aquarat/cat-feeder/slicer/plates/README.md

# UNSLICED cat-feeder prototype projects

Open each .3mf as a project in Bambu Studio.
A1 mini / 0.4 mm / 0.20 mm / Generic PETG / Textured PEI.
No G-code: slice and inspect before printing. Settings are editable.
See ../../kb/printing.md for settings, quantities, limitations and validation.
plate-report.json records source hashes, measured mesh dimensions and placement.
Regenerate after STL exports change: python3 slicer/make_plates.py
