aquarat/cat-feeder/electronics/d34/d34-ctrl/pcbtrain/README.txt

Cat feeder D34 controller - d34-ctrl
Bare board only (no assembly). 2 layers, FR-4 1.6 mm, 1 oz (35 um) copper, green mask both sides,
white legend both sides, any lead-free finish (immersion silver acceptable; boards are hand-soldered).
Board outline 81 x 47 mm, 1 mm corner radii, on layer Edge_Cuts (0.1 mm line; use the centreline).
Gerber RS-274X (no X2 attributes), viewed from the top, not mirrored. Excellon drill, metric, absolute
origin: *-PTH.drl plated holes, *-NPTH.drl non-plated holes (one polarising peg hole per fan header).
Minimum track 0.30 mm (power 0.6-2.5 mm), minimum clearance 0.20 mm, vias 0.8/0.4 mm, smallest
finished hole 0.4 mm (vias), no slots, no cut-outs, no V-score.
Files:
  d34-ctrl-B_Cu.gbl
  d34-ctrl-B_Mask.gbs
  d34-ctrl-B_Silkscreen.gbo
  d34-ctrl-Edge_Cuts.gm1
  d34-ctrl-F_Cu.gtl
  d34-ctrl-F_Mask.gts
  d34-ctrl-F_Silkscreen.gto
  d34-ctrl-NPTH.drl
  d34-ctrl-PTH.drl
  d34-ctrl-job.gbrjob
