aquarat/cat-feeder/kb/decisions.md

# Decisions

Updated 2026-10-25. **Confirmed** means user direction, not engineering validation. **Exploring** means a candidate requiring comparison or trials. **Provisional** means a current implementation choice without final approval/qualification. Latest user direction overrides the initial brief.

| ID | Status | Decision and rationale | Implementation / remaining work |
|---|---|---|---|
| D01 | Confirmed | Prefer simplicity, low maintenance and easy cleaning; easier sourcing outweighs maximum thermal efficiency. | Judge component count, disassembly and cleaning effort alongside cooling performance. |
| D02 | Confirmed | Twelve rounded pizza-slice compartments, not individual cups. | Four current sectors each contain three continuous bowls; establish useful fill/headroom and cat access physically. Cup selection and cup-to-plate assumptions in the brief are superseded. |
| D03 | Confirmed | Thin removable food tray; broad lift-off keyed coupling to the stepper explicitly accepted by the user. | Current hub/socket and axial dog drive implement the concept. Review follow-up adds a drive shoulder, blind shaft-tip datum and two finger tabs; motor retention and loaded lift/torque still need physical resolution. This is direct drive, not reduction gearing. |
| D04 | Confirmed | Hinged clip lid reusing the rowing IMU mechanics. | Current geometry imports hinge knuckles, catches and clips. Full feeder lid sweep, support/stop, pin assembly and strength need feeder-specific validation. The brief's simple lift-off lid is superseded. |
| D05 | Confirmed mechanical requirement; electrical exception D22 | No screws or bolts for mechanical construction/daily servicing. | Keys should carry working loads, clips retain them. Thermal retention and motor/enclosure attachment still need actual designs; electrical screw terminals are now explicitly permitted. |
| D06 | Confirmed | No foam. Use a printed low-density air-gap insulation deck, potentially housing Peltiers. | Current 18 mm deck is solid CAD with proposed slicer shells/infill, not explicitly modelled sealed air cells. Foam inserts in the brief are superseded. |
| D07 | Confirmed | Chamfer exposed edges and round food-contact transitions for cleaning. | Current bowls have 5 mm plan corner rounding, 3 mm floor transitions and 0.5 mm mouth treatment. Cut bores, flange holes, vents and purchased edges still need an edge audit. |
| D08 | Exploring, cap interface superseded by D19 | Distributed Peltiers instead of a custom aluminium disc. | Current CAD: twelve sites, radius 105 mm, provisional 40 × 40 × 4 mm TEC envelopes directly contacting the PETG tray. The previous 41.28 mm square cold caps are removed. Module/sink variants, contact retention, wiring and useful cooling remain under investigation. |
| D09 | Provisional | Four removable three-compartment tray sectors on one central hub preserve small-printer compatibility and keep joints outside bowls. | 0.6 mm quadrant gaps; dry inner flanges and one lug per sector. Joint locations avoid normal food containment, but are not sealed against spills. No outer sector tie or captive lift retention yet. |
| D10 | Provisional, revised | Current size: body Ø316 mm with 12 mm walls, tray Ø280 mm, 1.2 mm bowl floor, 16 mm cavity depth; 0.3 mm per-side fit allowance. | Body grew outward from Ø300 mm to preserve the tray and top-loading bore while adding insulation thickness. Stiffness, flatness and fits require physical checks. |
| D11 | Retained starting requirements | One stationary feeding opening, 30° indexing, local control and physical position feedback remain useful requirements from the brief where not superseded. | No implemented feeder sensing/control is established by this mechanical model. A keyed hub alone cannot confirm individual moves or sector order. |
| D12 | Confirmed, implementation superseded | The top enclosure must retain substantial air in honeycomb insulation. | Owner clarified that honeycomb belongs in Bambu `.3mf` print settings, not explicit CAD. Modelled cells have been removed; lid, walls and insulation coupon are solid envelopes for sparse infill and closed skins. |
| D14 | Confirmed | One lid clip is sufficient. | One reused clip at front-right (315°), leaving the feeding approach unobstructed. Its angle is parameterised. |
| D15 | Confirmed, vent layout revised under D20 | Close the underside, using long rectangular vent slits; use many vertical slit vents on the cylindrical wall. | 3 mm base with 34 long 50 × 3.5 mm intake slots; 120 side slits, 3 × 22 mm at Z58–80, with eased corners. This replaces the lower 60-slot exhaust; installed airflow still needs testing. |
| D16 | Confirmed | Slope down around the feeding opening to reduce whisker contact; dome the rest of the lid. Thicken the shell for insulation. | Smooth dome/feeding-basin height field. Nominal 1.6 mm lip plus 1.2 mm tray running gap = 2.8 mm above tray rim; dome rises 12 mm above the 9.2 mm peripheral thickness. Walls are 12 mm. |
| D17 | Confirmed | All internals supported from the lower enclosure, in bounded bays, dropping in through the lid seam. | Floor-rooted cartridge/fan supports, board pockets, wire channels and motor posts; removable bridge installs after fan. Constant 292 mm bore admits the deck from above. See drop-in layout for staged order. |
| D18 | Confirmed sourcing permission; cap use superseded by D19 | Off-the-shelf cold plates are acceptable in principle; custom metal fabrication is the sourcing problem. | Permission does not require them: the later direct-contact prototype removes the small caps from the active BOM. Historical catalogue evidence remains available. |
| D19 | Confirmed; alternative D35 under comparison | Prototype direct ceramic TEC-to-PETG contact without the small metal cold plates. | Owner accepts a practical sliding-contact trial; ceramic fracture from soft PETG has not been demonstrated. Remove caps from CAD and active procurement, retain earlier simulations as historical comparisons. Model footprint/contact sensitivity separately from wear, flatness and real indexing tests. |
| D20 | Confirmed direction; airflow details provisional | One bottom PC-style axial fan blows upward into the hot-side equipment bay, with wall exhausts. | Added a 118/114 mm square inlet skirt at Z28–30, enlarged bottom intake and raised exhausts under the Z81–84 deck ledge. Trial this before individual sink ducts. Fan free-air ratings are not installed airflow; see airflow study. |
| D21 | Investigation completed; proposal provisional | Determine purchasable TEC power/control modules, operating ratings and connection topology using delegated research. | Recommend CP60440 + JT-DPS5005 for one-site bench characterization, initial 1.2 A ceiling and 0–5 V sweep. Conditional 3S4P array uses CV/current limiting; 70 W TEC output corresponds to ~86 W source under stated assumptions. This is not a final measured operating point or a fitted regulator bay. See TEC control study. |
| D22 | Confirmed — latest | Electrical screw terminals are acceptable on the proposed PCB. | This supersedes the earlier inference that regulator/controller terminals must be removed. Mechanical enclosure construction and daily tray servicing remain tool-free. |
| D23 | Confirmed workflow | Iterate a PCB design against the chosen manufacturer's component catalogue, stock and assembly capabilities. | Generate editable design/assembly inputs, record substitutions and verification. Start with a controller/carrier study; distinguish assembler-mounted parts, purchased modules and later integration work. Subsequent D25 authorizes supplier project preparation after independent review; the owner submits the quote request. |
| D24 | Confirmed preference, conditional on packaging | Prefer a crescent-shaped controller board following the wall if it improves fit. | Evaluate a shallow crescent/curved outer edge against the compact rectangular baseline; preserve fan airflow, cartridge/support clearances and top loading. This is not a full circular distribution-ring requirement. The later D25 supplier-project workflow replaces the proposed official API application. |
| D25 | Confirmed — latest | Independent PCB review must precede creation of quotable supplier components/projects. | A separate agent reviews the completed circuit, layout, footprints, catalogue choices and assembly outputs. Resolve blocking findings before preparing the supplier project. Owner will submit the quote request; preparing the order is the authorized endpoint. Keep any supplier credentials out of source control and logs. |
| D26 | Provisional geometry, checked | Seat the actual crescent PCB at Z33, rotation 0°, with two removable floor-supported sink cradles. | Replaces the devkit pocket and 0°/−30° sink posts; four small ledge notches permit top-loading. Preserves full 40 mm sink allowances. Driver stack has 1.3 mm nominal clearance; wire terminals after seating the board. Integrated meshes/loading checks pass, but bought-part heights, warm strength, RF and airflow remain physical questions. See PCB packaging. |
| D27 | Confirmed workflow | Run operating electrical simulations and build PCB tests. | Add reproducible ngspice subcircuit studies, netlist/PCB regression and fault-injection tests, and a physical bring-up record. Distinguish solver/test success from failing modeled operating corners; label generic/behavioral models and unmeasured inputs. Firmware and physical hardware tests remain unrun until those exist. |
| D28 | Confirmed — latest | Integrate the USB-C PD board and stepper motor controller onto the main PCB. | Revision B replaces the SparkFun STUSB4500 breakout and plug-in A4988 carrier with assembler-fitted circuitry. Retain 20 V/5 A USB-C input intent, 1 A/phase motor ceiling and independent review before supplier-project changes. Revision A's checks remain evidence for that revision only. |
| D29 | Confirmed — latest | Integrate the voltage regulators too, making USB-C the controller's single power input. | Use efficient on-board logic and 12 V fan supplies; address the AP2112 thermal limitation. The external DPS5005 remains the TEC regulator, supplied from a negotiated/protected DC output. PD commissioning, fallback, power budget and new layout/thermal qualification belong to revision B. |
| D30 | Confirmed — latest | Add a version identifier, preferably a short Git commit hash. | Revision B silkscreen and build records carry the hardware revision and 12-character latest design-source Git commit hash, with a dirty marker for changed design sources. Before the first commit, use a deterministic source-hash identifier. Record the full source digest separately; generated-file hashes are not fed back into their own silkscreen. |
| D31 | Confirmed — latest | Factor in JLCPCB's best practices and design/assembly rules. | Recheck official fabrication and PCBA guidance for revision B's four-layer board, USB-C receptacle, thermal lands, power paths and crescent handling. Encode applicable numerical rules, distinguish project margins from factory minima, and retain supplier-specific process questions with the assembly handoff. |
| D32 | Confirmed — latest | Power the prototype from a 24 V mains power brick (owner: "reliable and affordable"). | Supersedes USB-C PD as the prototype input; the 100 W PD contract no longer caps the TEC budget. Rev B's PD front end is paused, not deleted. The [plenum heat balance](plenum-thermal.md) estimated ~108 W (135 W stress case). The [CAD-geometry sizing](plenum-sizing.md) (2026-10-26, simulated) gives a ~72–75 W brick budget at steady state for CAD rev 2 with 4 TARK-class modules, and ~100 W of TEC power at 2.5 A pull-down: keep ≥150 W for pull-down headroom, revisit after measured trials. Three CP60440s fit neither series nor parallel on a DPS5005 from 24 V; TEC topology is open. See [2026-10-25 review](review-2026-10-25.md). |
| D33 | Confirmed — latest | All electronics stay inside the case; only the mains brick is external. | The controller needs a dry, drip-shielded bay on the hot side, away from the cold chamber and any drain path. Review found the current PCB seat beneath two cold stacks with no drip protection. |
| D34 | Confirmed — latest | Add a separate hand-soldered prototype controller variant: bare JLCPCB PCB, through-hole parts and plug-in modules, ESP32 devkit in sockets, owner soldering. Overspecify for testing. | Avoids PCBA cost and the review's assembly blockers (rotations, edge distance, reflow, extended-part fees). Leave rev A/B untouched. Planned contents: socketed DevKitC-class module (exact board to be named), StepStick driver socket (TMC2209 preferred), keyed JLC/JST-XH connectors, fuses, firmware-independent bimetal sink cutouts, spare fan/sensor/TEC-zone channels. Still check JLC fabrication rules. **2026-10-26: designed as three 81 × 47 mm vertical cards (ctrl/pwr/tec) for the plenum bays.** **2026-10-27 (source hash `c24e0a5435e3`):** sourced (RS first, D38) and revised through three simulation rounds: VMOT on the 12 V buck; TRACO bucks; discrete NPN relay and MOSFET fan drivers with polyfuses (ULN2003 removed); 74HC123-timed defrost latch; K2 hold-up capacitor; 12 V undervoltage cut-off (TL431 + BC327) so K1 always opens before K2; Schottky-clamped THERMO_OK input; C9 gate cap and an inlet snubber for a reversed brick; 2 mm +12 V copper. ERC/DRC clean against JLCPCB and PCB Train rules, 164 tests pass. Final simulation run on this hash: 187 checks, 0 blocking failures, 18 advisories each with a recorded disposition, re-run independently with identical results ([D34 simulation](d34-simulation.md); simulation, not hardware). F1 is a wiring fuse; the brick's hiccup mode is the short-circuit protection. A firmware contract (waits, watchdog kick, re-arm from boot) is part of the design. Not fabricated, soldered or powered. See [D34 controller](d34-controller.md), [sourcing](d34-sourcing.md). Open: ESD on cabled leads (not fitted, no space), relay release times and drop-out voltages, DPS5005 terminal layout, T24A060 thermostat dimensions (no datasheet). |
| D35 | Exploring | Closed-loop forced cold-air plenum beneath the tray: small fan inside the insulated cold chamber, 2–4 TECs with finned cold-side sinks, tray clear of the TECs. | Proposed after review found lateral conduction limits direct contact (repo model: warmest food 12.3 °C open / 7.8 °C covered at an ideal 0 °C face), plus tray drag and ice-lock risk. Would supersede D19 if adopted; owner may compare both in the one-wedge trial. Requires ~10–15 mm plenum, rim support, defrost and a single drain. [Plenum study](plenum-thermal.md) (simulated): −5 °C air, h≈10 W/m²K gives covered wedges 2.0 °C mean / 2.6 °C warmest with no freezing; the open serving wedge reaches 6.7 °C at steady state (passes 5 °C after ~72 min). Direct contact needs a ≤−10 °C face (68 % of food frozen) to approach the target. Chamber load ~14 W; ~3 CP60440 at ~70 W. Coupon superseded by D36. [Plenum CAD study](plenum-cad.md): 4 sites, 15 mm channel, rim rollers, drains, diagonal electronics bays; 42 clearance checks pass. [CAD-geometry sizing](plenum-sizing.md) (2026-10-26, estimates): the cold side, not the hot sinks, is the bottleneck (one 5015 blower → R_cold ≈2.2 K/W). CP60440 is infeasible at 4 sites; 4 TARK-class modules are feasible with baffled hot sinks (0.59–0.66 K/W each). **CAD rev 2 (2026-10-26)** adds drop-in hot-side baffles, more intake and vent area, 70 × 60 mm cold sinks, a ≥4.5 CFM blower moved upstream, TARK thickness and sloped pockets. 46 checks pass. As modelled: ~44–47 W TEC, covered warmest 2.3–3.1 °C, and the open serving wedge passes 5 °C after 27–52 min (estimates/simulation). **Superseded by the as-sourced run (2026-10-27, [sizing](plenum-sizing.md)):** ADV127 TECs and Alutronic sinks, ADV127 1.80–1.96 A and brick budget 93–108 W with the warmest covered food held at 4 °C, coldest ~+1.7 °C; open serving wedge passes 5 °C after 18–45 min (simulation). See D39. |
| D36 | Confirmed — latest | Skip isolated test coupons (including the one-wedge plenum coupon); test the fully finished prototype. | Owner preference, 2026-10-25. The plenum study's measurement goals (achieved h, deck conductivity, TEC COP, hot-sink resistance) transfer to instrumenting the complete prototype. Existing coupon parts remain available but are no longer the planned route. Plenum CAD proceeds as a full-assembly study. |
| D37 | Confirmed — latest | Plenum meltwater goes to drop-in evaporation basins in the hot exhaust behind each sink, with standpipe overflow through the floor. | Owner, 2026-10-26: preferred over a drip tray as a design feature, and expects little water in practice. Estimate ~10 g/day passive evaporation against ~3–15 g/day nominal frost. Basins lift out with the deck removed via ledge notches. See [plenum CAD](plenum-cad.md) gap 4. Owner also judges rolling drag a non-issue (stepper torque, PETG, rollers): record it as a prototype observation. |
| D38 | Confirmed — latest | Before any ordering, complete the D34/plenum spec and verify it by simulation: physical fit including a modelled cable harness, and electrical behaviour. Buy through-hole components from RS Components UK where possible, and bare PCBs from a UK maker if cheaper than JLCPCB. | Owner, 2026-10-26: "as well tested as possible before committing to a parts list". Replace uncertain parts rather than carry them; build tools as needed. Supersedes JLCPCB as the assumed D34 fab (JLC remains a fallback). **2026-10-27: done for the current revision** (simulation and geometry only): [D34 simulation](d34-simulation.md), [harness](harness.md) and [plenum CAD](plenum-cad.md) checks, [as-sourced thermal sizing](plenum-sizing.md); build list in [BOM](../BOM.md). No UK PCB maker undercuts JLCPCB; PCB Train is the UK option at ~£340 inc VAT. Remaining questions are physical (see D39 and the BOM). |
| D39 | Proposed — awaiting owner | Plenum build interfaces fixed for ordering (2026-10-27): Alutronic PR 614 (hot, cut 70 mm) and PR 411 (cold, cut 46 mm) sinks; 24 V enters through a Kycon KPJX-PM-4S panel socket at 247° held by a printed keeper (no screws), with a snubber soldered across it; deck pass-throughs use inline connectors so the deck lifts out without unsoldering; baffle slots are 23 mm for the harness; cards and leads unplug in place, with an 8 mm grip criterion (9 plugs by finger, 11 with an extraction tool). | The stocked UK sinks (Fischer SK 100 75 SA, TED TDEX6015) fail in simulation and no UK-stocked profile fits the envelope; the Alutronic pair passes with thin margin (ADV127 1.80–1.96 A, brick budget 93–108 W at the 4 °C food target; estimates). The 23 mm slots add ~2–2.5 W of leakage (estimate). Single sources: Alutronic (DE, quote needed), Farnell for the brick and some leads. Hot-sink thermostat T180 has soldered tabs; W01, W02, W28, W29 are hand-crimped. See [harness](harness.md), [plenum CAD](plenum-cad.md), [sizing](plenum-sizing.md). |
| D40 | Confirmed — latest | Open-source the project through a follower public repository, <https://github.com/aquarat/cat-feeder>, receiving sanitised snapshots; everything copyleft with attribution (owner, 2026-11-01). | This repository stays the working source; `scripts/public_export.py` publishes `HEAD` with no private history. The rowing hinge/clip and edge helpers are copied into `cad/lib/`. Manufacturer datasheets follow the SPICE-model pattern (`references.json`, fetch script). No LAN details, agent session links, personal notes or JLCPCB website API documentation; parts lists are fine. Agent notes are rewritten for public use. Commits use the GitHub noreply address. Licences: CERN-OHL-S-2.0 hardware, GPL-3.0-or-later software, CC-BY-SA-4.0 documentation ([LICENSE.md](../LICENSE.md)). |

## Superseded assumptions and open dependencies

**D13 — evidence-driven next step:** do not freeze the square-cap layout or
order twelve thermal stacks from nominal TEC power alone. The reduced-order
model finds warmer remote food regions even with an ideal 0°C cap. Longer
stock-size footprints improve coverage, but none establishes a reliable
all-food target. Latest D19 replaces the stock-cap trial with direct TEC contact;
compare one real wedge under an insulated lid before scaling procurement. See
the thermal model's assumptions and comparisons.

- Do not revive twelve commercial cups, a custom 300 mm aluminium spreader disc, foam insulation or a purely lift-off lid as settled requirements.
- The brief's two-TEC wiring, two large heat sinks and thermal/power estimates belong to its old architecture. Reassess against the distributed candidate; twelve CAD positions do not establish that twelve modules fit its 100 W supply budget.
- The brief's 40 mL fill, cold-food target, ambient qualification condition and 180 mm printer envelope are starting targets, not achieved results. Actual useful capacity and full assembly printability remain to be demonstrated.
- Priorities for resolving D08: real stock component dimensions/availability, independently supported dry thermal cartridges, cleanable moisture separation, then measured contact/drag and thermal results. Consult [mechanical review](mechanical-review.md) and [thermal model](thermal-model.md).
