aquarat/cat-feeder/kb/review-2026-10-25.md

# General review — 2026-10-25

**Status: independent desk review by five read-only reviewers** (rev A circuit,
rev B circuit, JLCPCB DFM/DFA, system integration, mechanical/thermal). Items
marked **[re-checked]** were independently confirmed by the coordinating
session. All other items are reviewer findings or estimates. No physical part was
built or tested.

Related: [decisions D32–D35](decisions.md), [plenum thermal study](plenum-thermal.md),
[JLCPCB rule files](../electronics/dfm/README.md), [rev A](pcb-design.md),
[rev B](../electronics/revb/README.md), [direct-contact model](direct-contact-thermal.md).

## Verdict

**Do not quote either PCB.** Rev A has assembly and fit blockers. Rev B is
incomplete and its power path needs redesign. More fundamentally, the thermal and
mechanical concept findings change what the controller must do. The owner has since chosen
a 24 V brick (D32), all electronics in the case (D33), a hand-soldered
through-hole variant (D34) and is exploring a cold-air plenum (D35).

## Concept findings

| Severity | Finding | Evidence |
| --- | --- | --- |
| Blocker | Direct contact leaves food too warm even at an ideal 0 °C face: warmest food layer 12.3 °C open, 7.8 °C covered **[re-checked]**. Reviewer re-run with 22 °C room, 32 °C bay, lid U≈2.5, 0.1 mm gap: 11–15 °C warmest. Target 2–4 °C. Cause: lateral conduction, ~47 % of each wedge over a cold face. | [direct-contact-thermal.md](direct-contact-thermal.md) table line 77 (simulated) |
| Blocker | 12 × CP60440 on 40 mm sinks may give near-zero net cooling at 20–25 °C ambient: ~0.44 W/K back-conduction each, sinks 2–3.5 K/W in shared air. | Estimate from [tec-control.md](tec-control.md) data |
| Blocker | Tray drag est. 0.16–0.40 N·m against the 17HS08-1004S's 0.16 N·m *holding* torque **[motor spec re-checked]**. Ice at the contact would lock the tray. | Estimate; [BOM](../BOM.md) |
| Major | BOM motor is 21.5 mm body / 20 mm shaft; CAD assumes 28 / 18 mm, leaving ~0.8 mm coupling engagement. | Arithmetic on CAD parameters |
| Major | No set TEC face height or lateral retention; ±0.2–0.4 mm stack variation ≈ 1.4 °C per 0.2 mm. | Estimate + repo model |
| Major | Unmodelled heat leaks ~9–25 W (sink-in-deck edges, aligned deck/tray seams at 4 positions, lid) versus 2.75 W quoted. | Estimate |
| Major | PCB sits under two cold stacks; no drip surface or drain. | CAD inspection |
| Minor | Textured PEI on contact faces; FDM cleanability; shell/lid only fit H2-class beds; `check_mesh.py` records the CAD hash at check time, not export time. | — |

Verified good: re-exported sector, hub, drive, deck_quarter and motor_bridge
STLs are bit-identical to `build/stl`.

## Rev A (prepared JLCPCB project)

| Severity | Finding | Fix |
| --- | --- | --- |
| Blocker | A4988 sockets J14/J15 are 15.24 mm apart; the Pololu carrier rows are 12.7 mm apart (KiCad `Pololu_Breakout-16_15.2x20.3mm`) **[re-checked]**. 15.24 mm is the carrier width. `electronics/tests/test_electrical.py:44` asserts the wrong value. | J14 x=61.54, reroute, test 12.70 |
| Blocker | CPL rotations are native KiCad 0° **[re-checked]**. JLC library needs U1 270° (+~3.7 mm origin), U2/U3/U4 270°, Q1 180°. | Per-LCSC rotation table, JLC placement confirmation |
| Major | C10 footprint P5.00 mm; Panasonic EEUFR1H101B (C713402) is 3.5 mm pitch **[footprint re-checked]**. | Correct footprint |
| Major | J2 unkeyed, 12 V adjacent to 5 V; AP2112 abs max 6.5 V. | Keyed connector, reverse/TVS protection |
| Major | VMOT lacks TVS/reverse/fuse; own simulation shows 43.3 V against A4988 35 V. | TVS, reverse FET/Schottky, fuse |
| Major | Parts within 2.5 mm of edge (U1 0.2 mm); no fiducials/tooling holes. | Rails or JLC confirmation |
| Major | Economic PCBA reflow 255 ± 5 °C against ESP32-WROOM-32E 250 °C peak. | Ask JLC / Standard PCBA |
| Minor | Silkscreen 0.8/0.12 mm (JLC 1.0/0.15); AP2112 ~0.21 A at 50 °C; no LEDs, buttons or isolation links; no ESD on cabled GPIO; J11 3V3 back-feed. | — |

Verified good: ERC/DRC clean; ESP32 pin use, strapping and EN RC; ADC1 for
bus sense; buffers; 17/17 parts in stock; copper-to-edge 0.298 mm.

## Rev B (in development)

| Severity | Finding |
| --- | --- |
| Blocker | Discrete PD power-path gate network: ~80 ms linear turn-off (~2.5 J, far outside SOA) and Cgs-coupled self turn-on (31 A simulated peak from a fixed 20 V source). Generic FET model, ±30 %. Replace with an eFuse/hot-swap controller. |
| Blocker | `compose.py` crashes; `PD_20V` never joined to `SYS_20V`, `HOST_SDA/SCL` never joined to I²C **[re-checked]**; PD footprint library not found or hashed. |
| Blocker | No firmware-independent TEC cutoff; the DPS5005 is fed straight from the bus. |
| Major | OVP/UVP 21/18 V too tight (use 22/16 V); worst-case budget ~79.7 W against 85.8 W needed; no current monitor; bulk capacitance above the 150 µF limit before the DPS; factory NVM powers loads before programming. |
| Major | Missing I/O: lid, leak, LED, button; silent failure on a weak charger. |

Verified good: A4988 VREF/sense/charge pump; buck dividers, inductors and
ratings; STUSB4500 pinout and footprint. D32 makes the PD findings moot for
the prototype.

## JLCPCB rules

The official pages saved in `electronics/revb/dfm/evidence/` (re-fetch with
`electronics/revb/dfm/retrieve_sources.py`) match the live
pages on 2026-10-25, but they were stored as text, not encoded as checks.
KiCad rule files now live in [electronics/dfm](../electronics/dfm/README.md).
Still manual: 2.5 mm part-to-edge, fiducials and tooling holes, 4-layer inner
hole-to-copper 0.3 mm, and CPL rotation against JLC library footprints.

## Recommended sequence

1. Friction pull test: sector on deck quarter, dry, wet, cold and with dried gravy.
2. One wedge on a CPU cooler at +2 °C under a lid section. Compare direct
   contact with the D35 plenum on the same rig.
3. The same rig with the real sink and fan; compare the CP60440 with a lower-leak TARK-class module.
4. Bench rig: devkit, StepStick, sensors, fan, DPS5005 and one TEC. Measure DPS
   inrush and power-on state, input current and Wi-Fi inside the shell.
5. Then design the D34 through-hole board against the measured requirements.
