aquarat/cat-feeder/cad/generated/harness_cutlist.md

<!-- GENERATED by scripts/harness.py from cad/harness.json. Do not edit. -->
| Lead | From | To | Cond. | Wire | Bundle Ø | Bend R | Route | Slack | Cut | Pre-crimped source | Length check | Service |
|---|---|---|---|---|---|---|---|---|---|---|---|---|
| W01 ctrl-pwr link | ctrl J1 JST XHP-11 | pwr J9 JST XHP-11 | 11 | 26 AWG pvc_thin red/red/black/black/orange/white/grey/violet/yellow/blue/green | 4.1 | 3.8 | 261 | 50 | **335** | [hand-crimped] loose JST SXH-001T-P0.6 contacts, hand-crimped (Engineer PA-09) | made to length (no pre-crimped lead) | unplug both ends in place |
| W02 ctrl-tec link | ctrl J2 JST XHP-12 | tec J9 JST XHP-12 | 12 | 26 AWG pvc_thin black x4/white/grey/violet/blue/green/yellow/brown/orange | 4.21 | 3.8 | 240 | 49 | **310** | [hand-crimped] loose JST SXH-001T-P0.6 contacts, hand-crimped (Engineer PA-09): the 300 mm pre-crimped lead is 10 mm short after the PR 614 change | made to length (no pre-crimped lead) | unplug both ends in place |
| W03 12 V pwr to tec | pwr J3 JST VHR-3N | tec J1 JST VHR-3N | 3 | 20 AWG silicone red/black/red | 4.74 | 6.0 | 217 | 53 | **290** | [pre-crimped] JST 01SVHSVH-20L-300 (300 mm, contact both ends) | OK: 290 of 300 mm | unplug both ends in place |
| W04 DPS input | pwr J2 Phoenix MSTB 2,5/2-ST-5,08 | DPS5005 IN+/IN- screw terminals (ferrules) | 2 | 18 AWG silicone red/black | 5.5 | 7.5 | 191 | 60 | **275** | [made to length (soldered/screw)] Phoenix MSTB 2,5/2-ST-5,08 screw plug + 18 AWG silicone (no crimp) | made to length (no pre-crimped lead) | unplug at pwr; unscrew at DPS (electrical terminals, D22) |
| W05 DPS output to relays | DPS5005 OUT+/OUT- screw terminals | tec J2 Mini-Fit 6 (pins 1 and 4 only) | 2 | 18 AWG pvc red/black | 5.06 | 9.2 | 208 | 60 | **290** | [pre-crimped] Molex 215341-1115 (450 mm, 18 AWG, one end crimped); fallback 225 mm + soldered extension | OK: 290 of 450 mm | unplug at tec; unscrew at DPS |
| W06 TEC feed to JT1 | tec J3 Molex 39-01-2040 Mini-Fit 4 | JT1: Mini-Fit 2-way receptacles (39-01-2020); pins 3-4 continue as W07 | 4 | 18 AWG pvc red/black/orange/blue | 6.11 | 9.2 | 62 | 25 | **100** | [pre-crimped] Molex 215341-1113 (225 mm, 18 AWG, one end crimped) | OK: 100 of 225 mm | unplug at tec and JT1 |
| W07 TEC string 2 JT1-JT2 | JT1 (pass-through of tec J3 pins 3-4) | JT2: Mini-Fit 2-way receptacles (continuation of tec J3 pins 3-4) | 2 | 18 AWG pvc orange/blue | 5.06 | 9.2 | 99 | 3 | **105** | [pre-crimped] Molex 215341-1113 (225 mm, 18 AWG, one end crimped) | OK: 195 of 225 mm | unplug at JT2 |
| W08 TEC270 pigtail | TEC270 ADV-127 leads (350 mm) | Mini-Fit 2-way plug (39-01-3023), pin contacts from 226197-3114 | 2 | 20 AWG pvc red/black | 4.18 | 7.6 | 74 | 2 | **90** | [device lead + crimp] device leads 350 mm + pin contact from Molex 226197-3114 (cut in half) | OK: 90 of 340 mm | unplug at JT1; leads lie in the deck groove |
| W09 TEC0 pigtail | TEC0 ADV-127 leads (350 mm) | Mini-Fit 2-way plug (39-01-3023), pin contacts from 226197-3114 | 2 | 20 AWG pvc red/black | 4.18 | 7.6 | 84 | 3 | **100** | [device lead + crimp] device leads 350 mm + pin contact from Molex 226197-3114 (cut in half) | OK: 100 of 340 mm | unplug at JT1 |
| W10 TEC90 pigtail | TEC90 ADV-127 leads (350 mm) | Mini-Fit 2-way plug (39-01-3023), pin contacts from 226197-3114 | 2 | 20 AWG pvc red/black | 4.18 | 7.6 | 84 | 3 | **100** | [device lead + crimp] device leads 350 mm + pin contact from Molex 226197-3114 (cut in half) | OK: 100 of 340 mm | unplug at JT2 |
| W11 TEC180 pigtail | TEC180 ADV-127 leads (350 mm) | Mini-Fit 2-way plug (39-01-3023), pin contacts from 226197-3114 | 2 | 20 AWG pvc red/black | 4.18 | 7.6 | 74 | 2 | **90** | [device lead + crimp] device leads 350 mm + pin contact from Molex 226197-3114 (cut in half) | OK: 90 of 340 mm | unplug at JT2 |
| W12 DPS UART | DPS5005 comm header (type UNVERIFIED) | ctrl J11 JST XHP-4 | 3 | 26 AWG pvc_thin black/yellow/green | 2.25 | 9.0 | 201 | 57 | **280** | [cut] JST 01SXHSXH-26L300, cut near one end (~290 mm usable) | OK: 280 of 290 mm | unplug both ends |
| W13 stepper | 17HS08 motor connector (JST PH-6 class, cable assembly) | pwr J8 JST VHR-4N | 4 | 26 AWG pvc black/green/red/blue | 3.45 | 5.2 | 120 | 47 | **190** | [cut] JST 01SVHSVH-20L-300, cut near one end (~290 mm usable) | OK: 190 of 290 mm | unplug at the motor to lift it out; unplug at pwr |
| W14 hot-side fan | NF-A12x25 lead (+ NA-EC1 extension if short) | tec J5 4-pin fan header (switched DC, no PWM) | 4 | 24 AWG pvc black/yellow/green/blue | 3.72 | 5.6 | 52 | 23 | **100** | [device lead] NF-A12x25 own lead (~200 mm; NA-SEC extension in the box) | OK: 100 of 200 mm | unplug at tec; fan lifts out with its lead |
| W15 blower deck pigtail | RS PRO ODB5115-12HB blower wire leads | JST SM 3-way plug (SMP-03V-BC) | 3 | 26 AWG pvc red/black/yellow | 3.08 | 5.2 | 45 | 1 | **70** | [made to length (soldered/screw)] blower wire leads (length UNVERIFIED) + Adafruit 1663 SM pigtail | made to length (no pre-crimped lead) | stays with the deck quarter; bore sealed with silicone |
| W16 blower harness | Adafruit 1663 JST SM 3-way receptacle lead (163 mm, 22 AWG) | tec J6 fan header (switched DC, no PWM) | 3 | 26 AWG pvc_thin red/black/yellow | 2.25 | 9.0 | 182 | 107 | **310** | [spliced] Noctua NA-EC1 300 mm extension (female into tec J6) + one solder junction to the Adafruit 1663 SM pigtail (163 mm) | OK: 310 of 463 mm | unplug at tec; loop lets the deck quarter lift |
| W17 chamber probe tail | DFRobot SEN0511 SMD probe cable (1 m, cut) | JST SM 3-way plug | 3 | 28 AWG sheathed pvc red/black/yellow | 3.5 | 14.0 | 27 | 1 | **50** | [device lead] probe cable 1000 mm + Adafruit 1663 SM pigtail | OK: 50 of 1000 mm | stays with the deck quarter; bore sealed with silicone |
| W18 chamber probe harness | JST SM 3-way receptacle | Y-splice YA (bus A), soldered + heat-shrink | 3 | 26 AWG pvc_thin black/yellow/red | 2.25 | 9.0 | 60 | 82 | **155** | [pre-crimped] Adafruit 1663 JST SM receptacle lead (163 mm) to the Y-splice | OK: 155 of 163 mm | unplug at pwr; loop lets the deck quarter lift |
| W19 near-serving probe tail | DFRobot SEN0511 SMD probe cable (1 m, cut) | JST SM 3-way plug | 3 | 28 AWG sheathed pvc red/black/yellow | 3.5 | 14.0 | 28 | 1 | **50** | [device lead] probe cable 1000 mm + Adafruit 1663 SM pigtail | OK: 50 of 1000 mm | stays with the deck quarter; bore sealed with silicone |
| W20 near-serving probe harness | JST SM 3-way receptacle | Y-splice YA (bus A), soldered + heat-shrink | 3 | 26 AWG pvc_thin black/yellow/red | 2.25 | 9.0 | 40 | 81 | **135** | [pre-crimped] Adafruit 1663 JST SM receptacle lead (163 mm) to the Y-splice | OK: 135 of 163 mm | unplug at pwr; loop lets the deck quarter lift |
| W21 hot-sink probe | DS18B20 TO-92 on the T90 clip (soldered to the leads, heat-shrunk) | Y-splice YB (bus B), soldered + heat-shrink | 3 | 26 AWG silicone red/black/yellow | 3.32 | 4.2 | 231 | 7 | **250** | [made to length (soldered/screw)] 26 AWG silicone to the TO-92, soldered both ends | made to length (no pre-crimped lead) | unplug at pwr; probe lifts out with the sink |
| W22 room-air probe | DFRobot SEN0511 SMD probe through the floor boss | Y-splice YB (bus B), soldered + heat-shrink | 3 | 28 AWG sheathed pvc red/black/yellow | 3.0 | 12.0 | 58 | 2 | **75** | [device lead] probe cable 1000 mm | OK: 75 of 1000 mm | unplug at pwr; probe lifts out of the boss |
| W23 thermostat loop: tec J4.1 to T270 | tec J4 JST VHR-2N pin 1 (+12 V) | RS PRO T24A060ASF2-15 T270 6.3 mm flag receptacle | 1 | 22 AWG silicone white | 1.7 | 5.1 | 54 | 25 | **100** | [cut] JST 01SVHSVH-20L-300, cut near one end (~290 mm usable) | OK: 100 of 290 mm | pull flag receptacles off; unplug J4 |
| W24 thermostat loop: T270 to T0 | RS PRO T24A060ASF2-15 T270 flag receptacle | RS PRO T24A060ASF2-15 T0 flag receptacle | 1 | 22 AWG silicone white | 1.7 | 5.1 | 217 | 7 | **245** | [made to length (soldered/screw)] 20 AWG silicone, TE 2-520129-2 flags crimped (ratchet crimper) or soldered both ends | made to length (no pre-crimped lead) | pull flag receptacles off |
| W25 thermostat loop: T0 to T90 | RS PRO T24A060ASF2-15 T0 flag receptacle | RS PRO T24A060ASF2-15 T90 flag receptacle | 1 | 22 AWG silicone white | 1.7 | 5.1 | 66 | 2 | **90** | [made to length (soldered/screw)] 20 AWG silicone, TE 2-520129-2 flags crimped (ratchet crimper) or soldered both ends | made to length (no pre-crimped lead) | pull flag receptacles off |
| W26 thermostat loop: T90 to T180 | RS PRO T24A060ASF2-15 T90 flag receptacle | RS PRO T24A060ASF2-15 T180 flag receptacle | 1 | 22 AWG silicone white | 1.7 | 5.1 | 236 | 7 | **265** | [made to length (soldered/screw)] 20 AWG silicone, TE 2-520129-2 flags crimped (ratchet crimper) or soldered both ends | made to length (no pre-crimped lead) | pull flag receptacles off |
| W27 thermostat loop: T180 to tec J4.2 | RS PRO T24A060ASF2-15 T180 flag receptacle | tec J4 JST VHR-2N pin 2 (return to K1) | 1 | 22 AWG silicone white | 1.7 | 5.1 | 209 | 29 | **260** | [cut] JST 01SVHSVH-20L-300, cut near one end (~290 mm usable) | OK: 260 of 290 mm | pull flag receptacle off; unplug J4 |
| W28 lid reed switch | reed switch leads (sealed in the rim slot) | ctrl J4 JST XHP-4 SENSE (LID pins, shared with W30) | 2 | 26 AWG pvc_thin white/black | 2.09 | 3.8 | 283 | 29 | **335** | [hand-crimped] loose JST SXH-001T-P0.6 contacts, hand-crimped (Engineer PA-09) | made to length (no pre-crimped lead) | unplug at ctrl; reed stays in the wall |
| W29 panel LED + button | panel pod (5 mm LED, 6x6 tact switch) | ctrl J6 JST XHP-5 | 5 | 26 AWG pvc_thin black/red/green/yellow/black | 2.82 | 3.8 | 251 | 29 | **300** | [hand-crimped] loose JST SXH-001T-P0.6 contacts, hand-crimped (Engineer PA-09) | made to length (no pre-crimped lead) | unplug at ctrl; pod snaps out of the wall pocket |
| W30 basin-full probe | two stainless pins in the basin 90 clip | ctrl J4 JST XHP-4 SENSE (LEAK pins, shared with W28) | 2 | 26 AWG pvc_thin white/black | 2.09 | 8.4 | 64 | 23 | **110** | [cut] JST 01SXHSXH-26L300, cut near one end (~290 mm usable) | OK: 110 of 290 mm | unhook the clip before lifting the basin; unplug at ctrl |
| W31 home hall sensor | TI DRV5033AJQLPG TO-92 on the bridge post | ctrl J3 JST XHP-3 | 3 | 26 AWG pvc_thin black/yellow/red | 2.25 | 3.8 | 120 | 25 | **165** | [cut] JST 01SXHSXH-26L300, cut near one end (~290 mm usable) | OK: 165 of 290 mm | unplug at ctrl; lifts out with the motor bridge |
| W32 24 V inlet pigtail | Kycon KPJX-PM-4S pins 1+4 (+24 V), 2+3 (0 V), soldered | pwr J1 Molex 39-01-2020 Mini-Fit 2 | 2 | 18 AWG pvc red/black | 5.06 | 9.2 | 75 | 26 | **125** | [pre-crimped] Molex 215341-1113 (225 mm, 18 AWG, one end crimped) | OK: 125 of 225 mm | unplug at pwr; the socket pulls inward out of its collar |
| W33 1-Wire bus A tail | Y-splice YA (chamber + near-serving probes) | pwr J4 JST XHP-3 (1-Wire A) | 3 | 26 AWG pvc_thin black/yellow/red | 2.25 | 9.0 | 97 | 24 | **135** | [cut] JST 01SXHSXH-26L300, cut near one end (~290 mm usable) | OK: 135 of 290 mm | unplug at pwr |
| W34 1-Wire bus B tail | Y-splice YB (hot-sink + room probes) | pwr J6 JST XHP-3 (1-Wire B) | 3 | 26 AWG pvc_thin black/yellow/red | 2.25 | 9.0 | 26 | 22 | **60** | [cut] JST 01SXHSXH-26L300, cut near one end (~290 mm usable) | OK: 60 of 290 mm | unplug at pwr |
