aquarat/cat-feeder/analysis/pcb-fit/ledge.png

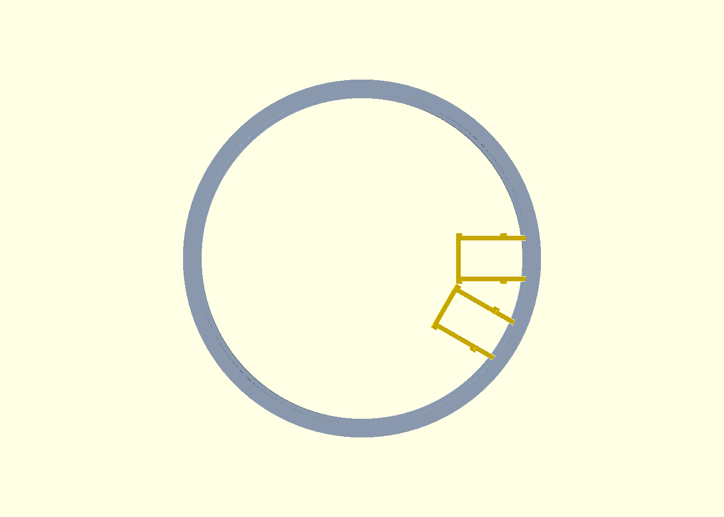
analysis/pcb-fit/ledge.png
