aquarat/cat-feeder/analysis/pcb-fit/oblique.png

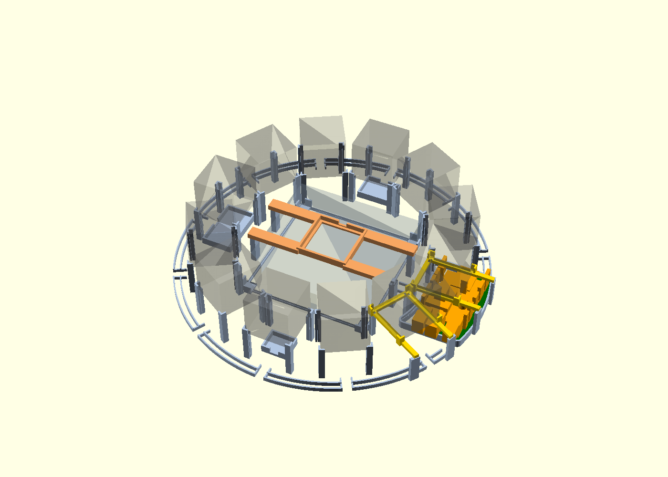
analysis/pcb-fit/oblique.png
