aquarat/cat-feeder/electronics/d34/d34-ctrl/views/render-bottom.png

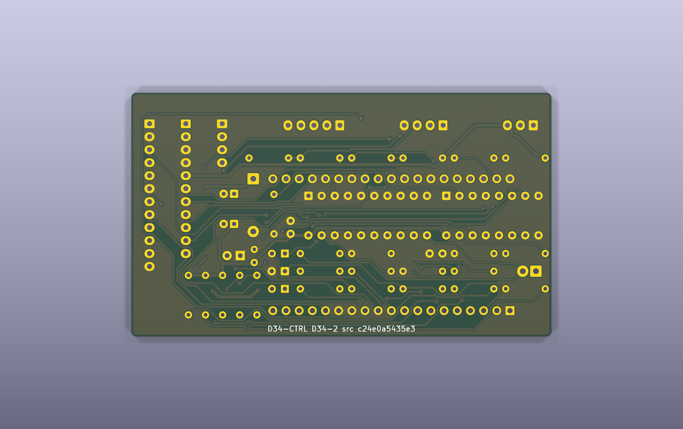
electronics/d34/d34-ctrl/views/render-bottom.png
