aquarat/cat-feeder/electronics/d34/d34-pwr/views/render-bottom.png

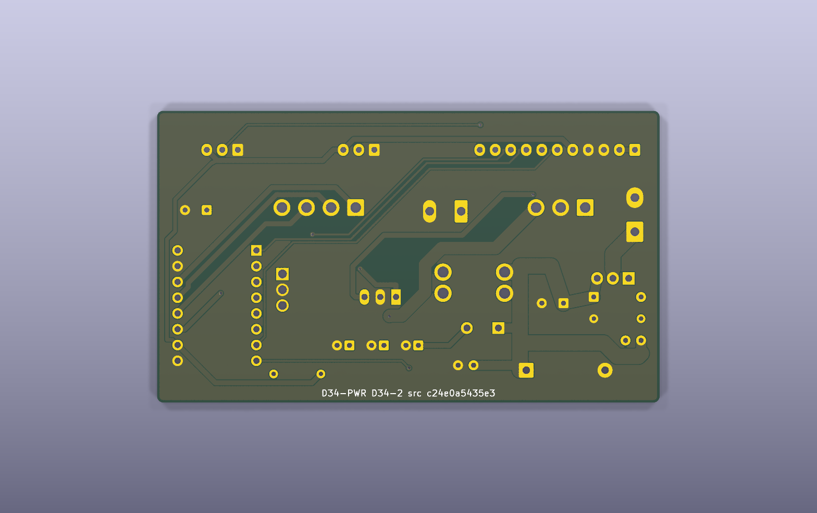
electronics/d34/d34-pwr/views/render-bottom.png
