aquarat/cat-feeder/electronics/d34/d34-tec/views/render-bottom.png

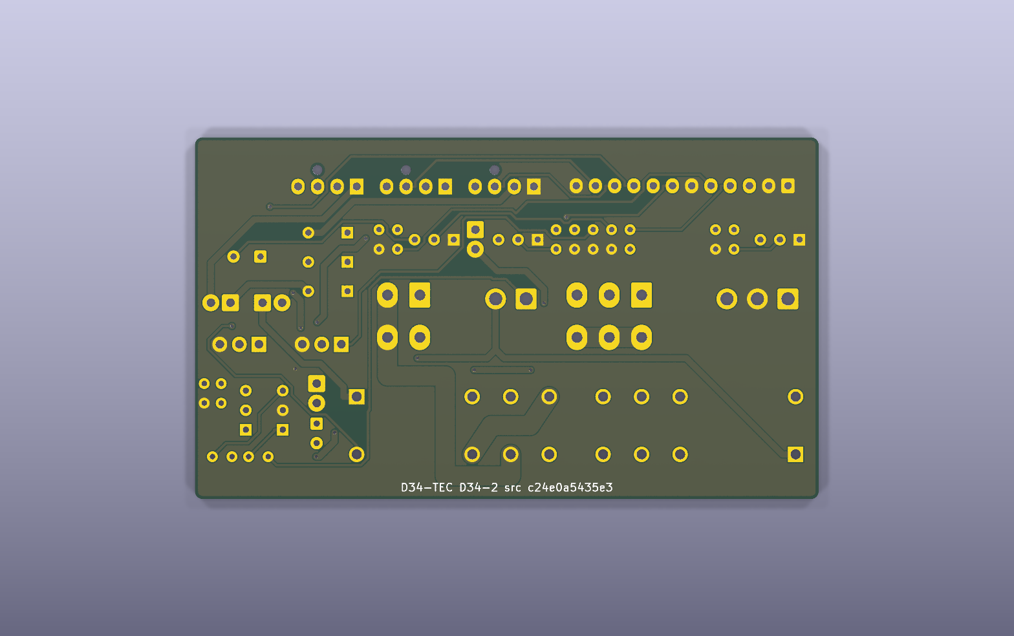
electronics/d34/d34-tec/views/render-bottom.png
