aquarat/cat-feeder/electronics/pcb/views/bottom.png

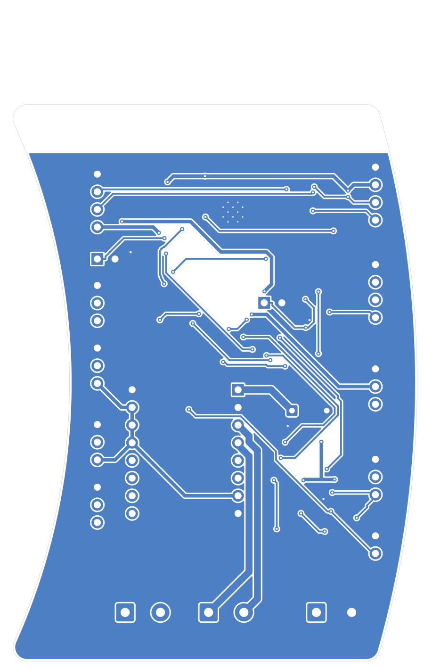
electronics/pcb/views/bottom.png
