aquarat/cat-feeder/electronics/pcb/views/packaging.png

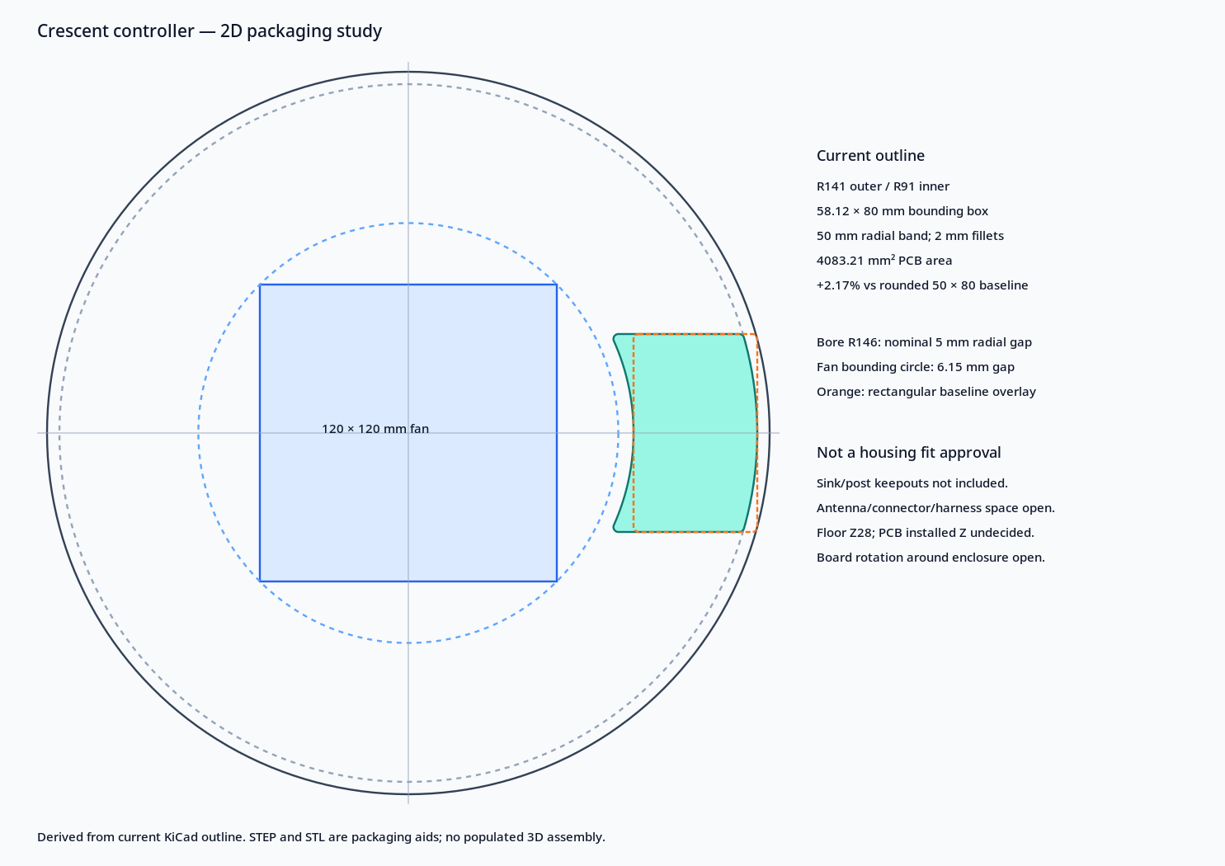
electronics/pcb/views/packaging.png
