aquarat/cat-feeder/electronics/pcb/views/schematic-detail.png

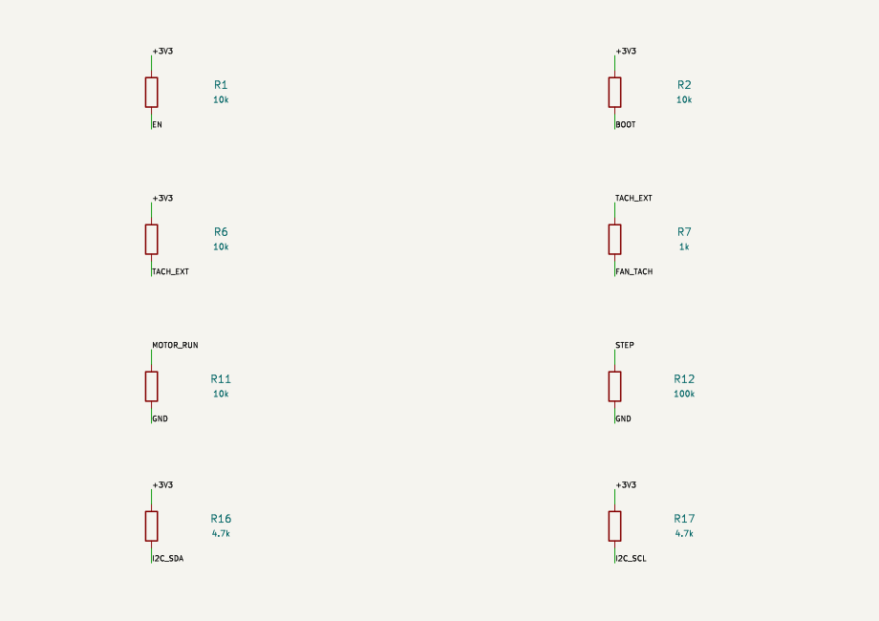
electronics/pcb/views/schematic-detail.png
