aquarat/cat-feeder/electronics/pcb/views/schematic.png

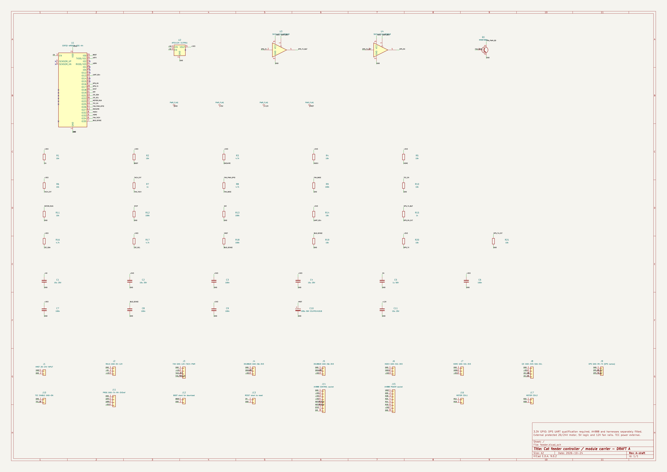
electronics/pcb/views/schematic.png
