aquarat/cat-feeder/electronics/pcb/views/top.png

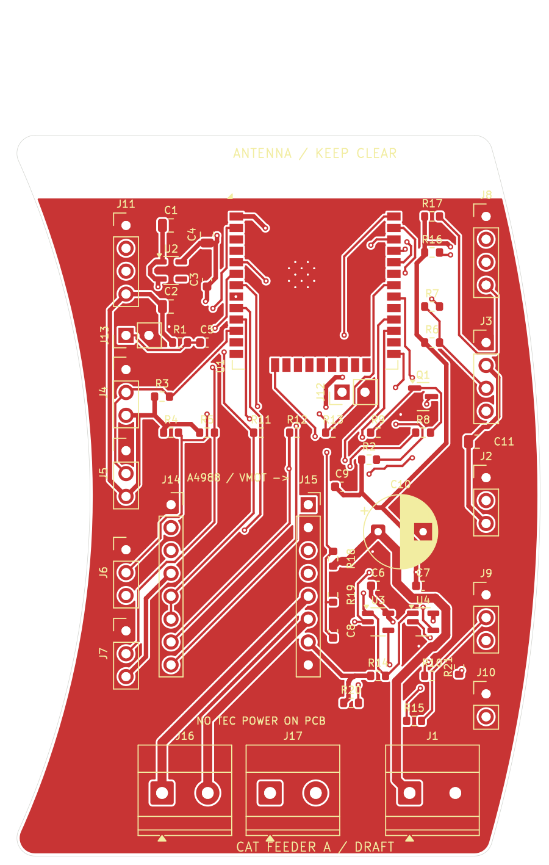
electronics/pcb/views/top.png
