aquarat/cat-feeder/electronics/revb/motor/symbol-view/A4988SETTR-T.png

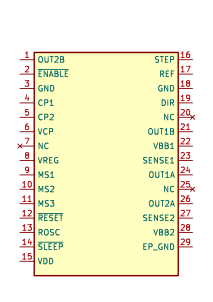
electronics/revb/motor/symbol-view/A4988SETTR-T.png
