aquarat/cat-feeder/electronics/revb/power/fan-placement.png

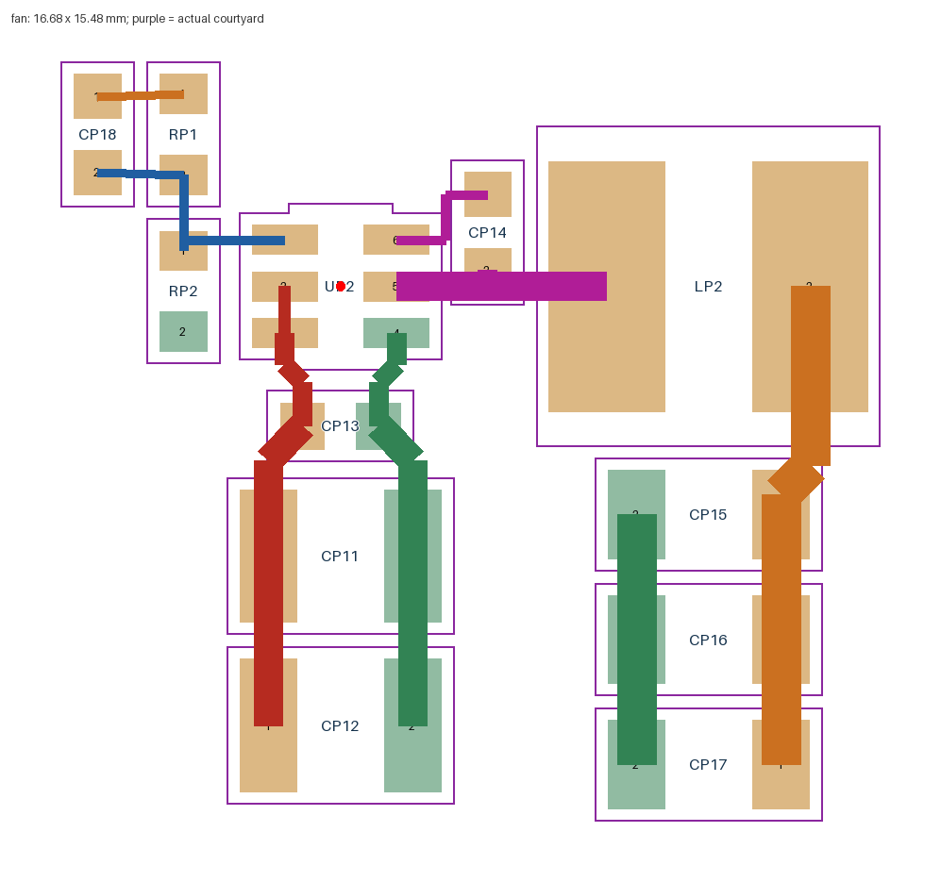
electronics/revb/power/fan-placement.png
