aquarat/cat-feeder/electronics/revb/power/logic-placement.png

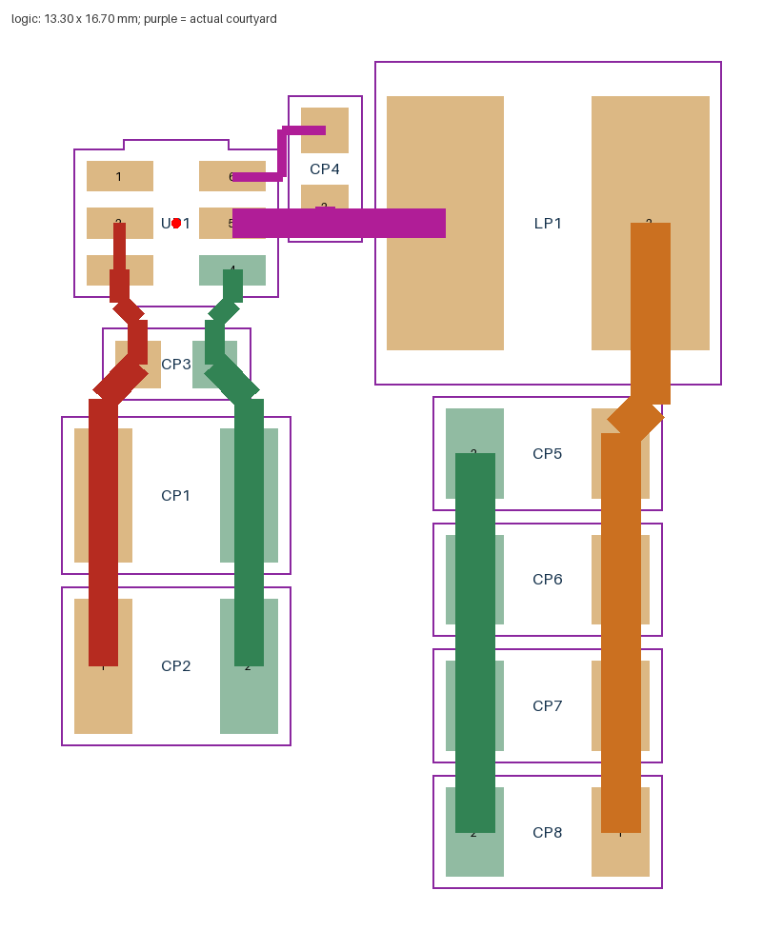
electronics/revb/power/logic-placement.png
