aquarat/cat-feeder/kb/d34-sourcing.md

# D34 controller: sourcing, verification and PCB fab choice

**Status (2026-10-26): every part sourced from public UK listings and checked against a datasheet or a
named retailer/distributor page. Nothing ordered, no basket used, nothing built or powered.**

Related: [D34 controller](d34-controller.md) (design, safety chain, open risks),
[decisions D32–D37](decisions.md), card files [electronics/d34/](../electronics/d34/README.md).

Labels: **[datasheet]** manufacturer document in `electronics/d34/datasheets/` (SHA-256 and source URL in
[`MANIFEST.json`](../electronics/d34/datasheets/MANIFEST.json); fetch the PDFs with `scripts/fetch_references.py`); **[distributor]** RS/Farnell listing data;
**[retailer]** module shop page; **[estimate]**; **[unverified]**.

## How the numbers were obtained

- **uk.rs-online.com, docs.rs-online.com, Farnell search, DigiKey, Mouser and Octopart refuse scripted
  access (HTTP 403 / bot pages).** RS stock numbers, UK GBP price breaks, sales packs and public stock
  figures were taken from the findchips.com (Supplyframe) distributor feed, which carries RS UK and
  Farnell UK rows. The raw rows used are frozen in
  [`sourcing/findchips-2026-10-26.json`](../electronics/d34/sourcing/findchips-2026-10-26.json).
  Specifications for a few RS-only lines came from RS's public export mirror (export.rsdelivers.com).
- Stock figures are a snapshot, not a reservation. **Re-check every line in a logged-in browser before
  ordering.**
- Prices are GBP **ex VAT** per piece at the break reached by the packs bought; delivery is not included.
  Two lines have no visible UK price and use RS's export-site EUR price × 0.87 (marked in the table).
- [`electronics/d34/sourcing.py`](../electronics/d34/sourcing.py) rebuilds the table from `design.py`,
  `catalog.py`, the snapshot and `sourcing/manual.json` →
  [`bom-sourced.csv`](../electronics/d34/sourcing/bom-sourced.csv) / `.json` / `.md`.

## Supplier plan and totals

**RS Components UK carries 58 of 66 card lines.** The others, and why:

| Line | Supplier | Why not RS |
|---|---|---|
| Keystone 3568 mini-blade PCB fuse holder | Farnell 2504685 | Not listed at RS. Littelfuse 01530008Z (RS 360-7317) is a different footprint. |
| 7.5 A MINI fuse Littelfuse 029707.5WXNV | Farnell 9943854 (pack 5) | RS sells it only in 50s (174-0711). |
| Molex Mini-Fit Jr pre-crimped leads 215341-1113 | Farnell 3559249 | Not at RS; they remove the need for a Mini-Fit crimp tool. |
| ESP32-DevKitC-32E | Rapid Electronics 09-1099 (£10.32 ex VAT, free UK delivery offered) | Not at RS, Farnell or CPC. DigiKey UK 1965-ESP32-DEVKITC-32E-ND is £7.47 [retailer]. |
| Vishay MBA0204 470 k (watchdog and latch-delay timing) | Farnell 4177865 (pack 10) | RS has no 470 k 0204 in small packs. |
| Infineon IRLZ44NPBF (fan low sides) | Farnell 8651418 | Not found at RS; logic-level TO-220 needed to survive a PTC-limited short. |
| Molex 215341-1115 450 mm Mini-Fit lead (W05) | Farnell 3559251 (0 stock on 2026-10-26) | Not at RS. |
| BIGTREETECH TMC2209 V1.3 | 3DJake UK (£6.30 inc VAT, 14 in stock; £8.90 delivery under £69.90) | Hobby module, not stocked by distributors. 123-3D £7.10 backordered; onetwo3D £4.99 out of stock [retailer]. |

| Supplier | 1 set (£ ex VAT) | 2 sets + spares (£ ex VAT) |
|---|---:|---:|
| RS | 216.64 | 331.06 |
| Farnell | 12.74 | 28.41 |
| Rapid Electronics | 10.32 | 30.96 |
| 3DJake UK | 5.25 | 15.75 |
| **All card parts** | **244.95** | **406.18** |

"2 sets + spares" = 2 × per-set quantity + 25 % (min 1); modules and relays +1; fuses +2; rounded up to
packs. Many lines are pack-bound (one RS pack covers both sets), so the second set is cheap. Excluded:
the DPS5005, TECs, fans, motor, 24 V brick, sensors and wire (main [BOM](../BOM.md)), and PCBs (below).

Biggest single lines: four RS PRO thermostats (£34), JST VH pre-crimped leads (two packs of 5), JST XH
pre-crimped leads (three packs of 10), the DevKit (£10.32), 2N3904 pack of 50 (£9.10, now 5 used per set).

## Sourced BOM (all three cards and off-board parts, one set)

Generated by `sourcing.py`; refs per line are in the CSV.

<!-- BEGIN bom-sourced.md (generated) -->
| Line | Mfr / MPN | Supplier, stock no | Pack | Per set | 2 sets + spares | £/pc (1 set) | £ 1 set | £ 2 sets | Public stock (date) |
|---|---|---|---:|---:|---:|---:|---:|---:|---|
| 1x19 2.54 mm socket strip, 8.51 mm (2 per ESP32-DevKitC-32E) | Samtec SSW-119-01-T-S | [RS 207-9240](https://uk.rs-online.com/web/p/2079240) | 1 | 2 (2 pk) | 5 (5 pk) | 2.000 | 4.00 | 10.00 | 246 (2026-10-26) |
| Schottky 20 V 1 A, DO-41 | onsemi 1N5817RLG | [RS 625-4972](https://uk.rs-online.com/web/p/6254972) | 5 | 6 (2 pk) | 14 (3 pk) | 0.464 | 4.64 | 6.96 | 3490 (2026-10-26) |
| 22 uF 50 V electrolytic, 5 x 11 mm | Rubycon 50YXF22M5X11 | [RS 224-4331](https://uk.rs-online.com/web/p/2244331) | 5 | 5 (1 pk) | 12 (3 pk) | 0.112 | 0.56 | 1.68 | 1365 (2026-10-26) |
| 3 mm green LED | Broadcom HLMP-1503 | [RS 180-8502](https://uk.rs-online.com/web/p/1808502) | 10 | 1 (1 pk) | 3 (1 pk) | 0.330 | 3.30 | 3.30 | 60 (2026-10-26) |
| 11-pin JST XH shrouded header | JST B11B-XH-A(LF)(SN) | [RS 820-1535](https://uk.rs-online.com/web/p/8201535) | 10 | 2 (1 pk) | 5 (1 pk) | 0.338 | 3.38 | 3.38 | 180 (2026-10-26) |
| 12-pin JST XH shrouded header | JST B12B-XH-A(LF)(SN) | [RS 820-1539](https://uk.rs-online.com/web/p/8201539) | 10 | 2 (1 pk) | 5 (1 pk) | 0.237 | 2.37 | 2.37 | 140 (2026-10-26) |
| 4-pin JST XH shrouded header | JST B4B-XH-A(LF)(SN) | [RS 820-1551](https://uk.rs-online.com/web/p/8201551) | 5 | 2 (1 pk) | 5 (1 pk) | 0.188 | 0.94 | 0.94 | 7080 (2026-10-26) |
| Dual retriggerable monostable, DIP-16 (TEC watchdog) | Toshiba TC74HC123AP(F) | [RS 539-9456](https://uk.rs-online.com/web/p/5399456) | 5 | 1 (1 pk) | 3 (1 pk) | 0.442 | 2.21 | 2.21 | 105 (2026-10-26) |
| Octal transparent latch, DIP-20 (defrost-relay interlock) | Texas Instruments SN74HC573AN | [RS 217-5667](https://uk.rs-online.com/web/p/2175667) | 1 | 1 (1 pk) | 3 (3 pk) | 1.020 | 1.02 | 3.06 | 284 (2026-10-26) |
| Resistor 470 k 1 % 0204 (74HC123 timing) | Vishay MBA02040C4703FRP00 | [Farnell 4177865](https://uk.farnell.com/vishay/mba02040c4703frp00/res-470k-1-0-4w-axial-leaded/dp/4177865) | 10 | 2 (1 pk) | 5 (1 pk) | 0.078 | 0.78 | 0.78 | 1919 (2026-10-26) |
| Resistor, metal film MF0204, 0.4 W, 1 %, axial 10k | Yageo MF0204FTE52-10K | [RS 199-7794](https://uk.rs-online.com/web/p/1997794) | 100 | 11 (1 pk) | 25 (1 pk) | 0.043 | 4.30 | 4.30 | 1600 (2026-10-26) |
| Resistor, metal film MF0204, 0.4 W, 1 %, axial 47k | Yageo MF0204FTE52-47K | [RS 199-7828](https://uk.rs-online.com/web/p/1997828) | 100 | 7 (1 pk) | 16 (1 pk) | 0.017 | 1.70 | 1.70 | 700 (2026-10-26) |
| 100 nF 50 V X7R radial MLCC | Murata RDER71H104K0P1H03B | [RS 190-2933](https://uk.rs-online.com/web/p/1902933) | 10 | 4 (1 pk) | 9 (1 pk) | 0.180 | 1.80 | 1.80 | 3160 (2026-10-26) |
| Resistor, metal film MF0204, 0.4 W, 1 %, axial 1k | Yageo MF0204FTE52-1K | [RS 199-7806](https://uk.rs-online.com/web/p/1997806) | 100 | 14 (1 pk) | 32 (1 pk) | 0.043 | 4.30 | 4.30 | 1400 (2026-10-26) |
| Resistor, metal film MF0204, 0.4 W, 1 %, axial 4.7k | Yageo MF0204FTE52-4K7 | [RS 199-7830](https://uk.rs-online.com/web/p/1997830) | 100 | 4 (1 pk) | 9 (1 pk) | 0.017 | 1.70 | 1.70 | 3900 (2026-10-26) |
| Schottky clamp, DO-35 vertical (IO36 negative clamp) | STMicroelectronics BAT42 | [RS 544-4758](https://uk.rs-online.com/web/p/5444758) | 5 | 1 (1 pk) | 3 (1 pk) | 0.136 | 0.68 | 0.68 | 760 (2026-10-26) |
| Resistor, metal film MF0204, 0.4 W, 1 %, axial 330 | Yageo MF0204FTE52-330R | [RS 199-7821](https://uk.rs-online.com/web/p/1997821) | 100 | 3 (1 pk) | 7 (1 pk) | 0.018 | 1.80 | 1.80 | 2400 (2026-10-26) |
| 1 uF 50 V X7R radial MLCC | Murata RDER71H105K2P1H03B | [RS 190-2943](https://uk.rs-online.com/web/p/1902943) | 10 | 2 (1 pk) | 5 (1 pk) | 0.269 | 2.69 | 2.69 | 1280 (2026-10-26) |
| 3-pin JST XH shrouded header | JST B3B-XH-A(LF)(SN) | [RS 820-1557](https://uk.rs-online.com/web/p/8201557) | 5 | 3 (1 pk) | 7 (2 pk) | 0.166 | 0.83 | 1.66 | 3340 (2026-10-26) |
| 5-pin JST XH shrouded header | JST B5B-XH-A(LF)(SN) | [RS 820-1560](https://uk.rs-online.com/web/p/8201560) | 5 | 1 (1 pk) | 3 (1 pk) | 0.238 | 1.19 | 1.19 | 3260 (2026-10-26) |
| 2-pin Mini-Fit Jr vertical header | Molex 39-28-1023 (5566-02A) | [RS 484-1883](https://uk.rs-online.com/web/p/4841883) | 5 | 1 (1 pk) | 3 (1 pk) | 0.672 | 3.36 | 3.36 | 2520 (2026-10-26) |
| P-MOSFET -55 V, TO-220 (reverse-polarity switch) | Infineon IRF4905PBF | [RS 540-9799](https://uk.rs-online.com/web/p/5409799) | 1 | 1 (1 pk) | 3 (3 pk) | 2.170 | 2.17 | 6.51 | 918 (2026-10-26) |
| Zener 15 V 0.5 W, DO-35 (P-FET gate clamp) | Nexperia BZX79-C15,133 | [RS 136-4852](https://uk.rs-online.com/web/p/1364852) | 100 | 2 (1 pk) | 5 (1 pk) | 0.049 | 4.90 | 4.90 | 1900 (2026-10-26) |
| 100 uF 50 V low-ESR electrolytic, 8 x 11.5 mm | Panasonic EEU-FR1H101 | [RS 708-3894](https://uk.rs-online.com/web/p/7083894) | 10 | 2 (1 pk) | 5 (1 pk) | 0.251 | 2.51 | 2.51 | 1700 (2026-10-26) |
| TVS 600 W unidirectional 25.6 V Vwm, DO-15 | STMicroelectronics P6KE30A | [RS 485-9323](https://uk.rs-online.com/web/p/4859323) | 10 | 1 (1 pk) | 3 (1 pk) | 0.255 | 2.55 | 2.55 | 270 (2026-10-26) |
| PCB clip holder for MINI blade fuse (not stocked by RS) | Keystone 3568 | [Farnell 2504685](https://uk.farnell.com/keystone/3568/fuse-holder-0-8-x-2-8mm-pcb-mount/dp/2504685) | 1 | 1 (1 pk) | 3 (3 pk) | 0.811 | 0.81 | 2.43 | 52829 (2026-10-26) |
| Resettable PTC 1.1 A hold, 72 V (aux 24 V branch) | Littelfuse RXEF110 | [RS 517-6685](https://uk.rs-online.com/web/p/5176685) | 10 | 1 (1 pk) | 3 (1 pk) | 0.421 | 4.21 | 4.21 | 3320 (2026-10-26) |
| 2-pole pluggable header; plug MSTB 2,5/2-ST-5,08 (1757019) | Phoenix Contact MSTBVA 2,5/2-G-5,08 (1755736) | [RS 189-6199](https://uk.rs-online.com/web/p/1896199) | 5 | 1 (1 pk) | 3 (1 pk) | 0.386 | 1.93 | 1.93 | 1395 (2026-10-26) |
| 12 V 2 A SIP-3 buck (fans, relays, StepStick VMOT) | TRACO Power TSR 2-24120N | [RS 608-891](https://uk.rs-online.com/web/p/608891) | 1 | 1 (1 pk) | 3 (3 pk) | 4.450 | 4.45 | 13.35 | 72 (2026-10-26) |
| 5 V 1 A SIP-3 buck (ESP32 DevKit) | TRACO Power TSR 1-2450 | [RS 666-4379](https://uk.rs-online.com/web/p/6664379) | 1 | 1 (1 pk) | 3 (3 pk) | 5.090 | 5.09 | 15.27 | 1478 (2026-10-26) |
| 3-pin JST VH header | JST B3P-VH(LF)(SN) | [RS 820-1150](https://uk.rs-online.com/web/p/8201150) | 5 | 2 (1 pk) | 5 (1 pk) | 0.178 | 0.89 | 0.89 | 10 (2026-10-26) |
| 1x8 2.54 mm socket strip, 8.51 mm (2 per StepStick) | Samtec SSW-108-01-T-S | [RS 180-0422](https://uk.rs-online.com/web/p/1800422) | 10 | 2 (1 pk) | 5 (1 pk) | 0.784 | 7.84 | 7.84 | 350 (2026-10-26) |
| 4-pin JST VH header | JST B4P-VH(LF)(SN) | [RS 820-1157](https://uk.rs-online.com/web/p/8201157) | 5 | 1 (1 pk) | 3 (1 pk) | 0.264 | 1.32 | 1.32 | 545 (2026-10-26) |
| DPDT relay 8 A, 12 V coil | Omron G2RL-2 DC12 | [RS 365-0585](https://uk.rs-online.com/web/p/3650585) | 1 | 2 (2 pk) | 5 (5 pk) | 4.000 | 8.00 | 20.00 | 125 (2026-10-26) |
| 6-pin Mini-Fit Jr vertical header | Molex 39-28-1063 (5566-06A) | [RS 484-1906](https://uk.rs-online.com/web/p/4841906) | 5 | 1 (1 pk) | 3 (1 pk) | 1.798 | 8.99 | 8.99 | 1170 (2026-10-26) |
| 4-pin Mini-Fit Jr vertical header | Molex 39-28-1043 (5566-04A) | [RS 484-1899](https://uk.rs-online.com/web/p/4841899) | 5 | 1 (1 pk) | 3 (1 pk) | 0.784 | 3.92 | 3.92 | 1080 (2026-10-26) |
| 2-pin JST VH header | JST B2P-VH(LF)(SN) | [RS 820-1147](https://uk.rs-online.com/web/p/8201147) | 5 | 1 (1 pk) | 3 (1 pk) | 0.142 | 0.71 | 0.71 | 225 (2026-10-26) |
| NPN 40 V 200 mA, TO-92 | onsemi 2N3904BU | [RS 843-1575](https://uk.rs-online.com/web/p/8431575) | 50 | 3 (1 pk) | 7 (1 pk) | 0.182 | 9.10 | 9.10 | 8950 (2026-10-26) |
| 220 uF 35 V low-ESR electrolytic, 8 x 11.5 mm (K2 hold-up) | Panasonic EEU-FR1V221 | [RS 766-0078](https://uk.rs-online.com/web/p/7660078) | 10 | 1 (1 pk) | 3 (1 pk) | 0.298 | 2.98 | 2.98 | 690 (2026-10-26) |
| Resettable PTC 0.5 A hold (per fan channel) | Littelfuse RXEF050 | [RS 517-6635](https://uk.rs-online.com/web/p/5176635) | 10 | 3 (1 pk) | 7 (1 pk) | 0.358 | 3.58 | 3.58 | 2510 (2026-10-26) |
| Logic-level N-MOSFET, TO-220 (fan low side; survives a PTC-limited short) | Infineon IRLZ44NPBF | [Farnell 8651418](https://uk.farnell.com/infineon/irlz44npbf/mosfet-n-ch-55v-47a-to-220ab/dp/8651418) | 1 | 2 (2 pk) | 5 (5 pk) | 1.370 | 2.74 | 6.85 | 40213 (2026-10-26) |
| 4-pin PC fan header | Molex 47053-1000 | [RS 144-8185](https://uk.rs-online.com/web/p/1448185) | 10 | 3 (1 pk) | 7 (1 pk) | 0.381 | 3.81 | 3.81 | 810 (2026-10-26) |
| Shunt reference 2.495 V, TO-92 (12 V undervoltage cut-off for K1) | onsemi TL431AILPG | [RS 774-3697](https://uk.rs-online.com/web/p/7743697) | 10 | 1 (1 pk) | 3 (1 pk) | 0.243 | 2.43 | 2.43 | 5260 (2026-10-26) |
| PNP 45 V 0.8 A, TO-92 (thermostat-loop supply switch) | onsemi BC32725BU | [RS 765-315](https://uk.rs-online.com/web/p/765315) | 100 | 1 (1 pk) | 3 (1 pk) | 0.037 | 3.70 | 3.70 | 4200 (2026-10-26) |
| ESP32-DevKitC-32E module (plugs into U1 sockets); not stocked by RS/Farnell/CPC | Espressif ESP32-DevKitC-32E | [Rapid Electronics 09-1099](https://www.rapidonline.com/search?query=09-1099) | 1 | 1 (1 pk) | 3 (3 pk) | 10.320 | 10.32 | 30.96 | 37, despatched same day (retailer page) (2026-10-26) |
| JST XH housing 3-way (home sensor + two 1-Wire bus leads) | JST XHP-3 | [RS 820-1614](https://uk.rs-online.com/web/p/8201614) | 5 | 3 (1 pk) | 7 (2 pk) | 0.092 | 0.46 | 0.92 | 20525 (2026-10-26) |
| JST XH crimp contact SXH-001T-P0.6, AWG 28-22, for the three XH leads longer than any stocked pre-crimped lead: W01 ctrl-pwr link 335 mm (22), W28 lid reed 325 mm (2), W29 panel 300 mm (5); hand crimper Engineer PA-09 | JST SXH-001T-P0.6 | [RS 123-5947](https://uk.rs-online.com/web/p/1235947) | 250 | 29 (1 pk) | 66 (1 pk) | 0.026 | 6.50 | 6.50 | 16250 (2026-10-26) |
| JST XH housing 4-way (DPS5005 UART lead; lid reed + basin probe SENSE lead) | JST XHP-4 | [RS 820-1618](https://uk.rs-online.com/web/p/8201618) | 5 | 2 (1 pk) | 5 (1 pk) | 0.092 | 0.46 | 0.46 | 39500 (2026-10-26) |
| JST XH housing 5-way (panel LED/button lead) | JST XHP-5 | [RS 820-1627](https://uk.rs-online.com/web/p/8201627) | 5 | 1 (1 pk) | 3 (1 pk) | 0.116 | 0.58 | 0.58 | 1735 (2026-10-26) |
| JST XH housing 11-way (ctrl-pwr link, both ends) | JST XHP-11 | [RS 820-1523](https://uk.rs-online.com/web/p/8201523) | 10 | 2 (1 pk) | 5 (1 pk) | 0.178 | 1.78 | 1.78 | 390 (2026-10-26) |
| JST XH housing 12-way (ctrl-tec link, both ends) | JST XHP-12 | [RS 820-1532](https://uk.rs-online.com/web/p/8201532) | 10 | 2 (1 pk) | 5 (1 pk) | 0.188 | 1.88 | 1.88 | 710 (2026-10-26) |
| JST XH pre-crimped lead, 300 mm 26 AWG, SXH contact both ends. W02 ctrl-tec link (12, both ends) and the single-ended leads W12, W30, W31, W33, W34 (14: each lead cut near ONE end, ~290 mm usable) | JST 01SXHSXH-26L300 | [RS 820-1541](https://uk.rs-online.com/web/p/8201541) | 10 | 26 (3 pk) | 59 (6 pk) | 0.383 | 11.49 | 19.44 | 1700 (2026-10-26) |
| BIGTREETECH TMC2209 V1.3 StepStick (plugs into U4 sockets) | BIGTREETECH TMC2209 V1.3 | [3DJake UK ](https://www.3djake.uk/bigtreetech/stepper-motor-driver) | 1 | 1 (1 pk) | 3 (3 pk) | 5.250 | 5.25 | 15.75 | In stock, 14 left (retailer page) (2026-10-26) |
| MINI blade fuse 7.5 A 32 V (F1, DPS feed); RS sells it only in 50s | Littelfuse 029707.5WXNV | [Farnell 9943854](https://uk.farnell.com/search?st=9943854) | 5 | 1 (1 pk) | 4 (1 pk) | 0.245 | 1.23 | 1.23 | 17459 (2026-10-26) |
| Mini-Fit Jr receptacle housing 2-way (brick lead) | Molex 39-01-2020 | [RS 484-1748](https://uk.rs-online.com/web/p/4841748) | 5 | 1 (1 pk) | 3 (1 pk) | 0.388 | 1.94 | 1.94 | 73940 (2026-10-26) |
| Phoenix MSTB 2,5/2-ST-5,08 screw plug (DPS5005 input lead; no crimp) | Phoenix Contact 1757019 | [RS 189-6010](https://uk.rs-online.com/web/p/1896010) | 5 | 1 (1 pk) | 3 (1 pk) | 1.254 | 6.27 | 6.27 | 5475 (2026-10-26) |
| JST VH housing 3-way (12 V lead to tec card, both ends) | JST VHR-3N | [RS 820-1175](https://uk.rs-online.com/web/p/8201175) | 5 | 2 (1 pk) | 5 (1 pk) | 0.126 | 0.63 | 0.63 | 23280 (2026-10-26) |
| JST VH housing 4-way (motor lead) | JST VHR-4N | [RS 820-1179](https://uk.rs-online.com/web/p/8201179) | 5 | 1 (1 pk) | 3 (1 pk) | 0.160 | 0.80 | 0.80 | bag 820-1179P: 15379 (findchips) (2026-10-26) |
| Reverse-brick ring snubber, resistor: 2.2 ohm MRS25, in series with a 1 uF 50 V MLCC (Murata RDER71H105K2P1H03B, from the C1u pack) across the Kycon inlet socket (+24 V pins 1/4 to 0 V pins 2/3), heat-shrunk | Vishay MRS25000C2208FCT00 | [RS 683-3487](https://uk.rs-online.com/web/p/6833487) | 25 | 1 (1 pk) | 3 (1 pk) | 0.092 | 2.30 | 2.30 | 100 (2026-10-26) |
| Mini-Fit Jr receptacle housing 4-way (TEC lead) | Molex 39-01-2040 | [RS 484-1754](https://uk.rs-online.com/web/p/4841754) | 5 | 1 (1 pk) | 3 (1 pk) | 0.388 | 1.94 | 1.94 | 43360 (2026-10-26) |
| Mini-Fit Jr receptacle housing 6-way (DPS5005 output lead) | Molex 39-01-2060 | [RS 484-1760](https://uk.rs-online.com/web/p/4841760) | 5 | 1 (1 pk) | 3 (1 pk) | 0.532 | 2.66 | 2.66 | 48460 (2026-10-26) |
| Molex Mini-Fit Jr pre-crimped lead, 225 mm 18 AWG, 39-00-0039-type socket one end, other end bare (W32 brick inlet 2 + W06 TEC feed 4); not stocked by RS | Molex 215341-1113 | [Farnell 3559249](https://uk.farnell.com/search?st=3559249) | 1 | 6 (6 pk) | 14 (14 pk) | 0.837 | 5.02 | 11.72 | 2510 (2026-10-26) |
| Molex Mini-Fit Jr pre-crimped lead, 450 mm 18 AWG, one end bare (W05 DPS output, 290 mm needed: pins 1 and 4). Farnell showed 0 stock on 2026-10-26: if still out, use a 225 mm lead + soldered extension (heat-shrink RS 398-212) | Molex 215341-1115 | [Farnell 3559251](https://uk.farnell.com/molex/215341-1115/cable-assy-crimp-socket-free-end/dp/3559251) | 1 | 2 (2 pk) | 5 (5 pk) | 1.080 | 2.16 | 5.40 | 0 (2026-10-26) |
| JST VH housing 2-way (thermostat loop lead) | JST VHR-2N | [RS 820-1172](https://uk.rs-online.com/web/p/8201172) | 5 | 1 (1 pk) | 3 (1 pk) | 0.116 | 0.58 | 0.58 | 15695 (2026-10-26) |
| JST VH pre-crimped lead, 300 mm 20 AWG, SVH contact both ends (3 for the 12 V link W03; motor W13 (4) and thermostat W23, W27 (2) cut near one end) | JST 01SVHSVH-20L-300 | [RS 820-1135](https://uk.rs-online.com/web/p/8201135) | 5 | 9 (2 pk) | 21 (5 pk) | 1.052 | 10.52 | 26.30 | 300 (2026-10-26) |
| Bimetal thermostat NC, opens 60 C / closes 45 C, 16 A, 250 V AC/DC (one per hot sink, wired in series) | RS PRO T24A060ASF2-15 | [RS 222-8227](https://uk.rs-online.com/web/p/2228227) | 1 | 4 (4 pk) | 9 (9 pk) | 8.500 | 34.00 | 76.50 | not visible to scripts (2026-10-26) |

| Supplier | 1 set (£ ex VAT) | 2 sets + spares (£ ex VAT) |
|---|---:|---:|
| 3DJake UK | 5.25 | 15.75 |
| Farnell | 12.74 | 28.41 |
| RS | 216.64 | 331.06 |
| Rapid Electronics | 10.32 | 30.96 |
| **All** | **244.95** | **406.18** |
<!-- END bom-sourced.md -->

**Low stock:** JST B3P-VH header in packs of 5 showed only 10 pieces (2 packs) at RS; the bag of 125
(820-1150P) had 6050. Farnell 9492011 (min 100) is the fallback.

## Leads: pre-crimped where long enough (revised 2026-10-26 against the final cut list)

Against `build/plenum/harness/cutlist.csv` (cut lengths). UK distributors stock JST XH and VH
pre-crimped leads only in 150 and 300 mm, and Molex Mini-Fit Jr one-ended leads in 150/225/450 mm.
Rule: a lead with a connector at one end only uses a whole 300 mm lead **cut near one end** (≈ 290 mm
usable), not a lead cut in half.

| Lead | Needs | Built from | Splice? |
|---|---:|---|---|
| W02 ctrl–tec XH-12 | 290 | JST 01SXHSXH-26L300 (RS 820-1541), contact both ends | no |
| W12 DPS UART, W30 basin, W31 home, W33/W34 1-Wire tails | 280 / 110 / 165 / 50 / 60 | 01SXHSXH-26L300 cut near one end | no |
| **W01 ctrl–pwr XH-11, W28 lid reed, W29 panel** | **335 / 325 / 300** | No stocked XH pre-crimped lead is long enough → loose SXH-001T-P0.6 (RS 123-5947) crimped with an **Engineer PA-09** (~£38, Amazon UK) on 26 AWG wire | no |
| W03 12 V VH-3 | 290 | JST 01SVHSVH-20L-300 (RS 820-1135), both ends | no |
| W13 motor, W23/W27 thermostat ends | 190 / 105 / 265 | 01SVHSVH-20L-300 cut near one end | no |
| W05 DPS output (pins 1, 4) | 290 | Molex 215341-1115, 450 mm (Farnell 3559251; **0 stock on 2026-10-26**) | no; fallback: 215341-1113 225 mm + 65 mm soldered extension, 2.4 mm heat-shrink (RS 398-212) |
| W06 TEC feed, W32 inlet | 100 / 115 | Molex 215341-1113 225 mm (Farnell 3559249) | no |
| W16 blower harness | 310 | Noctua NA-EC1 300 mm 4-pin extension (cut; its female housing goes into tec J6) joined to the Adafruit 1663 SM pigtail | **one junction** (two pre-made leads; no single pre-made lead has SM at one end and a fan housing at the other): solder, 1.6 mm heat-shrink RS 234-5908 |
| W18/W20 probe harnesses | 235 / 205 | Adafruit 1663 SM pigtail (163 mm) | none if the bus-A Y-splice moves ≥ 72 mm toward the probes and W33 (XH, up to ~290 mm) lengthens to suit: **harness owner please re-route** |
| W04 DPS input | 275 | MSTB screw plug + 18 AWG silicone | screw terminal, no crimp |
| W24–W26 thermostat links | 95–275 | 20 AWG silicone + TE flags (ratchet crimper RS 533-774) | no |

Tools for the whole harness: Engineer PA-09 (XH, three leads) and the RS PRO HT-303 ratchet crimper for the
insulated thermostat flags. The flags can be soldered instead.

- **DPS5005 UART lead.** The DPS comms socket is a 4-pin 1.25 mm JST-GH-type (one 2017 unit reported 1.0 mm
  JST-SH) with GND, TX, RX, 3.3 V, 3.3 V logic [community: OpenDPS/kanflo, Yoctopuce; Riden manual for the
  comms versions]. Cut the cable supplied with the DPS comms kit (or a 4-pin JST-GH pigtail, about £2 UK),
  **meter GND and the idle-high DPS TX before terminating**, then crimp/fit XH contacts from a cut
  01SXHSXH lead into the XHP-4: 1 GND, 2 DPS-TX, 3 DPS-RX, 4 empty. DPS 3.3 V stays unconnected. Because the
  order is set by metering, either connector variant works and nothing on the card changes.

## Harness and off-card devices (coordinator request, 2026-10-26)

Researched for the harness cut list (`build/plenum/harness/cutlist.csv`); data in
[`sourcing/offcard.json`](../electronics/d34/sourcing/offcard.json), datasheets `oc_*.pdf`. These lines
are per build, mostly RS, and **not** in the card totals above. Prices marked "est." in the JSON are RS
export-site EUR × 0.87; a few have no visible price.

<!-- BEGIN bom-offcard.md (generated) -->
| Item | Mfr / MPN | Supplier, stock no | Pack | Per build | £/pc ex VAT | £ per build | Verified | Crimp tool? |
|---|---|---|---:|---:|---:|---:|---|---|
| 3-way inline pair, cold-zone leads (5015 blower, 2 SMD DS18B20 probe tails), W15-W20 | Adafruit (JST SM-compatible) 1663 | [The Pi Hut 105730](https://thepihut.com/products/3-pin-jst-sm-plug-receptacle-cable-set) | 1 | 3 | 1.25 | 3.75 | Pi Hut/Adafruit page: one JST SM 3-pin plug lead + one receptacle lead, each 163 mm, 22 AWG, latching. Not a JST-branded part number. | no |
| TEC junction JT1/JT2: 2-way wire-to-wire, receptacle half (Mini-Fit Jr 5557-02R, female contacts) | Molex 39-01-2020 | [RS 484-1748](https://uk.rs-online.com/web/p/wire-housings-plugs/4841748) | 5 | 4 | 0.24 | 1.20 | Molex 5557 drawing (datasheets/molex_5557_housing.pdf): 39-01-2020 = 5557-02R, mates with 5559 plug. 39-01-2025 (5557-02R-210, RS 679-5763) is the 94V-0 equivalent. | no |
| TEC junction: 2-way wire-to-wire, plug half (Mini-Fit Jr 5559, male contacts) | Molex 39-01-3023 | [RS 679-5802](https://uk.rs-online.com/web/p/wire-housings-plugs/6795802) | 5 | 4 | 0.51 | 2.56 | Farnell/RS listings describe 39-01-3023 and 39-01-3029 as Mini-Fit Jr 2-circuit PLUG housings (5559 series). Molex drawing not retrievable (molex.com blocked scripts). | no |
| Pre-crimped Mini-Fit socket-socket lead, cut in half -> 2 female contacts for the receptacle | Molex 226197-1114 | [RS 311-273](https://uk.rs-online.com/web/p/crimped-wire/0311273) | 1 | 4 | 0.59 | 2.36 | Farnell desc: CABLE ASSY, CRIMP SKT-CRIMP SKT, 300 MM; RS regional listing: 18 AWG | no |
| Pre-crimped Mini-Fit pin-pin lead, cut in half -> 2 male contacts for the plug | Molex 226197-3114 | [RS 311-291](https://uk.rs-online.com/web/p/crimped-wire/0311291) | 1 | 4 | 0.66 | 2.64 | Farnell desc: CABLE ASSY, CRIMP PIN-CRIMP PIN 300 MM; RS PH listing calls the 150 mm version male-to-male, 18 AWG | no |
| Insulated 6.3 mm flag receptacle for bimetal thermostat tabs (2 per thermostat) | TE Connectivity 2-520129-2 | [Farnell 488380](https://uk.farnell.com/amp-te-connectivity/2-520129-2/crimp-terminal-female-6-3x0-8mm/dp/488380) | 10 | 8 | 0.34 | 3.45 | RS spec (export 245-5339): Ultra-Fast .250 fully insulated FLAG receptacle, tab 6.35 x 0.81 mm, 22-18 AWG (0.3-0.9 mm²), red, 16.14 mm long. | yes |
| Ratchet crimper for pre-insulated (red/blue/yellow) terminals - the only crimp tool needed | RS PRO HT-303 | [RS 533-774](https://uk.rs-online.com/web/p/crimp-tools/0533774) | 1 | 1 | 35.51 | 35.51 | RS export spec: ratchet, insulated spade/terminals, 0.5-6 mm² (22-10 AWG), 228 mm | no |
| DS18B20 TO-92 hot-sink probe (W21) | Analog Devices (Maxim) DS18B20+ | [Farnell 2515553](https://uk.farnell.com/search?st=2515553) | 1 | 1 | 7.55 | 7.55 | Farnell desc: TEMPERATURE SENSOR, 0.5 DEG C, TO-92-3. Datasheet download from analog.com timed out (not saved). | no |
| Waterproof SMD DS18B20 probe (2 chamber/near-serving + 1 room air) | DFRobot SEN0511 | [The Pi Hut SEN0511](https://thepihut.com/products/waterproof-smd-ds18b20-digital-temperature-sensor) | 1 | 3 | 5.58 | 16.74 | Pi Hut page: 3-5.5 V, 3 wires red VCC/black GND/blue DATA, silicone lead. Lead ~1000 mm from a Core Electronics staff measurement (community, not DFRobot). | no |
| Home sensor hall switch, TO-92 (W31) | Texas Instruments DRV5033AJQLPG | [RS 900-9807](https://uk.rs-online.com/web/p/hall-effect-sensors/9009807) | 10 | 1 | 0.35 | 3.47 | oc_ti_drv5033.pdf p1/p3/p5: omnipolar (either pole), AJ BOP ±6.9 mT / BRP ±3.5 mT typ, 2.5-38 V (runs at 3.3 V), open-drain 30 mA sink (needs pull-up), TO-92 LPG pinout 1 VCC, 2 GND, 3 OUT. | no |
| Ø6 x 3 mm NdFeB disc magnets (2 home drive pocket + 1 lid reed actuator) | RS PRO (RS PRO, no MPN) | [RS 219-2237](https://uk.rs-online.com/web/p/neodymium-magnets/2192237) | 10 | 3 |  |  | oc_rspro_neodymium_disc.pdf: 219-2237 = disc Ø6 mm x 3 mm, NiCuNi, magnetised through thickness, tube of 10, max 80 °C, N35 (range). | no |
| Lid reed switch, normally open, glass, leaded (W28) | RS PRO KSK-1A66/3-1015 | [RS 265-2226](https://uk.rs-online.com/web/p/reed-switches/2652226) | 5 | 1 | 1.24 | 6.20 | RS export spec: 1 Form A (NO), glass, through-hole leads, 14 mm long, 2.2 mm dia, 10-15 AT, 0.5 A / 200 V / 10 W, -55..130 °C. | no |
| Panel pod 5 mm LED (W29) | RS PRO 503GD2E-1A | [RS 254-5715](https://uk.rs-online.com/web/p/leds/2545715) | 5 | 1 | 0.06 | 0.28 | RS export spec: 5 mm through-hole, yellow-green 571 nm, Vf 2.4 V, 13-30 mcd, 60°, 100 mA max | no |
| Panel pod 6 x 6 mm tactile switch, THT (W29) | Omron B3F-1000 | [RS 686-6847](https://uk.rs-online.com/web/p/tactile-switches/6866847) | 5 | 1 | 0.90 | 4.52 | RS/Farnell: SPST-NO 50 mA 24 V DC, THT, 6x6x4.3 mm, 0.98 N | no |
| Basin-full probe stainless pins (W30) | Accu HDP-2-16-A1 | [Accu (UK) HDP-2-16-A1](https://accu.co.uk/dowel-pins/72605-HDP-2-16-A1) | 1 | 2 |  |  | Accu listing title (search index): 2 mm x 16 mm dowel pin, DIN 7, A1 stainless (austenitic 303). | no |
| 26 AWG stranded hook-up wire (sensor/UI leads), 3 colours | Alpha Wire 3049 BK005 / 3049 RD005 / 3049 WH005 | [RS 121-4263 / 842-5230 / 121-4271](https://uk.rs-online.com/web/p/hook-up-wire/1214263) | 1 | 1 | 17.98 | 17.98 | Rapid/RS listings: 26 AWG 7/34 tinned Cu, PVC 0.41 mm wall, OD 1.29 mm, UL1007/1569, 300 V, 105 °C | no |
| 20 AWG silicone wire (thermostat loop W23-W27, ~0.9 m) | RS PRO SILICONE RUBBER-BLK-25M (also -RED-, -BLU-) | [RS 248-3619 (black), 248-3624 (red), 248-3620 (blue)](https://uk.rs-online.com/web/p/hook-up-wire/2483619) | 1 | 1 | 27.20 | 27.20 | RS export spec: 20 AWG 16/0.2 mm tinned Cu, silicone 0.8 mm wall, OD 2.6 mm, 750 V, -60..180 °C, 25 m | no |
| Expandable braided PET sleeving ~6 mm | RS PRO BSPETFR series | [RS 408-209 (5 m) / 179-7009 (25 m)](https://uk.rs-online.com/web/p/cable-sleeves/1797009) | 1 | 1 |  |  | Search-index RS listing: PET, flame retardant, halogen free, -50..+150 °C; 179-7009 cable range 4-11 mm (eezee listing). 5 m 408-209 seen only on RS SG/ID sites. | no |
| 5015 radial blower, 12 V (target >=4.5 CFM / ~167 Pa) | RS PRO ODB5115-12HB | [RS 144-4136](https://uk.rs-online.com/web/p/centrifugal-fans/1444136) | 1 | 1 | 19.11 | 19.11 | RS export spec: 51.11 x 51.11 x 15 mm, 12 V, 120 mA, 4.2 CFM, 0.5 inH2O (124 Pa), ball bearing, tach output, wire leads, IP55 | no |
| Hot-side 120 mm fan | Noctua NF-A12x25 PWM | [Overclockers UK FG-06R-NC](https://www.overclockers.co.uk/noctua-nf-a12x25-pwm-fan-120mm/FG-06R-NC.html) | 1 | 1 | 24.99 | 24.99 | Price/stock from page structured data only; specs per BOM.md. | no |
| 40 x 40 mm 127-couple TEC, ~4 A class (TARK CP14-127-10 equivalent) | Adaptive (European Thermodynamics, UK) ADV-127-135200-S | [RS 606-975](https://uk.rs-online.com/web/p/peltier-modules/0606975) | 1 | 4 | 8.25 | 33.00 | oc_adaptive_adv-127-135200-s.pdf p1: Imax 4 A, Vmax 15.4 V, Qcmax 34.2 W, dTmax 65 K (Th 25 °C, N2), 40 x 40 x 4.2 mm, 350 mm leads AWG20 PVC 105 °C, silicone sealed, max mounting pressure 1.5 MPa. TARK CP14-127-10-L1-W4.5 (thermoelectricdevices.co.uk page): 3.9 A, 15.4 V, 33.4 W, 4.7 mm, 114 mm 18 AWG leads, price on enquiry. | no |
| Hot-side sink, 75 tangential x 70 radial x 45, fins radial (simulated R_hot ~0.67 K/W ducted) | Alutronic PR 614 (cut to 70 mm) | [Alutronic (DE, direct; no UK distributor found) PR 614](https://alutronic.de/de/products/standardprofile/pr-614/) | 1 | 4 |  |  | Alutronic spec sheet (thermal/datasheets/alutronic_pr614.pdf): 75 W x 45 H, 5 mm base, EN AW-6060; 22 fins counted on maker profile, ~3.5 mm pitch, ~1.35 mm mean fin [est]. plenum_cad.py PR614_L70: R_hot 0.667 K/W (simulation). | no |
| Cold-side sink, 74.5 radial x 46 along flow x 22, fins along the flow | Alutronic PR 411 (cut to 46 mm) | [Alutronic (DE, direct; no UK distributor found) PR 411](https://alutronic.de/de/products/standardprofile/pr-411/) | 1 | 4 |  |  | Alutronic spec sheet (thermal/datasheets/alutronic_pr411.pdf): 74.5 W x 22 H, 3 mm base, EN AW-6060; 13 serrated fins at ~6.03 mm pitch, ~1.7 mm [est]. plenum_cad.py PR411_L46: R_cold 1.81 K/W (60 mm: 1.63) (simulation). | no |
| NEMA17 pancake stepper | StepperOnline 17HS08-1004S | [StepperOnline UK 17HS08-1004S](https://www.stepperonline.co.uk/nema-17-bipolar-stepper-motor-1-8deg-16ncm-22-66oz-in-1a-extruder-motor-42x42x20mm-4-wires-17hs08-1004s.html) | 1 | 1 |  |  | UK page: 1.0 A, 3.7 ohm, 4.5 mH, 16 Ncm, 21.5 mm body, Ø5 D-shaft 20 mm, 4 leads black/green/red/blue, 400 mm lead length. | no |
| 608-2RS stainless bearings (rim rollers) | RS PRO SS608-2RS | [RS 893-7323](https://uk.rs-online.com/web/p/ball-bearings/8937323) | 1 | 7 | 4.02 | 28.14 | RS export spec: 8 x 22 x 7 mm, stainless races and cage, steel balls (listing), sealed both sides, CN clearance, 2.11 kN dynamic | no |
| 24 V mains brick, >=150 W (D32) | MEAN WELL GST160A24-R7B | [Farnell 2815854](https://uk.farnell.com/search?st=2815854) | 1 | 1 | 38.50 | 38.50 | oc_meanwell_gst160a.pdf p2-4: 24 V 6.67 A 160 W, 175 x 72 x 35 mm, IEC C14 inlet, 1200 mm UL2464 18 AWG x 4C cable, R7B plug = Kycon KPPX-4P equivalent; pins 1,4 = +V, 2,3 = -V; -V tied to AC FG. | no |
| Wall inlet: 4-pin power DIN panel socket mating the R7B plug | Kycon KPJX-PM-4S | [RS 667-7287](https://uk.rs-online.com/web/p/dc-power-connectors/6677287) | 1 | 1 | 6.13 | 6.13 | oc_kycon_kpjx-pm-4s.pdf: 7.5 A max per pin @ 48 V DC (2 pins per pole -> 15 A vs 6.67 A), 30 mOhm, -40..75 °C, PBT UL94V-0, recommended for KPPX plug; flange 25.2 mm with 2 x Ø2.3 holes (19.0 mm pitch read from drawing text), recommended M2.5 screws length 6.6 + panel thickness. | no |
| Hand crimper for JST XH open-barrel contacts (only W01, W28, W29 need it: no stocked XH pre-crimped lead is long enough) | Engineer PA-09 | [Amazon UK ](https://www.amazon.co.uk/s?k=Engineer+PA-09) | 1 | 1 | 31.67 | 31.67 | retailer data; widely used for JST XH SXH contacts (die 1.9) [community] | no |
| Heat-shrink 1.6 mm 2:1 black, 1.22 m (26 AWG splices: W16 blower harness junction, probe Y-splices) | RS PRO G5-1350016BK-1.22M | [RS 234-5908](https://uk.rs-online.com/web/p/2345908) | 1 | 1 | 1.99 | 1.99 | RS listing | no |
| Heat-shrink 2.4 mm 2:1 black, 1.2 m (18-20 AWG splices; W05 fallback extension) | RS PRO B2 2.4MM C BLK | [RS 398-212](https://uk.rs-online.com/web/p/398212) | 1 | 1 | 2.07 | 2.07 | RS listing | no |
| 4-pin PC fan extension 300 mm (cut: its female housing + leads become the tec J6 end of W16; no KK crimp needed) | Noctua NA-EC1 | [Overclockers UK ](https://www.overclockers.co.uk/search?sSearch=NA-EC1) | 1 | 1 |  |  | retailer data not checked | no |

| Supplier (off-card) | £ per build ex VAT |
|---|---:|
| Accu (UK) | 0.00 |
| Alutronic (DE, direct; no UK distributor found) | 0.00 |
| Amazon UK | 31.67 |
| Farnell | 49.50 |
| Overclockers UK | 24.99 |
| RS | 194.36 |
| StepperOnline UK | 0.00 |
| The Pi Hut | 20.49 |
| **All off-card** | **321.01** |
<!-- END bom-offcard.md -->

Decisions and findings that change other documents:

- **JST VH has no wire-to-wire plug** (eVH: wire-to-board only), so the harness's "VHP-2N" TEC junctions
  do not exist. Use **Molex Mini-Fit Jr 2-way wire-to-wire**: 39-01-2020 receptacle + 39-01-3023 plug
  (RS 484-1748 / 679-5802) with pre-crimped leads cut in half (226197-1114 socket, 226197-3114 pin;
  RS 311-273 / 311-291). 9 A per contact, no crimping.
- **Cold-zone 3-way inline:** JST SM pre-wired pairs (Adafruit 1663, The Pi Hut), 22 AWG, latching;
  device tails are soldered and heat-shrunk. RS has SM housings but only loose contacts.
- **Hall switch: TI DRV5033AJQLPG** (RS 900-9807), not DRV5023 (not stocked in the UK). Same TO-92 pinout
  (1 VCC, 2 GND, 3 OUT), 2.5–38 V, open drain, but omnipolar. It works unchanged with ctrl J3
  (3.3 V supply, 10 k pull-up R15, 1 k series R16): **no circuit change.**
- **Lid reed** (RS PRO KSK-1A66, RS 265-2226) switches LID to GND against the existing 10 k pull-up;
  **basin-full probe** (two stainless pins) pulls LEAK to GND through the water against 47 k; ADC reads via
  10 k. DC at ≤ 70 µA on stainless pins: corrosion expected to be slow; firmware should sample briefly
  [estimate]. **No circuit change.** Both share the ctrl J4 SENSE plug.
- **24 V brick: MEAN WELL GST160A24-R7B** (160 W, 6.67 A, meets D32's ≥ 150 W; Farnell 2815854, not at RS)
  with a **Kycon KPJX-PM-4S** 4-pin power-DIN panel socket (RS 667-7287, 7.5 A per pin, pins 1+4 = +24 V,
  2+3 = 0 V). The 5.5/2.5 mm route fails: GST120A24-P1M is 120 W and RS's 5.5/2.5 panel jacks are 5 A.
  **The Kycon socket is drawn for 2 × M2.5 screws: CAD must retain it with printed pegs/clip instead (no
  screws), and the wall hole grows from Ø12.** The inlet pigtail pairs pins 1+4 and 2+3 into one 18 AWG
  Mini-Fit lead per pole to pwr J1.
- **5015 blower:** no UK-stocked 5015 meets ≥ 4.5 CFM / 167 Pa. RS PRO ODB5115-12HB (RS 144-4136) gives
  4.2 CFM / 124 Pa (below target); Delta BFB0512VHD-F00 (Farnell) exceeds it but was out of stock.
- **TECs:** Adaptive (European Thermodynamics, UK) ADV-127-135200-S, RS 606-975 (4 A, 34.2 W,
  40 × 40 × 4.2 mm, 350 mm leads; only 7 shown in stock and the £8.25 price looks low: confirm). TARK
  CP14-127-10 remains quote-only. 4.2 mm vs TARK's 4.7 mm changes the spacer (thermal/CAD owners).
- **Sinks:** only trial stand-ins are stocked (Fischer SK 100 75 SA hot, TDEX6015/TH cold). The CAD
  envelopes need cut-to-length extrusion quotes (Alutronic PR 614 hot, PR 411 cold).
- **Thermostat flags:** TE 2-520129-2 insulated 6.35 mm flag receptacles (Farnell 488380) need a
  generic ratchet crimper for pre-insulated terminals (RS PRO HT-303, RS 533-774); the T24 tab width is
  unverified. The alternative is soldering the loop wires to the tabs.
- **Motor:** 17HS08-1004S ships with 400 mm leads; the motor-end connector is not stated by
  StepperOnline (harness assumed JST PH-6): check on arrival.

## What was verified and how

38 PDFs are in `electronics/d34/datasheets/` with SHA-256 and source URL. Seven came from mirrors because
the maker's site blocked scripts (Phoenix ×2, ST P6KE, Nexperia BZX79, Littelfuse RXEF/297, Broadcom
HLMP, Yageo MF0); each is the maker's own document, re-hosted.

| Part | Checked against footprint / design | Result |
|---|---|---|
| JST XH, VH; Molex Mini-Fit Jr 5566/5557; Molex 47053; Phoenix MSTBVA/MSTB; Samtec SSW | Pitch, row spacing, hole size, outline, height, mated height [datasheet] | Match, except the **fan-header peg hole: 1.25 mm per Molex vs 1.1 mm in KiCad's stock footprint → corrected** (`catalog.FP_DRILL_FIX`, tested). |
| ESP32-DevKitC-32E | Rows 25.40, pitch 2.54, 48.26 × 27.94 PCB + 6.04 antenna, pin order, 5V pin after BAT760, AMS1117 [datasheet] | Match. Header plastic/pin length not published: module PCB assumed 11.0 mm up (8.51 socket + 2.5 header) [estimate]. |
| BTT TMC2209 V1.3 | Pinout from BTT's V1.3 schematic [datasheet] | Pin 4 PDN_UART direct (our 1 k R6 needed), pin 5 NC, pin 6 CLK with 20 k pull-down, EN 20 k pull-up, MS1/MS2 open → address 0. Heatsink height not published [estimate 22 mm total]. |
| DPS5005 comms | Riden manual (comms versions), community pinouts | Connector pitch varies by production; lead designed so either works (above). |
| 74HC123 | TI CD74HC123E is unavailable at RS UK → **Toshiba TC74HC123AP(F), RS 539-9456** | Same pinout, 2–6 V, tw ≈ 1.0·Cx·Rx → 1 µF × 1 MΩ ≈ 1.0 s; Rx ≤ 1 MΩ allowed. |
| SN74HC573AN, ULN2003AN, IRF4905, P6KE30A, BZX79-C15, 1N5817, 1N4148, 2N3904, G2RL-2, HLMP-1503, RXEF110, Panasonic FR, Rubycon YXF, Murata RDE, TRACO TSR 1/TSR 2N, Keystone 3568, Littelfuse 297 | Pinout, package, lead pitch/diameter, height [datasheet] | See changes below; otherwise match. |
| RS PRO T24A060ASF2-15 thermostat | **No datasheet is published** (RS page has only RoHS/conformity) | NC, opens 60 °C / closes 45 °C, 16 A 250 V AC/DC, horizontal tab [distributor]. Size, tab width and tolerance [unverified]: check parts on arrival. Here it only switches 12 V / 35 mA. A Honeywell 2455RP-91000434 alternative (RS 229-5890) costs £29 each. |

### Changes forced by the checks

| Was | Now | Evidence |
|---|---|---|
| Murata RDER71H10xK…**K1**H03B (lead code K1 = **5.0 mm**) on 2.5 mm pads | **…P1H03B** (2.5 mm): 100 nF RS 190-2933, 1 µF RS 190-2943; new 5.5 × 3.2 mm footprint for the 1 µF | Murata RDE p2 |
| Vishay MRS25 on 7.62 mm pads | **Yageo MF0204** (3.4 × 1.9 mm body) on 7.62 mm pads. MRS25's minimum formed pitch is 10.0 mm, which the ctrl grid cannot take. | Vishay MRS25 p3; Yageo MF0 p3/p9 |
| Resistor values 100 k, 30 k, 33 k | **47 k** (R3, R5, R19 on ctrl); THERMO_OK divider **1 k / 330** (2.98 V at 12 V, 9 mA) | Only values RS stocks in small packs (tape of 100) |
| RXEF110 on a 7.5 × 2.5 mm disc footprint, 12 mm tall | Real outline **12.8 × 3.0 × 17.5 mm**, custom footprint; C2 moved | Littelfuse RXEF p4/p6 |
| TO-220 height 19 mm; HLMP-1503 5.5; fuse 14; MLCC 5 | **20.6, 6.4, 16.3, 6.5 mm** in `parts3d.json` | IRF4905 p8, HLMP p1, Keystone p42, RDE p2 |
| Murata OKI-78SR (not at RS) | **TRACO TSR 2-24120N** (12 V **2 A**, RS 608-891) and **TSR 1-2450** (5 V 1 A, RS 666-4379); no traces under the TSR 2N body | TRACO TSR 2N p1–p4, TSR 1 p1/p4 |
| 1N5819 ×1, 1N4007 ×1, 1N4148 ×1 | **1N5817 ×2** (one pack of 5); D2 = BZX79-C15 used forward-biased (leakage negligible at < 3.3 V reverse) | onsemi 1N5817 p2; saves a 250-piece 1N4148 pack |
| 10 A fuse considered | **7.5 A** Littelfuse 029707.5WXNV exists | Littelfuse 297 p1 |
| KSD301 (no UK distributor, no DC rating) | RS PRO T24A060ASF2-15 (opens 60 °C) | RS listing; see the unverified note above |
| 2N3904BU on 2.54 mm pads | Kept (a 1.27 mm footprint cannot meet the 0.25 mm annular ring): **splay the outer leads** as onsemi forms the TA version | onsemi 2N3903-D p7 |

Rubycon YXF is marked obsolete by Rubycon but RS showed 1,365 in stock; Panasonic EEU-FR1H220 is the
drop-in (same 5 × 11 mm can, 2.0 mm pitch) if it runs out. The RS title for the G2RL-2 says "Aratas"
while the listing data is Omron: check the relay marking on arrival.

## UK PCB fab comparison (3 designs × 5 boards, 81 × 47 mm, 2-layer, 1.6 mm, 1 oz)

Prices from each maker's public calculator or public price page, 2026-10-26 (research agent;
raw responses were not kept in the repository).

| Maker | Where made | Job price | Lead time | Min track/space | Min hole | Ring | Silk | Files |
|---|---|---|---|---|---|---|---|---|
| **PCB Train / Newbury Electronics** | UK (Newbury) | £92.70 per design at 15 working days, ex VAT → 3 designs + £5 post = **£339.72 inc VAT**. 10 WD: £450.96. | 2–15 WD + 3 post | 0.15/0.15 | 0.2 | 0.125 | 1.0 mm text, 0.10 line | RS-274X + Excellon, one ZIP, default names. **No HASL online**: immersion silver (IS) or ENIG. |
| Quick-teck | UK company, own factory in China | £117.39–122.61 per design inc VAT and delivery → **£352–368** | 9–16 WD delivered | 0.15/0.15 (instant quote ≥0.2) | 0.25 | n/p | 0.8 mm text | RS-274X + drill ZIP; HASL lead-free default |
| Aisler | Germany/NL broker | €81.91 net for 6 of each, + shipping; UK import VAT due on delivery | n/p | 0.20/0.15 (HASL) | 0.3 | n/p | n/p | — |
| OSH Park | USA | $177 (ENIG), UK VAT/shipping not checked | 9–12 days | 0.152 | 0.254 | 0.127 | 0.127 | — |
| **JLCPCB (baseline)** | China | about **£11–23** total for 3 × 5 incl. UK VAT collected at checkout (≤ £135 rule) and economy shipping [estimate: live calculator not readable] | 1–2 days build + 2–7 days | 0.10/0.10 | 0.15 | 0.18 (0.25 rec.) | 1.0 mm | Gerber + drill ZIP |

Ragworm appears to have closed (ragworm.co.uk does not resolve). Eurocircuits, Multi-CB and Beta Layout
quotes need JavaScript or a login.

**No UK maker is cheaper than JLCPCB; the cheapest UK-made option costs about 15–30× more.**

**Recommendation: PCB Train (Newbury Electronics), standard 15-working-day service, immersion silver,
about £340 inc VAT** if UK manufacture is the priority. It meets every rule the cards use, and its published
minimums are all looser than the JLCPCB recommended rules the cards already pass. Immersion silver
solders well by hand but should be assembled within about 6 months or kept sealed. Possible saving to ask
them about: all three designs as one 81 × 145 mm board (£144.45 at 15 WD, about £179 inc VAT) if they will
accept separate circuits on one panel. **If UK manufacture is not required, JLCPCB remains the obvious
choice** (the JLC zips are still generated).

Upload package per card: `electronics/d34/<card>/<card>-pcbtrain.zip` (RS-274X without X2 attributes,
Excellon PTH + NPTH, `README.txt` with stack-up, finish, outline and file list). PCB Train requires no
particular file names. `electronics/d34/pcbtrain-2layer.kicad_dru` encodes their published minimums;
`export.py` runs it as a second DRC (`validation.json`: `DRC_pcbtrain`).

Sources: [PCB Train capability](https://www.pcbtrain.co.uk/technical-information/pcb-technical-capability/),
[fabrication info](https://www.pcbtrain.co.uk/technical-information/pcb-fabrication-technical-information/),
[surface finishes](https://www.pcbtrain.co.uk/technical-information/pcb-surface-finishes/),
[shipping](https://www.pcbtrain.co.uk/quick-online-quote/shipping-charges/),
the PCB Train online quote calculator;
[Quick-teck capability](https://www.quick-teck.co.uk/aboutus/capability.php),
[FAQ](https://www.quick-teck.co.uk/FAQ/FAQ.php);
[JLCPCB capabilities](https://jlcpcb.com/capabilities/pcb-capabilities),
[JLCPCB customs/VAT](https://jlcpcb.com/help/article/customs,-duties-and-taxes);
[Aisler pricing](https://community.aisler.net/t/our-simple-pricing);
[OSH Park](https://docs.oshpark.com/services/two-layer/).

## Still uncertain

1. **Stock and prices** are a 2026-10-26 snapshot via findchips; RS's own pages were not readable by script.
2. **RS PRO thermostat** physical size, tab width and trip tolerance (no datasheet).
3. **Lead lengths** (300 mm XH/VH, 225 mm Mini-Fit) against the real routing.
4. **Module heights**: DevKit header spacer and BTT heatsink height are not published (estimates in `parts3d.json`).
5. **MSTB plug orientation**: whether it can be inserted rotated 180° and which face the wires leave from.
6. **DPS5005 comms socket pitch** (1.25 vs 1.0 mm) on the unit actually bought.
7. **JLCPCB live price** not read (calculator needs JavaScript).
8. **PCB Train finish**: immersion silver shelf life; HASL only by manual quote.
