aquarat/cat-feeder/electronics/pcb/assembly-bom-all.csv

Comment | Designator | Footprint | LCSC Part #
ESP32-WROOM-32E-N4 | U1 | ESP32-WROOM-32E | C701341
AP2112K-3.3TRG1 | U2 | SOT-23-5 | C51118
SN74LVC1G125DBVR | U3,U4 | SOT-23-5 | C23654
MMBT3904 | Q1 | SOT-23 | C20526
10k | R1,R2,R4,R5,R6,R10,R11,R14,R19,R20,R21 | R_0603_1608Metric | C25804
4.7k | R3,R8,R16,R17 | R_0603_1608Metric | C23162
1k | R7,R15 | R_0603_1608Metric | C21190
100k | R9,R12,R13,R18 | R_0603_1608Metric | C25803
10u 25V | C1,C2,C4,C11 | C_0805_2012Metric | C15850
100n | C3,C6,C7,C8,C9 | C_0603_1608Metric | C14663
1u 50V | C5 | C_0603_1608Metric | C15849
100u 50V EEUFR1H101B | C10 | CP_Radial_D8.0mm_P5.00mm | C713402
VMOT 20-24V INPUT | J1 | TerminalBlock_Phoenix_MKDS-1,5-2-5.08_1x02_P5.08mm_Horizontal | C5183929
RAILS GND-5V-12V | J2 | PinHeader_1x03_P2.54mm_Vertical | C49257
FAN GND-12V-TACH-PWM | J3 | PinHeader_1x04_P2.54mm_Vertical | C5116483
DS18B20 GND-DQ-3V3 | J4,J5 | PinHeader_1x03_P2.54mm_Vertical | C49257
INDEX GND-SIG-3V3 | J6 | PinHeader_1x03_P2.54mm_Vertical | C49257
HOME GND-SIG-3V3 | J7 | PinHeader_1x03_P2.54mm_Vertical | C49257
I2C GND-3V3-SDA-SCL | J8 | PinHeader_1x04_P2.54mm_Vertical | C5116483
DPS GND-RX-TX (DPS names) | J9 | PinHeader_1x03_P2.54mm_Vertical | C49257
TEC ENABLE GND-ON | J10 | PinHeader_1x02_P2.54mm_Vertical | C27985187
PROG GND-TX-RX-3V3ref | J11 | PinHeader_1x04_P2.54mm_Vertical | C5116483
BOOT short for download | J12 | PinHeader_1x02_P2.54mm_Vertical | C27985187
RESET short to reset | J13 | PinHeader_1x02_P2.54mm_Vertical | C27985187
A4988 CONTROL socket | J14 | PinSocket_1x08_P2.54mm_Vertical | C27438
A4988 POWER socket | J15 | PinSocket_1x08_P2.54mm_Vertical | C27438
MOTOR COIL1 | J16 | TerminalBlock_Phoenix_MKDS-1,5-2-5.08_1x02_P5.08mm_Horizontal | C5183929
MOTOR COIL2 | J17 | TerminalBlock_Phoenix_MKDS-1,5-2-5.08_1x02_P5.08mm_Horizontal | C5183929
