aquarat/cat-feeder/electronics/d34/d34-ctrl/d34-ctrl-bom.csv

Board | References | Qty | Value | Description | Manufacturer | MPN | KiCad footprint | Supplier | Stock no | Pack | Datasheet | Checked
d34-ctrl | U1 | 1 |  | 1x19 2.54 mm socket strip, 8.51 mm (2 per ESP32-DevKitC-32E) | Samtec | SSW-119-01-T-S | d34:ESP32-DevKitC-32E_Socket | RS | 207-9240 | 1 | samtec_ssw.pdf; esp32_devkitc_v4_dimensions.pdf | verified: SSW body 8.51 high, 0.64 sq pins 3.68-6.35 deep; DevKitC rows 25.40, 48.26 x 27.94 + 6.04 antenna (Espressif drawing)
d34-ctrl | D1 D2 | 2 |  | Schottky 20 V 1 A, DO-41 | onsemi | 1N5817RLG | Diode_THT:D_DO-41_SOD81_P10.16mm_Horizontal | RS | 625-4972 | 5 | 1n5817-19.pdf | verified: VF max 0.32 V @ 0.1 A, 0.45 V @ 1 A; 20 V; DO-41 (onsemi p2)
d34-ctrl | C1 C2 | 2 |  | 22 uF 50 V electrolytic, 5 x 11 mm | Rubycon | 50YXF22M5X11 | Capacitor_THT:CP_Radial_D5.0mm_P2.00mm | RS | 224-4331 | 5 | rubycon_yxf.pdf | verified: 5 x 11 mm, 150 mA ripple (YXF p2); series marked obsolete by Rubycon but RS stock 1365 (2026-10-26); drop-in: Panasonic EEU-FR1H220 (FR p1, F 2.0 mm)
d34-ctrl | D3 | 1 |  | 3 mm green LED | Broadcom | HLMP-1503 | LED_THT:LED_D3.0mm | RS | 180-8502 | 10 | hlmp-1503.pdf | verified: D 3.17, H 6.35 max, leads 2.54 nominal, cathode = short lead, hole 0.98-1.08 (p1, p11)
d34-ctrl | J1 | 1 |  | 11-pin JST XH shrouded header | JST | B11B-XH-A(LF)(SN) | Connector_JST:JST_XH_B11B-XH-A_1x11_P2.50mm_Vertical | RS | 820-1535 | 10 | jst_xh.pdf | verified: eXH pitch 2.5, length 2.5(n-1)+4.9, h 7.0, hole 0.9-1.0, mated 9.8
d34-ctrl | J2 | 1 |  | 12-pin JST XH shrouded header | JST | B12B-XH-A(LF)(SN) | Connector_JST:JST_XH_B12B-XH-A_1x12_P2.50mm_Vertical | RS | 820-1539 | 10 | jst_xh.pdf | verified: eXH pitch 2.5, length 2.5(n-1)+4.9, h 7.0, hole 0.9-1.0, mated 9.8
d34-ctrl | J11 J4 | 2 |  | 4-pin JST XH shrouded header | JST | B4B-XH-A(LF)(SN) | Connector_JST:JST_XH_B4B-XH-A_1x04_P2.50mm_Vertical | RS | 820-1551 | 5 | jst_xh.pdf | verified: eXH pitch 2.5, length 2.5(n-1)+4.9, h 7.0, hole 0.9-1.0, mated 9.8
d34-ctrl | U2 | 1 |  | Dual retriggerable monostable, DIP-16 (TEC watchdog) | Toshiba | TC74HC123AP(F) | Package_DIP:DIP-16_W7.62mm | RS | 539-9456 | 5 | tc74hc123ap.pdf | verified: standard 74HC123 pinout, 2-6 V, tw ~= 1.0 Cx Rx (1 uF x 1 M ~ 1.0 s), Rx <= 1 M, DIP-16 4.15+-0.3 high (Toshiba JP sheet p1, p5-p10)
d34-ctrl | U3 | 1 |  | Octal transparent latch, DIP-20 (defrost-relay interlock) | Texas Instruments | SN74HC573AN | Package_DIP:DIP-20_W7.62mm | RS | 217-5667 | 1 | sn74hc573a.pdf | verified: pinout p3, N20 rows 7.62, 5.08 max (p3, p31)
d34-ctrl | R1 R26 | 2 |  | Resistor 470 k 1 % 0204 (74HC123 timing) | Vishay | MBA02040C4703FRP00 | Resistor_THT:R_Axial_DIN0204_L3.6mm_D1.6mm_P7.62mm_Horizontal | Farnell | 4177865 | 10 |  | Farnell listing: MBA 0204, 470 k, 1 %, 0.4 W (same 0204 body as MF0204; RS has no 470 k 0204 in small packs)
d34-ctrl | R2 R4 R7 R15 R17 R20 R23 R24 R25 | 9 | 10k | Resistor, metal film MF0204, 0.4 W, 1 %, axial | Yageo | MF0204FTE52-10K | Resistor_THT:R_Axial_DIN0204_L3.6mm_D1.6mm_P7.62mm_Horizontal | RS | 199-7794 | 100 | yageo_mf0.pdf | verified: body 3.4+-0.3 x 1.9+-0.2 mm, lead 0.45 mm, M-forming P 6.0 mm (Yageo MF0 spec p3, p9)
d34-ctrl | R3 R12 R19 | 3 | 47k | Resistor, metal film MF0204, 0.4 W, 1 %, axial | Yageo | MF0204FTE52-47K | Resistor_THT:R_Axial_DIN0204_L3.6mm_D1.6mm_P7.62mm_Horizontal | RS | 199-7828 | 100 | yageo_mf0.pdf | verified: body 3.4+-0.3 x 1.9+-0.2 mm, lead 0.45 mm, M-forming P 6.0 mm (Yageo MF0 spec p3, p9)
d34-ctrl | C6 C7 | 2 | 100n | 100 nF 50 V X7R radial MLCC | Murata | RDER71H104K0P1H03B | Capacitor_THT:C_Rect_L4.0mm_W2.5mm_P2.50mm | RS | 190-2933 | 10 | murata_rde.pdf | verified: size 0 = 4.0 W x 2.5 T x 6.0 H mm, lead 0.5, P1 = 2.5 mm (RDE p2); h incl. coating allowance
d34-ctrl | R5 R6 R8 R10 R11 R14 R16 R18 R21 R22 | 10 | 1k | Resistor, metal film MF0204, 0.4 W, 1 %, axial | Yageo | MF0204FTE52-1K | Resistor_THT:R_Axial_DIN0204_L3.6mm_D1.6mm_P7.62mm_Horizontal | RS | 199-7806 | 100 | yageo_mf0.pdf | verified: body 3.4+-0.3 x 1.9+-0.2 mm, lead 0.45 mm, M-forming P 6.0 mm (Yageo MF0 spec p3, p9)
d34-ctrl | R9 | 1 | 4.7k | Resistor, metal film MF0204, 0.4 W, 1 %, axial | Yageo | MF0204FTE52-4K7 | Resistor_THT:R_Axial_DIN0204_L3.6mm_D1.6mm_P7.62mm_Horizontal | RS | 199-7830 | 100 | yageo_mf0.pdf | verified: body 3.4+-0.3 x 1.9+-0.2 mm, lead 0.45 mm, M-forming P 6.0 mm (Yageo MF0 spec p3, p9)
d34-ctrl | D9 | 1 |  | Schottky clamp, DO-35 vertical (IO36 negative clamp) | STMicroelectronics | BAT42 | Diode_THT:D_DO-35_SOD27_P2.54mm_Vertical_AnodeUp | RS | 544-4758 | 5 | bat42.pdf | BAT42 small-signal Schottky 30 V, DO-35 (Vishay BAT42 sheet saved; ST part from RS): VF ~0.2-0.3 V at uA-mA
d34-ctrl | R13 | 1 | 330 | Resistor, metal film MF0204, 0.4 W, 1 %, axial | Yageo | MF0204FTE52-330R | Resistor_THT:R_Axial_DIN0204_L3.6mm_D1.6mm_P7.62mm_Horizontal | RS | 199-7821 | 100 | yageo_mf0.pdf | verified: body 3.4+-0.3 x 1.9+-0.2 mm, lead 0.45 mm, M-forming P 6.0 mm (Yageo MF0 spec p3, p9)
d34-ctrl | C4 C5 | 2 | 1u | 1 uF 50 V X7R radial MLCC | Murata | RDER71H105K2P1H03B | d34:C_Rect_L5.5mm_W3.2mm_P2.50mm | RS | 190-2943 | 10 | murata_rde.pdf | verified: size 2 = 5.5 W x 3.15 T x 6.0 H mm, lead 0.5, P1 = 2.5 mm (RDE p2); custom footprint to that outline
d34-ctrl | J3 | 1 |  | 3-pin JST XH shrouded header | JST | B3B-XH-A(LF)(SN) | Connector_JST:JST_XH_B3B-XH-A_1x03_P2.50mm_Vertical | RS | 820-1557 | 5 | jst_xh.pdf | verified: eXH pitch 2.5, length 2.5(n-1)+4.9, h 7.0, hole 0.9-1.0, mated 9.8
d34-ctrl | J6 | 1 |  | 5-pin JST XH shrouded header | JST | B5B-XH-A(LF)(SN) | Connector_JST:JST_XH_B5B-XH-A_1x05_P2.50mm_Vertical | RS | 820-1560 | 5 | jst_xh.pdf | verified: eXH pitch 2.5, length 2.5(n-1)+4.9, h 7.0, hole 0.9-1.0, mated 9.8
d34-ctrl | (off-board) | 1 |  | ESP32-DevKitC-32E module (plugs into U1 sockets); not stocked by RS/Farnell/CPC | Espressif | ESP32-DevKitC-32E |  | Rapid Electronics | 09-1099 |  | esp32_devkitc_v4_dimensions.pdf; esp32_devkitc_v4_sch.pdf | verified: Espressif drawing + V4 schematic (5V pin after BAT760, AMS1117-3.3); DigiKey UK 1965-ESP32-DEVKITC-32E-ND GBP 7.47 is the alternative
d34-ctrl | (off-board) | 1 |  | JST XH housing 3-way (home sensor lead) | JST | XHP-3 |  | RS | 820-1614 | 5 | jst_xh.pdf
d34-ctrl | (off-board) | 29 |  | JST XH crimp contact SXH-001T-P0.6, AWG 28-22, for the three XH leads longer than any stocked pre-crimped lead: W01 ctrl-pwr link 335 mm (22), W28 lid reed 325 mm (2), W29 panel 300 mm (5); hand crimper Engineer PA-09 | JST | SXH-001T-P0.6 |  | RS | 123-5947 | 250 | jst_xh.pdf
d34-ctrl | (off-board) | 2 |  | JST XH housing 4-way (DPS5005 UART lead; lid reed + basin probe SENSE lead) | JST | XHP-4 |  | RS | 820-1618 | 5 | jst_xh.pdf
d34-ctrl | (off-board) | 1 |  | JST XH housing 5-way (panel LED/button lead) | JST | XHP-5 |  | RS | 820-1627 | 5 | jst_xh.pdf
d34-ctrl | (off-board) | 2 |  | JST XH housing 11-way (ctrl-pwr link, both ends) | JST | XHP-11 |  | RS | 820-1523 | 10 | jst_xh.pdf
d34-ctrl | (off-board) | 2 |  | JST XH housing 12-way (ctrl-tec link, both ends) | JST | XHP-12 |  | RS | 820-1532 | 10 | jst_xh.pdf
d34-ctrl | (off-board) | 26 |  | JST XH pre-crimped lead, 300 mm 26 AWG, SXH contact both ends. W02 ctrl-tec link (12, both ends) and the single-ended leads W12, W30, W31, W33, W34 (14: each lead cut near ONE end, ~290 mm usable) | JST | 01SXHSXH-26L300 |  | RS | 820-1541 | 10 | jst_xh.pdf | retailer data (RS/Farnell listing); contact = SXH-001T-P0.6 per eXH
