aquarat/cat-feeder/electronics/d34/d34-pwr/d34-pwr-bom.csv

Board | References | Qty | Value | Description | Manufacturer | MPN | KiCad footprint | Supplier | Stock no | Pack | Datasheet | Checked
d34-pwr | J1 | 1 |  | 2-pin Mini-Fit Jr vertical header | Molex | 39-28-1023 (5566-02A) | Connector_Molex:Molex_Mini-Fit_Jr_5566-02A_2x01_P4.20mm_Vertical | RS | 484-1883 | 5 | molex_5566_header.pdf | verified: SD-5566-002 hole 1.40, 4.20 x 5.50, h 12.8, mated 23.5
d34-pwr | Q1 | 1 |  | P-MOSFET -55 V, TO-220 (reverse-polarity switch) | Infineon | IRF4905PBF | Package_TO_SOT_THT:TO-220-3_Vertical | RS | 540-9799 | 1 | irf4905.pdf | verified: 1 G 2 D(tab) 3 S, VGS +-20 V; TO-220 16.51 + lead shoulder -> ~20.6 mm seated (p1, p8)
d34-pwr | DZ1 | 1 |  | Zener 15 V 0.5 W, DO-35 (P-FET gate clamp) | Nexperia | BZX79-C15,133 | Diode_THT:D_DO-35_SOD27_P7.62mm_Horizontal | RS | 136-4852 | 100 | bzx79.pdf | verified: Vz 13.8-15.6 V @ 5 mA; SOD27 4.25 x 1.85 mm (p5, p9)
d34-pwr | C9 C2 | 2 | 100n | 100 nF 50 V X7R radial MLCC | Murata | RDER71H104K0P1H03B | Capacitor_THT:C_Rect_L4.0mm_W2.5mm_P2.50mm | RS | 190-2933 | 10 | murata_rde.pdf | verified: size 0 = 4.0 W x 2.5 T x 6.0 H mm, lead 0.5, P1 = 2.5 mm (RDE p2); h incl. coating allowance
d34-pwr | R1 | 1 | 10k | Resistor, metal film MF0204, 0.4 W, 1 %, axial | Yageo | MF0204FTE52-10K | Resistor_THT:R_Axial_DIN0204_L3.6mm_D1.6mm_P7.62mm_Horizontal | RS | 199-7794 | 100 | yageo_mf0.pdf | verified: body 3.4+-0.3 x 1.9+-0.2 mm, lead 0.45 mm, M-forming P 6.0 mm (Yageo MF0 spec p3, p9)
d34-pwr | C1 C8 | 2 |  | 100 uF 50 V low-ESR electrolytic, 8 x 11.5 mm | Panasonic | EEU-FR1H101 | Capacitor_THT:CP_Radial_D8.0mm_P3.50mm | RS | 708-3894 | 10 | panasonic_fr.pdf | verified: 8 x 11.5 mm (L+1.5 max), F 3.5 mm, lead 0.6 mm, straight leads (FR p1, p6)
d34-pwr | D1 | 1 |  | TVS 600 W unidirectional 25.6 V Vwm, DO-15 | STMicroelectronics | P6KE30A | Diode_THT:D_DO-15_P12.70mm_Horizontal | RS | 485-9323 | 10 | p6ke.pdf | verified: VRM 26 V, VBR 28.5-31.5 V @ 1 mA, Vc 41.5 V @ 14.5 A; DO-15 6.75 x 3.53 mm, lead 0.88 max (ST p3, p6)
d34-pwr | F1 | 1 |  | PCB clip holder for MINI blade fuse (not stocked by RS) | Keystone | 3568 | Fuse:Fuseholder_Blade_Mini_Keystone_3568 | Farnell | 2504685 | 1 | keystone_3568.pdf | verified: 16.0 x 6.73 x 7.37 mm, four 1.60 mm holes on 9.9 x 3.40 (Keystone cat. p42); h = holder + fused blade (8.8 body over the clips, estimate)
d34-pwr | F2 | 1 |  | Resettable PTC 1.1 A hold, 72 V (aux 24 V branch) | Littelfuse | RXEF110 | d34:PTC_Radial_L13.0mm_W3.2mm_P5.08mm | RS | 517-6685 | 10 | littelfuse_rxef.pdf | verified: 1.10 A hold / 2.20 A trip, 72 V; 12.8 wide x 3.0 thick x 17.5 high max, spacing 4.3-5.8 (kinked), lead 0.81 (p2, p4, p6)
d34-pwr | J2 | 1 |  | 2-pole pluggable header; plug MSTB 2,5/2-ST-5,08 (1757019) | Phoenix Contact | MSTBVA 2,5/2-G-5,08 (1755736) | Connector_Phoenix_MSTB:PhoenixContact_MSTBVA_2,5_2-G-5,08_1x02_P5.08mm_Vertical | RS | 189-6199 | 5 | phoenix_mstbva.pdf | verified (Phoenix family sheet via mirror): pitch 5.08, hole 1.4, h 12, mated 22; plug reverse-insertion unverified
d34-pwr | U1 | 1 |  | 12 V 2 A SIP-3 buck (fans, relays, StepStick VMOT) | TRACO Power | TSR 2-24120N | Converter_DCDC:Converter_DCDC_TRACO_TSR2-24xxN_TSR2-24xxxN_THT | RS | 608-891 | 1 | tracopower_tsr2n.pdf | verified: Vin 15-36 V, pins 1 Vin 2 GND 3 Vout at 2.54, 14 x 7.6 x 10.2 + 0.5 standoff, pins 1.44 mm from one face, no traces under the body (p1-p4)
d34-pwr | U2 | 1 |  | 5 V 1 A SIP-3 buck (ESP32 DevKit) | TRACO Power | TSR 1-2450 | Converter_DCDC:Converter_DCDC_TRACO_TSR-1_THT | RS | 666-4379 | 1 | tracopower_tsr1.pdf | verified: Vin 6.5-36 V, +-2 %, 11.7 x 7.5 x 10.1 mm (+0.5 standoff), pins 1 Vin 2 GND 3 Vout; 22 uF/50 V input cap above 32 V (p1, p4)
d34-pwr | C3 C4 C5 | 3 |  | 22 uF 50 V electrolytic, 5 x 11 mm | Rubycon | 50YXF22M5X11 | Capacitor_THT:CP_Radial_D5.0mm_P2.00mm | RS | 224-4331 | 5 | rubycon_yxf.pdf | verified: 5 x 11 mm, 150 mA ripple (YXF p2); series marked obsolete by Rubycon but RS stock 1365 (2026-10-26); drop-in: Panasonic EEU-FR1H220 (FR p1, F 2.0 mm)
d34-pwr | J3 | 1 |  | 3-pin JST VH header | JST | B3P-VH(LF)(SN) | Connector_JST:JST_VH_B3P-VH_1x03_P3.96mm_Vertical | RS | 820-1150 | 5 | jst_vh.pdf | verified: eVH pitch 3.96, hole 1.65-1.75, h 10.9, mated 16.5
d34-pwr | U4 | 1 |  | 1x8 2.54 mm socket strip, 8.51 mm (2 per StepStick) | Samtec | SSW-108-01-T-S | d34:StepStick_Socket_2x8_W12.70mm | RS | 180-0422 | 10 | samtec_ssw.pdf; btt_tmc2209_v13_sch.pdf | verified: SSW 8.51 high; BTT V1.3 board 15.24 x 20.32, pinout from BTT schematic; heatsink height not published (estimate)
d34-pwr | J8 | 1 |  | 4-pin JST VH header | JST | B4P-VH(LF)(SN) | Connector_JST:JST_VH_B4P-VH_1x04_P3.96mm_Vertical | RS | 820-1157 | 5 | jst_vh.pdf | verified: eVH pitch 3.96, hole 1.65-1.75, h 10.9, mated 16.5
d34-pwr | J9 | 1 |  | 11-pin JST XH shrouded header | JST | B11B-XH-A(LF)(SN) | Connector_JST:JST_XH_B11B-XH-A_1x11_P2.50mm_Vertical | RS | 820-1535 | 10 | jst_xh.pdf | verified: eXH pitch 2.5, length 2.5(n-1)+4.9, h 7.0, hole 0.9-1.0, mated 9.8
d34-pwr | J4 J6 | 2 |  | 3-pin JST XH shrouded header | JST | B3B-XH-A(LF)(SN) | Connector_JST:JST_XH_B3B-XH-A_1x03_P2.50mm_Vertical | RS | 820-1557 | 5 | jst_xh.pdf | verified: eXH pitch 2.5, length 2.5(n-1)+4.9, h 7.0, hole 0.9-1.0, mated 9.8
d34-pwr | R3 | 1 | 4.7k | Resistor, metal film MF0204, 0.4 W, 1 %, axial | Yageo | MF0204FTE52-4K7 | Resistor_THT:R_Axial_DIN0204_L3.6mm_D1.6mm_P7.62mm_Horizontal | RS | 199-7830 | 100 | yageo_mf0.pdf | verified: body 3.4+-0.3 x 1.9+-0.2 mm, lead 0.45 mm, M-forming P 6.0 mm (Yageo MF0 spec p3, p9)
d34-pwr | (off-board) | 1 |  | BIGTREETECH TMC2209 V1.3 StepStick (plugs into U4 sockets) | BIGTREETECH | TMC2209 V1.3 |  | 3DJake UK | https://www.3djake.uk/bigtreetech/stepper-motor-driver |  | btt_tmc2209_v13_sch.pdf | PENDING
d34-pwr | (off-board) | 1 |  | MINI blade fuse 7.5 A 32 V (F1, DPS feed); RS sells it only in 50s | Littelfuse | 029707.5WXNV |  | Farnell | 9943854 | 5 | littelfuse_297.pdf | verified: 7.5 A, 32 VDC (Littelfuse 297 p1)
d34-pwr | (off-board) | 1 |  | Mini-Fit Jr receptacle housing 2-way (brick lead) | Molex | 39-01-2020 |  | RS | 484-1748 | 5 | molex_5557_housing.pdf
d34-pwr | (off-board) | 1 |  | Phoenix MSTB 2,5/2-ST-5,08 screw plug (DPS5005 input lead; no crimp) | Phoenix Contact | 1757019 |  | RS | 189-6010 | 5 | phoenix_mstb_st.pdf
d34-pwr | (off-board) | 2 |  | JST VH housing 3-way (12 V lead to tec card, both ends) | JST | VHR-3N |  | RS | 820-1175 | 5 | jst_vh.pdf
d34-pwr | (off-board) | 1 |  | JST VH housing 4-way (motor lead) | JST | VHR-4N |  | RS | 820-1179 | 5 | jst_vh.pdf
d34-pwr | (off-board) | 2 |  | JST XH housing 3-way (1-Wire bus A and bus B leads) | JST | XHP-3 |  | RS | 820-1614 | 5 | jst_xh.pdf
