aquarat/cat-feeder/electronics/d34/d34-tec/d34-tec-bom.csv

Board | References | Qty | Value | Description | Manufacturer | MPN | KiCad footprint | Supplier | Stock no | Pack | Datasheet | Checked
d34-tec | K1 K2 | 2 |  | DPDT relay 8 A, 12 V coil | Omron | G2RL-2 DC12 | Relay_THT:Relay_DPDT_Omron_G2RL-2 | RS | 365-0585 | 1 | omron_g2rl.pdf | verified: 29 x 12.7 x 15.7 max, 1.3 mm holes on the KiCad grid, 33.3 mA / 360 ohm, 8 A 30 VDC (p2, p6); RS title says "Aratas" but listing is Omron, check marking on arrival
d34-tec | D1 D7 D5 D8 | 4 |  | Schottky 20 V 1 A, DO-41, mounted vertical | onsemi | 1N5817RLG | Diode_THT:D_DO-41_SOD81_P2.54mm_Vertical_AnodeUp | RS | 625-4972 | 5 | 1n5817-19.pdf | verified: VF max 0.32 V @ 0.1 A, 0.45 V @ 1 A; 20 V; DO-41 (onsemi p2)
d34-tec | DZ2 | 1 |  | Zener 15 V 0.5 W, DO-35, mounted vertical (K1 fast-release clamp) | Nexperia | BZX79-C15,133 | Diode_THT:D_DO-35_SOD27_P2.54mm_Vertical_AnodeUp | RS | 136-4852 | 100 | bzx79.pdf | verified: Vz 13.8-15.6 V @ 5 mA; SOD27 4.25 x 1.85 mm (p5, p9)
d34-tec | J2 | 1 |  | 6-pin Mini-Fit Jr vertical header | Molex | 39-28-1063 (5566-06A) | Connector_Molex:Molex_Mini-Fit_Jr_5566-06A_2x03_P4.20mm_Vertical | RS | 484-1906 | 5 | molex_5566_header.pdf | verified: SD-5566-002 (as 2-pin)
d34-tec | J3 | 1 |  | 4-pin Mini-Fit Jr vertical header | Molex | 39-28-1043 (5566-04A) | Connector_Molex:Molex_Mini-Fit_Jr_5566-04A_2x02_P4.20mm_Vertical | RS | 484-1899 | 5 | molex_5566_header.pdf | verified: SD-5566-002 (as 2-pin)
d34-tec | J4 | 1 |  | 2-pin JST VH header | JST | B2P-VH(LF)(SN) | Connector_JST:JST_VH_B2P-VH_1x02_P3.96mm_Vertical | RS | 820-1147 | 5 | jst_vh.pdf | verified: eVH pitch 3.96, hole 1.65-1.75, h 10.9, mated 16.5
d34-tec | R1 R4 R6 R11 | 4 |  | Resistor, metal film MF0204, 0.4 W, 1 %, axial, mounted vertical (2.54 mm) | Yageo | MF0204FTE52-1K | Resistor_THT:R_Axial_DIN0204_L3.6mm_D1.6mm_P2.54mm_Vertical | RS | 199-7806 | 100 | yageo_mf0.pdf | verified: body 3.4+-0.3 x 1.9+-0.2 mm, lead 0.45 mm, M-forming P 6.0 mm (Yageo MF0 spec p3, p9)
d34-tec | R2 R13 | 2 |  | Resistor, metal film MF0204, 0.4 W, 1 %, axial, mounted vertical (2.54 mm) | Yageo | MF0204FTE52-330R | Resistor_THT:R_Axial_DIN0204_L3.6mm_D1.6mm_P2.54mm_Vertical | RS | 199-7821 | 100 | yageo_mf0.pdf | verified: body 3.4+-0.3 x 1.9+-0.2 mm, lead 0.45 mm, M-forming P 6.0 mm (Yageo MF0 spec p3, p9)
d34-tec | Q2 Q3 Q1 | 3 |  | NPN 40 V 200 mA, TO-92 | onsemi | 2N3904BU | Package_TO_SOT_THT:TO-92_Inline_Wide | RS | 843-1575 | 50 | 2n3904.pdf | verified: E-B-C facing the flat, straight leads 1.15-1.39 mm, body 5.2 x 4.2 x 5.33 (p1, p7); h incl. ~2.5 mm standoff
d34-tec | R5 R7 R9 R10 | 4 |  | Resistor, metal film MF0204, 0.4 W, 1 %, axial, mounted vertical (2.54 mm) | Yageo | MF0204FTE52-47K | Resistor_THT:R_Axial_DIN0204_L3.6mm_D1.6mm_P2.54mm_Vertical | RS | 199-7828 | 100 | yageo_mf0.pdf | verified: body 3.4+-0.3 x 1.9+-0.2 mm, lead 0.45 mm, M-forming P 6.0 mm (Yageo MF0 spec p3, p9)
d34-tec | R3 R15 | 2 |  | Resistor, metal film MF0204, 0.4 W, 1 %, axial, mounted vertical (2.54 mm) | Yageo | MF0204FTE52-4K7 | Resistor_THT:R_Axial_DIN0204_L3.6mm_D1.6mm_P2.54mm_Vertical | RS | 199-7830 | 100 | yageo_mf0.pdf | verified: body 3.4+-0.3 x 1.9+-0.2 mm, lead 0.45 mm, M-forming P 6.0 mm (Yageo MF0 spec p3, p9)
d34-tec | C1 | 1 |  | 220 uF 35 V low-ESR electrolytic, 8 x 11.5 mm (K2 hold-up) | Panasonic | EEU-FR1V221 | Capacitor_THT:CP_Radial_D8.0mm_P3.50mm | RS | 766-0078 | 10 | panasonic_fr.pdf | Panasonic FR (same 8 x 11.5 mm case/3.5 mm pitch as EEU-FR1H101 per FR p1/p6): 220 uF 35 V
d34-tec | F1 F2 F3 | 3 |  | Resettable PTC 0.5 A hold (per fan channel) | Littelfuse | RXEF050 | d34:PTC_Radial_L8.0mm_W3.2mm_P5.08mm | RS | 517-6635 | 10 | littelfuse_rxef.pdf | verified: 0.50 A hold / 1.00 A trip, 72 V, 7.9 wide x 3.0 thick x 13.7 high max, spacing 4.3-5.8, lead 0.51 (RXEF p2, p4, p6)
d34-tec | Q4 Q5 | 2 |  | Logic-level N-MOSFET, TO-220 (fan low side; survives a PTC-limited short) | Infineon | IRLZ44NPBF | Package_TO_SOT_THT:TO-220-3_Vertical | Farnell | 8651418 | 1 | irlz44n.pdf | Infineon datasheet saved: logic-level N-FET 55 V 47 A, VGS(th) 1.0-2.0 V, RDS(on) 35 mOhm at 4 V, TO-220 G-D-S (PDF text not machine-readable: values read from the Infineon table, cross-checked with Farnell listing)
d34-tec | J5 J6 J7 | 3 |  | 4-pin PC fan header | Molex | 47053-1000 | Connector:FanPinHeader_1x04_P2.54mm_Vertical | RS | 144-8185 | 10 | molex_47053.pdf | verified: SD-47053-001 pitch 2.54, holes 1.02, peg hole 1.25 (footprint corrected), pins 10.0 high
d34-tec | U1 | 1 |  | Shunt reference 2.495 V, TO-92 (12 V undervoltage cut-off for K1) | onsemi | TL431AILPG | Package_TO_SOT_THT:TO-92_Inline_Wide | RS | 774-3697 | 10 | tl431.pdf | verified: TO-92 pin 1 Reference, 2 Anode, 3 Cathode (onsemi TL431/D, case 29); Vref 2.495 V +-1 % (A grade)
d34-tec | Q6 | 1 |  | PNP 45 V 0.8 A, TO-92 (thermostat-loop supply switch) | onsemi | BC32725BU | Package_TO_SOT_THT:TO-92_Inline_Wide | RS | 765-315 | 100 | bc327.pdf | onsemi BC327: PNP -45 V -800 mA; TO-92 pin 1 C, 2 B, 3 E (case 29 style 17, as KiCad BC327); bulk leads splayed to 2.54 mm
d34-tec | R14 | 1 |  | Resistor, metal film MF0204, 0.4 W, 1 %, axial, mounted vertical (2.54 mm) | Yageo | MF0204FTE52-10K | Resistor_THT:R_Axial_DIN0204_L3.6mm_D1.6mm_P2.54mm_Vertical | RS | 199-7794 | 100 | yageo_mf0.pdf | verified: body 3.4+-0.3 x 1.9+-0.2 mm, lead 0.45 mm, M-forming P 6.0 mm (Yageo MF0 spec p3, p9)
d34-tec | J9 | 1 |  | 12-pin JST XH shrouded header | JST | B12B-XH-A(LF)(SN) | Connector_JST:JST_XH_B12B-XH-A_1x12_P2.50mm_Vertical | RS | 820-1539 | 10 | jst_xh.pdf | verified: eXH pitch 2.5, length 2.5(n-1)+4.9, h 7.0, hole 0.9-1.0, mated 9.8
d34-tec | J1 | 1 |  | 3-pin JST VH header | JST | B3P-VH(LF)(SN) | Connector_JST:JST_VH_B3P-VH_1x03_P3.96mm_Vertical | RS | 820-1150 | 5 | jst_vh.pdf | verified: eVH pitch 3.96, hole 1.65-1.75, h 10.9, mated 16.5
d34-tec | (off-board) | 1 |  | Reverse-brick ring snubber, resistor: 2.2 ohm MRS25, in series with a 1 uF 50 V MLCC (Murata RDER71H105K2P1H03B, from the C1u pack) across the Kycon inlet socket (+24 V pins 1/4 to 0 V pins 2/3), heat-shrunk | Vishay | MRS25000C2208FCT00 |  | RS | 683-3487 | 25 | mrs25.pdf | Vishay MRS25 2R2 0.6 W (off-board: no bend-pitch limit)
d34-tec | (off-board) | 1 |  | Mini-Fit Jr receptacle housing 4-way (TEC lead) | Molex | 39-01-2040 |  | RS | 484-1754 | 5 | molex_5557_housing.pdf
d34-tec | (off-board) | 1 |  | Mini-Fit Jr receptacle housing 6-way (DPS5005 output lead) | Molex | 39-01-2060 |  | RS | 484-1760 | 5 | molex_5557_housing.pdf
d34-tec | (off-board) | 6 |  | Molex Mini-Fit Jr pre-crimped lead, 225 mm 18 AWG, 39-00-0039-type socket one end, other end bare (W32 brick inlet 2 + W06 TEC feed 4); not stocked by RS | Molex | 215341-1113 |  | Farnell | 3559249 | 1 | molex_39000039.pdf | retailer data (Farnell listing)
d34-tec | (off-board) | 2 |  | Molex Mini-Fit Jr pre-crimped lead, 450 mm 18 AWG, one end bare (W05 DPS output, 290 mm needed: pins 1 and 4). Farnell showed 0 stock on 2026-10-26: if still out, use a 225 mm lead + soldered extension (heat-shrink RS 398-212) | Molex | 215341-1115 |  | Farnell | 3559251 | 1 | molex_39000039.pdf | retailer data (Farnell listing)
d34-tec | (off-board) | 1 |  | JST VH housing 2-way (thermostat loop lead) | JST | VHR-2N |  | RS | 820-1172 | 5 | jst_vh.pdf
d34-tec | (off-board) | 9 |  | JST VH pre-crimped lead, 300 mm 20 AWG, SVH contact both ends (3 for the 12 V link W03; motor W13 (4) and thermostat W23, W27 (2) cut near one end) | JST | 01SVHSVH-20L-300 |  | RS | 820-1135 | 5 | jst_vh.pdf | retailer data (RS listing)
d34-tec | (off-board) | 4 |  | Bimetal thermostat NC, opens 60 C / closes 45 C, 16 A, 250 V AC/DC (one per hot sink, wired in series) | RS PRO | T24A060ASF2-15 |  | RS | 222-8227 | 1 |  | RS product page only (no datasheet published): NC, opens 60 C / closes 45 C, 16 A 250 V AC/DC, 6.3 mm tabs assumed; switches only 12 V / 35 mA here. Size and tab width UNVERIFIED until parts arrive
