aquarat/cat-feeder/analysis/pcb-fit/cradle.stl

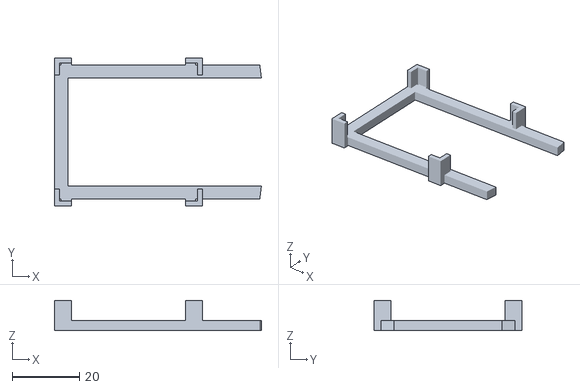
[picture p27: CAD file, 2026-11-01]
analysis/pcb-fit/cradle.stl
61.6 x 44.0 x 9.00
