aquarat/cat-feeder/electronics/d34/d34-ctrl/views/board-only.step

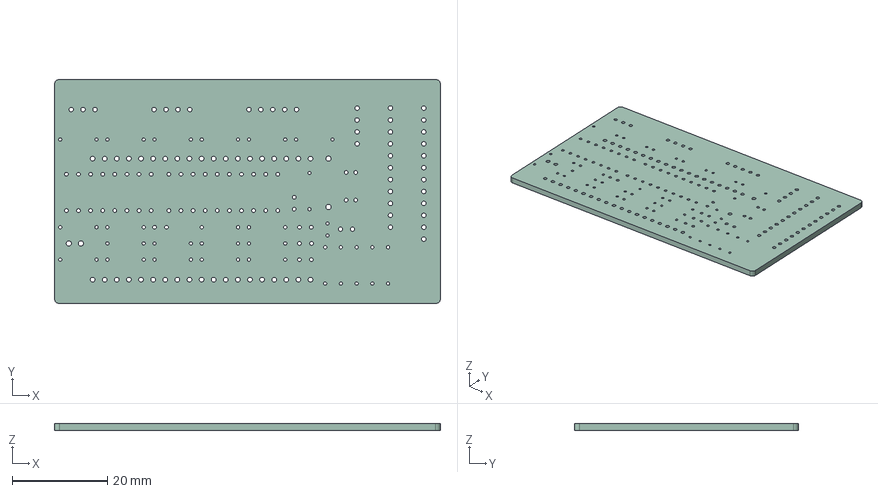
[picture p28: CAD file, 2026-11-01]
electronics/d34/d34-ctrl/views/board-only.step
81.0 x 47.0 x 1.51 mm
