aquarat/cat-feeder/electronics/d34/d34-pwr/views/board-only.step

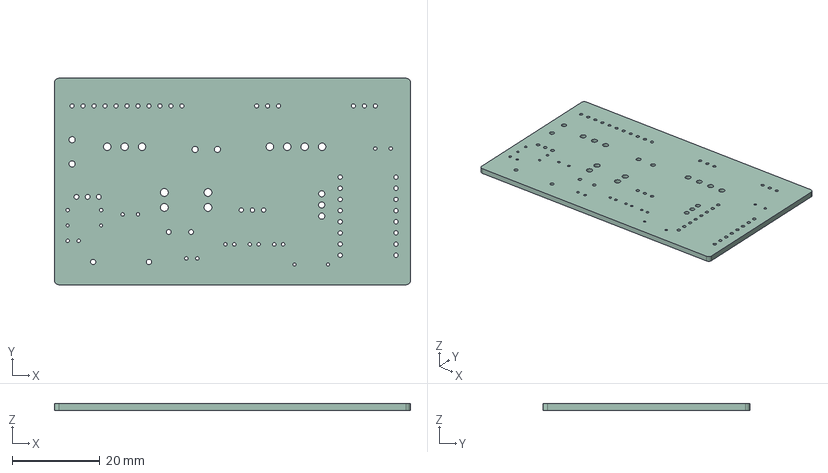
[picture p29: CAD file, 2026-11-01]
electronics/d34/d34-pwr/views/board-only.step
81.0 x 47.0 x 1.51 mm
