aquarat/cat-feeder/electronics/d34/d34-tec/views/board-only.step

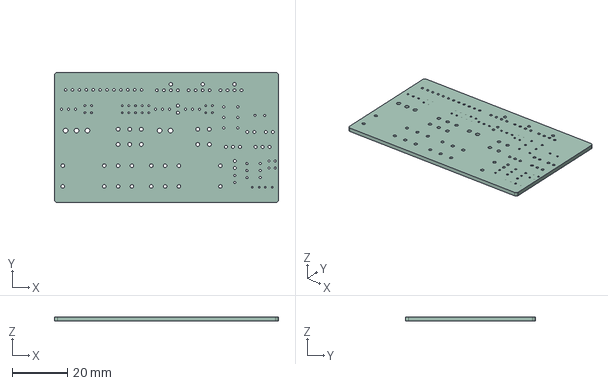
[picture p30: CAD file, 2026-11-01]
electronics/d34/d34-tec/views/board-only.step
81.0 x 47.0 x 1.51 mm
