aquarat/cat-feeder/electronics/pcb/views/board-envelope.stl

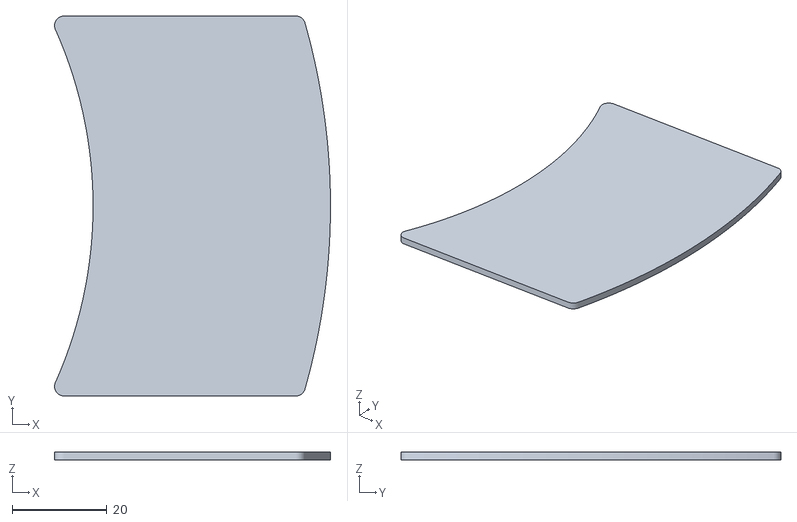
[picture p31: CAD file, 2026-11-01]
electronics/pcb/views/board-envelope.stl
58.1 x 80.0 x 1.60
