aquarat/cat-feeder/slicer/plates/07-lid-access-coupon-unsliced.3mf

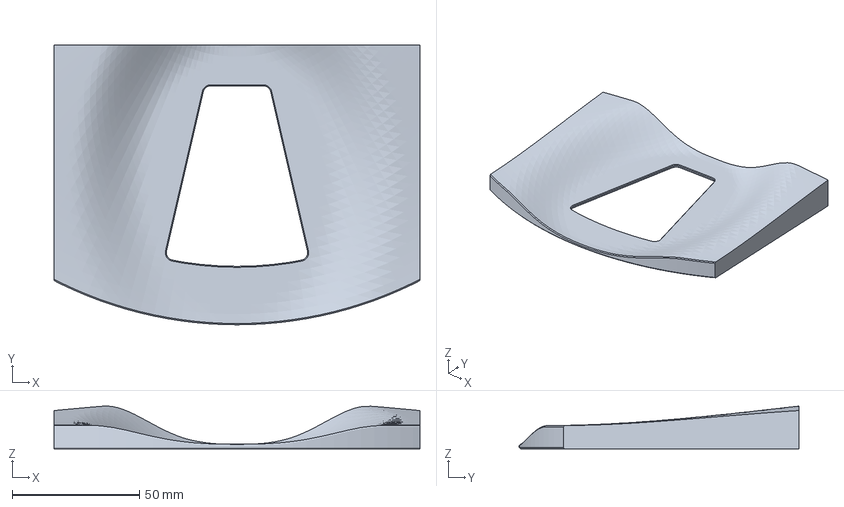
[picture p32: CAD file, 2026-11-01]
slicer/plates/07-lid-access-coupon-unsliced.3mf
144.0 x 110.0 x 16.8 mm
