aquarat/cat-feeder/analysis/pcb-fit/coupon.stl

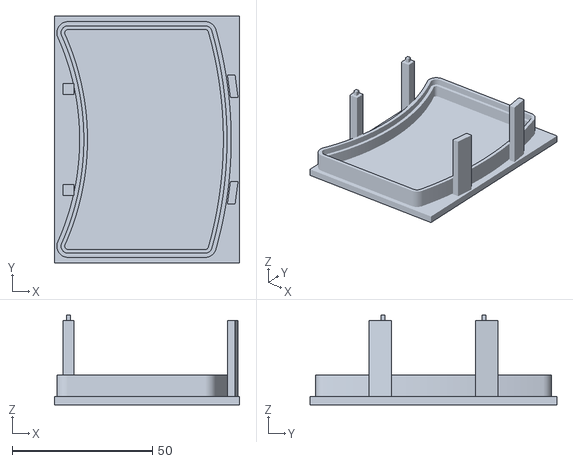
[picture p33: CAD file, 2026-11-01]
analysis/pcb-fit/coupon.stl
66.0 x 88.0 x 32.0
