aquarat/cat-feeder/electronics/pcb/views/board-only.step

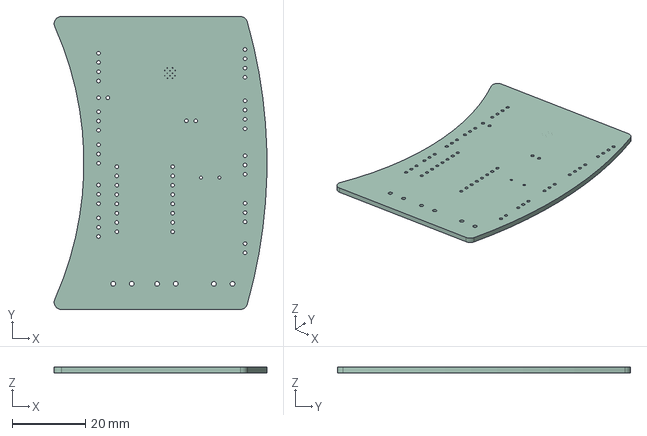
[picture p34: CAD file, 2026-11-01]
electronics/pcb/views/board-only.step
58.1 x 80.0 x 1.51 mm
