aquarat/cat-feeder/slicer/plates/09-fan-inlet-coupon-unsliced.3mf

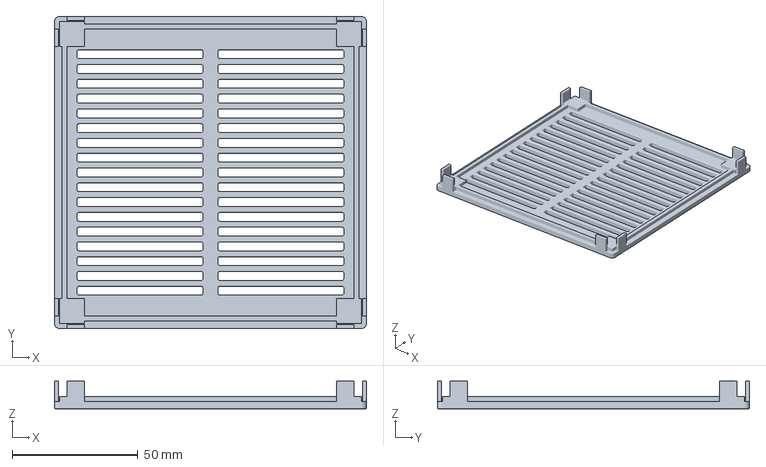
[picture p35: CAD file, 2026-11-01]
slicer/plates/09-fan-inlet-coupon-unsliced.3mf
124.0 x 124.0 x 11.0 mm
