aquarat/cat-feeder/analysis/pcb-fit/adapted-shell.stl

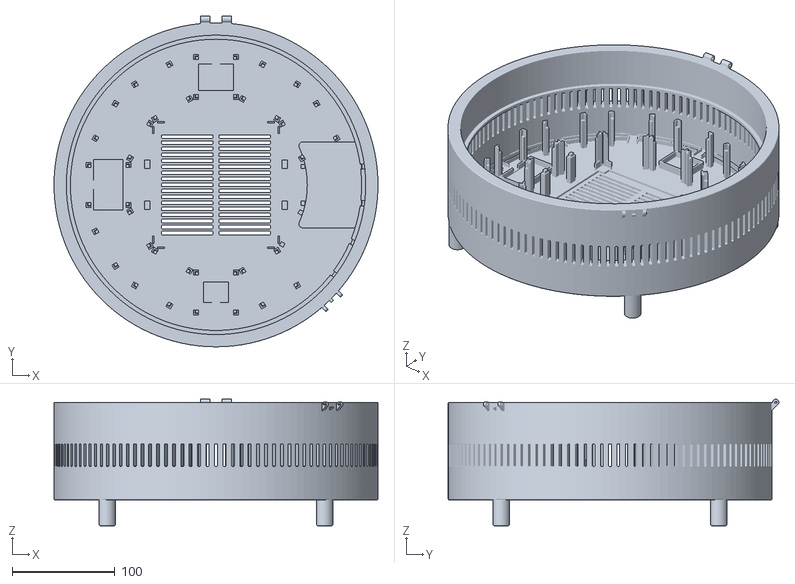
[picture p36: CAD file, 2026-11-01]
analysis/pcb-fit/adapted-shell.stl
316.0 x 322.5 x 123.5
