aquarat/cat-feeder/slicer/plates/02-closure-trials-unsliced.3mf

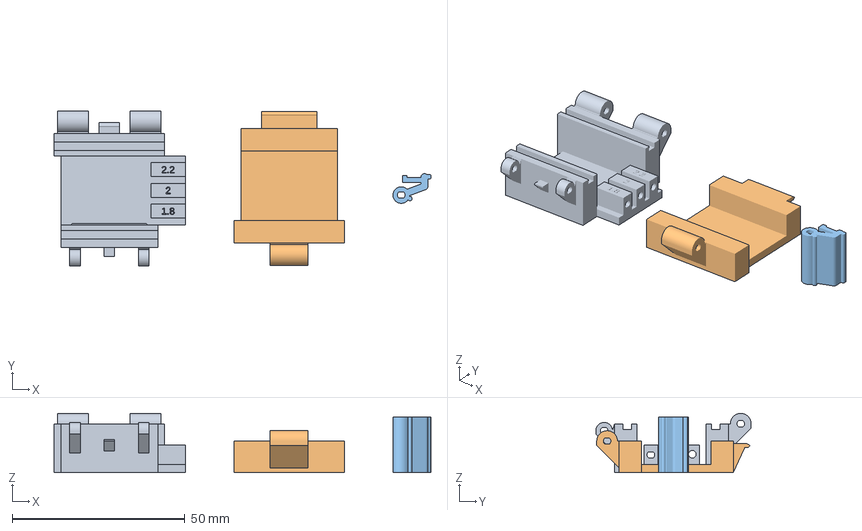
[picture p37: CAD file, 2026-11-01]
slicer/plates/02-closure-trials-unsliced.3mf
109.0 x 44.9 x 17.1 mm
closure_coupon_base
closure_coupon_lid
clip
