aquarat/cat-feeder/slicer/plates/06-deck-quarter-unsliced.3mf

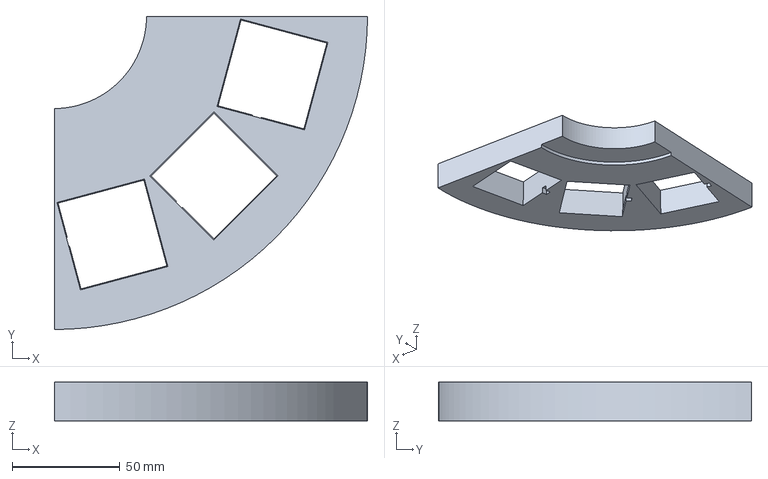
[picture p38: CAD file, 2026-11-01]
slicer/plates/06-deck-quarter-unsliced.3mf
145.2 x 145.2 x 18.0 mm
