aquarat/cat-feeder/slicer/plates/03-drive-unsliced.3mf

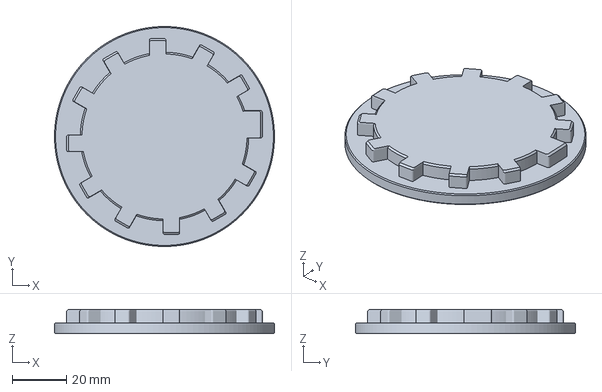
[picture p39: CAD file, 2026-11-01]
slicer/plates/03-drive-unsliced.3mf
81.0 x 81.0 x 9.00 mm
