aquarat/cat-feeder/slicer/plates/01-insulation-coupon-unsliced.3mf

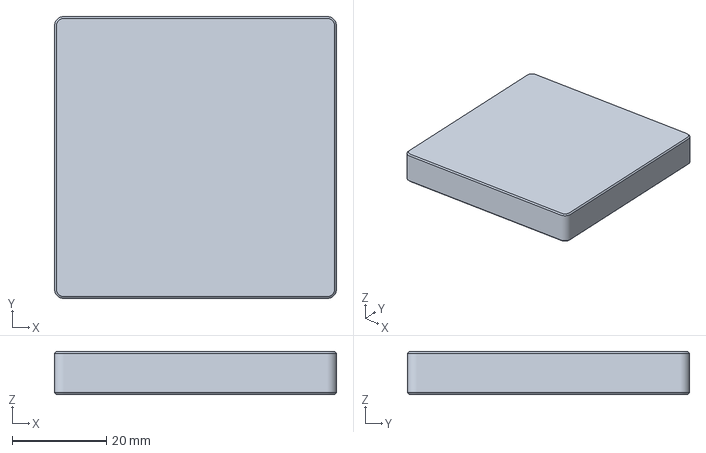
[picture p40: CAD file, 2026-11-01]
slicer/plates/01-insulation-coupon-unsliced.3mf
60.0 x 60.0 x 9.20 mm
