aquarat/cat-feeder/slicer/plates/05-tray-sector-unsliced.3mf

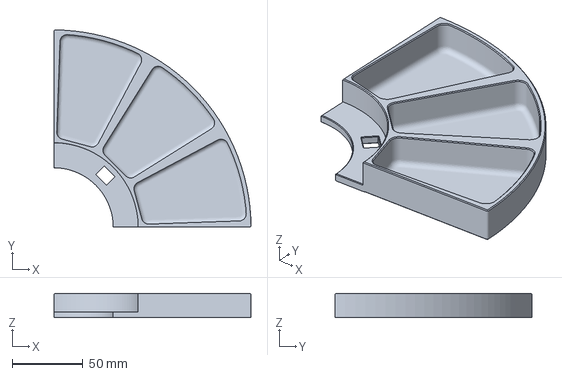
[picture p41: CAD file, 2026-11-01]
slicer/plates/05-tray-sector-unsliced.3mf
139.7 x 139.7 x 17.2 mm
