aquarat/cat-feeder/slicer/plates/04-hub-unsliced.3mf

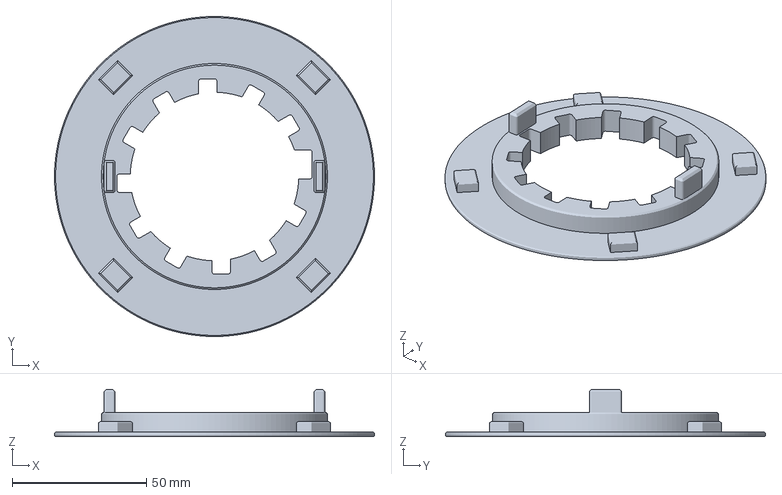
[picture p42: CAD file, 2026-11-01]
slicer/plates/04-hub-unsliced.3mf
119.0 x 119.0 x 17.5 mm
