aquarat/cat-feeder/slicer/plates/08-motor-bridge-unsliced.3mf

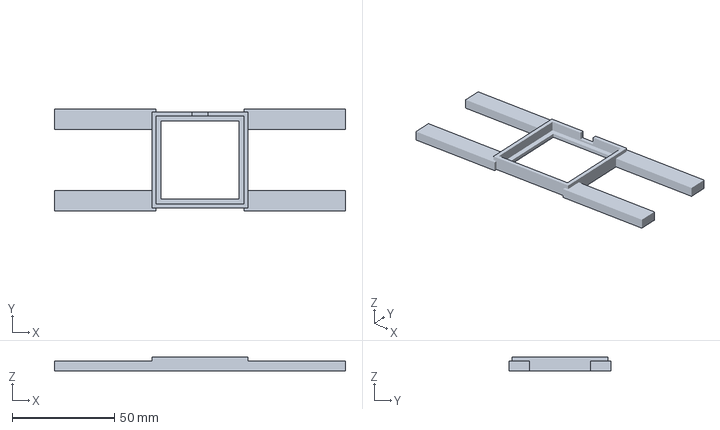
[picture p43: CAD file, 2026-11-01]
slicer/plates/08-motor-bridge-unsliced.3mf
142.0 x 50.0 x 6.80 mm
