aquarat/cat-feeder/cad/generated/d34_cards_data.scad

// GENERATED by scripts/gen_d34_cards.py from electronics/d34 KiCad boards. Do not edit.
// parts3d.json: 15443e0fba8d646bb6061306e301bd260f5613923a9f9f92007c34077bc78a0b
// card: [name, [length, height], thickness, parts, connectors, solder boxes]
// part: [ref, kind, shape, [u0,v0,u1,v1], w0, w1, colour, source]
// connector: [ref, kind, family, [u0,v0,u1,v1], header_h, plug_top, engage, pinch, [u,v] exit, pins, straight, exit w, exit dir [du,dv,dw]]
d34_card_models = [["d34-ctrl",[81,47],1.6,[["R10","R","box",[1.15,36.95,8.87,38.65],0,2.1,"Tan","parts3d:datasheet"],["J4","XH4","box",[18.4,3.9,30.9,9.75],0,7,"WhiteSmoke","parts3d:datasheet"],["D9","BAT42V","box",[50.35,33.35,53.99,35.45],0,6.5,"DimGray","parts3d:estimate"],["R1","R470","box",[1.15,30.15,8.87,31.85],0,2.1,"Tan","parts3d:estimate"],["J3","XH3","box",[1,3.9,11,9.75],0,7,"WhiteSmoke","parts3d:datasheet"],["R19","R","box",[40.75,11.75,48.47,13.45],0,2.1,"Tan","parts3d:datasheet"],["R2","R","box",[11.05,30.15,18.77,31.85],0,2.1,"Tan","parts3d:datasheet"],["R23","R","box",[62.55,35.15,64.25,42.87],0,2.1,"Tan","parts3d:datasheet"],["R15","R","box",[1.15,11.75,8.87,13.45],0,2.1,"Tan","parts3d:datasheet"],["C1","CP22u","cyl",[59.45,16.75,64.95,22.25],0,12.5,"MidnightBlue","parts3d:datasheet"],["R7","R","box",[20.95,33.55,28.67,35.25],0,2.1,"Tan","parts3d:datasheet"],["J2","XH12","box",[74.05,3.5,79.9,36],0,7,"WhiteSmoke","parts3d:datasheet"],["R25","R","box",[69.15,35.15,70.85,42.87],0,2.1,"Tan","parts3d:datasheet"],["U3","HC573","box",[22.68,20.46,48.18,26.91],0,5.1,"Black","parts3d:datasheet"],["C5","C1u","box",[49.8,36.12,55.5,39.48],0,6.5,"Goldenrod","parts3d:datasheet"],["J6","XH5","box",[38.3,3.9,53.3,9.75],0,7,"WhiteSmoke","parts3d:datasheet"],["R22","R","box",[59.25,35.15,60.95,42.87],0,2.1,"Tan","parts3d:datasheet"],["R26","R470V","box",[56.45,29.35,58.15,32.79],0,6.5,"Tan","parts3d:estimate"],["D3","LED_G","cyl",[59.32,29.45,63.22,33.35],0,6.4,"Lime","parts3d:datasheet"],["R9","R","box",[40.75,33.55,48.47,35.25],0,2.1,"Tan","parts3d:datasheet"],["R3","R","box",[52.65,19.55,54.35,27.27],0,2.1,"Tan","parts3d:datasheet"],["C7","C100n","box",[49,23.9,51.6,28],0,6.5,"Goldenrod","parts3d:datasheet"],["R12","R","box",[20.95,36.95,28.67,38.65],0,2.1,"Tan","parts3d:datasheet"],["R20","R","box",[50.65,11.75,58.37,13.45],0,2.1,"Tan","parts3d:datasheet"],["R18","R","box",[30.85,11.75,38.57,13.45],0,2.1,"Tan","parts3d:datasheet"],["R14","R","box",[40.75,36.95,48.47,38.65],0,2.1,"Tan","parts3d:datasheet"],["R8","R","box",[30.85,33.55,38.57,35.25],0,2.1,"Tan","parts3d:datasheet"],["R13","R","box",[30.85,36.95,38.57,38.65],0,2.1,"Tan","parts3d:datasheet"],["D1","D_5817","box",[56.1,16.55,58.9,26.81],0,3,"DimGray","parts3d:datasheet"],["U1-0","DEVKIT","box",[6.73,40.73,54.99,43.27],0,8.5,"Black","parts3d:estimate"],["U1-1","DEVKIT","box",[6.73,15.33,54.99,17.87],0,8.5,"Black","parts3d:estimate"],["U1-2","DEVKIT","box",[0.71,15.33,55.01,43.27],8.5,11,"DarkGreen","parts3d:estimate"],["U1-3","DEVKIT","box",[0.71,15.33,55.01,43.27],11,12.6,"DarkGreen","parts3d:estimate"],["U1-4","DEVKIT","box",[0.71,15.33,55.01,43.27],12.6,16,"DarkGreen","parts3d:estimate"],["R6","R","box",[11.05,33.55,18.77,35.25],0,2.1,"Tan","parts3d:datasheet"],["R5","R","box",[40.75,30.15,48.47,31.85],0,2.1,"Tan","parts3d:datasheet"],["U2","HC123","box",[1.18,20.46,21.6,26.91],0,4.5,"Black","parts3d:datasheet"],["R24","R","box",[65.85,35.15,67.55,42.87],0,2.1,"Tan","parts3d:datasheet"],["R11","R","box",[11.05,36.95,18.77,38.65],0,2.1,"Tan","parts3d:datasheet"],["C2","CP22u","cyl",[59.45,22.55,64.95,28.05],0,12.5,"MidnightBlue","parts3d:datasheet"],["C4","C1u","box",[49.8,29.32,55.5,32.67],0,6.5,"Goldenrod","parts3d:datasheet"],["R17","R","box",[20.95,11.75,28.67,13.45],0,2.1,"Tan","parts3d:datasheet"],["D2","D_5817V","box",[1.6,33,5.59,35.8],0,8,"DimGray","parts3d:estimate"],["R16","R","box",[11.05,11.75,18.77,13.45],0,2.1,"Tan","parts3d:datasheet"],["C6","C100n","box",[20.2,29.7,24.3,32.3],0,6.5,"Goldenrod","parts3d:datasheet"],["R4","R","box",[30.85,30.15,38.57,31.85],0,2.1,"Tan","parts3d:datasheet"],["J1","XH11","box",[67.05,3.5,72.9,33.5],0,7,"WhiteSmoke","parts3d:datasheet"],["R21","R","box",[55.95,35.15,57.65,42.87],0,2.1,"Tan","parts3d:datasheet"],["J11","XH4","box",[60.05,3.5,65.9,16],0,7,"WhiteSmoke","parts3d:datasheet"]],[["J4","XH4","JST XH",[18.4,3.9,30.9,9.75],7,9.8,6,"v",[24.65,6.825],4,3,9.8,[0,0,1]],["J3","XH3","JST XH",[1,3.9,11,9.75],7,9.8,6,"v",[6,6.825],3,3,9.8,[0,0,1]],["J2","XH12","JST XH",[74.05,3.5,79.9,36],7,9.8,6,"u",[76.97,19.75],12,3,9.8,[0,0,1]],["J6","XH5","JST XH",[38.3,3.9,53.3,9.75],7,9.8,6,"v",[45.8,6.825],5,3,9.8,[0,0,1]],["J1","XH11","JST XH",[67.05,3.5,72.9,33.5],7,9.8,6,"u",[69.97,18.5],11,3,9.8,[0,0,1]],["J11","XH4","JST XH",[60.05,3.5,65.9,16],7,9.8,6,"u",[62.98,9.75],4,3,9.8,[0,0,1]]],[[[0.5,37.1,9.52,38.5],-4.1,-1.6],[[19.93,5.325,29.38,7.275],-4.1,-1.6],[[50.6,33.6,54.74,35.2],-4.1,-1.6],[[0.5,30.3,9.52,31.7],-4.1,-1.6],[[2.525,5.325,9.475,7.275],-4.1,-1.6],[[40.1,11.9,49.12,13.3],-4.1,-1.6],[[10.4,30.3,19.42,31.7],-4.1,-1.6],[[62.7,34.5,64.1,43.52],-4.1,-1.6],[[0.5,11.9,9.52,13.3],-4.1,-1.6],[[60.4,18.7,64,20.3],-4.1,-1.6],[[20.3,33.7,29.32,35.1],-4.1,-1.6],[[76.53,5.025,78.47,34.48],-4.1,-1.6],[[69.3,34.5,70.7,43.52],-4.1,-1.6],[[23.2,19.08,47.66,28.3],-4.1,-1.6],[[50.65,37.05,54.65,38.55],-4.1,-1.6],[[39.83,5.325,51.77,7.275],-4.1,-1.6],[[59.4,34.5,60.8,43.52],-4.1,-1.6],[[56.6,29.5,58,33.44],-4.1,-1.6],[[59.1,30.5,63.44,32.3],-4.1,-1.6],[[40.1,33.7,49.12,35.1],-4.1,-1.6],[[52.8,18.9,54.2,27.92],-4.1,-1.6],[[49.5,23.9,51.1,28],-4.1,-1.6],[[20.3,37.1,29.32,38.5],-4.1,-1.6],[[50,11.9,59.02,13.3],-4.1,-1.6],[[30.2,11.9,39.22,13.3],-4.1,-1.6],[[40.1,37.1,49.12,38.5],-4.1,-1.6],[[30.2,33.7,39.22,35.1],-4.1,-1.6],[[30.2,37.1,39.22,38.5],-4.1,-1.6],[[56.4,15.5,58.6,27.86],-4.1,-1.6],[[7.15,15.75,54.57,42.85],-3.2,-1.6],[[10.4,33.7,19.42,35.1],-4.1,-1.6],[[40.1,30.3,49.12,31.7],-4.1,-1.6],[[1.7,19.08,21.08,28.3],-4.1,-1.6],[[66,34.5,67.4,43.52],-4.1,-1.6],[[10.4,37.1,19.42,38.5],-4.1,-1.6],[[60.4,24.5,64,26.1],-4.1,-1.6],[[50.65,30.25,54.65,31.75],-4.1,-1.6],[[20.3,11.9,29.32,13.3],-4.1,-1.6],[[1.9,33.3,6.64,35.5],-4.1,-1.6],[[10.4,11.9,19.42,13.3],-4.1,-1.6],[[20.2,30.2,24.3,31.8],-4.1,-1.6],[[30.2,30.3,39.22,31.7],-4.1,-1.6],[[69.53,5.025,71.47,31.98],-4.1,-1.6],[[56.1,34.5,57.5,43.52],-4.1,-1.6],[[62.52,5.025,64.47,14.47],-4.1,-1.6]]],["d34-pwr",[81,47],1.6,[["C1","CP100u","cyl",[13,26.75,21.5,35.25],0,13,"MidnightBlue","parts3d:datasheet"],["J1","MF2","box",[1.25,10.7,7.1,22.15],0,12.8,"WhiteSmoke","parts3d:datasheet"],["C9","C100n","box",[2.2,35.7,6.3,38.3],0,6.5,"Goldenrod","parts3d:datasheet"],["R3","R","box",[54.55,41.55,62.27,43.25],0,2.1,"Tan","parts3d:datasheet"],["J3","VH3","box",[10,11.85,21.92,20.45],0,10.9,"WhiteSmoke","parts3d:datasheet"],["J9","XH11","box",[1.5,3.9,31.5,9.75],0,7,"WhiteSmoke","parts3d:datasheet"],["C2","C100n","box",[29.2,39.7,33.3,42.3],0,6.5,"Goldenrod","parts3d:datasheet"],["F1","FUSE_MINI","box",[21.91,24.28,38.01,31.12],0,16.3,"Orange","parts3d:estimate"],["F2","PTC","box",[21.99,33.35,35.09,36.65],0,17.5,"Orange","parts3d:datasheet"],["U4-0","STEPSTICK","box",[63.73,21.23,66.27,41.55],0,8.5,"Black","parts3d:estimate"],["U4-1","STEPSTICK","box",[76.43,21.23,78.97,41.55],0,8.5,"Black","parts3d:estimate"],["U4-2","STEPSTICK","box",[63.73,21.23,78.97,41.55],8.5,12.6,"DarkGreen","parts3d:estimate"],["U4-3","STEPSTICK","box",[63.73,21.23,78.97,41.55],12.6,22,"DarkGreen","parts3d:estimate"],["J2","MSTBVA2","box",[28.41,11.35,40.67,20.05],0,12,"WhiteSmoke","parts3d:datasheet"],["J8","VH4","box",[47,11.85,62.88,20.45],0,10.9,"WhiteSmoke","parts3d:datasheet"],["Q1","IRF4905","box",[2.49,23.8,12.59,28.3],0,20.6,"Black","parts3d:datasheet"],["J6","XH3","box",[65.5,3.9,75.5,9.75],0,7,"WhiteSmoke","parts3d:datasheet"],["C4","CP22u","cyl",[42.7,35.05,48.2,40.55],0,12.5,"MidnightBlue","parts3d:datasheet"],["D1","TVS30","box",[8.75,39.95,21.55,43.65],0,3.6,"DimGray","parts3d:datasheet"],["U1","TSR12","box",[54.59,21.79,62.29,35.89],0,10.7,"Black","parts3d:datasheet"],["C3","CP22u","cyl",[37.15,35.05,42.65,40.55],0,12.5,"MidnightBlue","parts3d:datasheet"],["R1","R","box",[2.95,32.65,10.67,34.35],0,2.1,"Tan","parts3d:datasheet"],["U2","TSR5","box",[39.15,24.35,50.95,32.05],0,10.6,"Black","parts3d:datasheet"],["J4","XH3","box",[43.5,3.9,53.5,9.75],0,7,"WhiteSmoke","parts3d:datasheet"],["C8","CP100u","cyl",[70.5,11.75,79,20.25],0,13,"MidnightBlue","parts3d:datasheet"],["C5","CP22u","cyl",[48.25,35.05,53.75,40.55],0,12.5,"MidnightBlue","parts3d:datasheet"],["DZ1","DZ15S","box",[2.95,28.95,10.67,31.05],0,2,"Gray","parts3d:datasheet"]],[["J1","MF2","Molex Mini-Fit Jr",[1.25,10.7,7.1,22.15],12.8,23.5,8.5,"u",[4.175,16.43],2,5,23.5,[0,0,1]],["J3","VH3","JST VH",[10,11.85,21.92,20.45],10.9,16.5,8,"v",[15.96,16.15],3,4,16.5,[0,0,1]],["J9","XH11","JST XH",[1.5,3.9,31.5,9.75],7,9.8,6,"v",[16.5,6.825],11,3,9.8,[0,0,1]],["J2","MSTBVA2","Phoenix MSTB 5.08",[28.41,11.35,40.67,20.05],12,22,9,"v",[34.54,10.85],2,6,16,[0,-1,0]],["J8","VH4","JST VH",[47,11.85,62.88,20.45],10.9,16.5,8,"v",[54.94,16.15],4,4,16.5,[0,0,1]],["J6","XH3","JST XH",[65.5,3.9,75.5,9.75],7,9.8,6,"v",[70.5,6.825],3,3,9.8,[0,0,1]],["J4","XH3","JST XH",[43.5,3.9,53.5,9.75],7,9.8,6,"v",[48.5,6.825],3,3,9.8,[0,0,1]]],[[[14.7,30.2,19.8,31.8],-4.1,-1.6],[[2.35,12.35,5.65,21.15],-4.1,-1.6],[[2.2,36.2,6.3,37.8],-4.1,-1.6],[[53.9,41.7,62.92,43.1],-4.1,-1.6],[[10.65,14.25,21.27,16.95],-4.1,-1.6],[[3.025,5.325,29.98,7.275],-4.1,-1.6],[[29.2,40.2,33.3,41.8],-4.1,-1.6],[[23.61,24.61,36.31,30.79],-4.1,-1.6],[[25.05,34.05,32.03,35.95],-4.1,-1.6],[[64.15,21.65,78.55,41.13],-3.2,-1.6],[[30.2,14.4,38.88,18],-4.1,-1.6],[[47.65,14.25,62.23,16.95],-4.1,-1.6],[[4,26,11.08,28],-4.1,-1.6],[[67.03,5.325,73.97,7.275],-4.1,-1.6],[[43.65,37,47.25,38.6],-4.1,-1.6],[[7.6,40.6,22.7,43],-4.1,-1.6],[[59.8,25.3,61.8,32.38],-4.1,-1.6],[[38.1,37,41.7,38.6],-4.1,-1.6],[[2.3,32.8,11.32,34.2],-4.1,-1.6],[[41.25,28.75,48.83,31.25],-4.1,-1.6],[[45.02,5.325,51.98,7.275],-4.1,-1.6],[[72.2,15.2,77.3,16.8],-4.1,-1.6],[[49.2,37,52.8,38.6],-4.1,-1.6],[[2.2,29.2,11.42,30.8],-4.1,-1.6]]],["d34-tec",[81,47],1.6,[["J1","VH3","box",[2,17.25,13.92,25.85],0,10.9,"WhiteSmoke","parts3d:datasheet"],["R4","RV","box",[10.15,11.15,11.85,14.59],0,6.5,"Tan","parts3d:estimate"],["J7","FAN4","box",[58.7,3.85,68.9,9.75],0,10,"WhiteSmoke","parts3d:datasheet"],["F3","PTC050","box",[59.69,18.35,67.79,21.65],0,13.7,"Orange","parts3d:estimate"],["Q6","BC327","box",[71.87,32.93,76.2,37.99],0,8,"Black","parts3d:estimate"],["J2","MF6","box",[19.9,17.85,34.15,29.3],0,12.8,"WhiteSmoke","parts3d:datasheet"],["J9","XH12","box",[1.5,3.9,34,9.75],0,7,"WhiteSmoke","parts3d:datasheet"],["R10","RV","box",[30.85,11.15,32.55,14.59],0,6.5,"Tan","parts3d:estimate"],["R11","RV","box",[76.75,31.15,78.45,34.59],0,6.5,"Tan","parts3d:estimate"],["C1","CP220u","box",[70.2,11.45,78.3,19.55],0,13,"MidnightBlue","parts3d:estimate"],["Q5","IRLZ44N","box",[70.19,23.7,80.29,28.2],0,20.6,"Black","parts3d:estimate"],["R3","RV","box",[33.25,11.15,34.95,14.59],0,6.5,"Tan","parts3d:estimate"],["D5","D_5817V","box",[69.65,20.1,73.64,22.9],0,8,"DimGray","parts3d:estimate"],["J6","FAN4","box",[47.2,3.85,57.4,9.75],0,10,"WhiteSmoke","parts3d:datasheet"],["R2","RV","box",[56.25,11.15,57.95,14.59],0,6.5,"Tan","parts3d:estimate"],["U1","TL431","box",[67.07,32.93,71.4,37.99],0,8,"Black","parts3d:estimate"],["R13","RV","box",[78.95,31.15,80.65,34.59],0,6.5,"Tan","parts3d:estimate"],["R1","RV","box",[53.85,11.15,55.55,14.59],0,6.5,"Tan","parts3d:estimate"],["Q2","2N3904","box",[2.51,10.77,7.57,15.1],0,8,"Black","parts3d:datasheet"],["J3","MF4","box",[48.7,17.85,58.75,29.3],0,12.8,"WhiteSmoke","parts3d:datasheet"],["D7","D_5817V","box",[43.2,10.6,46,14.59],0,8,"DimGray","parts3d:estimate"],["Q4","IRLZ44N","box",[59.49,23.7,69.59,28.2],0,20.6,"Black","parts3d:estimate"],["R14","RV","box",[70.65,40.65,74.09,42.35],0,6.5,"Tan","parts3d:estimate"],["D1","D_5817V","box",[63.8,30.6,66.6,34.59],0,8,"DimGray","parts3d:estimate"],["R9","RV","box",[28.45,11.15,30.15,14.59],0,6.5,"Tan","parts3d:estimate"],["DZ2","DZ15V","box",[64.15,36.15,66.25,39.79],0,6.5,"Gray","parts3d:estimate"],["D8","D_5817V","box",[75,20.1,78.99,22.9],0,8,"DimGray","parts3d:estimate"],["K1","G2RL2","box",[0.65,31.15,29.55,43.75],0,15.7,"SteelBlue","parts3d:datasheet"],["R15","RV","box",[75.35,40.65,78.79,42.35],0,6.5,"Tan","parts3d:estimate"],["K2","G2RL2","box",[33.45,31.15,62.35,43.75],0,15.7,"SteelBlue","parts3d:datasheet"],["R5","RV","box",[12.55,11.15,14.25,14.59],0,6.5,"Tan","parts3d:estimate"],["J4","VH2","box",[36,17.25,43.96,25.85],0,10.9,"WhiteSmoke","parts3d:datasheet"],["F2","PTC050","box",[59.69,14.55,67.79,17.85],0,13.7,"Orange","parts3d:estimate"],["R6","RV","box",[23.65,11.15,25.35,14.59],0,6.5,"Tan","parts3d:estimate"],["J5","FAN4","box",[35.7,3.85,45.9,9.75],0,10,"WhiteSmoke","parts3d:datasheet"],["Q3","2N3904","box",[47.41,10.77,52.47,15.1],0,8,"Black","parts3d:datasheet"],["F1","PTC050","box",[59.69,10.75,67.79,14.05],0,13.7,"Orange","parts3d:estimate"],["R7","RV","box",[26.05,11.15,27.75,14.59],0,6.5,"Tan","parts3d:estimate"],["Q1","2N3904","box",[36.51,10.77,41.57,15.1],0,8,"Black","parts3d:datasheet"]],[["J1","VH3","JST VH",[2,17.25,13.92,25.85],10.9,16.5,8,"v",[7.96,21.55],3,4,16.5,[0,0,1]],["J7","FAN4","PC fan 4-pin (KK 254)",[58.7,3.85,68.9,9.75],10,15.2,6.5,"v",[63.8,6.8],5,3,15.2,[0,0,1]],["J2","MF6","Molex Mini-Fit Jr",[19.9,17.85,34.15,29.3],12.8,23.5,8.5,"v",[27.02,23.57],6,5,23.5,[0,0,1]],["J9","XH12","JST XH",[1.5,3.9,34,9.75],7,9.8,6,"v",[17.75,6.825],12,3,9.8,[0,0,1]],["J6","FAN4","PC fan 4-pin (KK 254)",[47.2,3.85,57.4,9.75],10,15.2,6.5,"v",[52.3,6.8],5,3,15.2,[0,0,1]],["J3","MF4","Molex Mini-Fit Jr",[48.7,17.85,58.75,29.3],12.8,23.5,8.5,"u",[53.73,23.57],4,5,23.5,[0,0,1]],["J4","VH2","JST VH",[36,17.25,43.96,25.85],10.9,16.5,8,"u",[39.98,21.55],2,4,16.5,[0,0,1]],["J5","FAN4","PC fan 4-pin (KK 254)",[35.7,3.85,45.9,9.75],10,15.2,6.5,"v",[40.8,6.8],5,3,15.2,[0,0,1]]],[[[2.65,19.65,13.27,22.35],-4.1,-1.6],[[10.3,11.3,11.7,15.24],-4.1,-1.6],[[58.98,5.385,68.64,7.415],-4.1,-1.6],[[60.45,19.25,67.03,20.75],-4.1,-1.6],[[73.65,32.17,75.15,38.75],-4.1,-1.6],[[21.35,18.85,33.05,27.65],-4.1,-1.6],[[3.025,5.325,32.48,7.275],-4.1,-1.6],[[31,11.3,32.4,15.24],-4.1,-1.6],[[76.9,31.3,78.3,35.24],-4.1,-1.6],[[71.7,14.7,76.8,16.3],-4.1,-1.6],[[71.7,25.9,78.78,27.9],-4.1,-1.6],[[33.4,11.3,34.8,15.24],-4.1,-1.6],[[68.6,20.4,73.34,22.6],-4.1,-1.6],[[47.48,5.385,57.13,7.415],-4.1,-1.6],[[56.4,11.3,57.8,15.24],-4.1,-1.6],[[68.85,32.17,70.35,38.75],-4.1,-1.6],[[79.1,31.3,80.5,35.24],-4.1,-1.6],[[54,11.3,55.4,15.24],-4.1,-1.6],[[1.75,12.55,8.33,14.05],-4.1,-1.6],[[50.15,18.85,57.65,27.65],-4.1,-1.6],[[43.5,10.9,45.7,15.64],-4.1,-1.6],[[61,25.9,68.08,27.9],-4.1,-1.6],[[70.8,40.8,74.74,42.2],-4.1,-1.6],[[64.1,30.9,66.3,35.64],-4.1,-1.6],[[28.6,11.3,30,15.24],-4.1,-1.6],[[64.4,36.4,66,40.54],-4.1,-1.6],[[75.3,20.4,80.04,22.6],-4.1,-1.6],[[2,32.7,29,42.2],-4.1,-1.6],[[75.5,40.8,79.44,42.2],-4.1,-1.6],[[34,32.7,61,42.2],-4.1,-1.6],[[12.7,11.3,14.1,15.24],-4.1,-1.6],[[36.65,19.65,43.31,22.35],-4.1,-1.6],[[60.45,15.45,67.03,16.95],-4.1,-1.6],[[23.8,11.3,25.2,15.24],-4.1,-1.6],[[35.98,5.385,45.63,7.415],-4.1,-1.6],[[46.65,12.55,53.23,14.05],-4.1,-1.6],[[60.45,11.65,67.03,13.15],-4.1,-1.6],[[26.2,11.3,27.6,15.24],-4.1,-1.6],[[35.75,12.55,42.33,14.05],-4.1,-1.6]]]];
