aquarat/cat-feeder/cad/generated/harness_routes.scad

// GENERATED by scripts/harness.py from cad/harness.json. Do not edit.
// [id, colour, bundle dia, zone, filleted centreline]
harness_routes = [["W01", "Orange", 4.1, "hot", [[105.16, 63.48, 56.5], [104.7, 63.02, 56.5], [103.3, 62.11, 56.62], [101.68, 61.87, 56.96], [74.93, 63.86, 64.04], [73.31, 63.62, 64.38], [71.91, 62.72, 64.5], [51.27, 42.07, 64.5], [-42.07, -51.27, 64.5], [-62.97, -72.17, 64.5], [-63.76, -73.29, 64.55], [-64.09, -74.61, 64.7], [-65.77, -98.38, 67.98], [-66.1, -99.7, 68.12], [-66.89, -100.83, 68.17], [-67.35, -101.29, 68.17]]], ["W02", "Gold", 4.21, "hot", [[110.07, 58.5, 55.25], [109.64, 58.07, 55.25], [107.83, 56.43, 56.13], [106.69, 55.73, 58.36], [102.55, 55.24, 76.78], [101.18, 55.57, 79.04], [98.83, 56.54, 79.84], [84.95, 62.94, 79.08], [83.53, 63.47, 78.71], [82.28, 63.68, 77.81], [74.77, 63.94, 70.12], [73.18, 63.55, 68.94], [71.59, 62.39, 68.5], [52.41, 43.21, 68.5], [51.57, 41.95, 68.5], [51.29, 40.46, 68.5], [52.0, 0.07, 68.5], [52.0, 0.0, 68.5], [52.0, -0.07, 68.5], [51.29, -40.46, 68.5], [51.57, -41.95, 68.5], [52.41, -43.21, 68.5], [72.24, -63.05, 68.5], [73.28, -63.79, 68.5], [74.51, -64.14, 68.48], [97.67, -66.68, 68.19], [98.9, -67.03, 68.18], [99.94, -67.77, 68.17], [100.37, -68.2, 68.17]]], ["W03", "Red", 4.74, "hot", [[-62.01, -96.71, 58.85], [-61.06, -95.76, 58.85], [-59.86, -94.07, 58.91], [-59.31, -92.07, 59.09], [-59.47, -90.02, 59.37], [-62.89, -76.74, 61.48], [-63.05, -74.68, 61.76], [-62.5, -72.69, 61.94], [-61.3, -70.99, 62.0], [-43.39, -53.07, 62.0], [-41.66, -51.87, 62.0], [-39.62, -51.34, 62.0], [1.87, -48.01, 62.0], [2.0, -48.0, 62.0], [2.13, -47.98, 62.0], [48.6, -42.19, 62.0], [51.29, -42.47, 62.0], [53.59, -43.9, 62.0], [70.44, -60.76, 62.0], [72.46, -62.11, 61.84], [74.82, -62.58, 61.4], [77.11, -62.08, 60.74], [94.76, -54.08, 54.71], [97.05, -53.58, 54.05], [99.4, -54.05, 53.61], [101.42, -55.4, 53.45], [102.37, -56.35, 53.45]]], ["W04", "DarkRed", 5.5, "hot", [[-77.39, -85.81, 67.2], [-77.37, -85.83, 71.82], [-77.26, -85.3, 74.61], [-76.97, -83.79, 77.01], [-76.53, -81.51, 78.66], [-76.01, -78.8, 79.32], [-73.62, -66.26, 79.9], [-72.88, -64.16, 79.97], [-71.55, -62.36, 80.0], [-53.57, -44.38, 80.0], [-52.34, -42.75, 80.0], [-51.59, -40.85, 80.0], [-51.38, -38.81, 80.0], [-52.74, -0.26, 80.0], [-52.75, 0.0, 80.0], [-52.74, 0.26, 80.0], [-51.38, 38.81, 80.0], [-51.59, 40.85, 80.0], [-52.34, 42.75, 80.0], [-53.57, 44.38, 80.0], [-58.25, 49.06, 80.0], [-60.15, 50.6, 79.68], [-62.19, 51.63, 78.76], [-64.16, 52.02, 77.33], [-65.84, 51.74, 75.56], [-67.06, 50.82, 73.62], [-68.63, 48.8, 70.37], [-69.84, 47.88, 68.44], [-71.53, 47.6, 66.66], [-73.49, 47.99, 65.24], [-75.54, 49.02, 64.32], [-77.43, 50.56, 64.0], [-78.1, 51.23, 64.0]]], ["W05", "Firebrick", 5.06, "hot", [[-70.83, 58.81, 64.0], [-66.82, 54.8, 64], [-53.1, 41.08, 64.0], [-52.67, 40.67, 64.0], [-52.21, 40.3, 64.0], [52.21, -40.3, 64.0], [52.67, -40.67, 64.0], [53.1, -41.08, 64.0], [62.96, -50.94, 64.0], [64.57, -52.42, 63.76], [66.23, -53.67, 63.03], [67.84, -54.63, 61.88], [77.41, -59.53, 53.55], [79.01, -60.49, 52.4], [80.67, -61.75, 51.67], [82.29, -63.22, 51.43], [83.83, -64.76, 51.43]]], ["W06", "Crimson", 6.11, "hot", [[64.57, -83.28, 51.43], [63.4, -82.11, 51.43], [62.0, -80.56, 51.65], [60.81, -78.95, 52.29], [59.91, -77.35, 53.32], [55.08, -67.31, 61.11], [54.18, -65.71, 62.14], [52.99, -64.1, 62.78], [51.59, -62.55, 63.0], [41.39, -52.35, 63.0], [41.19, -52.15, 63.0], [40.99, -51.94, 63.02], [29.7, -40.31, 64]]], ["W07", "Crimson", 5.06, "hot", [[29.7, -40.31, 64], [-40.31, 29.7, 64]]], ["W08", "IndianRed", 4.18, "hot", [[12.0, -77.41, 85.7], [12.0, -43.6, 85.7], [12.0, -40.69, 85.12], [12.0, -38.23, 83.47], [12.0, -36.58, 81.01], [12.0, -36.0, 78.1], [12.0, -36.0, 75.5], [12.36, -36.09, 73.16], [13.4, -36.34, 71.04], [15.03, -36.74, 69.36], [17.07, -37.23, 68.28], [29.7, -40.31, 64]]], ["W09", "IndianRed", 4.18, "hot", [[77.41, -12.0, 85.7], [43.6, -12.0, 85.7], [40.69, -12.0, 85.12], [38.23, -12.0, 83.47], [36.58, -12.0, 81.01], [36.0, -12.0, 78.1], [36.0, -12.0, 76.19], [35.9, -12.43, 73.64], [35.63, -13.67, 71.39], [35.21, -15.57, 69.69], [34.68, -17.92, 68.75], [29.7, -40.31, 64]]], ["W10", "IndianRed", 4.18, "hot", [[-12.0, 77.41, 85.7], [-12.0, 43.6, 85.7], [-12.0, 40.69, 85.12], [-12.0, 38.23, 83.47], [-12.0, 36.58, 81.01], [-12.0, 36.0, 78.1], [-12.0, 36.0, 76.19], [-12.43, 35.9, 73.64], [-13.67, 35.63, 71.39], [-15.57, 35.21, 69.69], [-17.92, 34.68, 68.75], [-40.31, 29.7, 64]]], ["W11", "IndianRed", 4.18, "hot", [[-77.41, 12.0, 85.7], [-43.6, 12.0, 85.7], [-40.69, 12.0, 85.12], [-38.23, 12.0, 83.47], [-36.58, 12.0, 81.01], [-36.0, 12.0, 78.1], [-36.0, 12.0, 75.5], [-36.09, 12.36, 73.16], [-36.34, 13.4, 71.04], [-36.74, 15.03, 69.36], [-37.23, 17.07, 68.28], [-40.31, 29.7, 64]]], ["W12", "Purple", 2.25, "hot", [[-48.84, 82.78, 66.0], [-47.02, 80.96, 66.0], [-45.4, 78.9, 66.23], [-44.35, 76.58, 66.91], [-43.97, 74.19, 67.97], [-44.29, 71.95, 69.33], [-45.28, 70.05, 70.86], [-46.86, 68.65, 72.44], [-47.58, 68.22, 73.05], [-49.16, 66.81, 74.64], [-50.15, 64.91, 76.17], [-50.47, 62.67, 77.53], [-50.09, 60.29, 78.59], [-49.04, 57.96, 79.27], [-47.41, 55.9, 79.5], [-45.2, 53.69, 79.5], [-43.24, 52.2, 79.5], [-40.95, 51.3, 79.5], [-38.5, 51.06, 79.5], [-0.34, 52.49, 79.5], [0.0, 52.49, 79.5], [0.34, 52.49, 79.5], [38.5, 51.06, 79.5], [40.95, 51.3, 79.5], [43.24, 52.2, 79.5], [45.2, 53.69, 79.5], [60.43, 68.91, 79.5], [62.38, 70.43, 79.35], [64.61, 71.4, 78.9], [66.96, 71.76, 78.2], [69.24, 71.47, 77.29], [90.94, 65.41, 67.46], [93.22, 65.12, 66.55], [95.57, 65.47, 65.85], [97.8, 66.44, 65.4], [99.75, 67.96, 65.25], [100.87, 69.08, 65.25]]], ["W13", "SteelBlue", 3.45, "hot", [[0.0, -30.02, 77.0], [0.0, -31.01, 77.0], [-0.54, -33.33, 77.04], [-2.06, -35.16, 77.16], [-12.26, -42.89, 77.94], [-13.11, -43.41, 78.0], [-14.05, -43.76, 78.05], [-40.72, -50.9, 79.43], [-41.98, -51.42, 79.48], [-43.06, -52.25, 79.5], [-61.38, -70.57, 79.5], [-63.07, -71.82, 79.19], [-64.92, -72.43, 78.33], [-66.61, -72.28, 77.04], [-83.39, -66.49, 61.31], [-85.08, -66.34, 60.02], [-86.93, -66.95, 59.16], [-88.62, -68.2, 58.85], [-90.03, -69.6, 58.85]]], ["W14", "DimGray", 3.72, "hot", [[52.33, -52.33, 57.16], [52.33, -52.33, 57.52], [52.3, -52.88, 59.96], [52.24, -54.44, 61.91], [52.15, -56.69, 62.99], [52.07, -58.7, 63.44], [52.47, -60.99, 63.85], [53.76, -62.95, 64.0], [63.05, -72.24, 64.0], [64.06, -73.07, 64.09], [65.18, -73.68, 64.34], [77.69, -78.82, 67.86], [78.82, -79.42, 68.11], [79.83, -80.25, 68.2], [80.43, -80.85, 68.2]]], ["W15", "Black", 3.08, "cold", [[-44.0, -113.4, 105.0], [-43.99, -115.35, 104.3], [-43.98, -117.25, 102.4], [-43.98, -117.95, 99.8], [-43.98, -117.95, 81.2], [-44.2, -117.28, 78.6], [-44.8, -115.48, 76.7], [-45.61, -113.01, 76.0], [-47.79, -106.4, 76.0]]], ["W16", "DarkSlateGray", 2.25, "hot", [[-54.54, -85.83, 76.0], [-54.72, -85.28, 76.0], [-55.05, -84.12, 76.07], [-55.29, -82.95, 76.27], [-57.24, -71.01, 78.97], [-57.24, -68.18, 79.52], [-56.35, -65.46, 79.88], [-54.65, -63.14, 80.0], [-45.2, -53.69, 80.0], [-43.24, -52.2, 80.0], [-40.95, -51.3, 80.0], [-38.5, -51.06, 80.0], [-0.34, -52.49, 80.0], [-0.0, -52.49, 80.0], [0.34, -52.49, 80.0], [38.5, -51.06, 80.0], [40.95, -51.3, 80.0], [43.24, -52.2, 80.0], [45.2, -53.69, 80.0], [61.58, -70.07, 80.0], [63.2, -71.89, 79.7], [64.48, -73.78, 78.82], [65.34, -75.61, 77.44], [67.94, -82.84, 70.76], [68.8, -84.67, 69.38], [70.08, -86.56, 68.5], [71.7, -88.38, 68.2], [72.81, -89.5, 68.2]]], ["W17", "Cyan", 3.5, "cold", [[37.09, 59.36, 76.95], [36.91, 59.16, 74.26], [36.35, 58.59, 71.64], [35.44, 57.67, 69.22], [34.22, 56.44, 67.1], [32.72, 54.93, 65.36], [31.01, 53.22, 64.07], [29.16, 51.36, 63.27], [27.23, 49.43, 63.0], [26.2, 48.4, 63.0]]], ["W18", "DarkCyan", 2.25, "hot", [[11.01, 33.22, 63.0], [10.6, 32.8, 63.0], [9.88, 31.99, 63.0], [9.26, 31.1, 63.0], [-19.8, -16.97, 63]]], ["W19", "Cyan", 3.5, "cold", [[41.3, -58.98, 76.95], [41.11, -58.79, 74.26], [40.54, -58.22, 71.64], [39.63, -57.31, 69.22], [38.4, -56.08, 67.1], [36.9, -54.58, 65.36], [35.19, -52.86, 64.07], [33.33, -51.01, 63.27], [31.4, -49.08, 63.0], [30.09, -47.77, 63.0]]], ["W20", "DarkCyan", 2.25, "hot", [[14.9, -32.58, 63.0], [14.49, -32.17, 63.0], [13.15, -31.07, 63.0], [11.63, -30.24, 63.0], [-19.8, -16.97, 63]]], ["W21", "Teal", 3.32, "hot", [[39.3, 87.34, 65.0], [39.3, 86.29, 65.0], [39.57, 84.81, 65.02], [40.34, 83.52, 65.06], [53.63, 68.36, 65.85], [54.57, 66.5, 65.92], [54.5, 64.42, 65.98], [53.43, 62.63, 66.0], [42.07, 51.27, 66], [-51.27, -42.07, 66], [-72.32, -63.12, 66.0], [-73.24, -63.87, 66.12], [-74.26, -64.38, 66.45], [-89.8, -70.0, 73]]], ["W22", "Teal", 3.0, "hot", [[-120.26, -42.35, 51.8], [-120.27, -42.35, 60.22], [-120.03, -42.56, 62.96], [-119.34, -43.19, 65.55], [-118.23, -44.19, 67.86], [-116.75, -45.51, 69.77], [-114.98, -47.1, 71.18], [-113.02, -48.85, 72.01], [-110.97, -50.68, 72.21], [-108.95, -52.5, 71.79], [-108.38, -53.01, 71.58], [-106.81, -54.41, 71.19], [-105.23, -55.85, 71.19], [-89.8, -70.0, 73]]], ["W23", "White", 1.7, "hot", [[80.8, -80.07, 53.45], [78.78, -78.05, 53.45], [76.8, -76.58, 53.95], [74.79, -75.99, 55.32], [73.23, -76.41, 57.24], [66.7, -81.39, 68.39], [66.64, -81.44, 68.5], [66.58, -81.48, 68.61], [60.32, -86.07, 80.34], [58.77, -87.21, 82.06], [56.74, -88.7, 82.62], [54.75, -90.16, 81.88], [53.31, -91.21, 80.02], [52.78, -91.6, 77.67]]], ["W24", "White", 1.7, "hot", [[52.78, -91.6, 77.67], [53.12, -91.03, 80.04], [54.07, -89.48, 81.9], [55.37, -87.35, 82.62], [56.68, -85.19, 82.02], [57.67, -83.57, 80.25], [62.75, -75.23, 64.8], [62.97, -73.78, 62.86], [62.27, -71.89, 61.49], [60.82, -70.01, 61.0], [43.82, -53.01, 61.0], [42.61, -51.08, 61.0], [42.36, -48.82, 61.0], [47.99, -0.1, 61.0], [48.0, 0.0, 61.0], [48.01, 0.1, 61.0], [51.12, 40.19, 61.0], [51.57, 41.93, 61.0], [52.6, 43.41, 61.0], [61.12, 51.93, 61.0], [63.28, 53.48, 61.59], [65.42, 53.99, 63.19], [82.87, 53.19, 81.08], [84.89, 53.09, 82.36], [87.27, 52.98, 82.56], [89.48, 52.88, 81.66], [91.04, 52.81, 79.85], [91.6, 52.78, 77.67]]], ["W25", "White", 1.7, "hot", [[91.6, 52.78, 77.67], [91.16, 53.17, 79.91], [89.92, 54.25, 81.74], [88.19, 55.77, 82.59], [86.37, 57.38, 82.26], [71.05, 70.84, 74.2], [70.69, 71.19, 74.02], [70.34, 71.58, 73.88], [55.32, 89.56, 68.5], [54.01, 91.13, 67.52], [53.1, 92.21, 65.74], [52.78, 92.6, 63.67]]], ["W26", "White", 1.7, "hot", [[52.78, 92.6, 63.67], [52.8, 92.05, 65.84], [52.87, 90.5, 67.65], [52.97, 88.31, 68.56], [53.08, 85.94, 68.37], [53.99, 65.55, 61.74], [53.63, 63.44, 61.19], [52.41, 61.6, 61.0], [42.07, 51.27, 61], [-51.27, -42.07, 61], [-61.7, -52.5, 61.0], [-63.42, -53.69, 61.21], [-65.38, -54.14, 61.81], [-87.08, -54.63, 70.15], [-89.5, -54.68, 70.46], [-91.79, -54.73, 69.6], [-93.41, -54.77, 67.77], [-94.0, -54.78, 65.55]]], ["W27", "White", 1.7, "hot", [[-94.0, -54.78, 65.55], [-93.41, -54.77, 67.77], [-91.79, -54.73, 69.6], [-89.5, -54.68, 70.46], [-87.08, -54.63, 70.15], [-65.5, -54.14, 61.85], [-63.43, -54.55, 61.22], [-61.61, -55.77, 61.0], [-57.7, -59.68, 61.0], [-55.41, -61.0, 61.0], [-52.77, -61.0, 61.0], [-50.49, -59.68, 61.0], [-43.41, -52.6, 61.0], [-41.93, -51.57, 61.0], [-40.19, -51.12, 61.0], [-0.1, -48.01, 61.0], [-0.0, -48.0, 61.0], [0.1, -47.99, 61.0], [48.82, -42.36, 61.0], [51.08, -42.61, 61.0], [53.01, -43.82, 61.0], [71.93, -62.73, 61.0], [72.99, -64.05, 60.78], [73.68, -65.47, 60.13], [77.02, -75.31, 54.32], [77.72, -76.73, 53.67], [78.78, -78.04, 53.45], [80.8, -80.07, 53.45]]], ["W28", "Pink", 2.09, "hot", [[40.76, -137.59, 79.16], [41.01, -137.51, 78.1], [41.73, -137.27, 76.9], [44.68, -136.31, 73.59], [46.21, -135.24, 72.29], [47.44, -133.35, 72.02], [47.92, -131.3, 72.89], [48.07, -120.12, 81.03], [48.31, -118.78, 81.75], [48.98, -117.41, 82.0], [63.15, -95.51, 82.0], [63.54, -94.72, 81.98], [63.74, -93.86, 81.91], [66.25, -72.54, 79.69], [66.07, -70.85, 79.55], [65.16, -69.4, 79.5], [45.84, -50.08, 79.5], [44.94, -48.65, 79.5], [44.75, -46.97, 79.5], [49.97, -0.26, 79.5], [49.99, 0.0, 79.5], [49.99, 0.26, 79.5], [48.83, 42.91, 79.5], [49.1, 44.42, 79.5], [49.95, 45.7, 79.5], [68.49, 64.25, 79.5], [69.61, 66.56, 79.28], [69.03, 69.0, 78.73], [58.82, 84.31, 74.03], [58.21, 86.19, 73.37], [58.75, 88.04, 72.56], [60.25, 89.29, 71.85], [71.23, 94.09, 68.42], [71.98, 94.51, 68.24], [72.65, 95.06, 68.17], [73.83, 96.24, 68.17]]], ["W29", "HotPink", 2.82, "hot", [[54.92, -132.58, 78.79], [54.93, -132.58, 76.87], [54.88, -131.91, 74.7], [54.75, -130.13, 73.31], [54.57, -127.87, 73.18], [52.74, -104.48, 79.02], [52.77, -103.59, 79.2], [53.0, -102.71, 79.29], [63.47, -75.13, 80.41], [63.64, -72.98, 80.47], [62.61, -71.09, 80.5], [43.71, -52.19, 80.5], [42.81, -50.77, 80.5], [42.62, -49.11, 80.5], [47.99, 1.94, 80.5], [48.0, 2.0, 80.5], [48.0, 2.06, 80.5], [50.81, 41.01, 80.5], [51.14, 42.32, 80.5], [51.91, 43.43, 80.5], [72.09, 63.6, 80.5], [72.8, 64.33, 80.36], [73.45, 65.01, 79.96], [86.24, 78.7, 68.72], [86.89, 79.39, 68.31], [87.61, 80.11, 68.17], [88.52, 81.03, 68.17]]], ["W30", "Blue", 2.09, "hot", [[46.45, 127.61, 39.34], [46.45, 127.61, 40.01], [46.59, 127.31, 42.32], [46.99, 126.45, 44.45], [47.63, 125.09, 46.24], [49.34, 121.46, 49.83], [49.42, 121.28, 50.0], [49.5, 121.12, 50.18], [54.92, 110.54, 62.1], [55.79, 108.65, 63.63], [56.67, 106.37, 64.47], [59.41, 98.7, 65.93], [60.67, 96.42, 66.42], [62.58, 94.66, 66.92], [64.96, 93.6, 67.39], [67.57, 93.34, 67.77], [70.14, 93.91, 68.03], [72.42, 95.25, 68.14], [73.83, 96.24, 68.17]]], ["W31", "Lime", 2.25, "hot", [[24.96, 31.47, 100.58], [24.96, 31.47, 83.3], [25.75, 32.25, 80.61], [27.65, 34.15, 79.5], [63.83, 70.33, 79.5], [64.82, 71.97, 79.33], [64.92, 73.83, 78.85], [58.37, 104.75, 68.82], [58.47, 106.61, 68.35], [59.46, 108.25, 68.17], [60.58, 109.37, 68.17]]], ["W32", "Maroon", 5.06, "hot", [[-55.08, -129.76, 42.0], [-51.61, -121.8, 42.0], [-50.91, -119.17, 41.97], [-51.0, -116.45, 41.87], [-53.85, -101.11, 41.17], [-53.98, -98.71, 41.12], [-53.5, -96.35, 41.18], [-52.43, -94.2, 41.35], [-51.97, -93.52, 41.42], [-50.28, -91.4, 42.03], [-48.44, -89.76, 43.3], [-46.6, -88.75, 45.12], [-44.94, -88.47, 47.32], [-44.93, -88.47, 47.33], [-43.59, -88.94, 49.93], [-42.91, -90.1, 52.57], [-42.96, -91.83, 54.98], [-43.74, -93.94, 56.9], [-45.16, -96.23, 58.14], [-47.08, -98.45, 58.57], [-48.61, -99.98, 58.57]]], ["W33", "DarkCyan", 2.25, "hot", [[-19.8, -16.97, 63], [-50.87, -41.76, 63.0], [-51.26, -42.08, 63.0], [-51.62, -42.43, 63.0], [-72.36, -63.17, 63.0], [-73.19, -63.97, 63.07], [-74.04, -64.73, 63.29], [-87.83, -76.64, 67.89], [-88.68, -77.4, 68.1], [-89.51, -78.2, 68.17], [-90.63, -79.32, 68.17]]], ["W34", "Teal", 2.25, "hot", [[-89.8, -70.0, 73], [-90.32, -66.91, 72.23], [-91.17, -64.38, 71.51], [-92.77, -62.25, 70.71], [-94.96, -60.75, 69.93], [-97.54, -60.0, 69.22], [-100.25, -60.09, 68.66], [-102.85, -61.0, 68.3], [-105.08, -62.65, 68.17], [-106.19, -63.76, 68.17]]]];
// [name, end a, end b, dia]
// card connectors used by a lead; others are modelled unmated (spare)
harness_used_ports = ["d34-ctrl:J1", "d34-ctrl:J11", "d34-ctrl:J2", "d34-ctrl:J3", "d34-ctrl:J4", "d34-ctrl:J6", "d34-pwr:J1", "d34-pwr:J2", "d34-pwr:J3", "d34-pwr:J4", "d34-pwr:J6", "d34-pwr:J8", "d34-pwr:J9", "d34-tec:J1", "d34-tec:J2", "d34-tec:J3", "d34-tec:J4", "d34-tec:J5", "d34-tec:J6", "d34-tec:J9"];
harness_inline = [["BLOWER_IL", [-48.37, -104.65, 76], [-54.09, -87.19, 76], 7.5], ["CHAMBER_IL", [24.75, 46.95, 63], [12.02, 34.22, 63], 7.5], ["FOOD_IL", [28.64, -46.32, 63], [15.91, -33.59, 63], 7.5], ["JT1", [31.47, -42.07, 64], [27.93, -38.54, 64], 11], ["JT2", [-42.07, 31.47, 64], [-38.54, 27.93, 64], 11]];
