aquarat/cat-feeder/(list of files, cad)

Other CAD files:
slicer/plates/11-pcb-mount-coupon-unsliced.3mf
slicer/plates/10-pcb-cradle-unsliced.3mf
analysis/pcb-fit/shell-fixture.scad
