aquarat/cat-feeder/electronics/d34/sim/results/s06_dps_tec/defrost_make.png

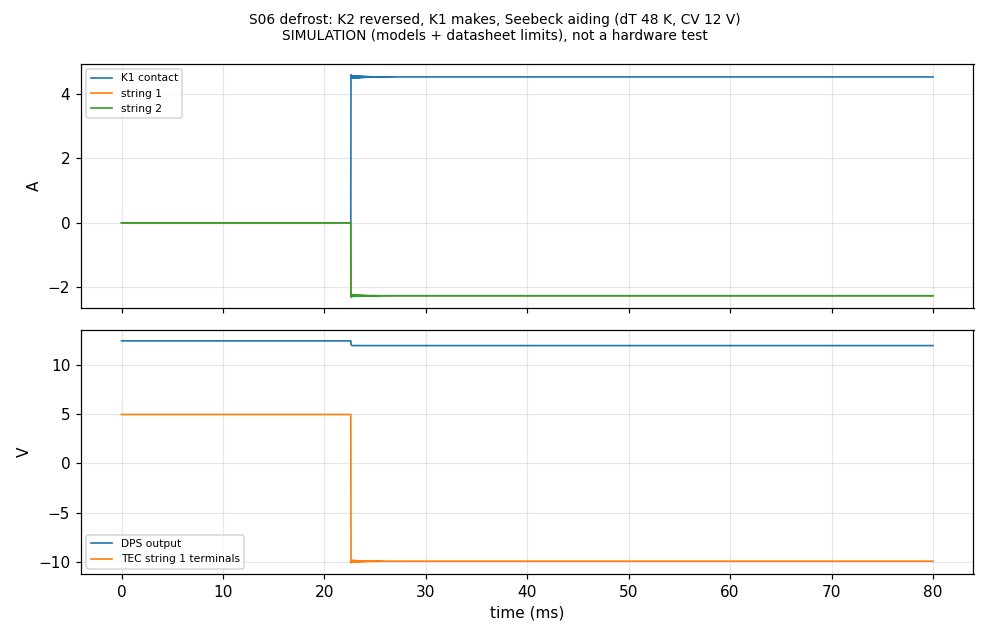
electronics/d34/sim/results/s06_dps_tec/defrost_make.png
