aquarat/cat-feeder/electronics/d34/sim/results/s06_dps_tec/k1_make.png

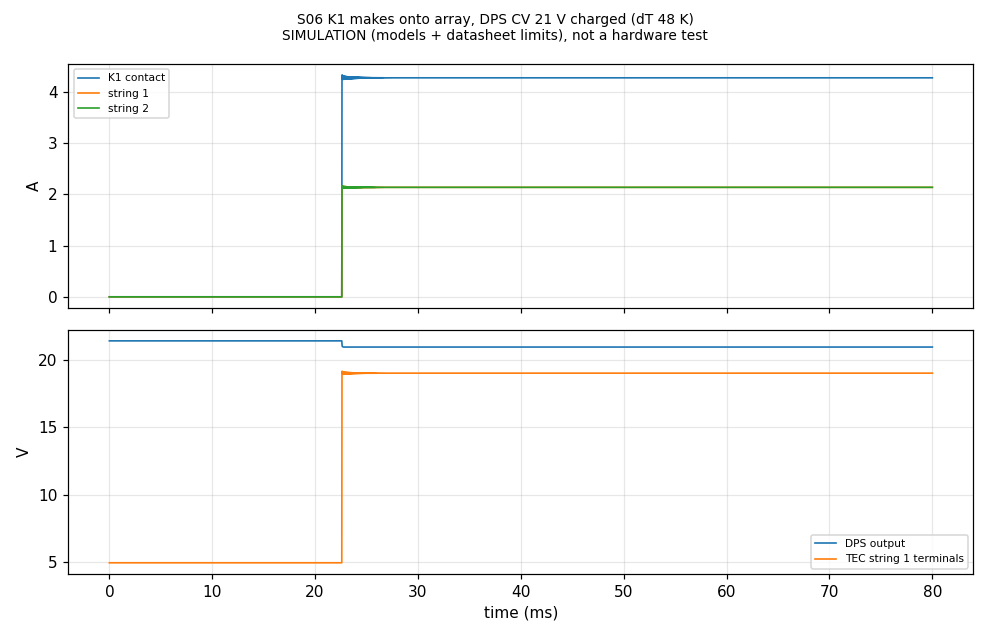
electronics/d34/sim/results/s06_dps_tec/k1_make.png
