aquarat/cat-feeder/electronics/d34/sim/results/s01_hotplug/hotplug_cases.csv

case | c1 | brick | lead | dps_cin | tvs_bv | bounce | vin_raw_pk | v24_pk | aux_pk | vmot_pk | vdps_in_pk | vgs_min | vgs_max | vds_abs_pk | i_tvs_pk | e_tvs_J | i_q1_pk | i_f1_pk | f1_i2t | i_f2_pk | lead_R_mohm | lead_L_nH | solver | fallback
0 | electrolytic ESR min | brick 470uF/50mOhm | lead min, low-loss contacts | DPS Cin 22uF ceramic-like | min | False | 25.1945 | 25.1938 | 25.1831 | 2.60657 | 25.1938 | -14.9374 | 0.553669 | 1.19612 | 0.00910812 | 3.19952e-07 | 115.94 | 23.8269 | 0.00562196 | 19.7775 | 43.8108 | 701.25 | reltol=1e-4
1 | electrolytic ESR min | brick 470uF/50mOhm | lead min, low-loss contacts | DPS Cin 22uF ceramic-like | max | False | 25.1945 | 25.1938 | 25.1831 | 2.60657 | 25.1938 | -14.9374 | 0.553669 | 1.19612 | 0.00910812 | 3.19952e-07 | 115.94 | 23.8269 | 0.00562196 | 19.7775 | 43.8108 | 701.25 | reltol=1e-4
2 | electrolytic ESR min | brick 470uF/50mOhm | lead min, low-loss contacts | DPS Cin 100uF | min | False | 25.1945 | 25.1938 | 25.1829 | 2.58779 | 25.1938 | -14.9374 | 0.553586 | 1.20913 | 0.00912037 | 3.19863e-07 | 119.868 | 49.3626 | 0.0548436 | 14.8137 | 43.8108 | 701.25 | reltol=1e-4
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
