aquarat/cat-feeder/electronics/d34/sim/results/s01_hotplug/i_tvs_pk_waveform.csv

t | vin_raw | v24 | vmot | i_tvs | i_q1
0 | -0.732399 | -0.736417 | -0.0249031 | -0.00271897 | 5.88512e-09
1.17028e-07 | -0.732399 | -0.736417 | -0.0249031 | -0.00271897 | 5.02574e-09
5.37567e-07 | -0.732399 | -0.736417 | -0.0249031 | -0.00271897 | 5.63784e-09
1.23757e-06 | -0.732399 | -0.736417 | -0.0249031 | -0.00271897 | 6.36102e-09
1.93757e-06 | -0.732399 | -0.736417 | -0.0249031 | -0.00271897 | 5.40875e-09
2.63757e-06 | -0.732399 | -0.736417 | -0.0249031 | -0.00271897 | 6.02913e-09
3.33757e-06 | -0.732399 | -0.736417 | -0.0249031 | -0.00271897 | 6.02697e-09
4.03757e-06 | -0.732399 | -0.736417 | -0.0249031 | -0.00271897 | 5.49939e-09
4.73757e-06 | -0.732399 | -0.736417 | -0.0249031 | -0.00271897 | 6.29588e-09
5.43757e-06 | -0.732399 | -0.736417 | -0.0249031 | -0.00271897 | 5.64147e-09
6.13757e-06 | -0.732399 | -0.736417 | -0.0249031 | -0.00271897 | 5.83646e-09
6.83757e-06 | -0.732399 | -0.736417 | -0.0249031 | -0.00271897 | 6.23316e-09
7.53757e-06 | -0.732399 | -0.736417 | -0.0249031 | -0.00271897 | 5.47657e-09
8.23757e-06 | -0.732399 | -0.736417 | -0.0249031 | -0.00271897 | 6.22116e-09
8.93757e-06 | -0.732399 | -0.736417 | -0.0249031 | -0.00271897 | 5.82594e-09
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
