aquarat/cat-feeder/electronics/d34/sim/results/s01_hotplug/tvs_fit_validation.csv

I_A | vishay_model_V | behavioural_fit_V
1 | 27.8303 | 27.7819
2 | 28.4803 | 28.3541
3 | 29.1265 | 28.9183
4 | 29.7712 | 29.4778
5 | 30.4151 | 30.0363
6 | 31.0584 | 30.5942
7 | 31.7014 | 31.1514
8 | 32.3442 | 31.7081
9 | 32.9867 | 32.2643
10 | 33.6291 | 32.8202
11 | 34.2713 | 33.3759
12 | 34.9134 | 33.9313
13 | 35.5555 | 34.4866
14 | 36.1975 | 35.0417
