aquarat/cat-feeder/electronics/d34/sim/results/s01_hotplug/vmot_pk_waveform.csv

t | vin_raw | v24 | vmot | i_tvs | i_q1
0 | -0.732399 | -0.736417 | -0.0249031 | -0.00271897 | 5.88511e-09
1.88534e-07 | -0.732399 | -0.736417 | -0.0249031 | -0.00271897 | 6.11596e-09
8.88534e-07 | -0.732399 | -0.736417 | -0.0249031 | -0.00271897 | 5.80881e-09
1.58853e-06 | -0.732399 | -0.736417 | -0.0249031 | -0.00271897 | 5.78574e-09
2.28853e-06 | -0.732399 | -0.736417 | -0.0249031 | -0.00271897 | 5.991e-09
2.98853e-06 | -0.732399 | -0.736417 | -0.0249031 | -0.00271897 | 5.7784e-09
3.68853e-06 | -0.732399 | -0.736417 | -0.0249031 | -0.00271897 | 5.93622e-09
4.38853e-06 | -0.732399 | -0.736417 | -0.0249031 | -0.00271897 | 5.94532e-09
5.08853e-06 | -0.732399 | -0.736417 | -0.0249031 | -0.00271897 | 5.92286e-09
5.78853e-06 | -0.732399 | -0.736417 | -0.0249031 | -0.00271897 | 6.03075e-09
6.48853e-06 | -0.732399 | -0.736417 | -0.0249031 | -0.00271897 | 5.73932e-09
7.18853e-06 | -0.732399 | -0.736417 | -0.0249031 | -0.00271897 | 5.87389e-09
7.88853e-06 | -0.732399 | -0.736417 | -0.0249031 | -0.00271897 | 5.94194e-09
8.58853e-06 | -0.732399 | -0.736417 | -0.0249031 | -0.00271897 | 5.88931e-09
9.28853e-06 | -0.732399 | -0.736417 | -0.0249031 | -0.00271897 | 5.97996e-09
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
