aquarat/cat-feeder/electronics/d34/sim/results/s02_reverse/reverse_cases.csv

variant | case | lead | brick | vds_min | vgs_min | vgs_max | v24_min | vmot_min | aux_min | v12_min | v5_min | v33_min | t_rev_cond_us | t_v24_below_m1_us | i_leak_ss | i_q1_pk | i_tvs_fwd_pk | fallback
as designed | 0 | lead min, low-loss | brick 470uF/50mOhm | -25.7514 | 0.240107 | 0.511022 | -0.763999 | -0.0249031 | -0.737671 | -0.0249031 | -0.0250108 | 0.0001433 | 0 | 0 | 1.12242e-05 | 0.267583 | 0.00574452
as designed | 1 | lead min, low-loss | brick 2200uF/20mOhm | -25.79 | 0.239871 | 0.511022 | -0.763969 | -0.0249031 | -0.737671 | -0.0249031 | -0.0250108 | 0.000143253 | 0 | 0 | 1.12242e-05 | 0.267822 | 0.00574503
as designed | 2 | lead max | brick 470uF/50mOhm | -27.8293 | 0.228354 | 0.511022 | -0.753775 | -0.0249031 | -0.737489 | -0.0249031 | -0.0250108 | 0.000174661 | 0 | 0 | 1.12243e-05 | 0.15954 | 0.00440041
as designed | 3 | lead max | brick 2200uF/20mOhm | -27.8628 | 0.228156 | 0.511022 | -0.753781 | -0.0249031 | -0.737489 | -0.0249031 | -0.0250108 | 0.000174621 | 0 | 0 | 1.12243e-05 | 0.15971 | 0.00439874
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
