aquarat/cat-feeder/electronics/d34/sim/results/s01_hotplug/i_tvs_pk.png

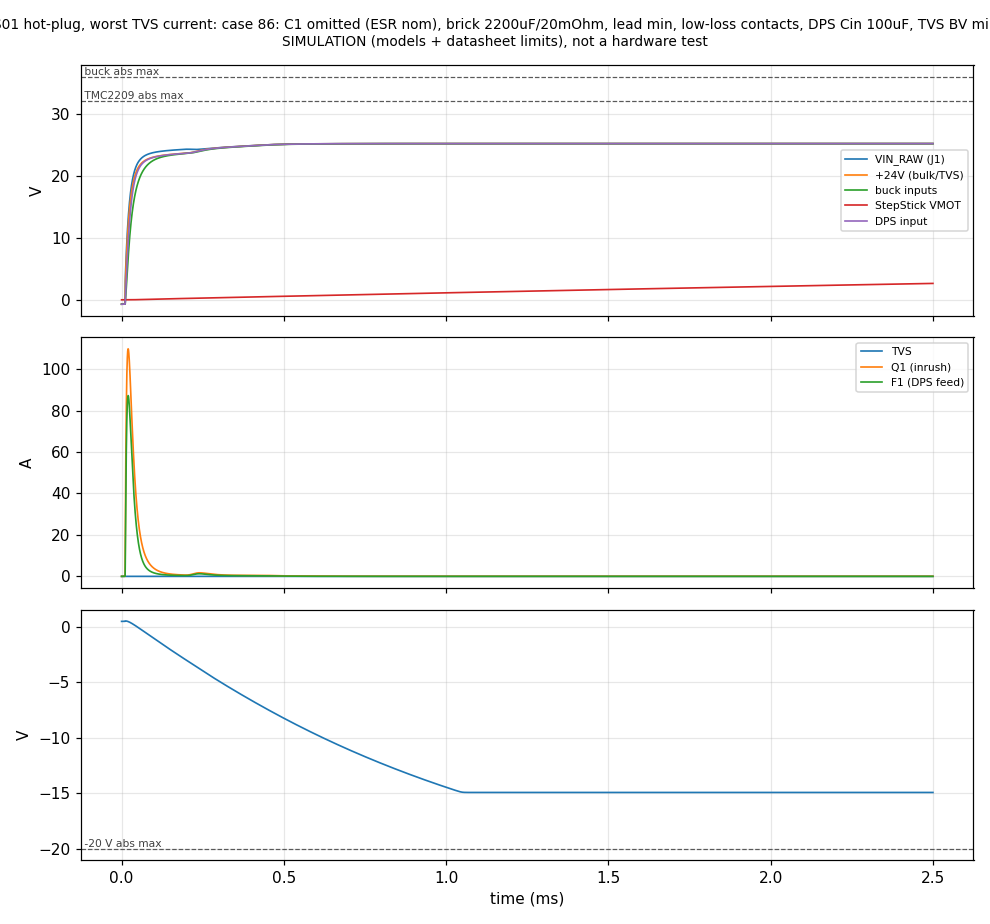
electronics/d34/sim/results/s01_hotplug/i_tvs_pk.png
