aquarat/cat-feeder/electronics/d34/sim/results/s02_reverse/reverse_worst.png

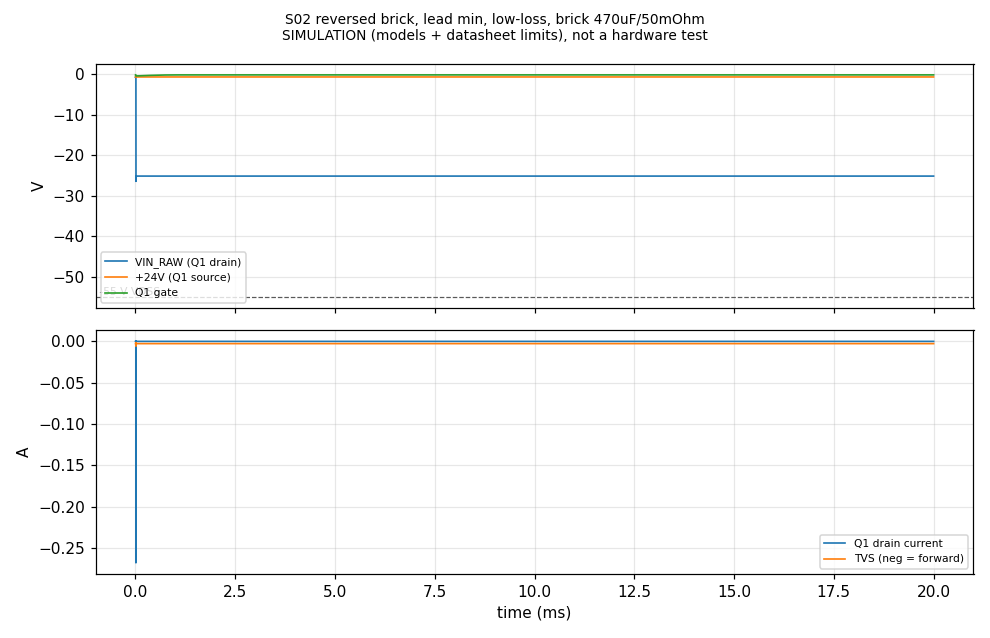
electronics/d34/sim/results/s02_reverse/reverse_worst.png
