aquarat/cat-feeder/electronics/d34/sim/results/s04_sequencing/powerdown_0.png

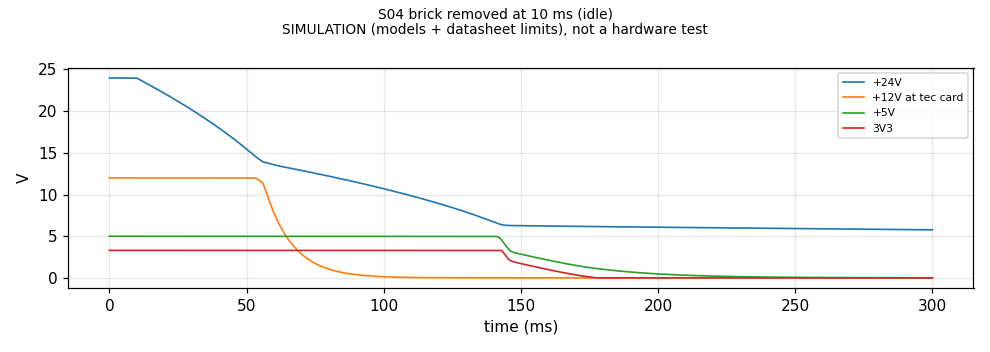
electronics/d34/sim/results/s04_sequencing/powerdown_0.png
