aquarat/cat-feeder/electronics/d34/sim/results/s04_sequencing/powerup.png

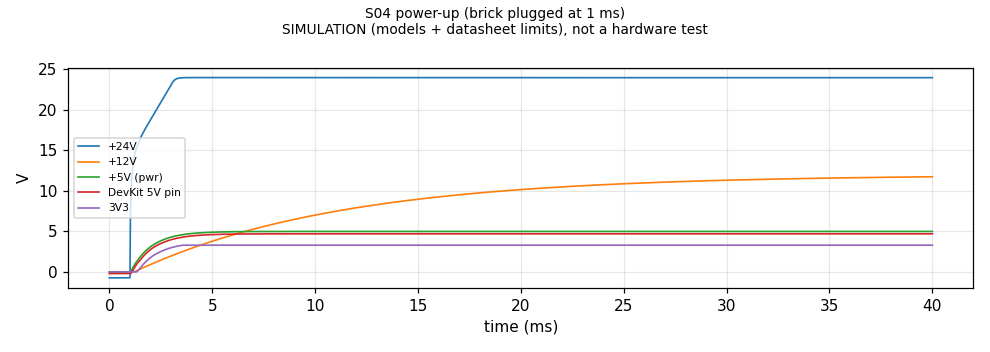
electronics/d34/sim/results/s04_sequencing/powerup.png
