aquarat/cat-feeder/electronics/d34/sim/results/s04_sequencing/wifi_worst.png

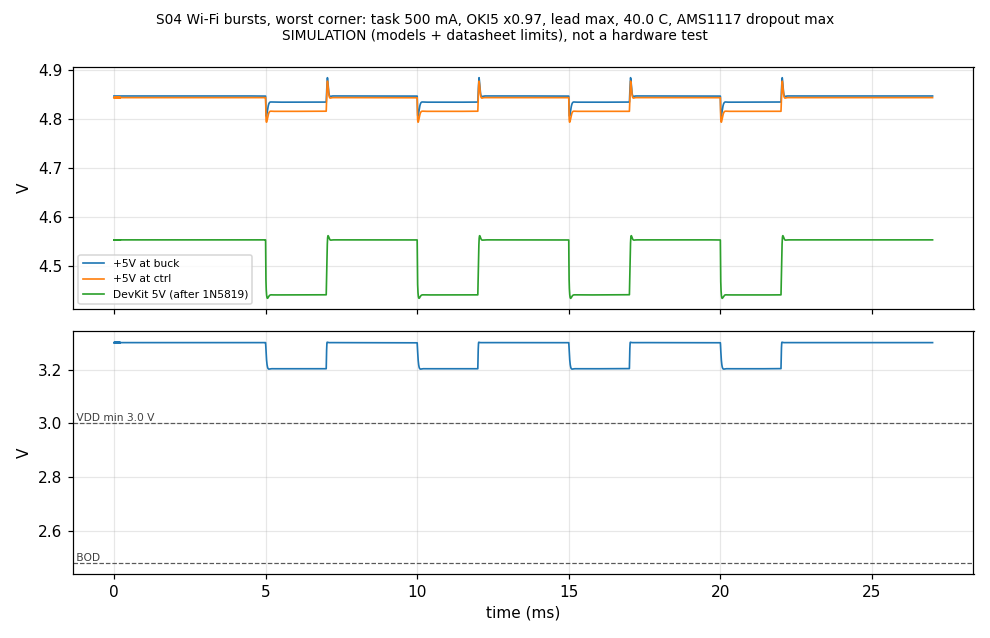
electronics/d34/sim/results/s04_sequencing/wifi_worst.png
