aquarat/cat-feeder/electronics/d34/sim/results/s05_tec_interlock/coils.png

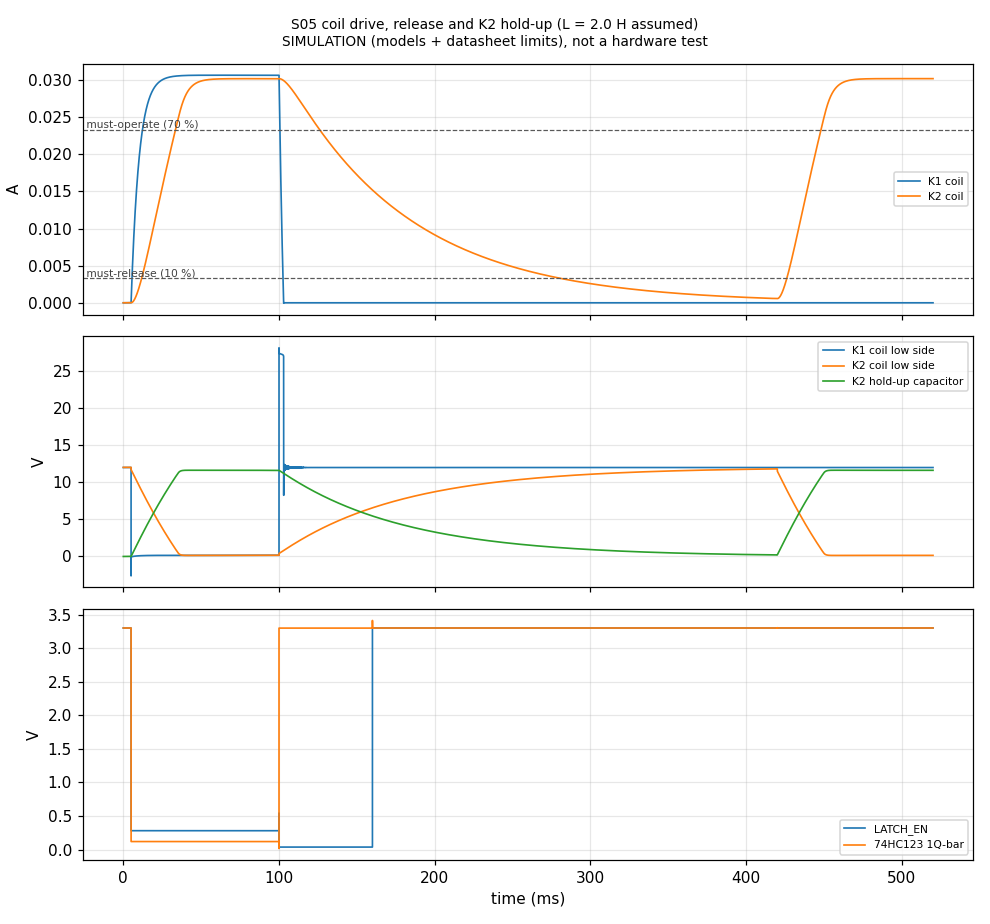
electronics/d34/sim/results/s05_tec_interlock/coils.png
