aquarat/cat-feeder/electronics/d34/sim/results/s07_fans/fan_pwm.png

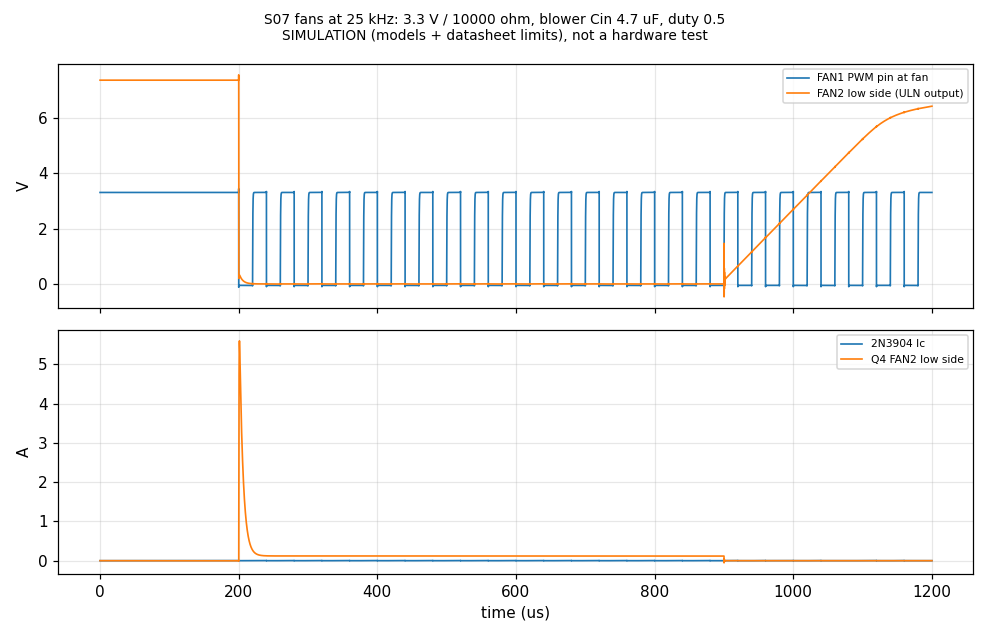
electronics/d34/sim/results/s07_fans/fan_pwm.png
