aquarat/cat-feeder/electronics/d34/sim/results/s08_stepper/vmot_ripple.png

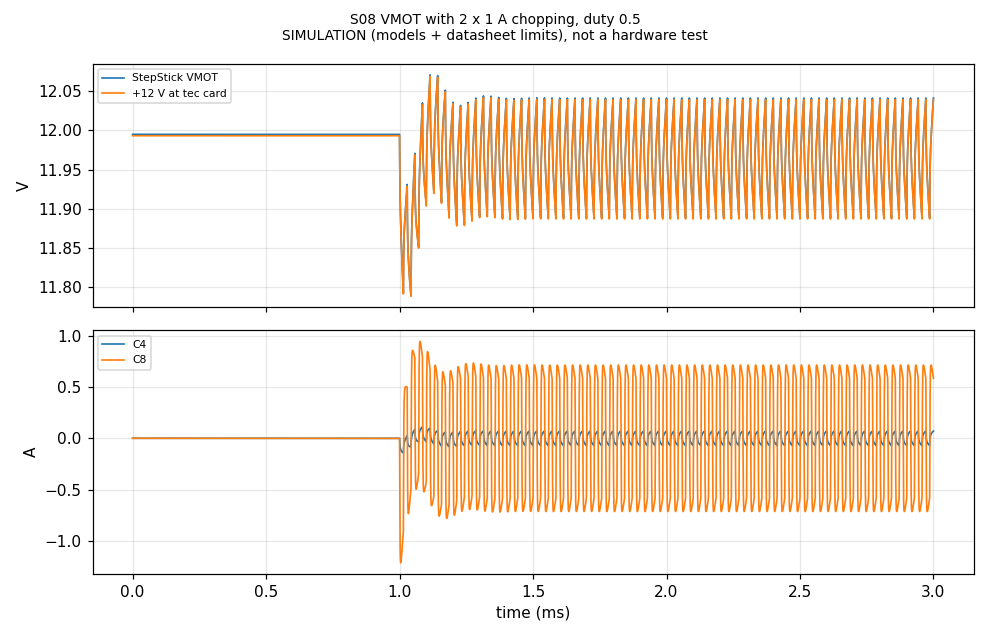
electronics/d34/sim/results/s08_stepper/vmot_ripple.png
