aquarat/cat-feeder/electronics/d34/sim/results/s11_montecarlo/mc_histograms.png

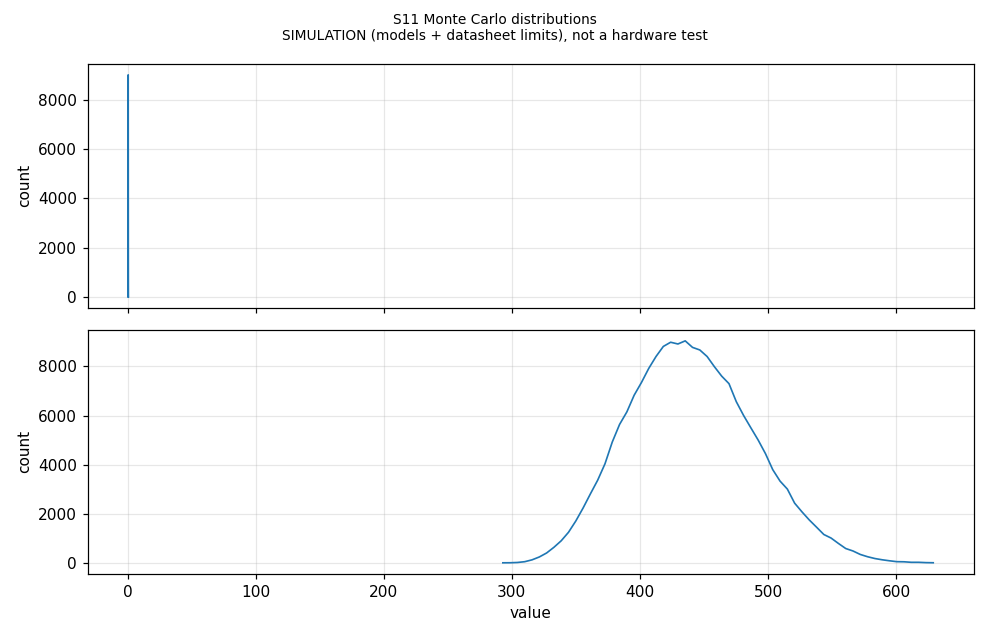
electronics/d34/sim/results/s11_montecarlo/mc_histograms.png
