aquarat/cat-feeder/electronics/pcb/views/schematic.pdf

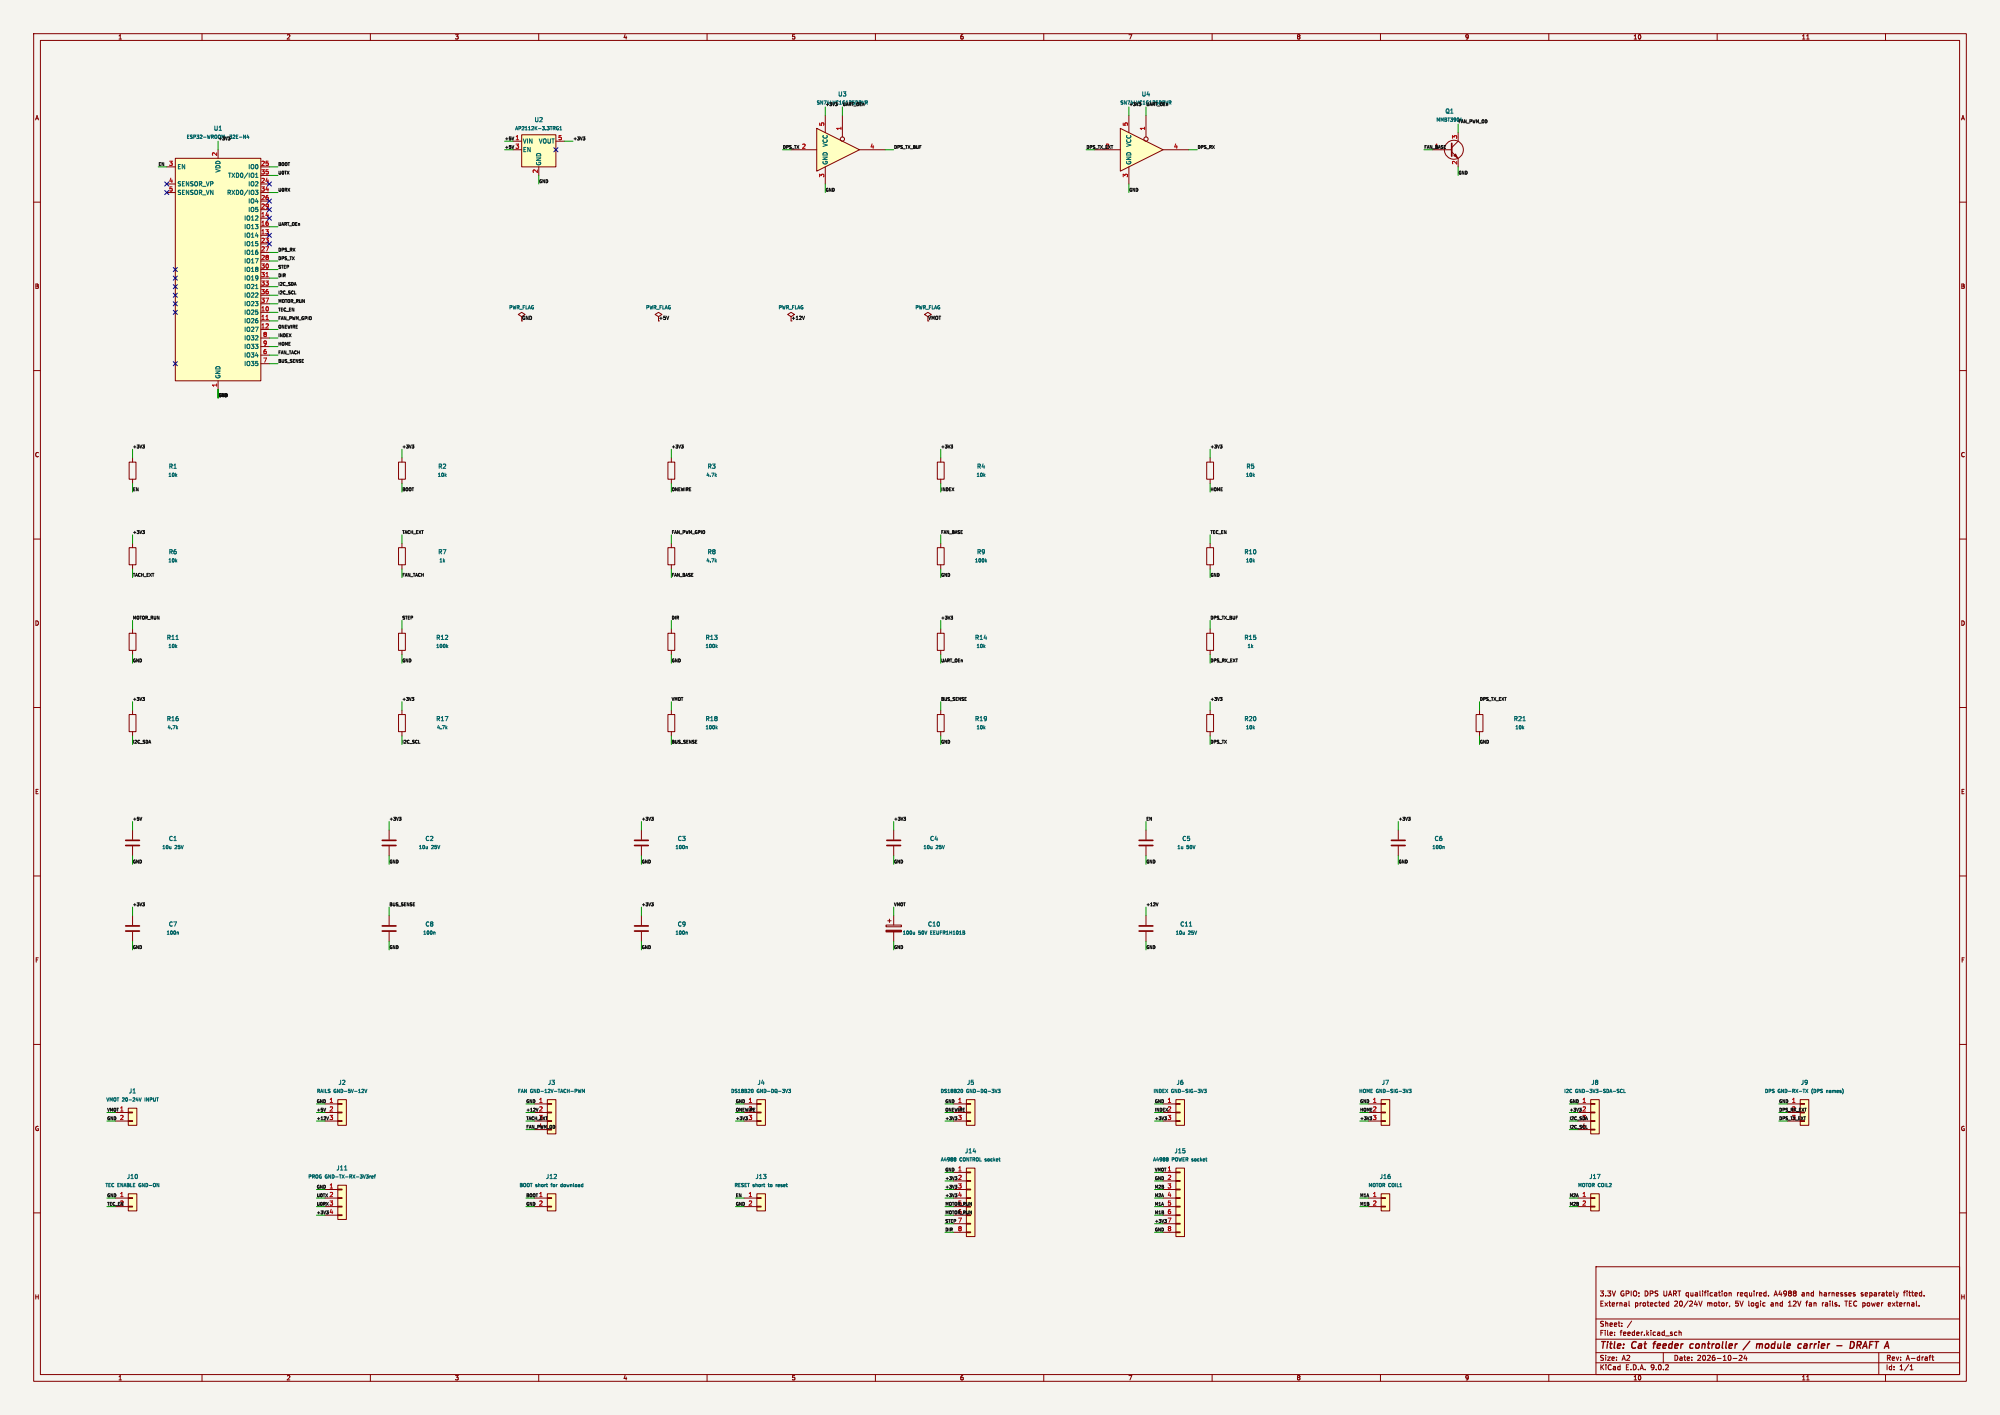
[picture p56: page 1]

FAN GND-12V-TACH-PWM

BOOT short for download 1

J13 RESET short to reset
