aquarat/cat-feeder/electronics/d34/d34-ctrl/views/schematic.pdf

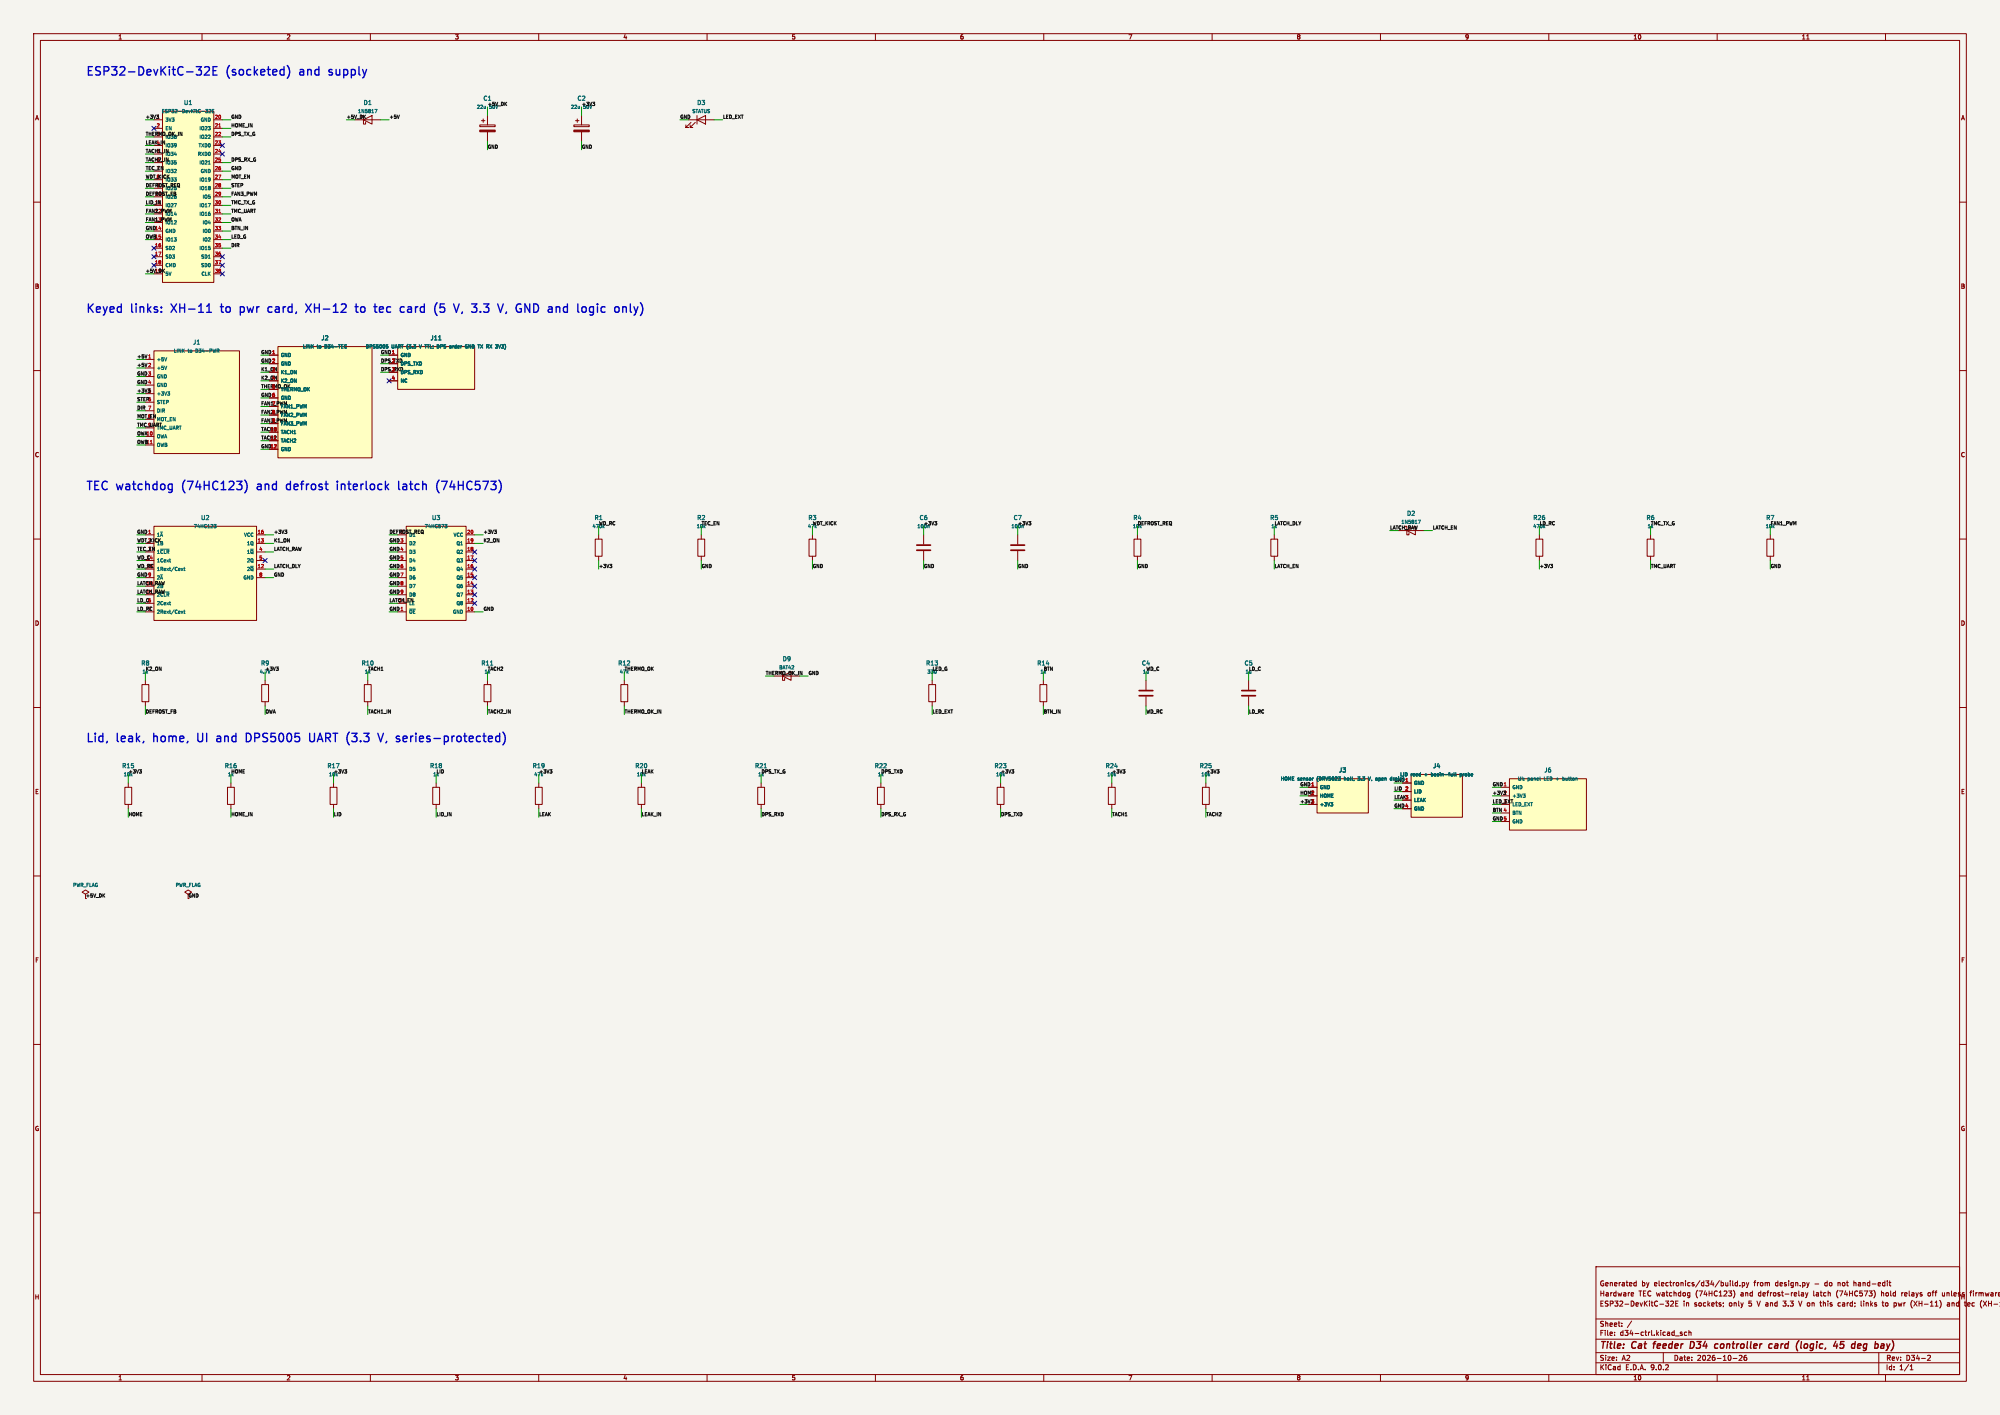
[picture p57: page 1]

J11 DPS5005 UART (3.3 V TTL; DPS order GND TX RX 3V3) GND 1 DPS_TXD 2 DPS_RXD 3 NC 4 J2
DPS_RXD GND

LINK to D34-TEC GND 1 GND 2 K1_ON 3 K2_ON 4 THERMO_OK 5 GND 6 FAN1_PWM 7 FAN2_PWM 8 FAN3_PWM 9 TACH1 10 TACH2 11 GND 12

Lid, leak, home, UI and DPS5005 UART (3.3 V, series-protected)

4 J3 HOME sensor (DRV5023 hall, 3.3 V, open drain) GND
