aquarat/cat-feeder/electronics/d34/d34-pwr/views/schematic.pdf

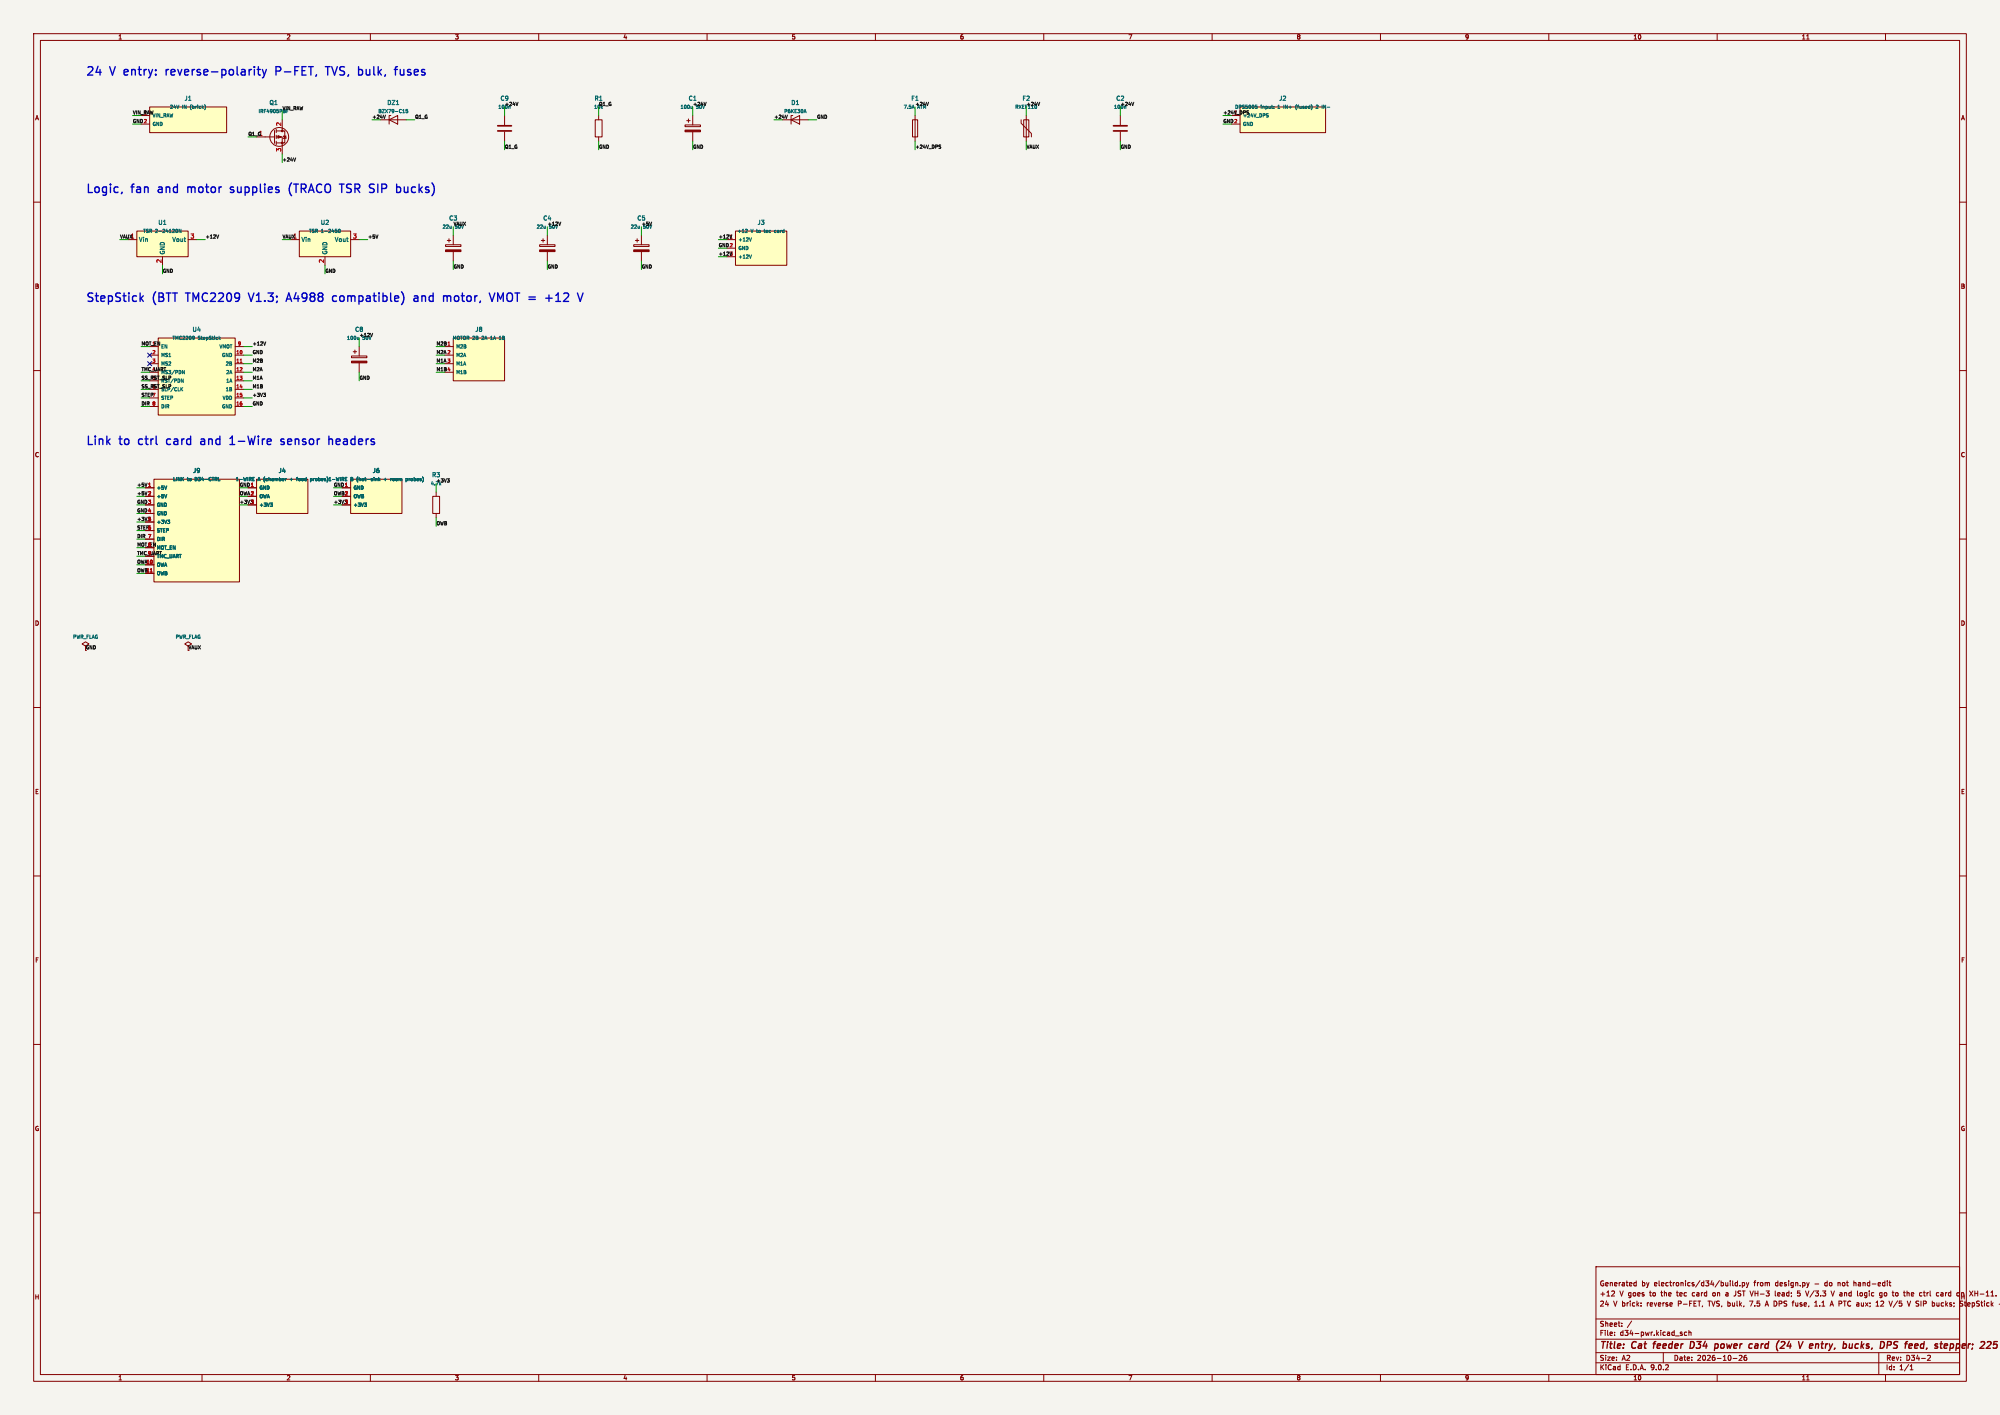
[picture p58: page 1]

TMC_UART MOT_EN
SS_RST_SLP
STEP
LINK to D34-CTRL +5V 1 +5V 2 GND 3 GND 4 +3V3 5 STEP 6 DIR 7 MOT_EN 8 TMC_UART 9 OWA 10 OWB 11
+5V GND GND
