aquarat/cat-feeder/electronics/d34/d34-tec/views/schematic.pdf

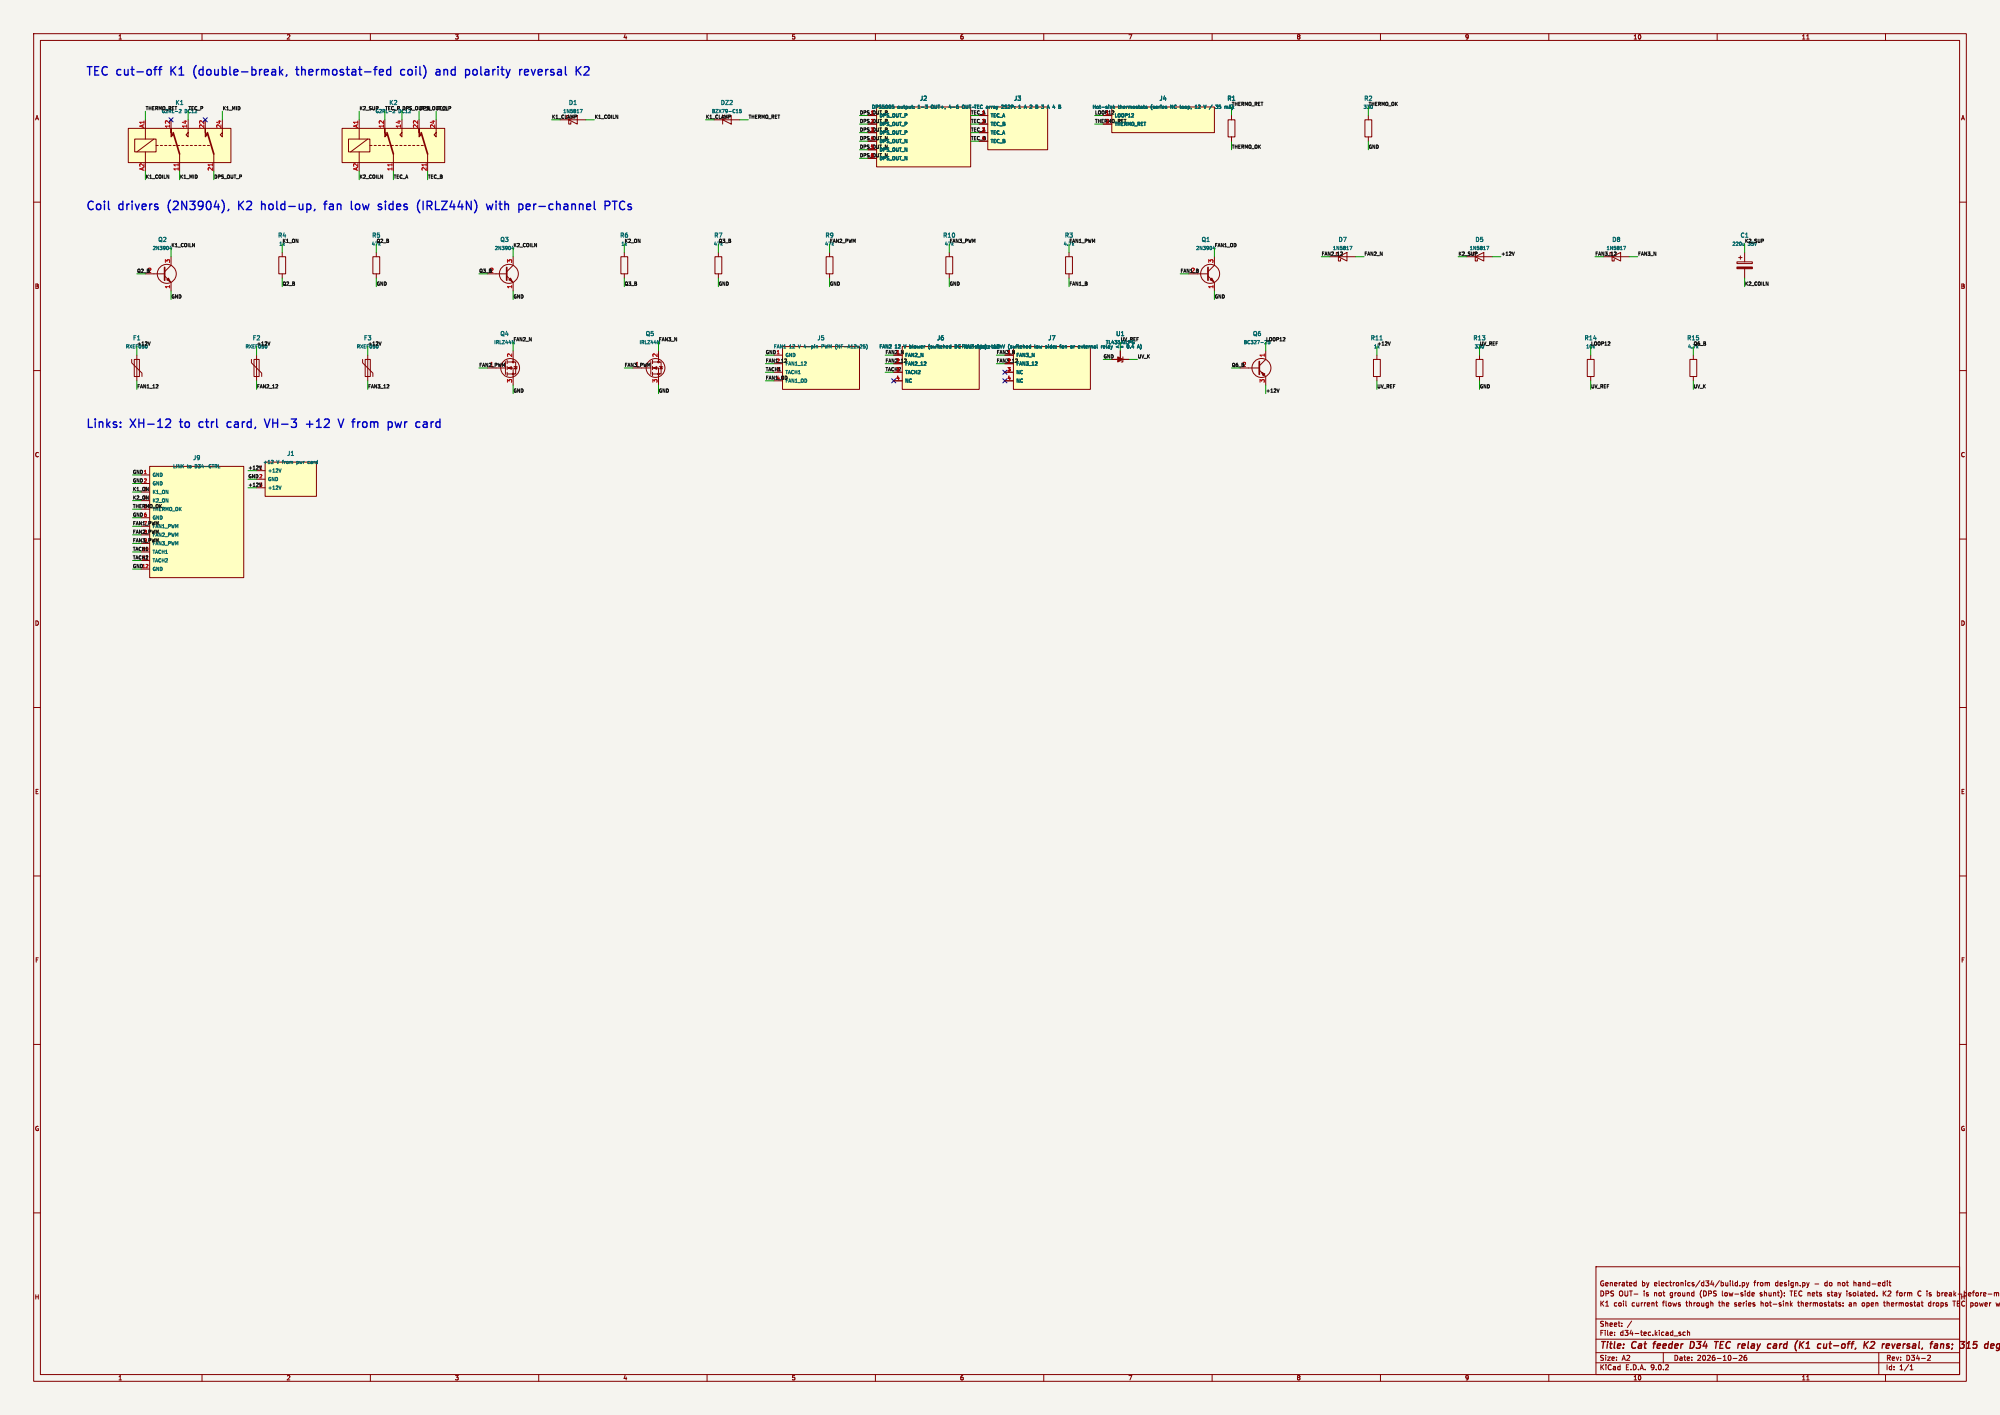
[picture p59: page 1]
