aquarat/cat-feeder/(list of files, drawings)

Other design files:
electronics/d34/d34-ctrl/d34-ctrl.dsn
electronics/d34/d34-pwr/d34-pwr.dsn
electronics/d34/d34-tec/d34-tec.dsn
electronics/pcb/feeder.dsn
