aquarat/cat-feeder/electronics/pcb/feeder.kicad_pcb

## KiCad design electronics/pcb/feeder.kicad_pcb (2026-11-01)

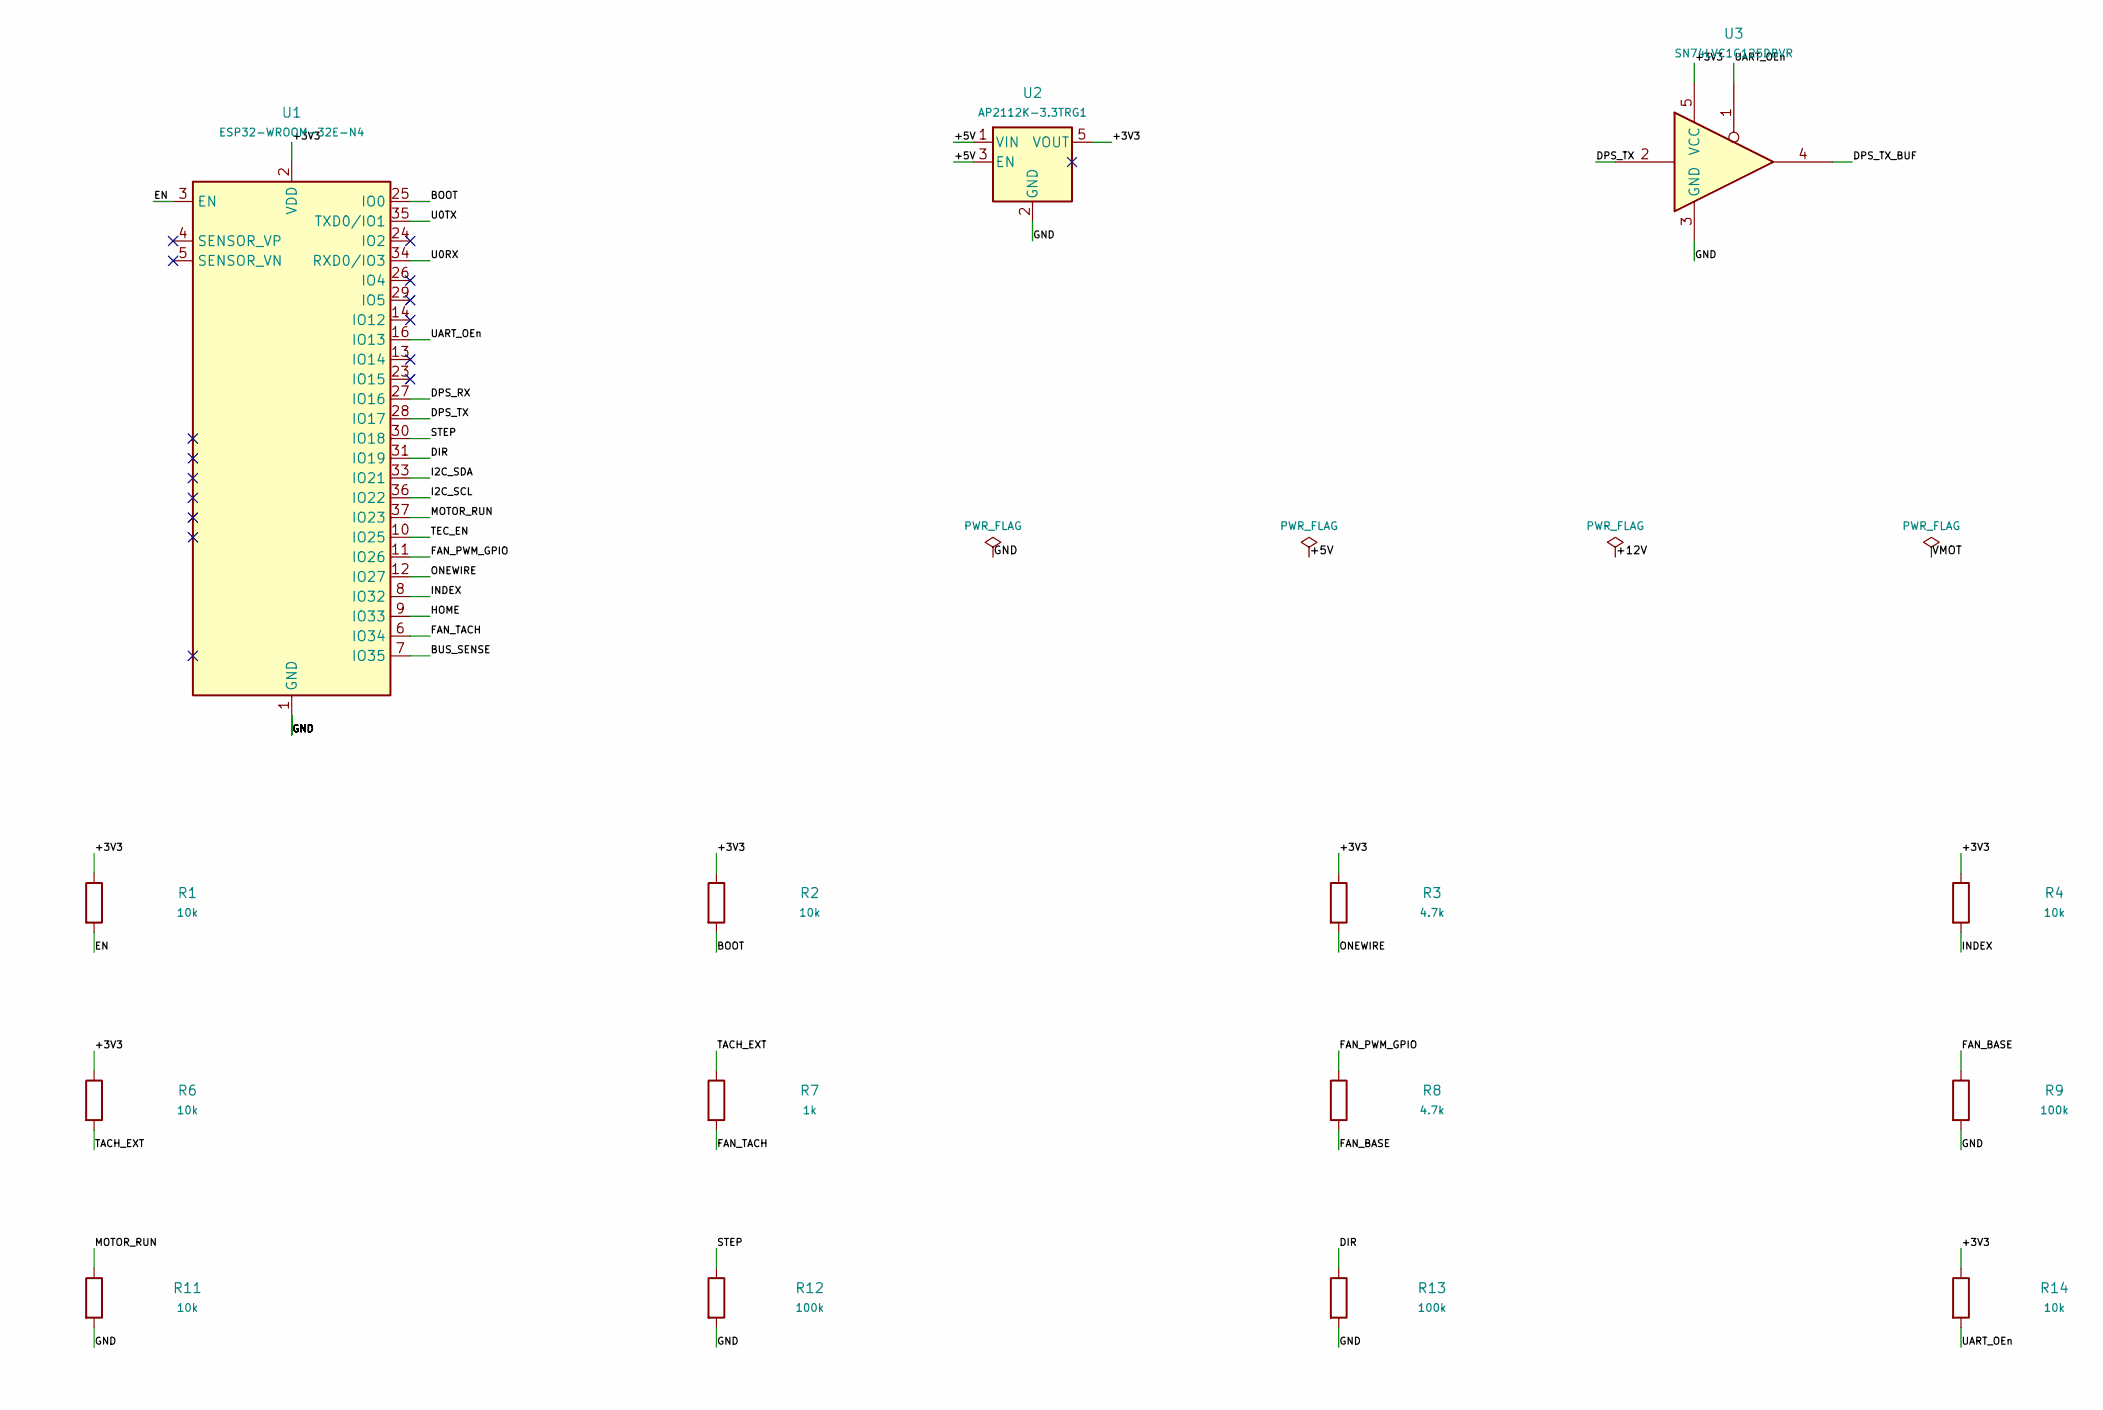
[picture p60: schematic feeder.kicad_sch, Cat feeder controller / module carrier - DRAFT A, part in row 1, column 1]

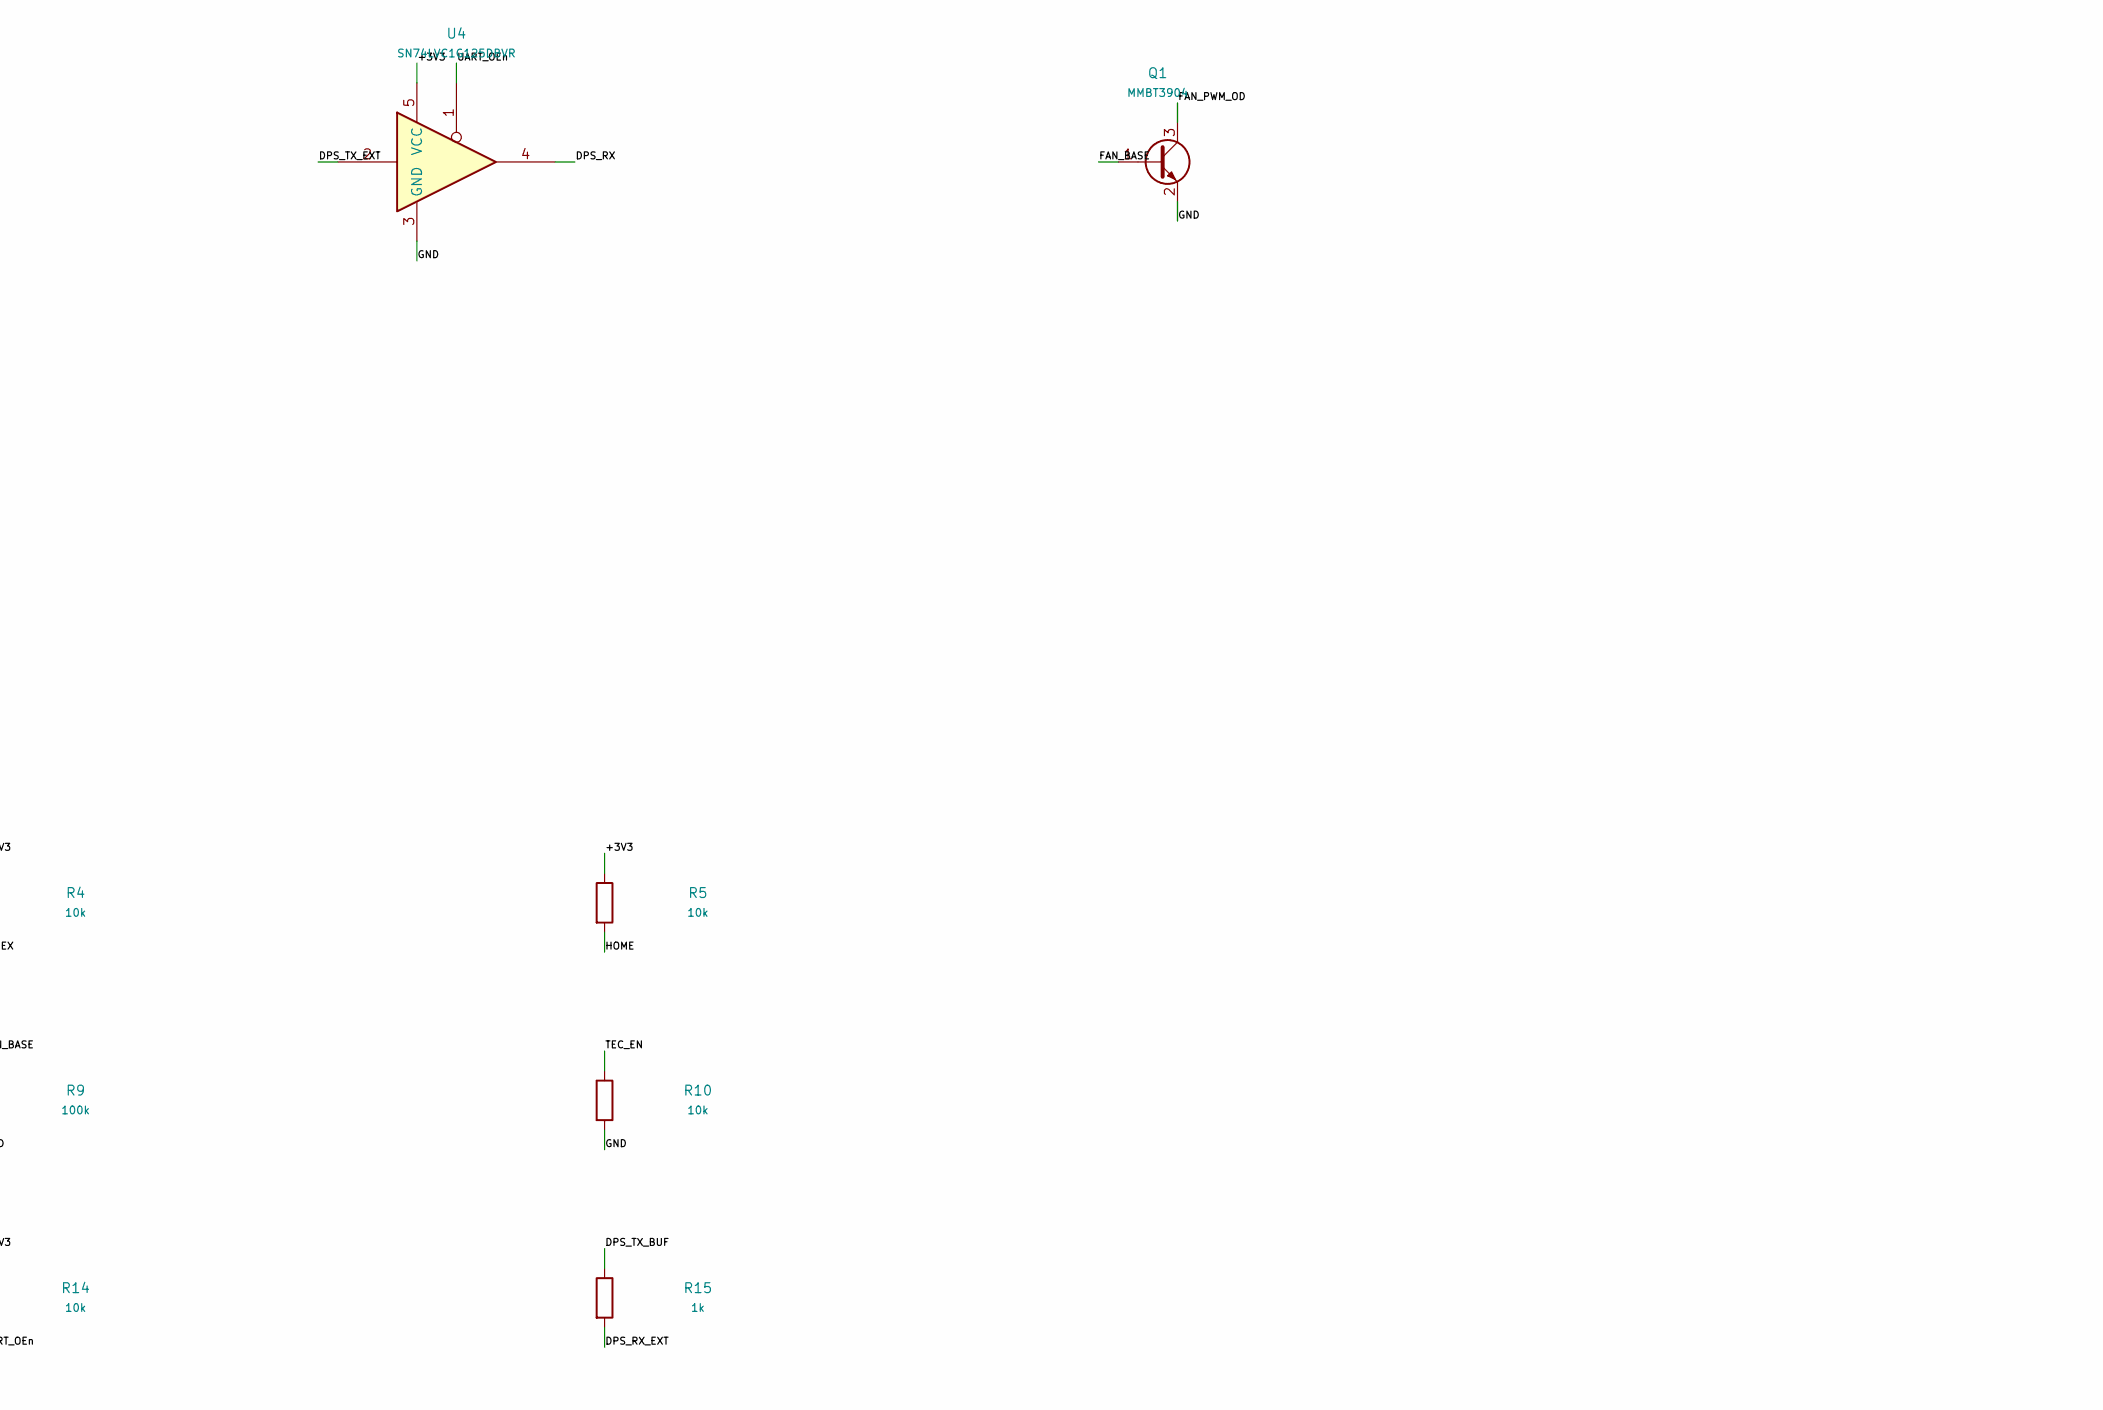
[picture p61: schematic feeder.kicad_sch, Cat feeder controller / module carrier - DRAFT A, part in row 1, column 2]

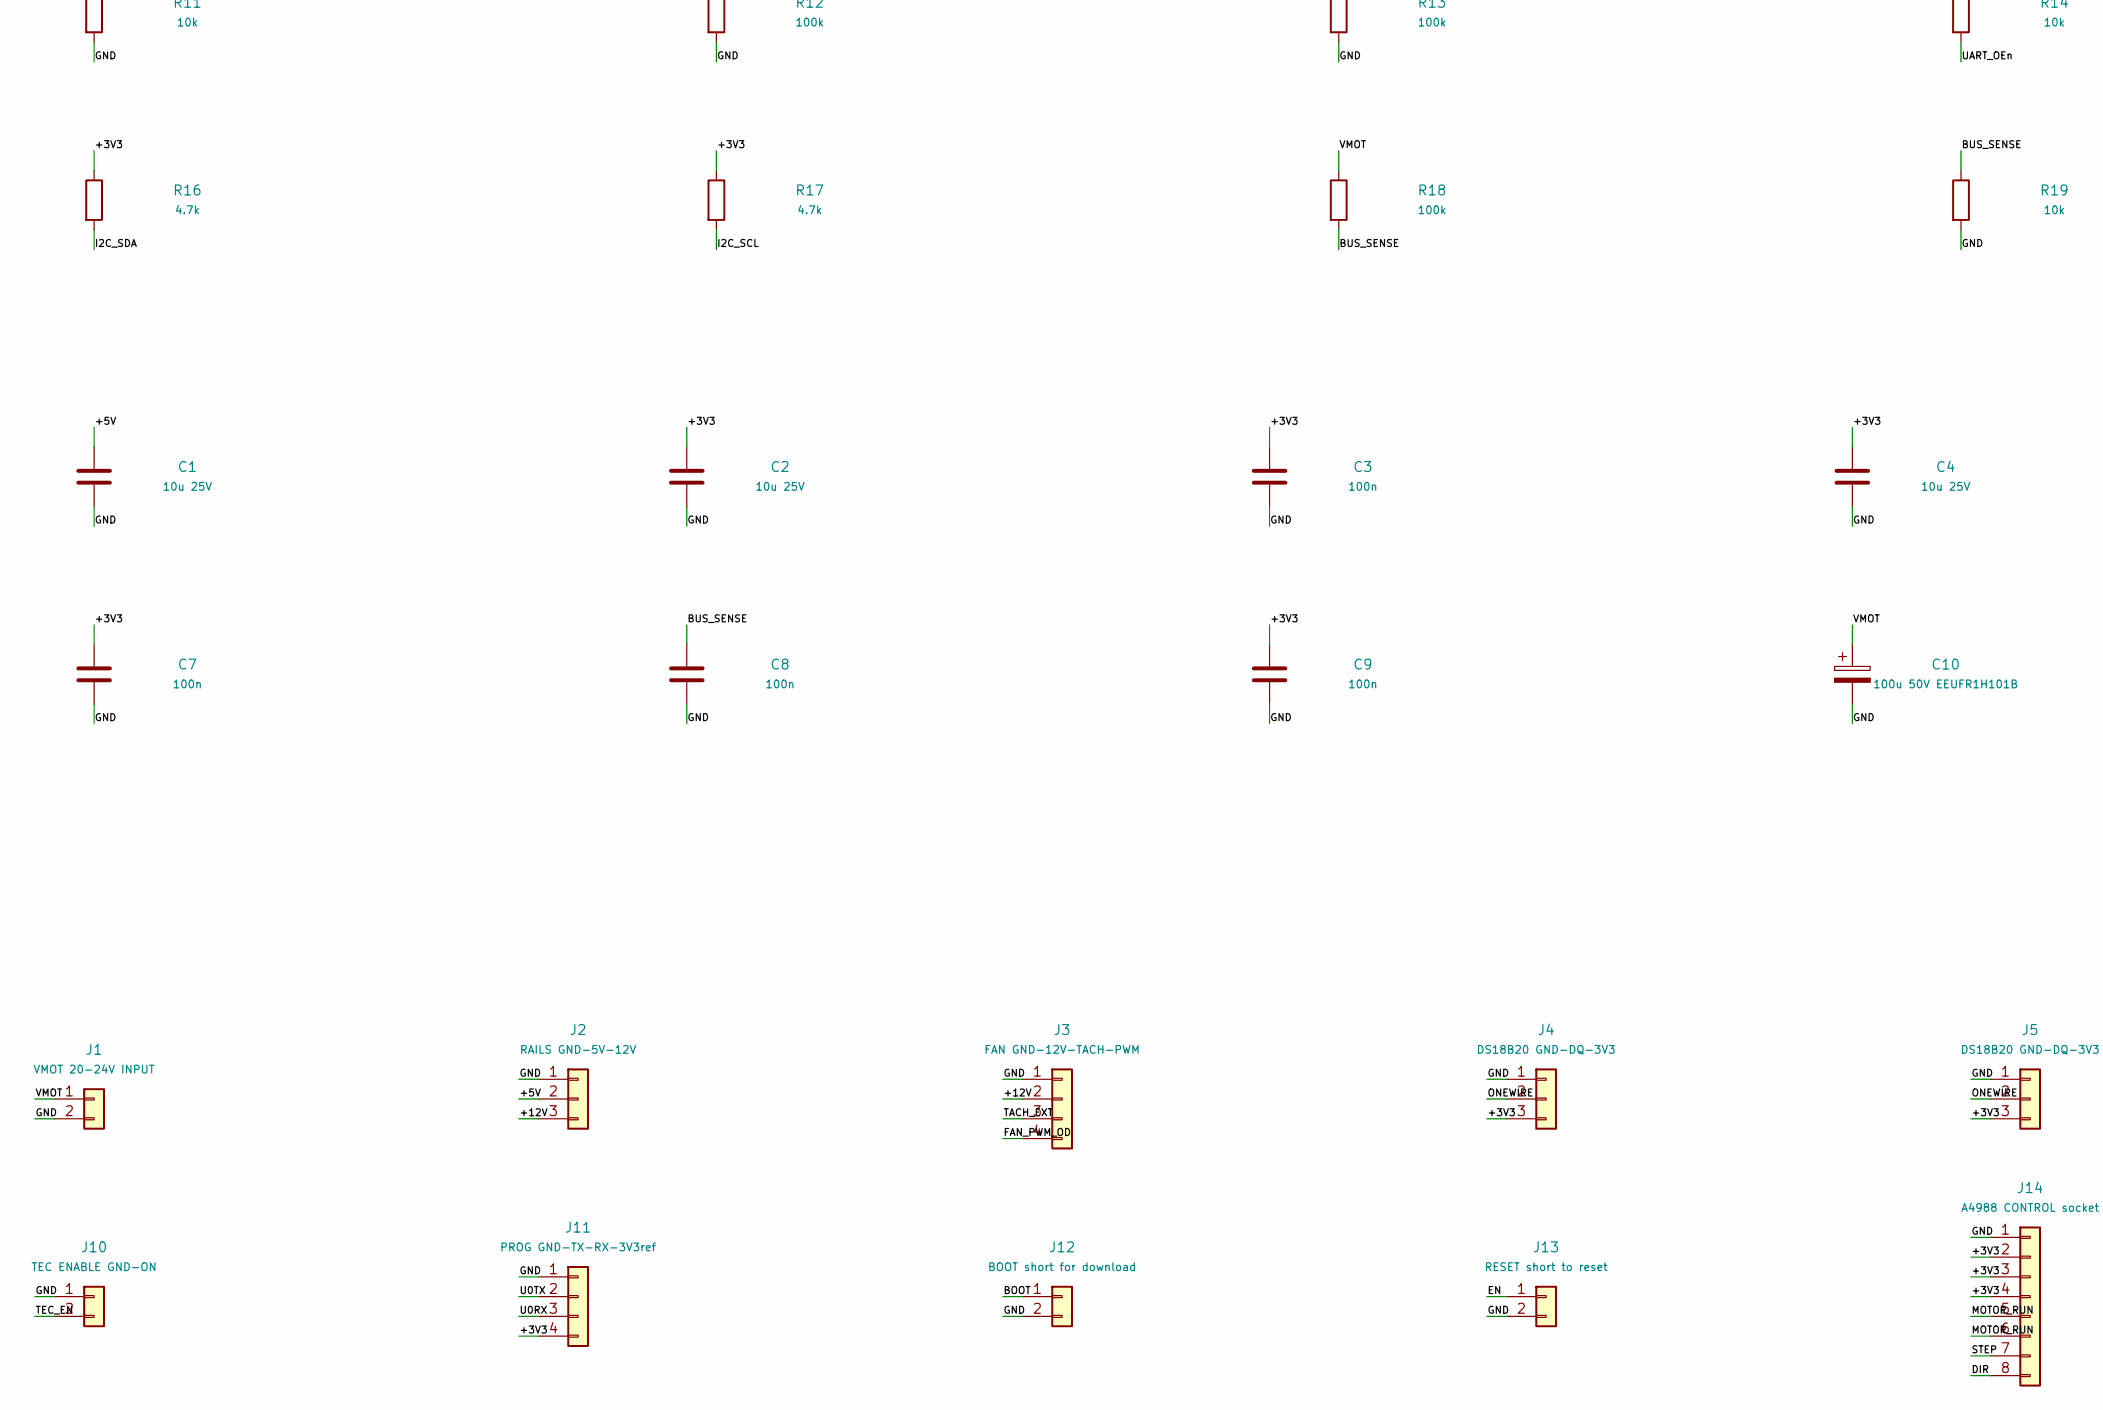
[picture p62: schematic feeder.kicad_sch, Cat feeder controller / module carrier - DRAFT A, part in row 2, column 1]

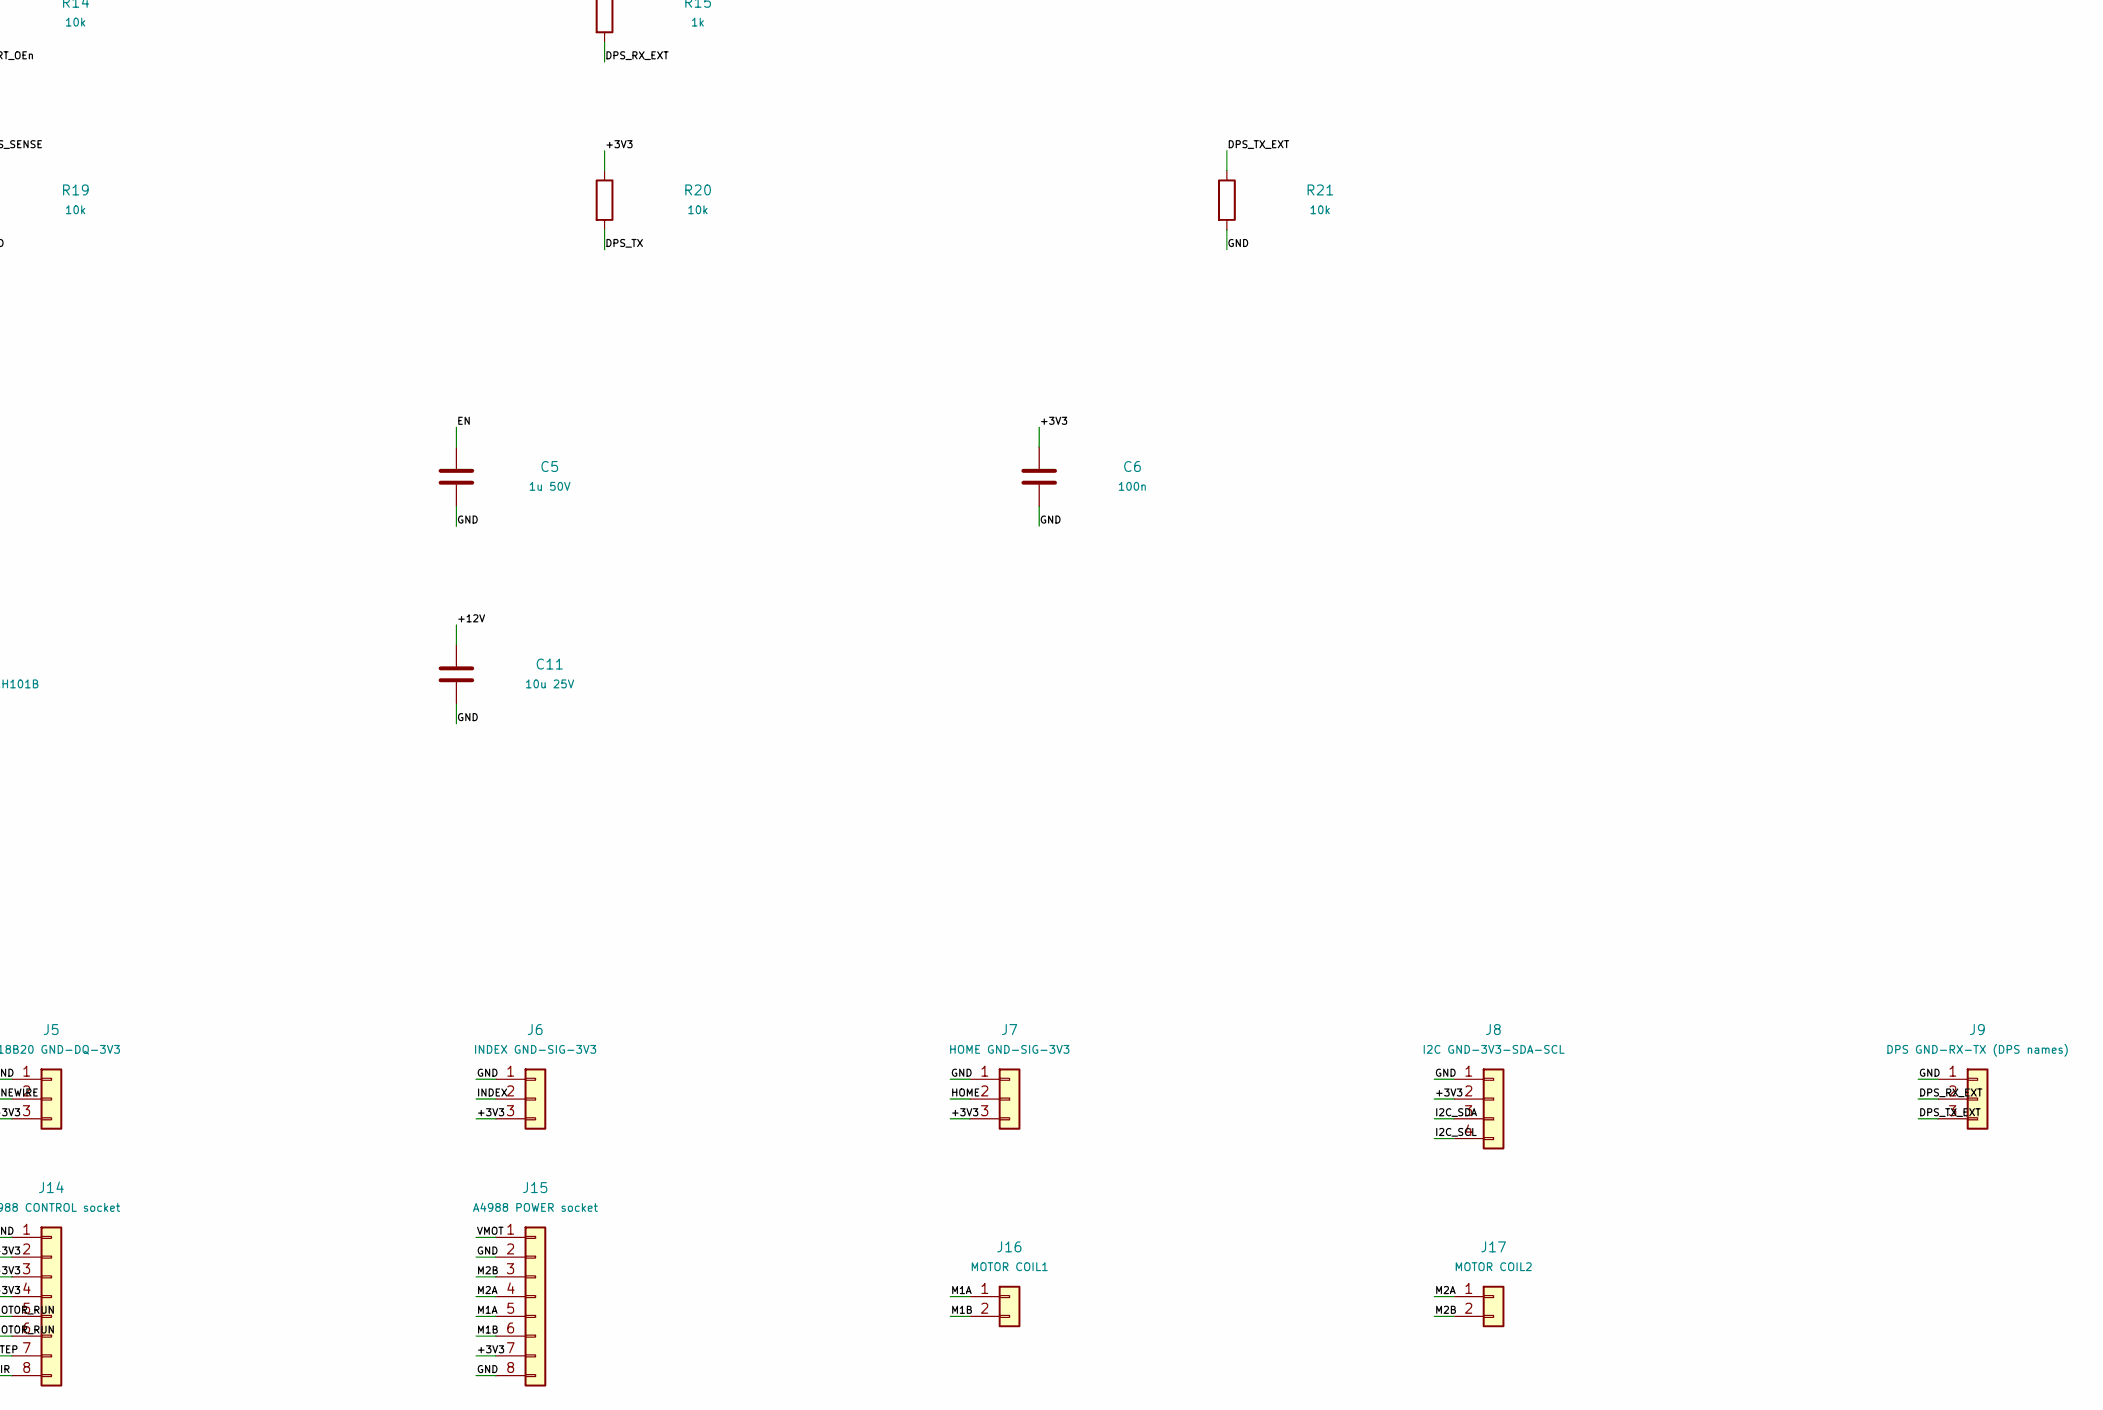
[picture p63: schematic feeder.kicad_sch, Cat feeder controller / module carrier - DRAFT A, part in row 2, column 2]

Parts:
C1, C2, C4, C11: 10u 25V; C_0805_2012Metric; LCSC C15850
C3, C6, C7, C8, C9: 100n; C_0603_1608Metric; LCSC C14663
C5: 1u 50V; C_0603_1608Metric; LCSC C15849
C10: 100u 50V EEUFR1H101B; CP_Radial_D8.0mm_P5.00mm; LCSC C713402
J1: VMOT 20-24V INPUT; TerminalBlock_Phoenix_MKDS-1,5-2-5.08_1x02_P5.08mm_Horizont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; LCSC C5183929
J2: RAILS GND-5V-12V; PinHeader_1x03_P2.54mm_Vertical; LCSC C49257
J3: FAN GND-12V-TACH-PWM; PinHeader_1x04_P2.54mm_Vertical; LCSC C5116483
J4, J5: DS18B20 GND-DQ-3V3; PinHeader_1x03_P2.54mm_Vertical; LCSC C49257
J6: INDEX GND-SIG-3V3; PinHeader_1x03_P2.54mm_Vertical; LCSC C49257
J7: HOME GND-SIG-3V3; PinHeader_1x03_P2.54mm_Vertical; LCSC C49257
J8: I2C GND-3V3-SDA-SCL; PinHeader_1x04_P2.54mm_Vertical; LCSC C5116483
J9: DPS GND-RX-TX (DPS names); PinHeader_1x03_P2.54mm_Vertical; LCSC C49257
J10: TEC ENABLE GND-ON; PinHeader_1x02_P2.54mm_Vertical; LCSC C27985187
J11: PROG GND-TX-RX-3V3ref; PinHeader_1x04_P2.54mm_Vertical; LCSC C5116483
J12: BOOT short for download; PinHeader_1x02_P2.54mm_Vertical; LCSC C27985187
J13: RESET short to reset; PinHeader_1x02_P2.54mm_Vertical; LCSC C27985187
J14: A4988 CONTROL socket; PinSocket_1x08_P2.54mm_Vertical; LCSC C27438
J15: A4988 POWER socket; PinSocket_1x08_P2.54mm_Vertical; LCSC C27438
J16: MOTOR COIL1; TerminalBlock_Phoenix_MKDS-1,5-2-5.08_1x02_P5.08mm_Horizont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; LCSC C5183929
J17: MOTOR COIL2; TerminalBlock_Phoenix_MKDS-1,5-2-5.08_1x02_P5.08mm_Horizont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; LCSC C5183929
Q1: MMBT3904; SOT-23; LCSC C20526
R1, R2, R4, R5, R6, R10, R11, R14, R19, R20, R21: 10k; R_0603_1608Metric; LCSC C25804
R3, R8, R16, R17: 4.7k; R_0603_1608Metric; LCSC C23162
R7, R15: 1k; R_0603_1608Metric; LCSC C21190
R9, R12, R13, R18: 100k; R_0603_1608Metric; LCSC C25803
U1: ESP32-WROOM-32E-N4; ESP32-WROOM-32E; LCSC C701341
U2: AP2112K-3.3TRG1; SOT-23-5; LCSC C51118
U3, U4: SN74LVC1G125DBVR; SOT-23-5; LCSC C23654

Connections:
/+3V3: C2.1, C3.1, C4.1, C6.1, C7.1, C9.1, J4.3, J5.3, J6.3, J7.3, J8.2, J11.4, J14.2, J14.3, J14.4, J15.7, R1.1, R2.1, R3.1, R4.1, R5.1, R6.1, R14.1, R16.1, R17.1, R20.1, U1.2 (VDD), U2.5 (VOUT), U3.5 (VCC), U4.5 (VCC)
/+5V: C1.1, J2.2, U2.1 (VIN), U2.3 (EN)
/+12V: C11.1, J2.3, J3.2
/BOOT: J12.1, R2.2, U1.25 (IO0)
/BUS_SENSE: C8.1, R18.2, R19.1, U1.7 (IO35)
/DIR: J14.8, R13.1, U1.31 (IO19)
/DPS_RX: U1.27 (IO16), U4.4
/DPS_RX_EXT: J9.2, R15.2
/DPS_TX: R20.2, U1.28 (IO17), U3.2
/DPS_TX_BUF: R15.1, U3.4
/DPS_TX_EXT: J9.3, R21.1, U4.2
/EN: C5.1, J13.1, R1.2, U1.3 (EN)
/FAN_BASE: Q1.1 (B), R8.2, R9.1
/FAN_PWM_GPIO: R8.1, U1.11 (IO26)
/FAN_PWM_OD: J3.4, Q1.3 (C)
/FAN_TACH: R7.2, U1.6 (IO34)
/GND: C1.2, C2.2, C3.2, C4.2, C5.2, C6.2, C7.2, C8.2, C9.2, C10.2, C11.2, J1.2, J2.1, J3.1, J4.1, J5.1, J6.1, J7.1, J8.1, J9.1, J10.1, J11.1, J12.2, J13.2, J14.1, J15.2, J15.8, Q1.2 (E), R9.2, R10.2, R11.2, R12.2, R13.2, R19.2, R21.2, U1.1 (GND), U1.15 (GND), U1.38 (GND), U1.39 (GND), U2.2 (GND), U3.3 (GND), U4.3 (GND)
/HOME: J7.2, R5.2, U1.9 (IO33)
/I2C_SCL: J8.4, R17.2, U1.36 (IO22)
/I2C_SDA: J8.3, R16.2, U1.33 (IO21)
/INDEX: J6.2, R4.2, U1.8 (IO32)
/M1A: J15.5, J16.1
/M1B: J15.6, J16.2
/M2A: J15.4, J17.1
/M2B: J15.3, J17.2
/MOTOR_RUN: J14.5, J14.6, R11.1, U1.37 (IO23)
/ONEWIRE: J4.2, J5.2, R3.2, U1.12 (IO27)
/STEP: J14.7, R12.1, U1.30 (IO18)
/TACH_EXT: J3.3, R6.2, R7.1
/TEC_EN: J10.2, R10.1, U1.10 (IO25)
/U0RX: J11.3, U1.34 (RXD0/IO3)
/U0TX: J11.2, U1.35 (TXD0/IO1)
/UART_OEn: R14.2, U1.16 (IO13), U3.1, U4.1
/VMOT: C10.1, J1.1, J15.1, R18.1

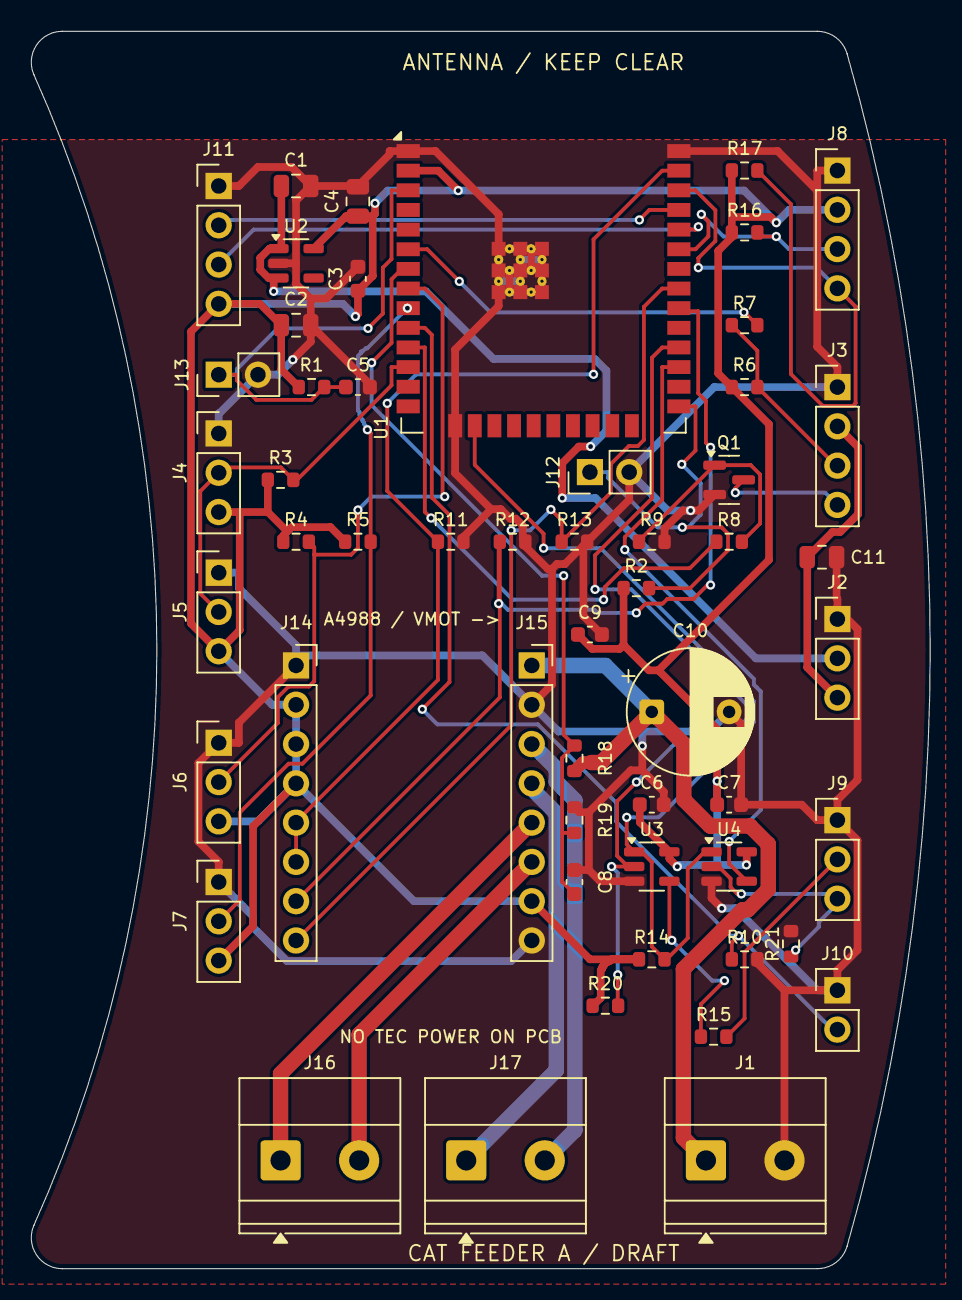
[picture p64: board feeder.kicad_pcb from above]

Board: 2 copper layers, 58.1 x 80.0 mm, 54 parts (0 on the bottom side), 34 nets.
