aquarat/cat-feeder/electronics/d34/d34-tec/d34-tec.kicad_pcb

## KiCad design electronics/d34/d34-tec/d34-tec.kicad_pcb (2026-11-01)

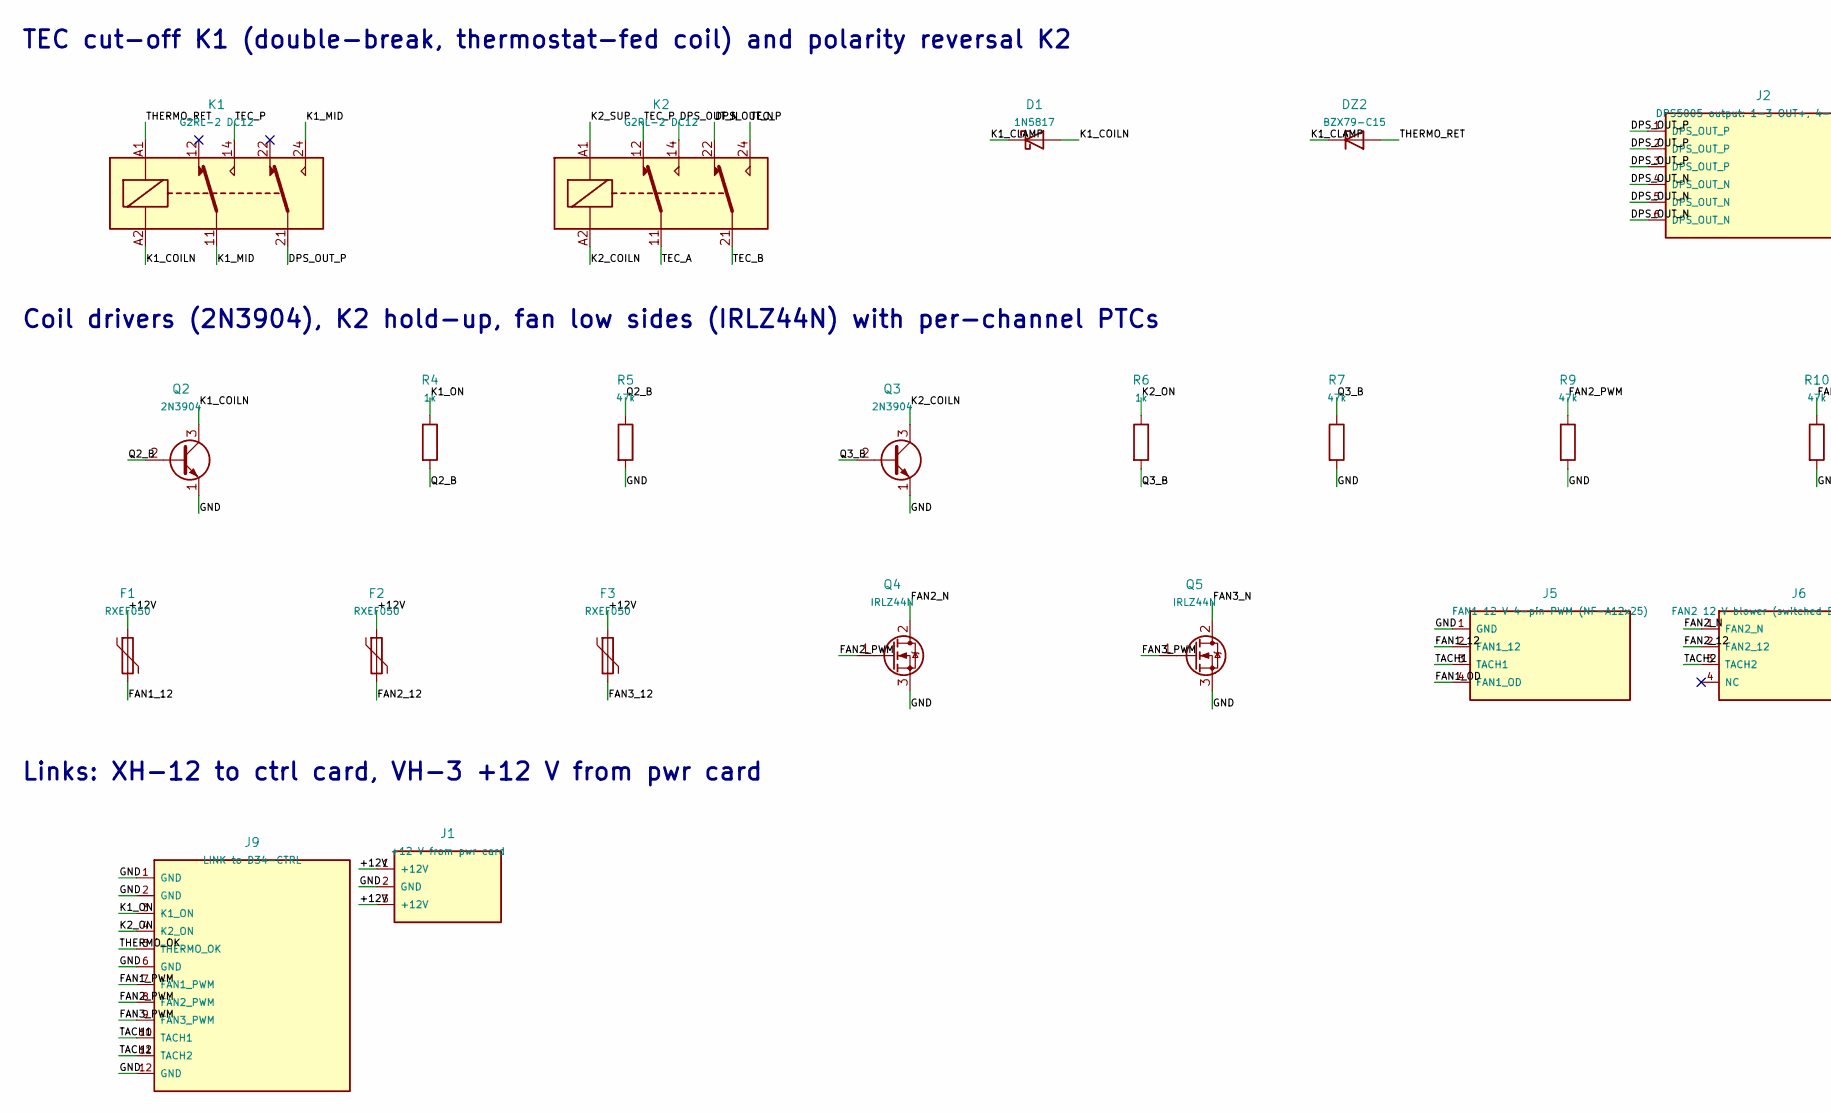
[picture p65: schematic d34-tec.kicad_sch, Cat feeder D34 TEC relay card (K1 cut-off, K2 reversal, fan…, part in row 1, column 1]

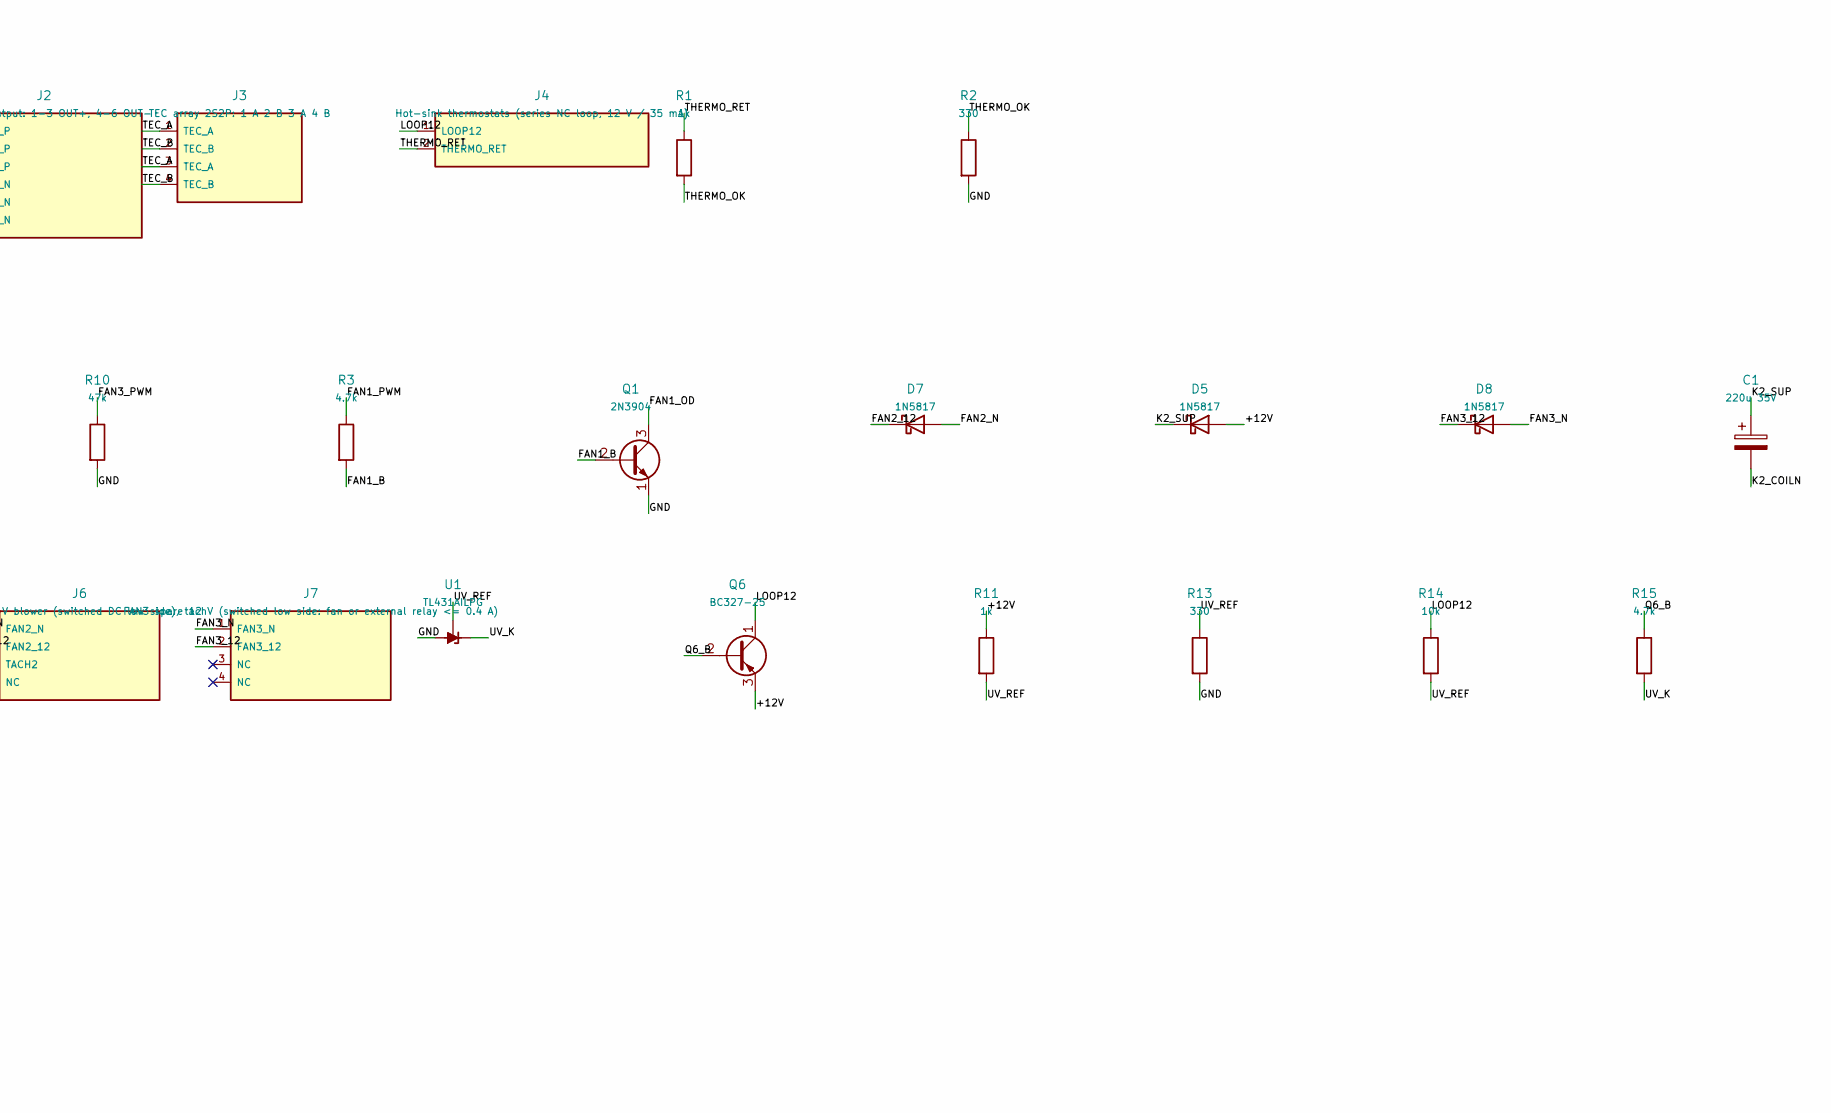
[picture p66: schematic d34-tec.kicad_sch, Cat feeder D34 TEC relay card (K1 cut-off, K2 reversal, fan…, part in row 1, column 2]

Parts:
C1: 220u 35V; CP_Radial_D8.0mm_P3.50mm; MPN EEU-FR1V221
D1, D5, D7, D8: 1N5817; D_DO-41_SOD81_P2.54mm_Vertical_AnodeUp; MPN 1N5817RLG
DZ2: BZX79-C15; D_DO-35_SOD27_P2.54mm_Vertical_AnodeUp; MPN BZX79-C15,133
F1, F2, F3: RXEF050; PTC_Radial_L8.0mm_W3.2mm_P5.08mm; MPN RXEF050
J1: +12 V from pwr card; JST_VH_B3P-VH_1x03_P3.96mm_Vertical; MPN B3P-VH(LF)(SN)
J2: DPS5005 output: 1-3 OUT+, 4-6 OUT-; Molex_Mini-Fit_Jr_5566-06A_2x03_P4.20mm_Vertical; MPN 39-28-1063 (5566-06A)
J3: TEC array 2S2P: 1 A 2 B 3 A 4 B; Molex_Mini-Fit_Jr_5566-04A_2x02_P4.20mm_Vertical; MPN 39-28-1043 (5566-04A)
J4: Hot-sink thermostats (series NC loop, 12 V / 35 m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; JST_VH_B2P-VH_1x02_P3.96mm_Vertical; MPN B2P-VH(LF)(SN)
J5: FAN1 12 V 4-pin PWM (NF-A12x25); FanPinHeader_1x04_P2.54mm_Vertical; MPN 47053-1000
J6: FAN2 12 V blower (switched DC low side), tach; FanPinHeader_1x04_P2.54mm_Vertical; MPN 47053-1000
J7: FAN3 spare 12 V (switched low side: fan or extern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; FanPinHeader_1x04_P2.54mm_Vertical; MPN 47053-1000
J9: LINK to D34-CTRL; JST_XH_B12B-XH-A_1x12_P2.50mm_Vertical; MPN B12B-XH-A(LF)(SN)
K1, K2: G2RL-2 DC12; Relay_DPDT_Omron_G2RL-2; MPN G2RL-2 DC12
Q1, Q2, Q3: 2N3904; TO-92_Inline_Wide; MPN 2N3904BU
Q4, Q5: IRLZ44N; TO-220-3_Vertical; MPN IRLZ44NPBF
Q6: BC327-25; TO-92_Inline_Wide; MPN BC32725BU
R1, R4, R6, R11: 1k; R_Axial_DIN0204_L3.6mm_D1.6mm_P2.54mm_Vertical; MPN MF0204FTE52-1K
R2, R13: 330; R_Axial_DIN0204_L3.6mm_D1.6mm_P2.54mm_Vertical; MPN MF0204FTE52-330R
R3, R15: 4.7k; R_Axial_DIN0204_L3.6mm_D1.6mm_P2.54mm_Vertical; MPN MF0204FTE52-4K7
R5, R7, R9, R10: 47k; R_Axial_DIN0204_L3.6mm_D1.6mm_P2.54mm_Vertical; MPN MF0204FTE52-47K
R14: 10k; R_Axial_DIN0204_L3.6mm_D1.6mm_P2.54mm_Vertical; MPN MF0204FTE52-10K
U1: TL431AILPG; TO-92_Inline_Wide; MPN TL431AILPG

Connections:
/+12V: D5.2 (A), F1.1, F2.1, F3.1, J1.1 (+12V), J1.3 (+12V), Q6.3 (E), R11.1
/DPS_OUT_N: J2.4 (DPS_OUT_N), J2.5 (DPS_OUT_N), J2.6 (DPS_OUT_N), K2.14, K2.22
/DPS_OUT_P: J2.1 (DPS_OUT_P), J2.2 (DPS_OUT_P), J2.3 (DPS_OUT_P), K1.21
/FAN1_12: F1.2, J5.2 (FAN1_12)
/FAN1_B: Q1.2 (B), R3.2
/FAN1_OD: J5.4 (FAN1_OD), Q1.3 (C)
/FAN1_PWM: J9.7 (FAN1_PWM), R3.1
/FAN2_12: D7.1 (K), F2.2, J6.2 (FAN2_12)
/FAN2_N: D7.2 (A), J6.1 (FAN2_N), Q4.2 (D)
/FAN2_PWM: J9.8 (FAN2_PWM), Q4.1 (G), R9.1
/FAN3_12: D8.1 (K), F3.2, J7.2 (FAN3_12)
/FAN3_N: D8.2 (A), J7.1 (FAN3_N), Q5.2 (D)
/FAN3_PWM: J9.9 (FAN3_PWM), Q5.1 (G), R10.1
/GND: J1.2 (GND), J5.1 (GND), J9.1 (GND), J9.2 (GND), J9.6 (GND), J9.12 (GND), Q1.1 (E), Q2.1 (E), Q3.1 (E), Q4.3 (S), Q5.3 (S), R2.2, R5.2, R7.2, R9.2, R10.2, R13.2, U1.2 (A)
/K1_CLAMP: D1.1 (K), DZ2.1 (K)
/K1_COILN: D1.2 (A), K1.A2, Q2.3 (C)
/K1_MID: K1.11, K1.24
/K1_ON: J9.3 (K1_ON), R4.1
/K2_COILN: C1.2, K2.A2, Q3.3 (C)
/K2_ON: J9.4 (K2_ON), R6.1
/K2_SUP: C1.1, D5.1 (K), K2.A1
/LOOP12: J4.1 (LOOP12), Q6.1 (C), R14.1
/Q2_B: Q2.2 (B), R4.2, R5.1
/Q3_B: Q3.2 (B), R6.2, R7.1
/Q6_B: Q6.2 (B), R15.1
/TACH1: J5.3 (TACH1), J9.10 (TACH1)
/TACH2: J6.3 (TACH2), J9.11 (TACH2)
/TEC_A: J3.1 (TEC_A), J3.3 (TEC_A), K2.11
/TEC_B: J3.2 (TEC_B), J3.4 (TEC_B), K2.21
/TEC_P: K1.14, K2.12, K2.24
/THERMO_OK: J9.5 (THERMO_OK), R1.2, R2.1
/THERMO_RET: DZ2.2 (A), J4.2 (THERMO_RET), K1.A1, R1.1
/UV_K: R15.2, U1.3 (K)
/UV_REF: R11.2, R13.1, R14.2, U1.1 (REF)

Notes on the sheet:
TEC cut-off K1 (double-break, thermostat-fed coil) and polarity reversal K2
Coil drivers (2N3904), K2 hold-up, fan low sides (IRLZ44N) with per-channel PTCs
Links: XH-12 to ctrl card, VH-3 +12 V from pwr card

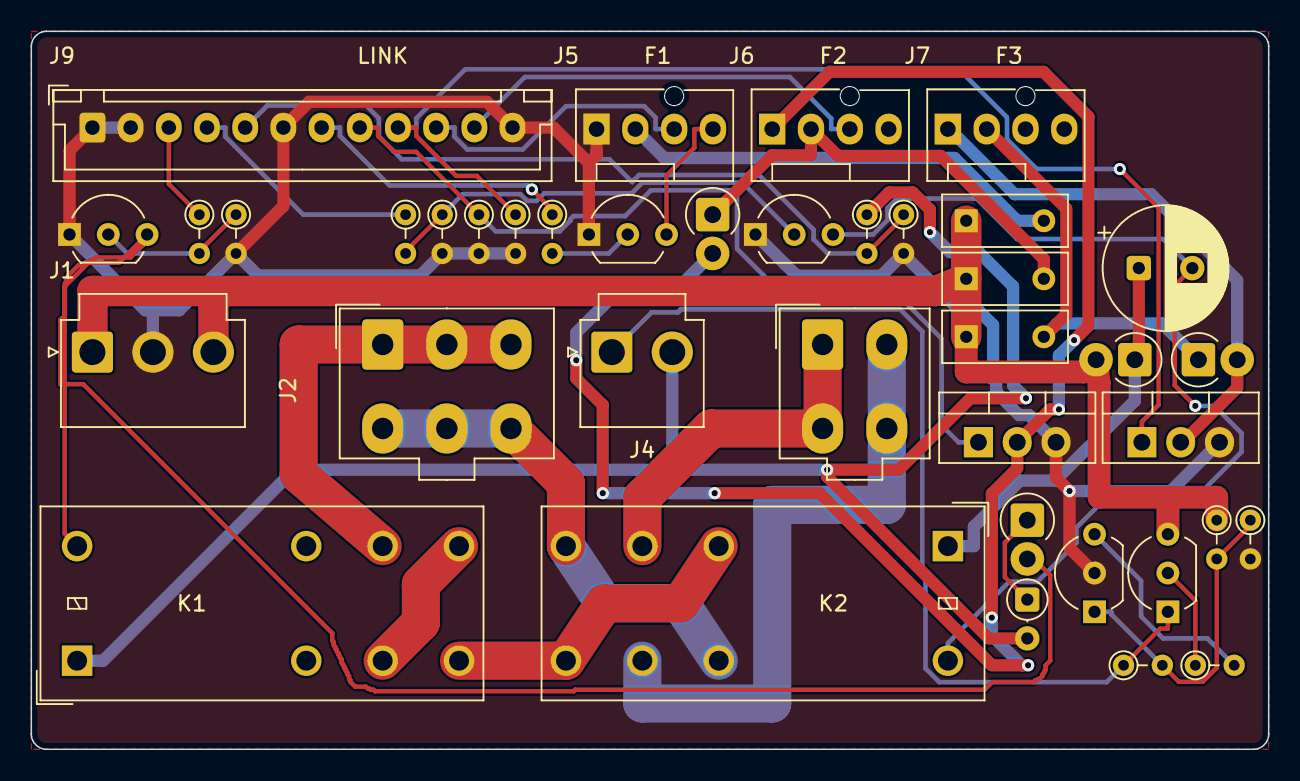
[picture p67: board d34-tec.kicad_pcb from above]

Board: 2 copper layers, 81.0 x 47.0 mm, 39 parts (0 on the bottom side), 34 nets.
