aquarat/cat-feeder/electronics/d34/d34-ctrl/d34-ctrl.kicad_pcb

## KiCad design electronics/d34/d34-ctrl/d34-ctrl.kicad_pcb (2026-11-01)

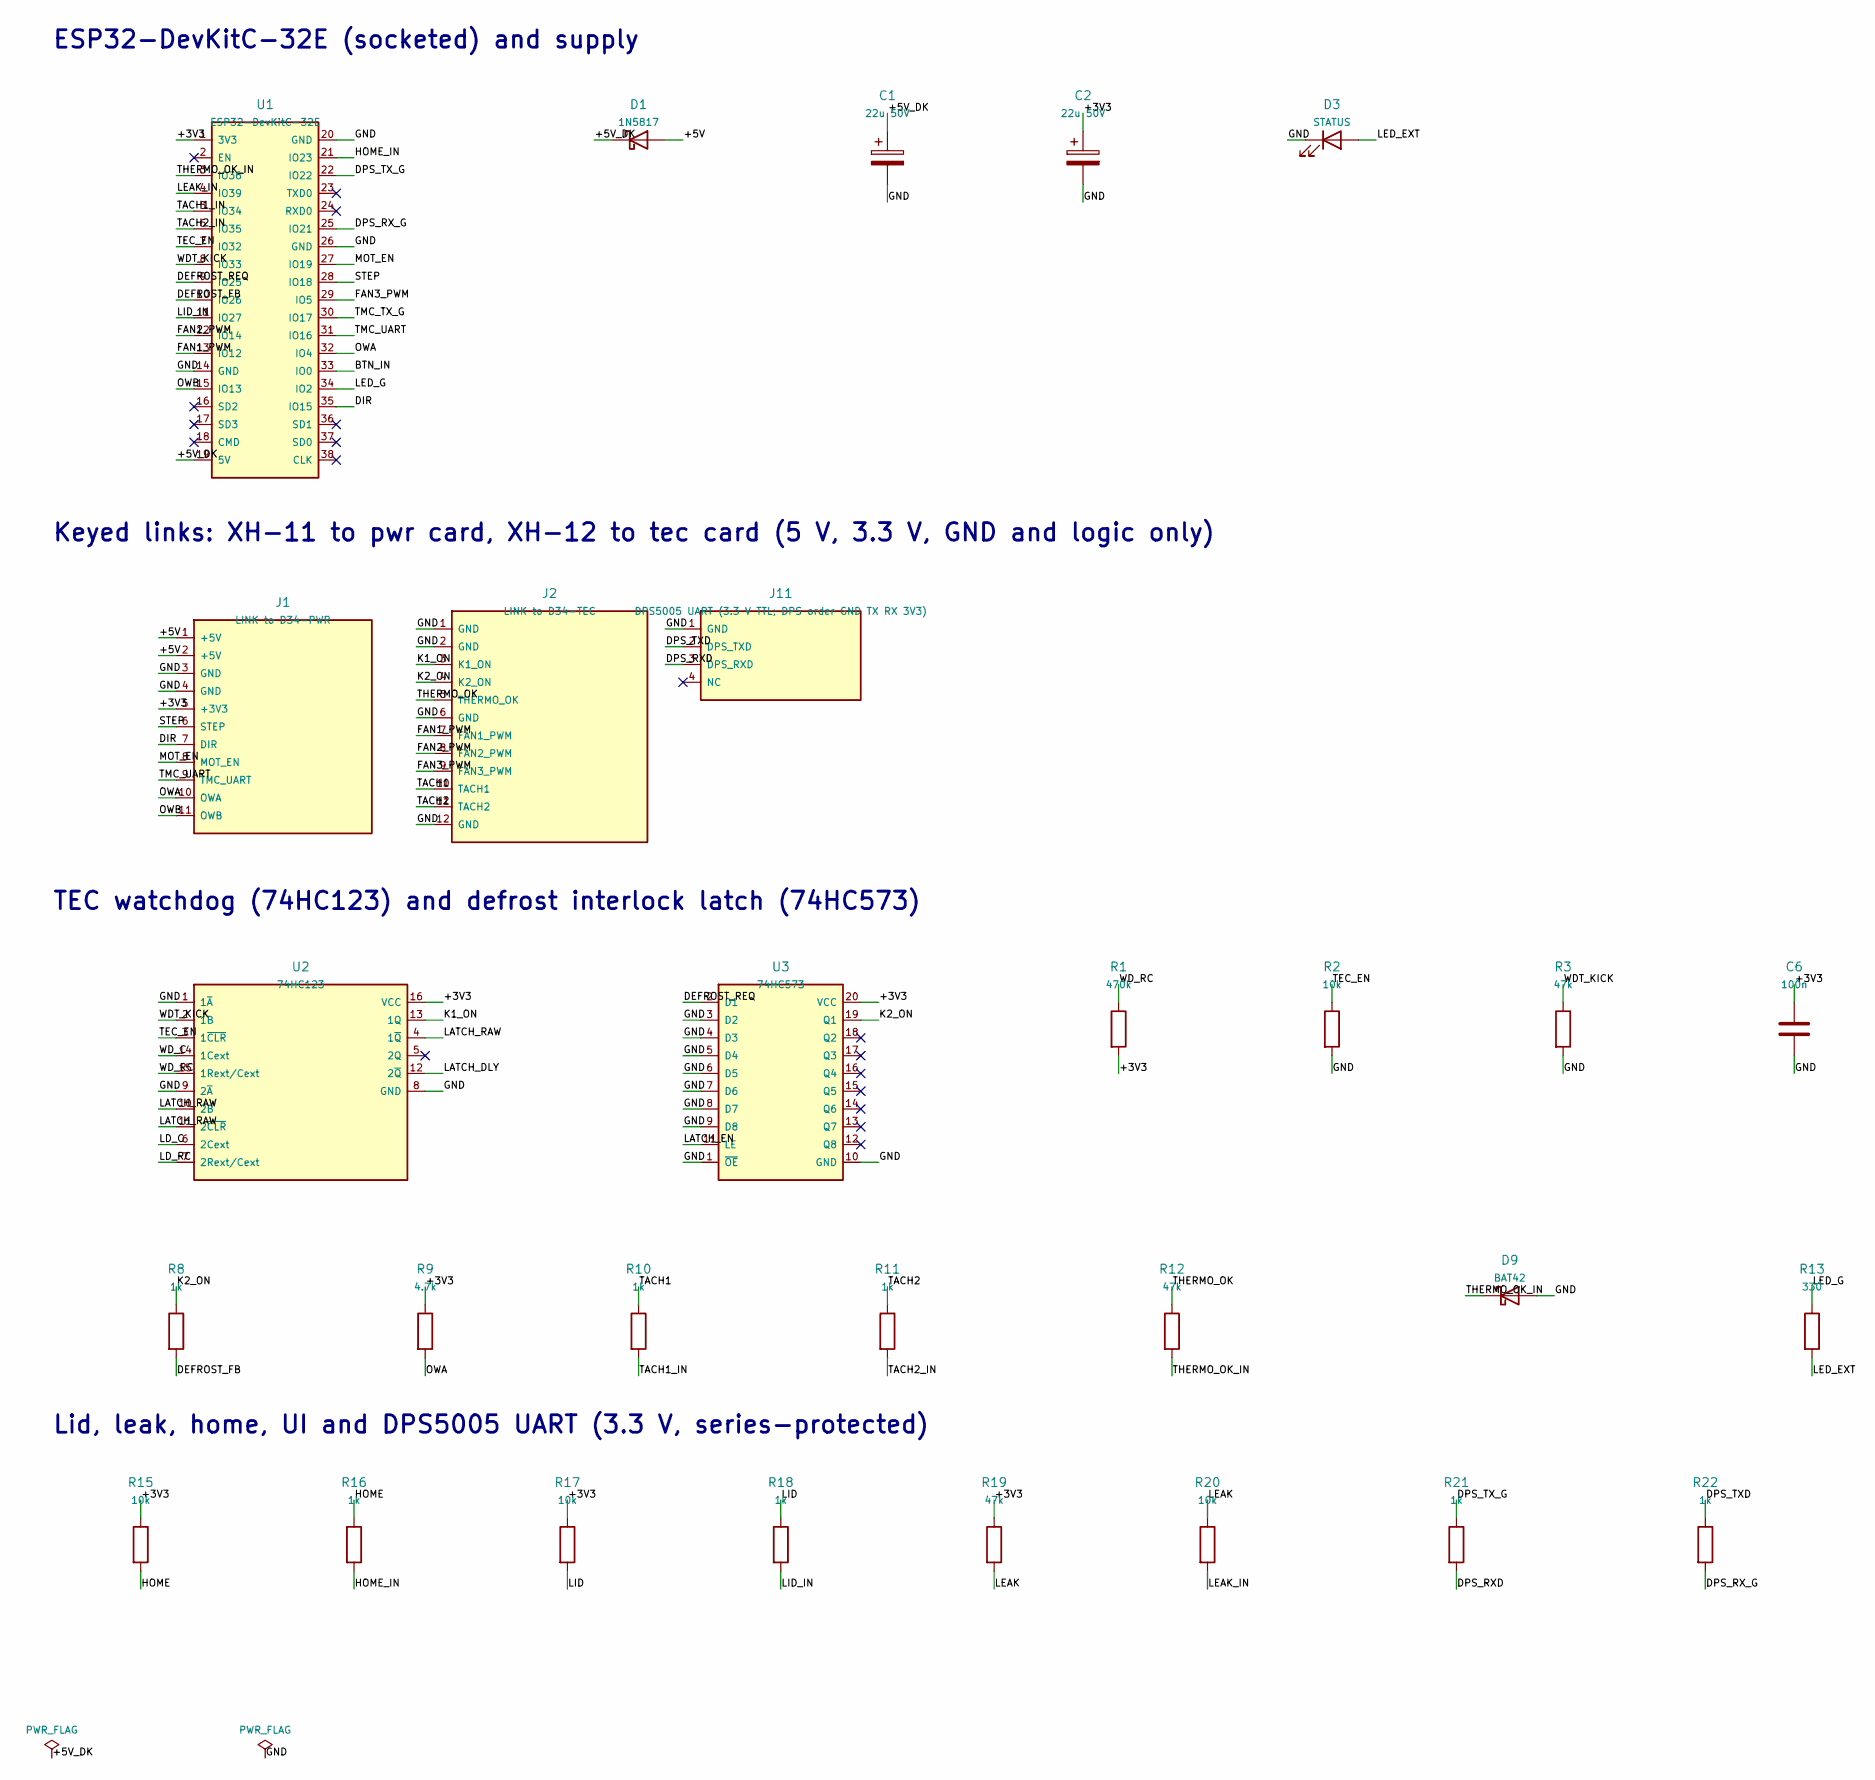
[picture p68: schematic d34-ctrl.kicad_sch, Cat feeder D34 controller card (logic, 45 deg bay), part in row 1, column 1]

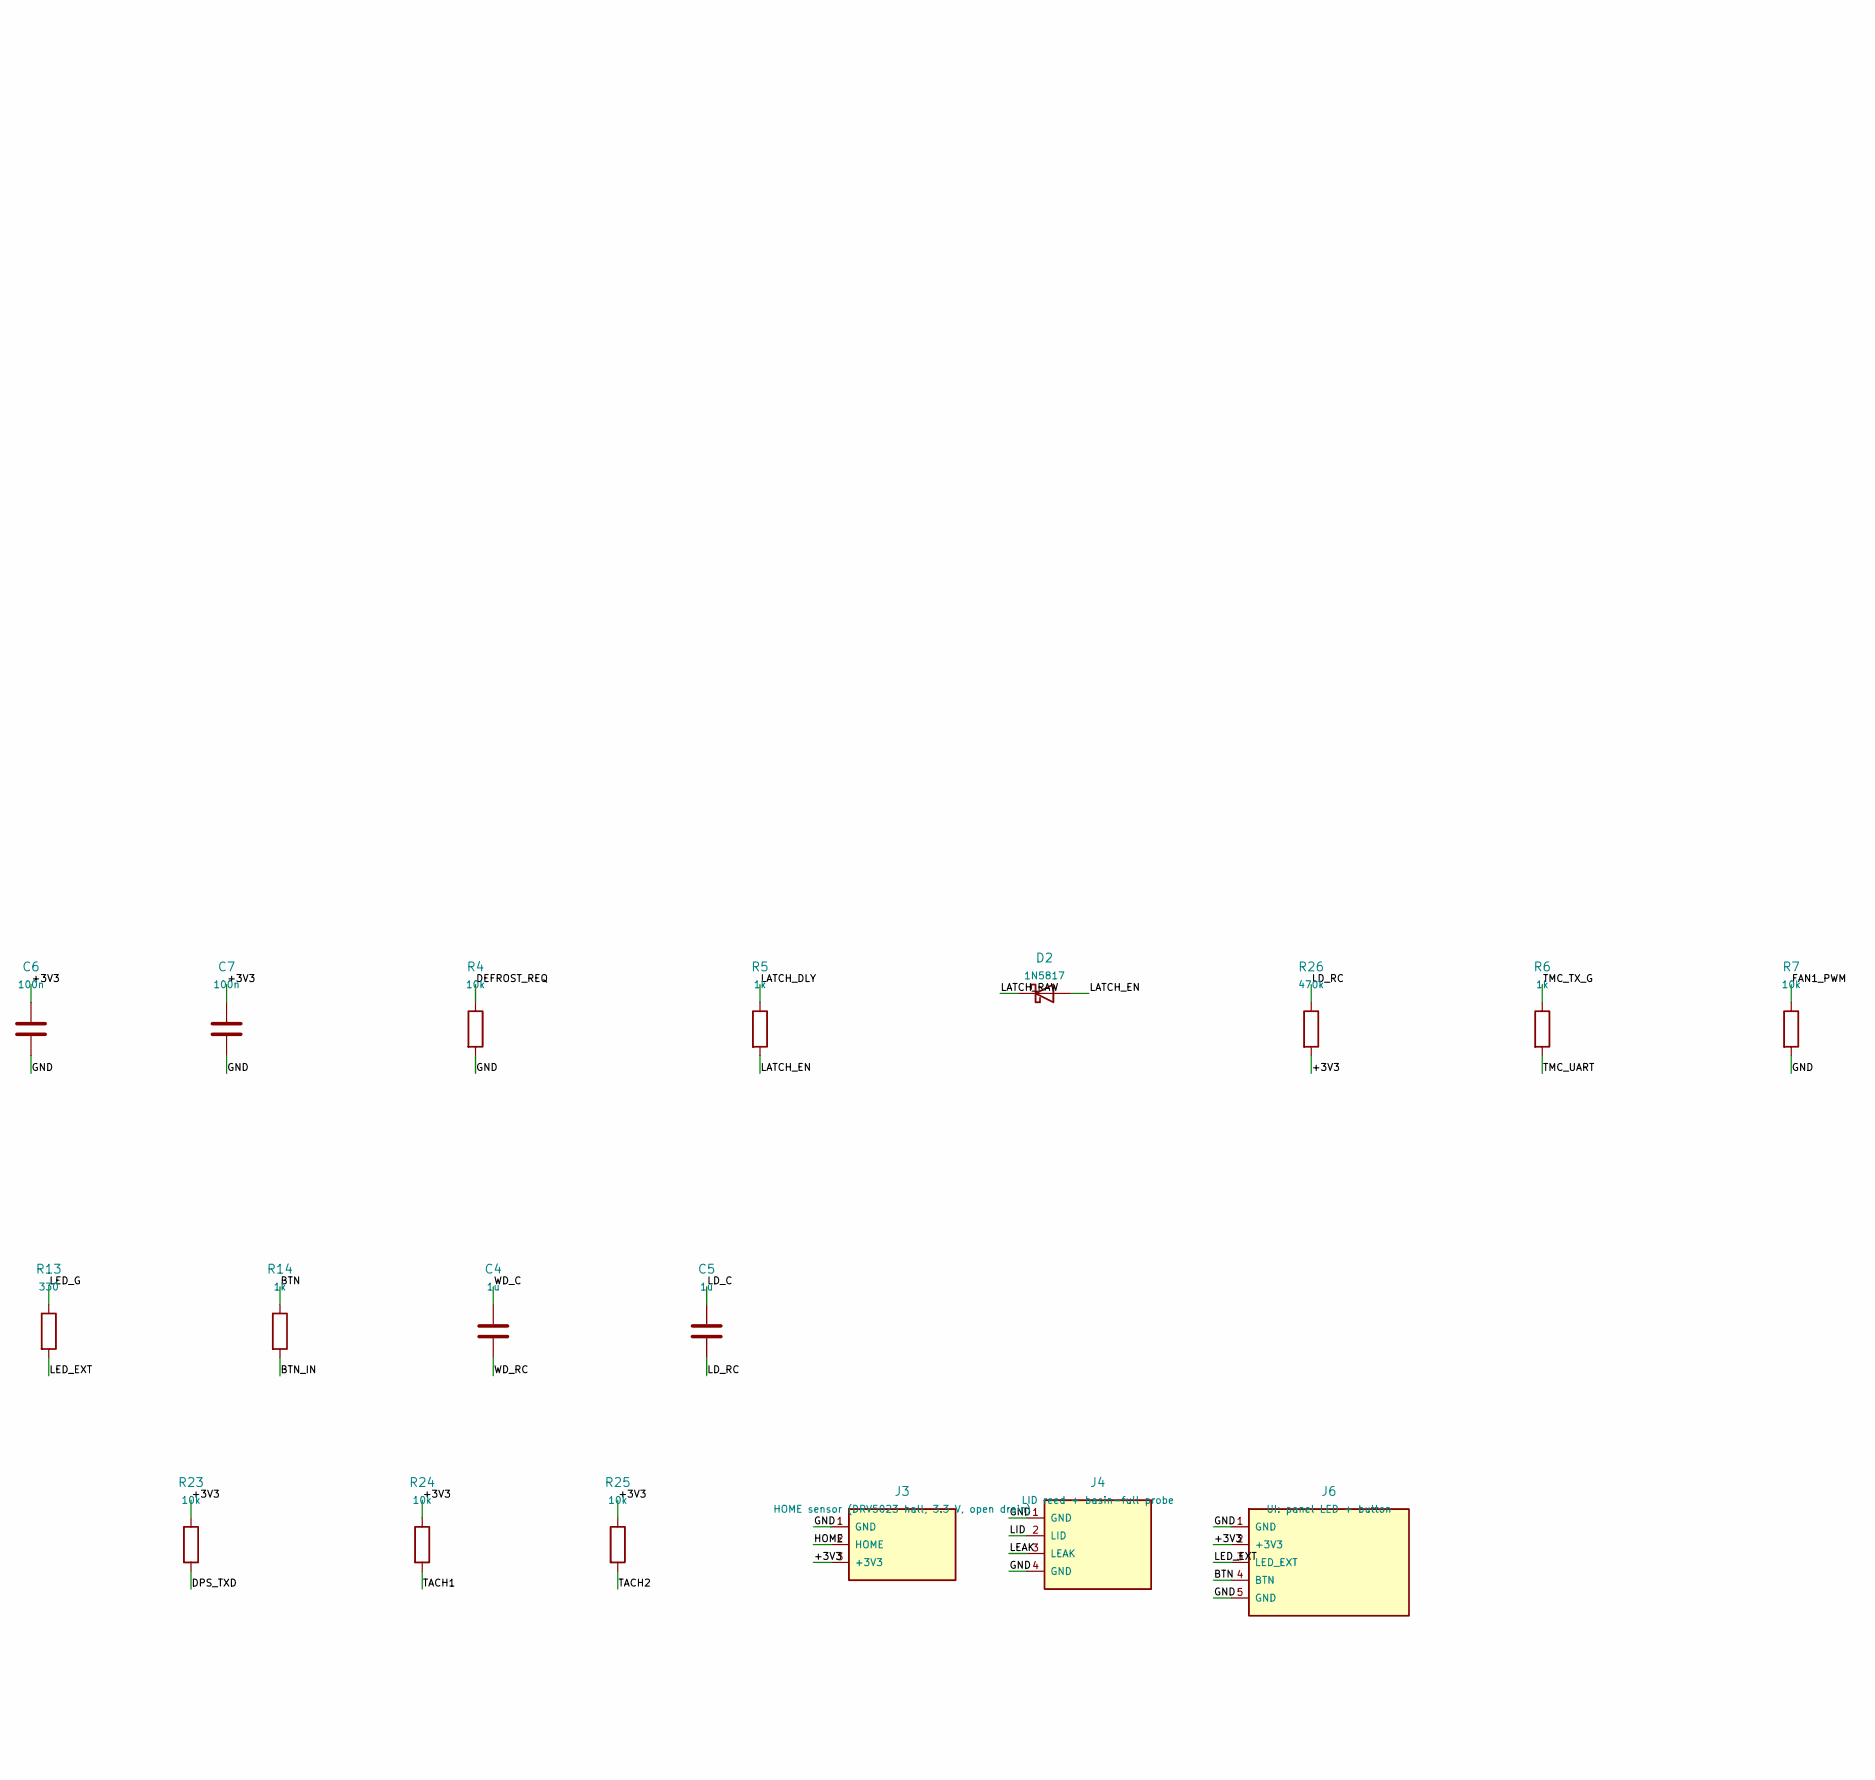
[picture p69: schematic d34-ctrl.kicad_sch, Cat feeder D34 controller card (logic, 45 deg bay), part in row 1, column 2]

Parts:
C1, C2: 22u 50V; CP_Radial_D5.0mm_P2.00mm; MPN 50YXF22M5X11
C4, C5: 1u; C_Rect_L5.5mm_W3.2mm_P2.50mm; MPN RDER71H105K2P1H03B
C6, C7: 100n; C_Rect_L4.0mm_W2.5mm_P2.50mm; MPN RDER71H104K0P1H03B
D1: 1N5817; D_DO-41_SOD81_P10.16mm_Horizontal; MPN 1N5817RLG
D2: 1N5817; D_DO-41_SOD81_P2.54mm_Vertical_AnodeUp; MPN 1N5817RLG
D3: STATUS; LED_D3.0mm; MPN HLMP-1503
D9: BAT42; D_DO-35_SOD27_P2.54mm_Vertical_AnodeUp; MPN BAT42
J1: LINK to D34-PWR; JST_XH_B11B-XH-A_1x11_P2.50mm_Vertical; MPN B11B-XH-A(LF)(SN)
J2: LINK to D34-TEC; JST_XH_B12B-XH-A_1x12_P2.50mm_Vertical; MPN B12B-XH-A(LF)(SN)
J3: HOME sensor (DRV5023 hall, 3.3 V, open drain); JST_XH_B3B-XH-A_1x03_P2.50mm_Vertical; MPN B3B-XH-A(LF)(SN)
J4: LID reed + basin-full probe; JST_XH_B4B-XH-A_1x04_P2.50mm_Vertical; MPN B4B-XH-A(LF)(SN)
J6: UI: panel LED + button; JST_XH_B5B-XH-A_1x05_P2.50mm_Vertical; MPN B5B-XH-A(LF)(SN)
J11: DPS5005 UART (3.3 V TTL; DPS order GND TX RX 3V3); JST_XH_B4B-XH-A_1x04_P2.50mm_Vertical; MPN B4B-XH-A(LF)(SN)
R1: 470k; R_Axial_DIN0204_L3.6mm_D1.6mm_P7.62mm_Horizontal; MPN MBA02040C4703FRP00
R2, R4, R7, R15, R17, R20, R23, R24, R25: 10k; R_Axial_DIN0204_L3.6mm_D1.6mm_P7.62mm_Horizontal; MPN MF0204FTE52-10K
R3, R12, R19: 47k; R_Axial_DIN0204_L3.6mm_D1.6mm_P7.62mm_Horizontal; MPN MF0204FTE52-47K
R5, R6, R8, R10, R11, R14, R16, R18, R21, R22: 1k; R_Axial_DIN0204_L3.6mm_D1.6mm_P7.62mm_Horizontal; MPN MF0204FTE52-1K
R9: 4.7k; R_Axial_DIN0204_L3.6mm_D1.6mm_P7.62mm_Horizontal; MPN MF0204FTE52-4K7
R13: 330; R_Axial_DIN0204_L3.6mm_D1.6mm_P7.62mm_Horizontal; MPN MF0204FTE52-330R
R26: 470k; R_Axial_DIN0204_L3.6mm_D1.6mm_P2.54mm_Vertical; MPN MBA02040C4703FRP00
U1: ESP32-DevKitC-32E; ESP32-DevKitC-32E_Socket; MPN SSW-119-01-T-S
U2: 74HC123; DIP-16_W7.62mm; MPN TC74HC123AP(F)
U3: 74HC573; DIP-20_W7.62mm; MPN SN74HC573AN

Connections:
/+3V3: C2.1, C6.1, C7.1, J1.5 (+3V3), J3.3 (+3V3), J6.2 (+3V3), R1.2, R9.1, R15.1, R17.1, R19.1, R23.1, R24.1, R25.1, R26.2, U1.1 (3V3), U2.16 (VCC), U3.20 (VCC)
/+5V: D1.2 (A), J1.1 (+5V), J1.2 (+5V)
/+5V_DK: C1.1, D1.1 (K), U1.19 (5V)
/BTN: J6.4 (BTN), R14.1
/BTN_IN: R14.2, U1.33 (IO0)
/DEFROST_FB: R8.2, U1.10 (IO26)
/DEFROST_REQ: R4.1, U1.9 (IO25), U3.2 (D1)
/DIR: J1.7 (DIR), U1.35 (IO15)
/DPS_RXD: J11.3 (DPS_RXD), R21.2
/DPS_RX_G: R22.2, U1.25 (IO21)
/DPS_TXD: J11.2 (DPS_TXD), R22.1, R23.2
/DPS_TX_G: R21.1, U1.22 (IO22)
/FAN1_PWM: J2.7 (FAN1_PWM), R7.1, U1.13 (IO12)
/FAN2_PWM: J2.8 (FAN2_PWM), U1.12 (IO14)
/FAN3_PWM: J2.9 (FAN3_PWM), U1.29 (IO5)
/GND: C1.2, C2.2, C6.2, C7.2, D3.1 (K), D9.2 (A), J1.3 (GND), J1.4 (GND), J2.1 (GND), J2.2 (GND), J2.6 (GND), J2.12 (GND), J3.1 (GND), J4.1 (GND), J4.4 (GND), J6.1 (GND), J6.5 (GND), J11.1 (GND), R2.2, R3.2, R4.2, R7.2, U1.14 (GND), U1.20 (GND), U1.26 (GND), U2.1 (1~A), U2.8 (GND), U2.9 (2~A), U3.1 (~OE), U3.3 (D2), U3.4 (D3), U3.5 (D4), U3.6 (D5), U3.7 (D6), U3.8 (D7), U3.9 (D8), U3.10 (GND)
/HOME: J3.2 (HOME), R15.2, R16.1
/HOME_IN: R16.2, U1.21 (IO23)
/K1_ON: J2.3 (K1_ON), U2.13 (1Q)
/K2_ON: J2.4 (K2_ON), R8.1, U3.19 (Q1)
/LATCH_DLY: R5.1, U2.12 (2~Q)
/LATCH_EN: D2.2 (A), R5.2, U3.11 (LE)
/LATCH_RAW: D2.1 (K), U2.4 (1~Q), U2.10 (2B), U2.11 (2~CLR)
/LD_C: C5.1, U2.6 (2Cext)
/LD_RC: C5.2, R26.1, U2.7 (2Rext/Cext)
/LEAK: J4.3 (LEAK), R19.2, R20.1
/LEAK_IN: R20.2, U1.4 (IO39)
/LED_EXT: D3.2 (A), J6.3 (LED_EXT), R13.2
/LED_G: R13.1, U1.34 (IO2)
/LID: J4.2 (LID), R17.2, R18.1
/LID_IN: R18.2, U1.11 (IO27)
/MOT_EN: J1.8 (MOT_EN), U1.27 (IO19)
/OWA: J1.10 (OWA), R9.2, U1.32 (IO4)
/OWB: J1.11 (OWB), U1.15 (IO13)
/STEP: J1.6 (STEP), U1.28 (IO18)
/TACH1: J2.10 (TACH1), R10.1, R24.2
/TACH1_IN: R10.2, U1.5 (IO34)
/TACH2: J2.11 (TACH2), R11.1, R25.2
/TACH2_IN: R11.2, U1.6 (IO35)
/TEC_EN: R2.1, U1.7 (IO32), U2.3 (1~CLR)
/THERMO_OK: J2.5 (THERMO_OK), R12.1
/THERMO_OK_IN: D9.1 (K), R12.2, U1.3 (IO36)
/TMC_TX_G: R6.1, U1.30 (IO17)
/TMC_UART: J1.9 (TMC_UART), R6.2, U1.31 (IO16)
/WDT_KICK: R3.1, U1.8 (IO33), U2.2 (1B)
/WD_C: C4.1, U2.14 (1Cext)
/WD_RC: C4.2, R1.1, U2.15 (1Rext/Cext)

Notes on the sheet:
ESP32-DevKitC-32E (socketed) and supply
Keyed links: XH-11 to pwr card, XH-12 to tec card (5 V, 3.3 V, GND and logic only)
TEC watchdog (74HC123) and defrost interlock latch (74HC573)
Lid, leak, home, UI and DPS5005 UART (3.3 V, series-protected)

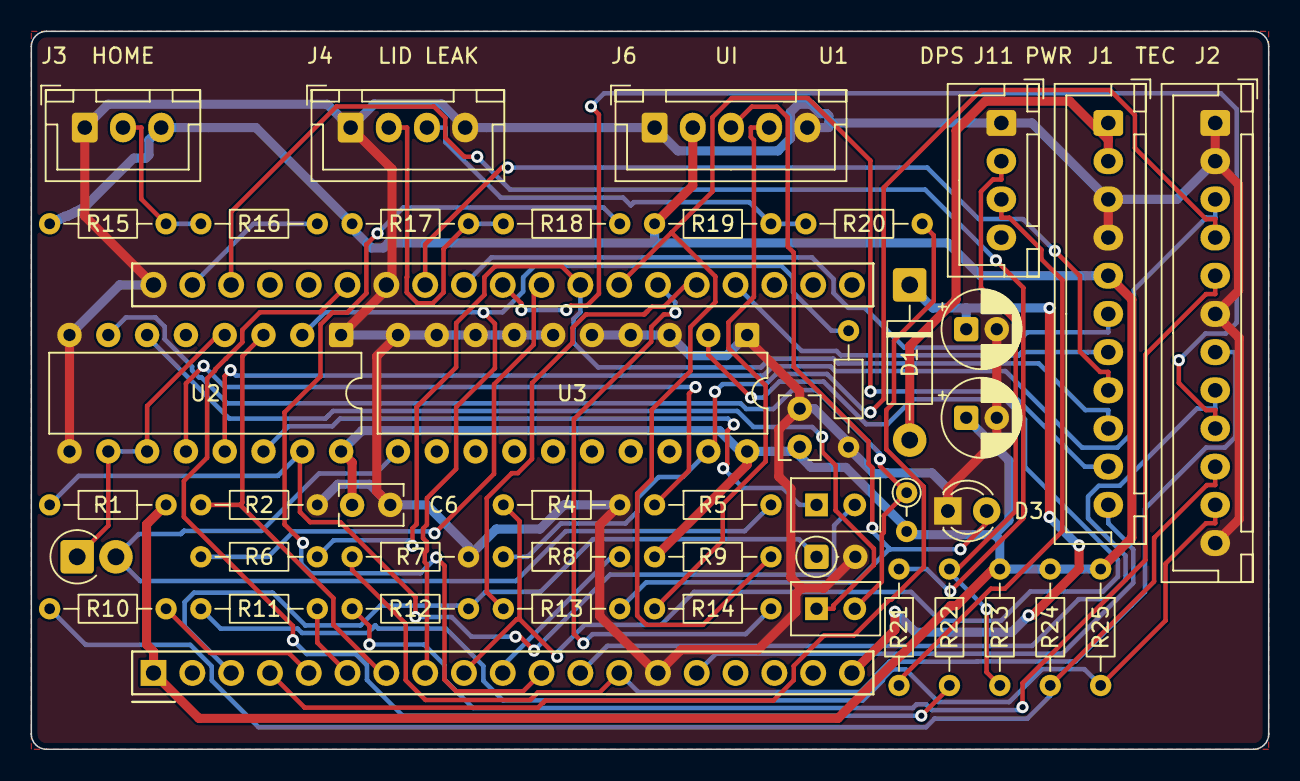
[picture p70: board d34-ctrl.kicad_pcb from above]

Board: 2 copper layers, 81.0 x 47.0 mm, 45 parts (0 on the bottom side), 47 nets.
