aquarat/cat-feeder/electronics/d34/d34-pwr/d34-pwr.kicad_pcb

## KiCad design electronics/d34/d34-pwr/d34-pwr.kicad_pcb (2026-11-01)

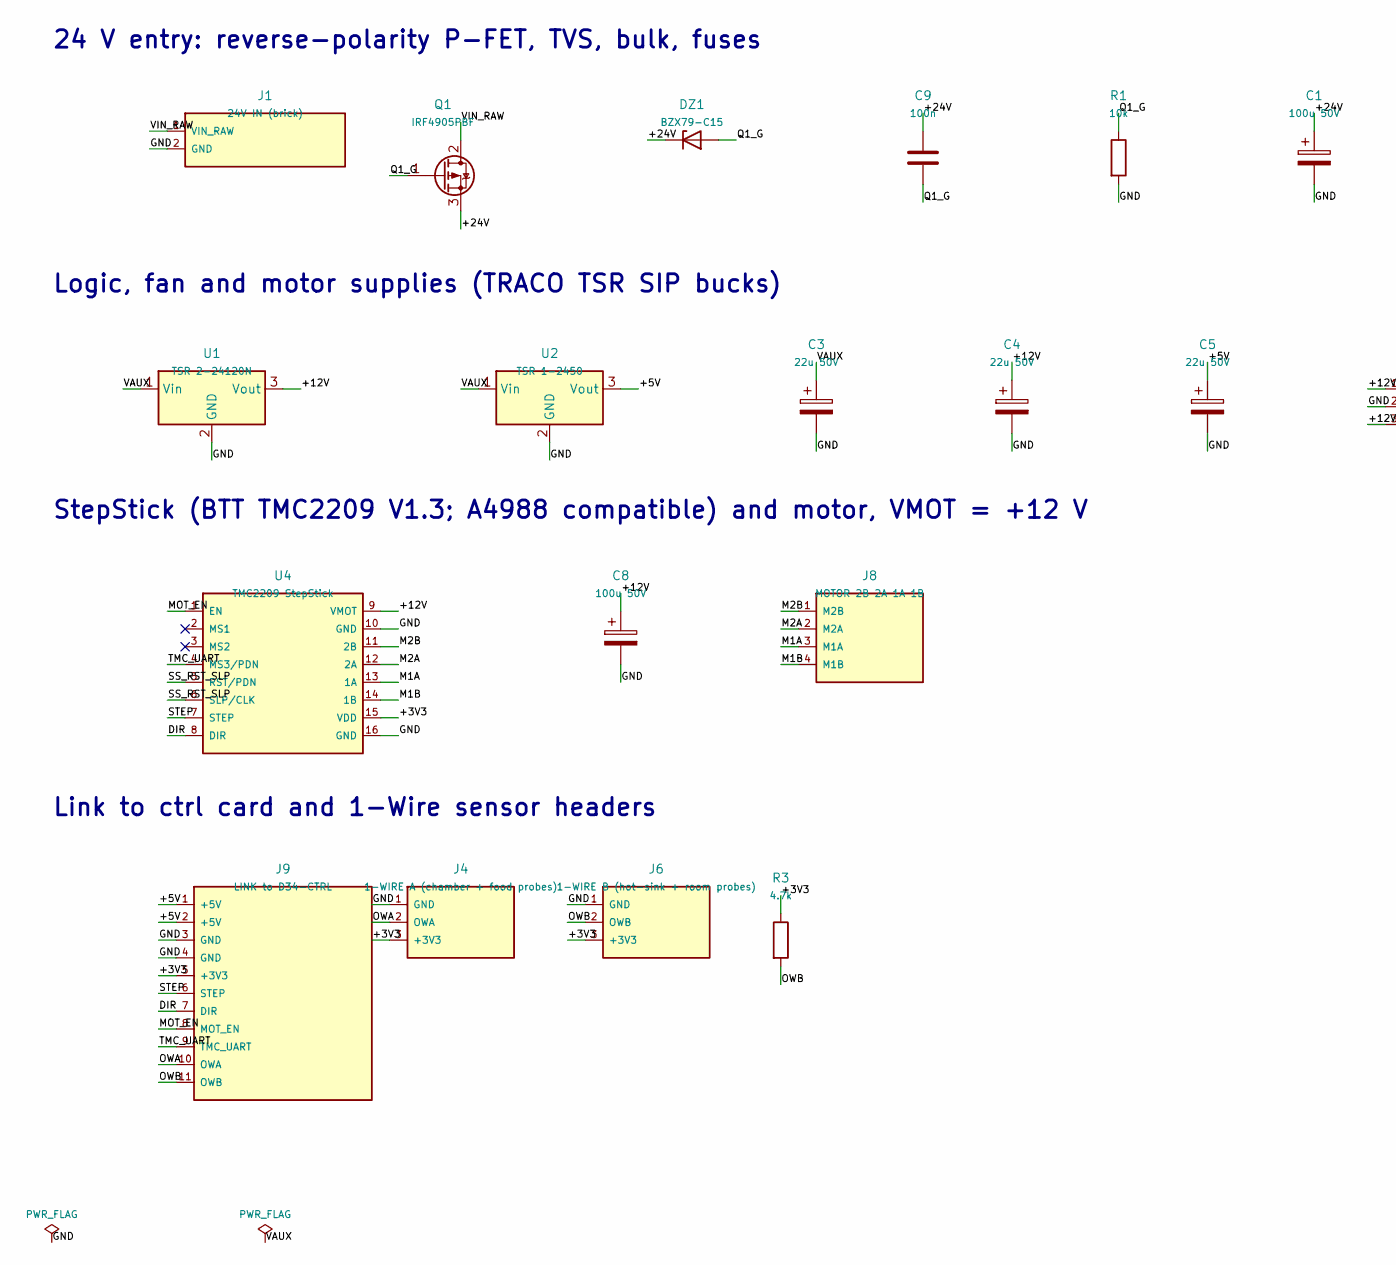
[picture p71: schematic d34-pwr.kicad_sch, Cat feeder D34 power card (24 V entry, bucks, DPS feed, ste…, part in row 1, column 1]

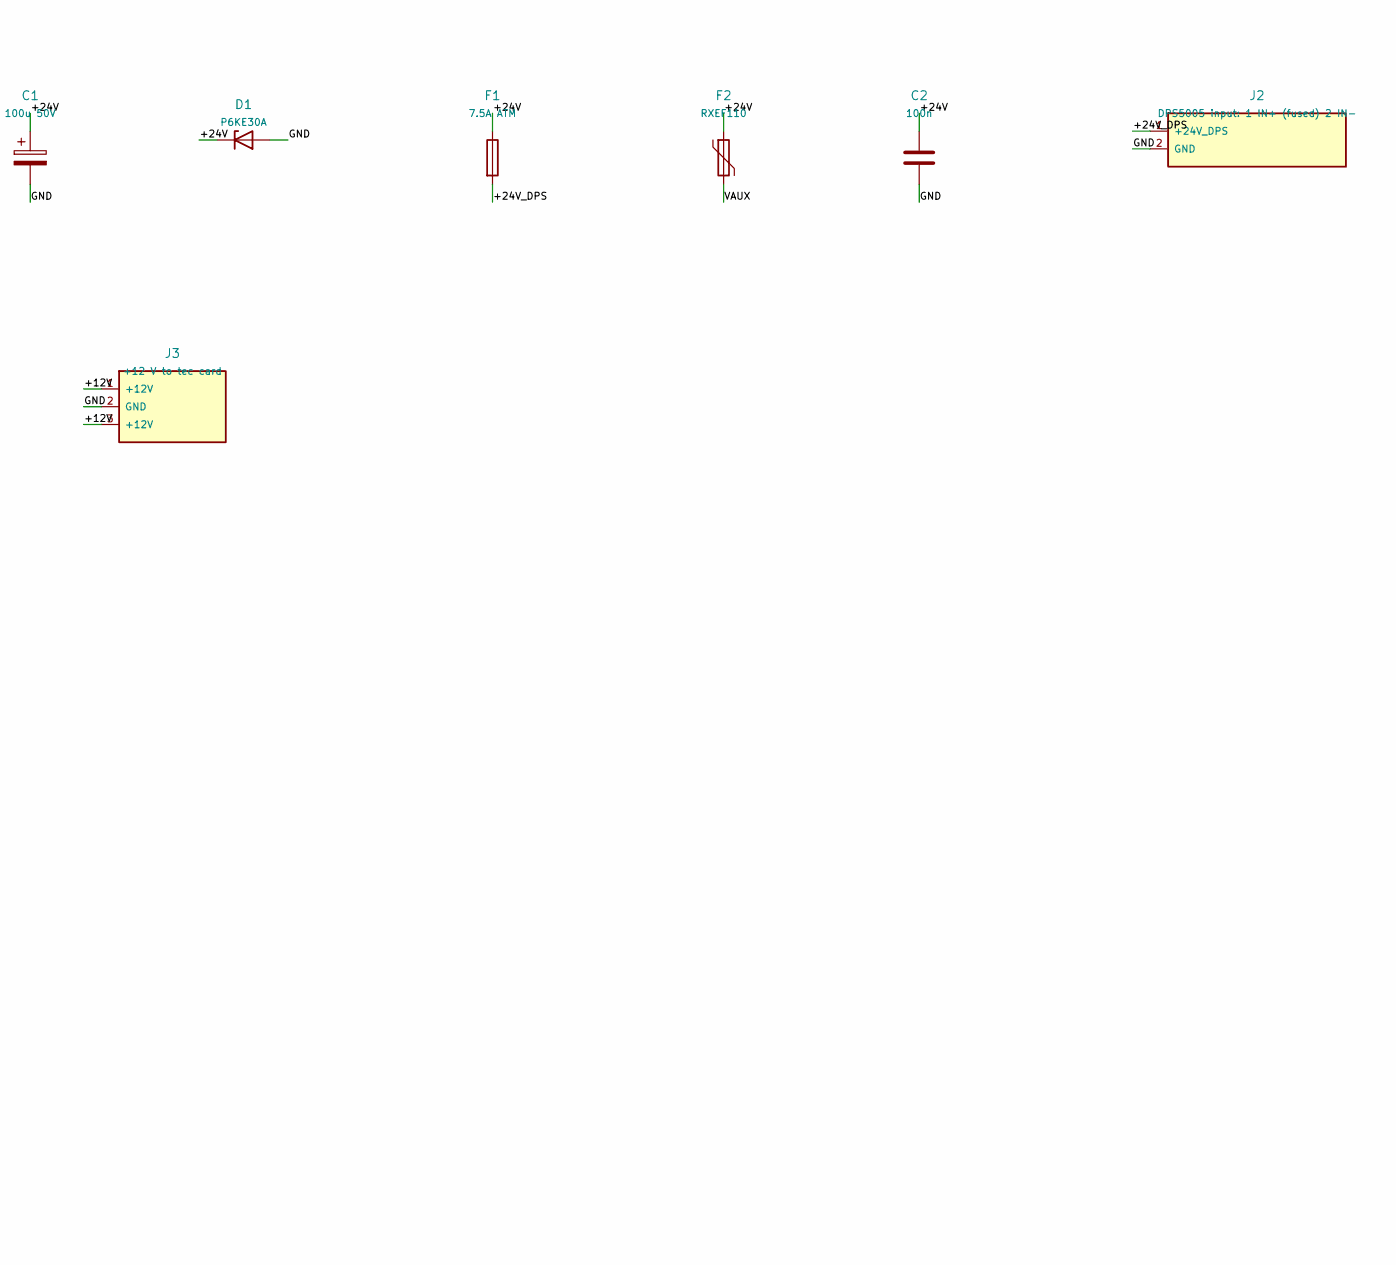
[picture p72: schematic d34-pwr.kicad_sch, Cat feeder D34 power card (24 V entry, bucks, DPS feed, ste…, part in row 1, column 2]

Parts:
C1, C8: 100u 50V; CP_Radial_D8.0mm_P3.50mm; MPN EEU-FR1H101
C2, C9: 100n; C_Rect_L4.0mm_W2.5mm_P2.50mm; MPN RDER71H104K0P1H03B
C3, C4, C5: 22u 50V; CP_Radial_D5.0mm_P2.00mm; MPN 50YXF22M5X11
D1: P6KE30A; D_DO-15_P12.70mm_Horizontal; MPN P6KE30A
DZ1: BZX79-C15; D_DO-35_SOD27_P7.62mm_Horizontal; MPN BZX79-C15,133
F1: 7.5A ATM; Fuseholder_Blade_Mini_Keystone_3568; MPN 3568
F2: RXEF110; PTC_Radial_L13.0mm_W3.2mm_P5.08mm; MPN RXEF110
J1: 24V IN (brick); Molex_Mini-Fit_Jr_5566-02A_2x01_P4.20mm_Vertical; MPN 39-28-1023 (5566-02A)
J2: DPS5005 input: 1 IN+ (fused) 2 IN-; PhoenixContact_MSTBVA_2,5_2-G-5,08_1x02_P5.08mm_Vertical; MPN MSTBVA 2,5/2-G-5,08 (1755736)
J3: +12 V to tec card; JST_VH_B3P-VH_1x03_P3.96mm_Vertical; MPN B3P-VH(LF)(SN)
J4: 1-WIRE A (chamber + food probes); JST_XH_B3B-XH-A_1x03_P2.50mm_Vertical; MPN B3B-XH-A(LF)(SN)
J6: 1-WIRE B (hot-sink + room probes); JST_XH_B3B-XH-A_1x03_P2.50mm_Vertical; MPN B3B-XH-A(LF)(SN)
J8: MOTOR 2B 2A 1A 1B; JST_VH_B4P-VH_1x04_P3.96mm_Vertical; MPN B4P-VH(LF)(SN)
J9: LINK to D34-CTRL; JST_XH_B11B-XH-A_1x11_P2.50mm_Vertical; MPN B11B-XH-A(LF)(SN)
Q1: IRF4905PBF; TO-220-3_Vertical; MPN IRF4905PBF
R1: 10k; R_Axial_DIN0204_L3.6mm_D1.6mm_P7.62mm_Horizontal; MPN MF0204FTE52-10K
R3: 4.7k; R_Axial_DIN0204_L3.6mm_D1.6mm_P7.62mm_Horizontal; MPN MF0204FTE52-4K7
U1: TSR 2-24120N; Converter_DCDC_TRACO_TSR2-24xxN_TSR2-24xxxN_THT; MPN TSR 2-24120N
U2: TSR 1-2450; Converter_DCDC_TRACO_TSR-1_THT; MPN TSR 1-2450
U4: TMC2209 StepStick; StepStick_Socket_2x8_W12.70mm; MPN SSW-108-01-T-S

Connections:
/+3V3: J4.3 (+3V3), J6.3 (+3V3), J9.5 (+3V3), R3.1, U4.15 (VDD)
/+5V: C5.1, J9.1 (+5V), J9.2 (+5V), U2.3 (Vout)
/+12V: C4.1, C8.1, J3.1 (+12V), J3.3 (+12V), U1.3 (Vout), U4.9 (VMOT)
/+24V: C1.1, C2.1, C9.1, D1.1 (K), DZ1.1 (K), F1.1, F2.1, Q1.3 (S)
/+24V_DPS: F1.2, J2.1 (+24V_DPS)
/DIR: J9.7 (DIR), U4.8 (DIR)
/GND: C1.2, C2.2, C3.2, C4.2, C5.2, C8.2, D1.2 (A), J1.2 (GND), J2.2 (GND), J3.2 (GND), J4.1 (GND), J6.1 (GND), J9.3 (GND), J9.4 (GND), R1.2, U1.2 (GND), U2.2 (GND), U4.10 (GND), U4.16 (GND)
/M1A: J8.3 (M1A), U4.13 (1A)
/M1B: J8.4 (M1B), U4.14 (1B)
/M2A: J8.2 (M2A), U4.12 (2A)
/M2B: J8.1 (M2B), U4.11 (2B)
/MOT_EN: J9.8 (MOT_EN), U4.1 (EN)
/OWA: J4.2 (OWA), J9.10 (OWA)
/OWB: J6.2 (OWB), J9.11 (OWB), R3.2
/Q1_G: C9.2, DZ1.2 (A), Q1.1 (G), R1.1
/SS_RST_SLP: U4.5 (RST/PDN), U4.6 (SLP/CLK)
/STEP: J9.6 (STEP), U4.7 (STEP)
/TMC_UART: J9.9 (TMC_UART), U4.4 (MS3/PDN)
/VAUX: C3.1, F2.2, U1.1 (Vin), U2.1 (Vin)
/VIN_RAW: J1.1 (VIN_RAW), Q1.2 (D)

Notes on the sheet:
24 V entry: reverse-polarity P-FET, TVS, bulk, fuses
Logic, fan and motor supplies (TRACO TSR SIP bucks)
StepStick (BTT TMC2209 V1.3; A4988 compatible) and motor, VMOT = +12 V
Link to ctrl card and 1-Wire sensor headers

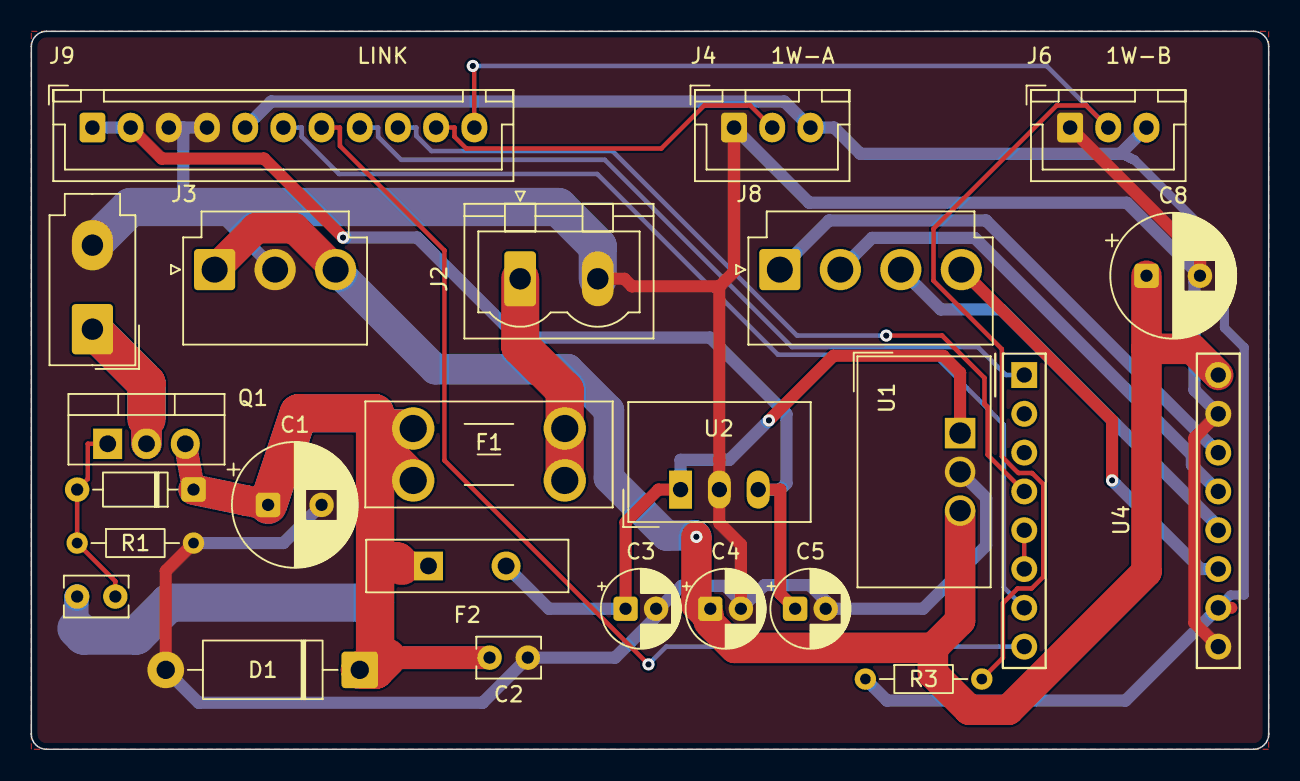
[picture p73: board d34-pwr.kicad_pcb from above]

Board: 2 copper layers, 81.0 x 47.0 mm, 24 parts (0 on the bottom side), 20 nets.
