aquarat/cat-feeder/electronics/revb/power/fan-placement.kicad_pcb

## KiCad design electronics/revb/power/fan-placement.kicad_pcb (2026-11-01)

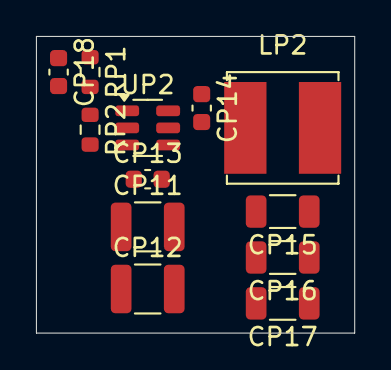
[picture p74: board fan-placement.kicad_pcb from above]

Board: 2 copper layers, 17.7 x 16.5 mm, 12 parts (0 on the bottom side), 6 nets, no tracks yet.

Parts:
CP11, CP12: 10u 50V X7R; C_1210_3225Metric
CP13, CP14: 100n 50V X7R; C_0603_1608Metric
CP15, CP16, CP17: 22u 25V X5R; C_1206_3216Metric
CP18: 56p 50V C0G; C_0603_1608Metric
LP2: 10uH; L_Bourns_SRN6045TA
RP1: 249k 1%; R_0603_1608Metric
RP2: 18k 1%; R_0603_1608Metric
UP2: AP63201WU-7; TSOT-23-6

Connections:
+12V: CP15.1, CP16.1, CP17.1, CP18.1, LP2.2, RP1.1
GND: CP11.2, CP12.2, CP13.2, CP15.2, CP16.2, CP17.2, RP2.2, UP2.4
PWR_BST2: CP14.1, UP2.6
PWR_FB12: CP18.2, RP1.2, RP2.1, UP2.1
PWR_SW2: CP14.2, LP2.1, UP2.5
SYS_20V: CP11.1, CP12.1, CP13.1, UP2.2, UP2.3
