aquarat/cat-feeder/electronics/revb/power/logic-placement.kicad_pcb

## KiCad design electronics/revb/power/logic-placement.kicad_pcb (2026-11-01)

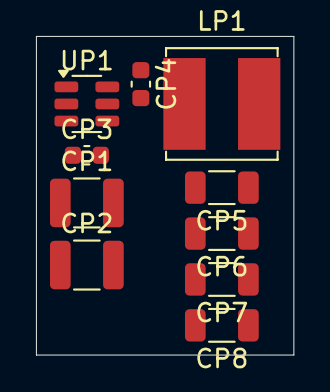
[picture p75: board logic-placement.kicad_pcb from above]

Board: 2 copper layers, 14.3 x 17.7 mm, 10 parts (0 on the bottom side), 5 nets, no tracks yet.

Parts:
CP1, CP2: 10u 50V X7R; C_1210_3225Metric
CP3, CP4: 100n 50V X7R; C_0603_1608Metric
CP5, CP6, CP7, CP8: 22u 25V X5R; C_1206_3216Metric
LP1: 6.8uH; L_Bourns_SRN6045TA
UP1: AP63203WU-7; TSOT-23-6

Connections:
+3V3: CP5.1, CP6.1, CP7.1, CP8.1, LP1.2, UP1.1
GND: CP1.2, CP2.2, CP3.2, CP5.2, CP6.2, CP7.2, CP8.2, UP1.4
PWR_BST1: CP4.1, UP1.6
PWR_SW1: CP4.2, LP1.1, UP1.5
SYS_20V: CP1.1, CP2.1, CP3.1, UP1.2, UP1.3
