aquarat/cat-feeder/electronics/revb/pd/reference/sparkfun-SparkFun_STUSB4500_USB-PD.sch

## EAGLE design electronics/revb/pd/reference/sparkfun-SparkFun_STUSB4500_USB-PD.sch (2026-11-01)

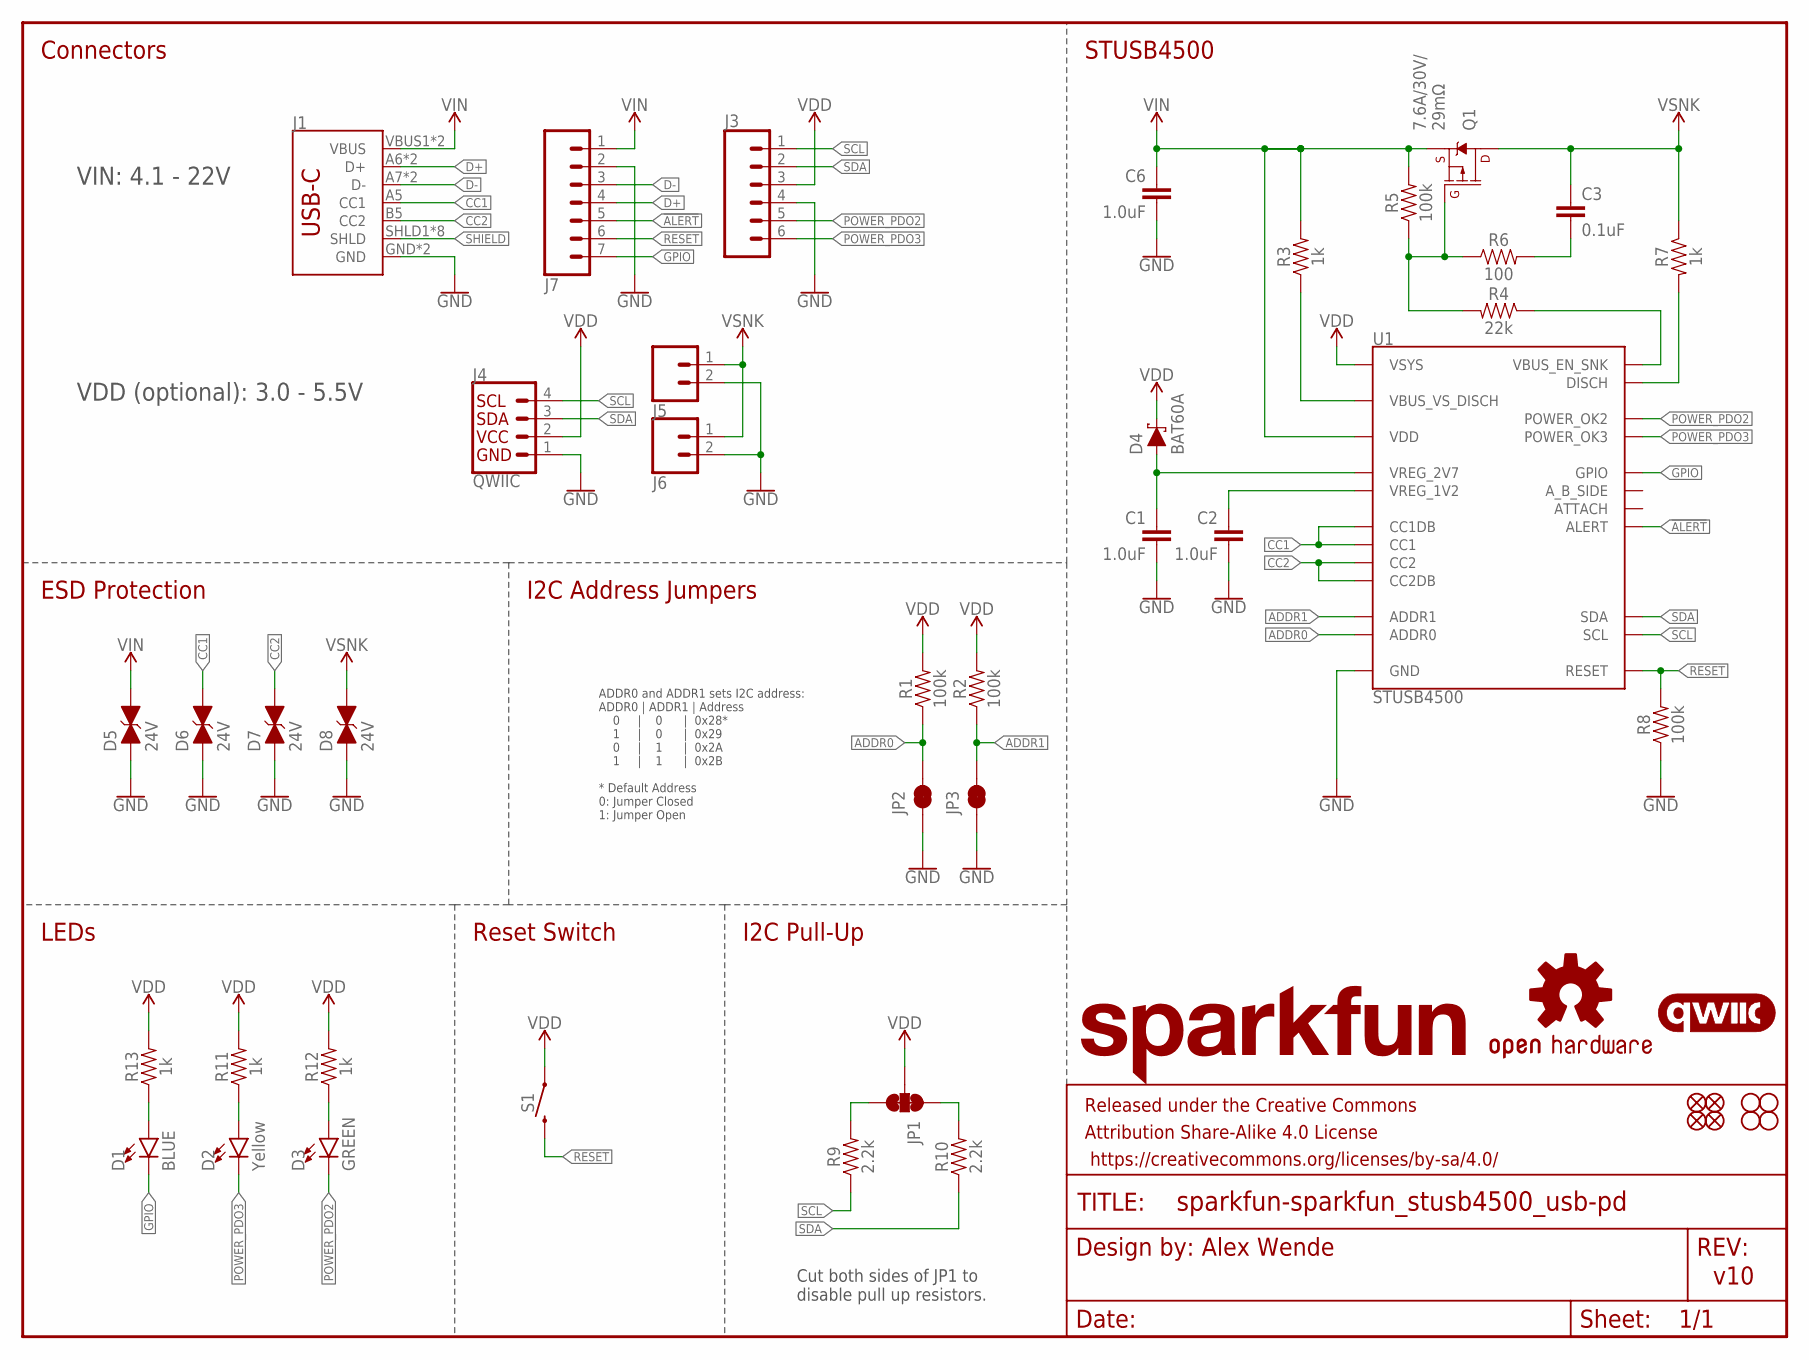
[picture p76: schematic sparkfun-SparkFun_STUSB4500_USB-PD.sch]

Parts:
C1, C2, C6: 1.0uF; 0603
C3: 0.1uF; 0603
D1: BLUE; LED-0603
D2: Yellow; LED-0603
D3: GREEN; LED-0603
D4: BAT60A; SOD-323
D5, D6, D7, D8: 24V; 0603
FD1, FD2, FD3, FD4: FIDUCIALUFIDUCIAL; FIDUCIAL-MICRO
FRAME1: FRAME-LETTER; CREATIVE_COMMONS
H1, H2, H3, H4: STAND-OFF
J1: USB_C2-LAYER; USB-C-16P
J3: CONN_06NO_SILK_NO_POP; 1X06_NO_SILK
J4: QWIIC; JST04_1MM_RA
J5: CONN_023.5MM; SCREWTERMINAL-3.5MM-2
J6: CONN_021X02_NO_SILK; 1X02_NO_SILK
J7: CONN_07NO_SILK; 1X07_NO_SILK
JP1: JUMPER-SMT_3_2-NC_TRACE_NO-SILK; SMT-JUMPER_3_2-NC_TRACE_NO-SILK
JP2, JP3: JUMPER-SMT_2_NC_TRACE_NO-SILK; SMT-JUMPER_2_NC_TRACE_NO-SILK
LOGO1: OSHW-LOGOS; OSHW-LOGO-S
LOGO2: SFE_LOGO_NAME.1_INCH; SFE_LOGO_NAME_.1
LOGO3: QWIIC_LOGO_5MM; QWIIC_5MM
Q1: 9A/30V/15mΩ; 8-POWERVDFN-3X3
R1, R2, R5, R8: 100k; 0603
R3, R7, R11, R12, R13: 1k; 0603
R4: 22k; 0603
R6: 100; 0603
R9, R10: 2.2k; 0603
S1: MOMENTARY-SWITCH-SPST-SMD-4.6X2.8MM; TACTILE_SWITCH_SMD_4.6X2.8MM
U1: STUSB4500; QFN-24

Connections:
1.2V: C2.1, U1.P$21 (VREG_1V2)
2.7V: C1.1, D4.A, U1.P$23 (VREG_2V7)
!ALERT: J7.5, U1.P$19 (ALERT)
ADDR0: JP2.2, R1.1, U1.P$12 (ADDR0)
ADDR1: JP3.2, R2.1, U1.P$13 (ADDR1)
CC1: D6.2 (C), J1.A5 (CC1), U1.P$1 (CC1DB), U1.P$2 (CC1)
CC2: D7.2 (C), J1.B5 (CC2), U1.P$4 (CC2), U1.P$5 (CC2DB)
D+: J1.A6 (D+), J7.4
D-: J1.A7 (D-), J7.3
DISCH: R7.2, U1.P$9 (DISCH)
EN_SNK: R4.1, U1.P$16 (VBUS_EN_SNK)
GND: C1.2, C2.2, C6.2, D5.1 (A), D6.1 (A), D7.1 (A), D8.1 (A), J1.GND, J3.4, J4.1, J5.2, J6.2, J7.2, JP2.1, JP3.1, R8.1, U1.P$10 (GND)
GPIO: D1.C, J7.7, U1.P$15 (GPIO)
unnamed: D2.A, R11.1
unnamed: D3.A, R12.1
unnamed: JP1.3, R9.2
unnamed: JP1.1, R10.2
unnamed: Q1.4 (G), R4.2, R5.1, R6.1
unnamed: C3.2, R6.2
unnamed: D1.A, R13.1
POWER_PDO2: D3.C, J3.5, U1.P$20 (POWER_OK2)
POWER_PDO3: D2.C, J3.6, U1.P$14 (POWER_OK3)
RESET: J7.6, R8.2, S1.3 (2), U1.P$6 (RESET)
SCL: J3.1, J4.4, R9.1, U1.P$7 (SCL)
SDA: J3.2, J4.3, R10.1, U1.P$8 (SDA)
SHIELD: J1.SHLD1 (SHLD)
VBUS_VS_DISCH: R3.1, U1.P$18 (VBUS_VS_DISCH)
VDD: D4.C, J3.3, J4.2, JP1.2, R1.2, R2.2, R11.2, R12.2, R13.2, S1.1, U1.P$22 (VSYS)
VIN: C6.1, D5.2 (C), J1.VBUS1 (VBUS), J7.1, Q1.1 (S), R3.2, R5.2, U1.P$24 (VDD)
VSNK: C3.1, D8.2 (C), J5.1, J6.1, Q1.5@1 (D), R7.1

Notes on the sheet:
ADDR0 and ADDR1 sets I2C address: ADDR0 | ADDR1 | Address 0 | 0 | 0x28* 1 | 0 | 0x29 0 | 1 | 0x2A 1 | 1 | 0x2B * Default Address 0: Jumper Closed 1: Jumper Open
Alex Wende
v10
STUSB4500
Connectors
I2C Pull-Up
LEDs
Reset Switch
I2C Address Jumpers
VIN: 4.1 - 22V
7.6A/30V/ 29mΩ
ESD Protection
VDD (optional): 3.0 - 5.5V
Cut both sides of JP1 to disable pull up resistors.
